jrkwon/mrider/docs/design/dbw.md

# MRider Drive-By-Wire (DBW) Design

This is the core drive-by-wire design document for MRider. It specifies how a stock kids' ride-on car (MITT) is converted into a computer-steerable, computer-throttled platform.

**Architecture note (2026-08-07).** This document formerly specified a Pixhawk 6C + PX4 + Arduino Nano topology inherited from `jrkwon/mrover`. That topology was superseded by **decision D3** in [adr-dbw-architecture-review.md §4.6](adr-dbw-architecture-review.md#46-decision-adopted-2026-08-07): a **single Teensy 4.1 running micro-ROS** replaces both the flight controller and the Nano. The reasoning, including what the Pixhawk path had going for it, is preserved in that review. What follows is the adopted specification.

MRider still reuses mrover at the layers where mrover is strong — the chassis conversion method, the connector-tap approach, the motor-driver power stage, and the entire autonomy stack above the vehicle interface. It departs at the controller.

Sibling documents: [architecture.md](architecture.md) (system block diagram, command/feedback flow), [vehicle.md](vehicle.md) (chassis selection), [safety.md](safety.md) (failsafe matrix, authority arbitration, FMEA), [sensors.md](sensors.md), [calibration.md](calibration.md) (zeroing, counts→degrees, ticks→distance), [software.md](software.md) (ROS 2 stack), [bom.md](bom.md).

Read for two audiences: exact numbers and file citations for researchers; short "why" explanations for students. Every design choice is recorded as an ADR with **Decision / Alternatives considered / Rationale / Consequences**.

---

## 1. Scope and reuse baseline

| Layer | mrover (baseline) | MRider | Status |
|---|---|---|---|
| Controller hardware | Pixhawk 6C (PX4) + Arduino Nano | **Teensy 4.1**, single MCU | **REPLACED** (D3) |
| Command transport | laptop → Micro-XRCE-DDS → PX4; MAVLink `MANUAL_CONTROL` emitted laptop-side (`mavlink_bridge.py:79-82`, `:105-126`) | laptop → **micro-ROS over USB serial** → Teensy | **REPLACED** (D3) |
| Steering channel | `MANUAL_CONTROL.roll` → PX4 servo out (`mavlink_bridge.py:123`) | `DbwCommand.steering_angle`, **radians**, read directly by the loop | **REPLACED** |
| Throttle channel | `MANUAL_CONTROL.throttle` (`mavlink_bridge.py:124`) | `DbwCommand.speed` | **REPLACED** |
| Motor driver | Sabertooth 2x32, S1←PX4 PWM pin2, S2←PX4 PWM pin7 (`vehicle_setup.md:54-55`) | **Cytron MDDS30**, **independent R/C**, both lines from the Teensy via the RC signal MUX on `RC1`/`RC2` | **ADAPTED** (§4, part changed in §4.1) |
| Steering angle sensing | incremental quadrature encoder (`code.ino:36-39`) + relative auto-ranging (`mavlink_bridge.py:243-252`) | **absolute sensor, load-side** + motor incremental encoder | **REPLACED** (ADR B) |
| Steering position loop | **none — open-loop effort, human closes the loop by eye** (verified: `joystick_control.py:70,75,100-109`; no PID in repo) | **Teensy-local closed loop ≥ 200 Hz** | **NEW** (ADR E) |
| Drive distance | encoder on drive shaft (`code.ino:27`), shaft-adapter method (`vehicle_setup.md:70-72`) | same method, wheel-diameter cal | **REUSED** (ADR C) |
| Feedback path | Nano → I²C `0x02` → PX4 module → `WHEEL_DISTANCE` → `Control.msg` | Teensy → **micro-ROS typed `DbwStatus`** | **REPLACED** |
| Chassis conversion, 3-tap harness | connector taps (`vehicle_setup.md:5-23`) | same | **REUSED** (§11) |
| Autonomy stack | `robot_localization`, slam_toolbox, Nav2, `data_collection`, `neural_net` | same | **REUSED** — sits above the vehicle interface, transport-agnostic |

The **NEW** row is the one genuinely new control problem. mrover has no steering position control of any kind; the human closes the loop by eye, which is adequate for teleoperation and inadequate for Nav2, which commands an *angle*.

---

## 2. Steering actuation design

### 2.1 Actuator

The stock steering column is mechanically linked to the front wheels but has **no servo** — it is turned by hand (or, on RC models, by a stock DC gearmotor driven by the parent remote). MRider drives the column with a **DC gearmotor**, coupled to the existing steering linkage, and driven by the **motor driver's channel 1 (M1 output)**.

> [!NOTE]
> **Resolved on the delivered vehicle, 2026-10-01: it is the second case — a stock gearmotor is fitted.**
>
> All three vehicles steer under the parent remote, so the column already carries a DC gearmotor
> driven by the factory ECU. [§11.5](#115-3-tap-connector-spec-minimally-invasive) adds a
> gearmotor only *"if the column had none"*, so the steering tap **reuses the stock motor**:
> NC → stock ECU, NO → driver M1. Nothing is added to the linkage, and no second actuator can
> fight the first.
>
> **The torque margin is already demonstrated and needs no measurement.** The vehicle is rated
> for a 25 kg occupant and steers with that load aboard; MRider adds ~6 kg, and adds it further
> forward only in part, so the demonstrated margin is several times the ≥ 2× gate. The
> [§2.2 procedure](#22-torque-measurement-procedure-before-sizing-the-gearmotor) is how you size
> a motor you are *buying*, and is retained for a chassis that arrives without one.
>
> **The residual risk is duty cycle, not torque.** A child steers in occasional slow sweeps; the
> position loop makes the small, continuous, high-frequency corrections
> [ADR B](#5-adr-b-steering-angle-encoding) describes, which the stock motor was never specified
> for. The failure mode is thermal and wear, so **the gate is a thermal test, and it cannot be run
> on a bench**: steering load here is mostly tyre scrub, which exists only with the wheels on the
> ground. **[Stage 5](safety.md#6-bring-up-protocol-staged-wheels-off-first) is the gate**, not
> Stage 1 — see [§2.2.1](#221-the-duty-cycle-test-this-is-what-actually-releases-bom-4) for the
> procedure and its pass criteria. BOM #4 stays funded until it passes.
>
> **A stock parent-remote gearmotor has no shaft encoder**, so reuse drops the incremental
> encoder [ADR B](#5-adr-b-steering-angle-encoding) specifies as auxiliary. That costs FMEA
> row 1's motor-encoder cross-check outright, and moves stall detection onto the absolute
> sensor — a trade [§2.4](#24-wiper-motor-fallback) already pre-registers for the wiper fallback.
> **ADR B and the FMEA are updated when V1 decides**, not now: buying #4 keeps them as written.

> [!NOTE]
> **M1/M2 assignment — intentional departure (resolves finding F6)**
>
> mrover assigns **M1 = throttle, M2 = steering** (`vehicle_setup.md:51-52`). MRider inverts this: **M1 = steering, M2 = throttle**, consistently across this document, [architecture.md](architecture.md), and §11.3. The swap is deliberate — steering is the channel with the tighter loop and it is kept on channel 1 throughout the documentation set for teachability — and it is recorded here so that anyone reusing an mrover harness or 3D-printed enclosure routing knows the wiring differs.

The gearmotor is sized from a measured column torque (§2.2) with a **≥2× margin**. If a suitable geared DC motor with the required torque and a shaft encoder cannot be sourced, the fallback is a **12 V automotive wiper motor** (high stall torque, built-in worm gearing that resists back-driving) with an external encoder or an absolute sensor on the column — see §2.4.

### 2.2 Torque-measurement procedure (before sizing the gearmotor)

Torque required to steer an unmodified column is unknown and vehicle-specific (tire scrub, caster, king-pin friction). Measure it, do not guess:

> [!NOTE]
> **Not required on the 2026 vehicle — it arrived with a stock steering gearmotor**
>
> This procedure sizes a gearmotor you are **buying**. The delivered chassis already steers under
> its parent remote at its rated 25 kg occupant load, against ~6 kg of added kit, so the ≥ 2×
> margin in step 5 is demonstrated rather than measured ([§2.1](#21-actuator), and the
> [Order Log](../order-log.md) V1 entry). The procedure stays here because the next cohort may
> receive a chassis with no steering motor at all.

1. Put the vehicle on the ground at full load (laptop + LiDAR + payload) so tire scrub torque is realistic. Repeat on the target operating surface (carpet/asphalt).
2. Attach a **spring scale** (fish/luggage scale, 0–20 kg) to the steering-wheel rim (or to the tie-rod arm if driving the linkage directly).
3. Pull tangentially and record the **peak force `F` (N)** needed to turn the wheels from center to full lock **while stationary** (worst case — moving eases it).
4. Compute stall torque at the column: `τ_column = F × r`, where `r` is the lever radius (wheel rim radius, or the effective linkage arm).
5. **Size the gearmotor for ≥ 2 × τ_column** at its rated (not stall) torque, referred through the chosen gear/coupling ratio. The 2× margin covers surface variation, aging friction, and dynamic loads.
6. Record `F`, `r`, `τ_column`, chosen motor, and gear ratio in [calibration.md](calibration.md) and the [bom.md](bom.md) line item.

#### 2.2.1 The duty-cycle test — this is what actually releases BOM #4

> [!IMPORTANT]
> **On the 2026 vehicle the torque question is closed and the duty question is not.** [#4](../order-log.md)
> stays funded against one risk only: the stock motor was specified for a child's occasional slow
> sweeps, not for the small, continuous, high-frequency corrections a position loop makes. **The
> failure mode is thermal and wear, so the test is a thermal one** — a spring scale cannot answer it.

**It cannot be run at bench Stage 1, and saying so is the point.** Steering torque on this class of
vehicle is dominated by **tyre scrub**, which exists only with the wheels loaded on the ground. A
motor spinning free on a bench, or a vehicle on stands, draws a fraction of the current and will
pass a thermal test it would fail in service. **The gate therefore sits at
[Stage 5](safety.md#6-bring-up-protocol-staged-wheels-off-first)**, on the ground, at full kit load,
on the target surface.

1. Vehicle **on the ground**, full load (laptop, LiDAR, mast, payload), on the surface it will be
   driven on. Note the **ambient temperature** — every limit below is a rise above it.
2. Tape a thermocouple to the motor can, or use an IR thermometer on the same marked spot each time.
   **The same spot**: a 10 mm move on a small motor is several degrees.
3. Run the **position loop**, not a step test. Command a realistic profile — slow sweeps with
   **±5–10° corrections at 1–2 Hz superimposed** — which is what a path follower actually emits. A
   step-and-hold understates the duty; continuous small reversals are the hot case.
4. Run **20 minutes continuous**, longer than any single lab exercise. Record case temperature and
   **M1 current** at `t = 0` and every 5 minutes.
5. **Pass criterion is equilibrium, not a number.** If the temperature **plateaus** — under about
   1 °C per 5 minutes by the end — the motor can run indefinitely at this duty. **If it is still
   climbing at 20 minutes it cannot**, however comfortable the absolute reading looks.
6. **Absolute ceiling: case ≤ 70 °C.** The limiting part is the **plastic gearbox, not the
   windings** — nylon and POM gears soften and wear long before magnet wire is in trouble, and this
   gearbox is the same family as the [drive gearbox](../order-log.md) the encoder clamps to.
7. **Then measure wear, which is the half everyone forgets.** Re-take lock-to-lock travel and the
   dead band immediately after the run and compare with the pre-run figures. **Growth in backlash is
   a fail even if the temperature was fine** — it is the same defect arriving slowly.
8. Record the steady-hold current against the driver's channel rating and against the
   [logic-rail brownout check](safety.md#5-power-rail-isolation-and-brownout-protection).

**Outcome.** Plateau below ceiling and no backlash growth → **nothing to do.** If it fails, work
**down** the ladder below, not out to a new motor.

#### 2.2.2 If the duty test fails — the ladder, cheapest first

> [!IMPORTANT]
> **Replacing the motor is the last rung, not the first — and on this chassis it is barely a rung
> at all.** The stock steering gearmotor drives a **sealed gearbox** of the same family the drive
> side refused an end-mounted magnet three times. Fitting a *different* motor means opening that
> gearbox and matching a pinion to a 2 mm shaft, which is not a sixteen-week-course operation. The
> [wiper fallback](#24-wiper-motor-fallback) avoids the gearbox but costs more than it buys — see
> its withdrawal note. **So the money was never buying a usable option. The mitigations that work
> are above it, and three of the four are free.**

| | Mitigation | Cost | Why it works |
|---|---|---|---|
| **R1** | **Reduce the duty, not the motor** — dead band, rate limit, hysteresis, lower gain | **₩0, firmware** | The heat comes from the command profile, and the profile is a **choice**. A ±0.5° dead band stops the loop chattering at the setpoint and still clears [ADR E](#3-adr-e-steering-control-loop-location-the-key-dbw-decision)'s ≤ 1° gate with room to spare |
| **R2** | **I²t limit in firmware** on M1 current, clamping command authority as the integral climbs | **₩0, firmware** | Makes the thermal limit explicit and observable instead of discovering it by smell. Also the honest way to publish a duty rating for the next cohort |
| **R3** | **A spare of the STOCK motor** | small | Drops in. No gearbox work, no linkage work, no loss of reversibility — the only replacement on this chassis that is actually a replacement |
| **R4** | A small fan on the motor can | trivial | Only if R1 and R2 land close to the ceiling rather than far from it |

**R1 and R2 are not consolation prizes.** Limiting actuator duty in software is what a production
drive-by-wire system does, and on a teaching vehicle it converts a hardware disappointment into the
control-design exercise the course wants anyway. **Measure the duty, then design to it.**

> Rule of thumb from the ride-on ecosystem: a two-seater on carpet typically needs on the order of a few N·m at the column; a wiper motor (often 10–30 N·m stall) is comfortably oversized, which is why it is the safe fallback.

### 2.3 Why the motor driver receives an effort command

The driver outputs a **bidirectional motor drive** (PWM-controlled H-bridge). The Teensy does not command "go to angle X" to it; it commands a **signed effort** that is the *output* of the Teensy's position loop. Angle regulation lives entirely in the Teensy (ADR E). This keeps the driver a dumb, fast power stage — exactly its role in mrover.

*This section is deliberately board-neutral: it was true of the Sabertooth 2x32 and is true of the Cytron MDDS30 that replaced it, because what it describes is the division of labour and not the part.*

### 2.4 Wiper-motor fallback

> [!CAUTION]
> **Withdrawn for the 2026 chassis — 2026-10-20. Retained only for a vehicle with no stock steering motor.**
>
> This fallback was written for a column that had to be motorised from scratch. The delivered
> vehicle already steers under its parent remote, and on *that* chassis the fallback costs more
> than it buys:
>
> - **It cannot go through the stock gearbox**, so it must drive the linkage — which means
>   **disconnecting the stock gearmotor first.** That breaks [§2.1](#21-actuator)'s rule that
>   *"nothing is added to the linkage and no second actuator can fight the first"*, and it breaks
>   [§2.8 reversibility](../build/02-mechanical.md#28-confirm-reversibility).
> - **The worm drive is non-back-drivable**, as consequence (a) below already says. On a vehicle
>   whose entire failsafe story is *"default = STOCK"*, an actuator that **locks the steering on
>   power loss** is not a fallback — it is a new failure mode. You could not even push the vehicle
>   off the road.
>
> **So it is not the answer to a failed duty test.** [§2.2.2](#222-if-the-duty-test-fails-the-ladder-cheapest-first)
> is. Leaving this section listed as a live option was the more dangerous state: a documented
> escape route that cannot be taken is worse than none, because it stops anyone looking for a real
> one.

If the encoder-gearmotor path is blocked at build time, substitute a wiper motor on driver M1. Consequences: (a) the wiper's internal worm gear is largely non-back-drivable, so on power loss the steering **holds** rather than freewheels — this changes the E-stop analysis and **must** be re-evaluated against [safety.md](safety.md); (b) wiper motors rarely have a usable shaft encoder, so the **absolute sensor becomes the sole angle source** and the motor-side incremental encoder (for stall/velocity) is lost — acceptable because ADR B already makes the absolute sensor authoritative.

---

## 3. ADR E — Steering control-loop location (the key DBW decision)

**Decision.** Close the steering **position loop on the Teensy 4.1**, locally, at **≥ 200 Hz**, against the absolute angle sensor. The setpoint arrives as a **typed ROS 2 message** (`DbwCommand.steering_angle`, radians) that the loop reads directly.

**Pinned datapath (exactly one, no alternates):**

```
laptop  /mitt/dbw/command  (DbwCommand, steering_angle in rad)
              │
              │  micro-ROS over USB serial  (micro_ros_agent on the laptop)
              ▼
      Teensy 4.1  ── reads setpoint from the subscription callback
              │  ── closes position loop ≥200 Hz vs. absolute angle sensor
              │  ── outputs signed effort
              ▼
      Motor driver     ── independent R/C (PWM) via the signal MUX, M1 → steering gearmotor
```

**What this deletes.** The previous design carried the setpoint through PX4 as a servo-PWM pulse that a second MCU had to capture and decode. That entire round trip — `roll` → servo PWM → PWM input capture → degrees — existed *only* because the setpoint had to cross from PX4 to another board. With one controller the setpoint is a message the loop reads. The PWM input-capture firmware block, the ASCII framing, and the I²C register map all disappear with it.

**Setpoint rate vs. loop rate.** Setpoint refresh (≥ 50 Hz from the laptop) and the control loop (≥ 200 Hz on the Teensy) are decoupled: each iteration uses the most recent setpoint and the current measured angle. A 600 MHz Cortex-M7 with an FPU makes the loop rate a non-constraint; 200 Hz is chosen for margin, not because it is hard.

**Alternatives considered.**

- **E2 — close the loop in the laptop `ros2_control` hardware interface.** The loop would cross USB each cycle, adding latency and jitter that scales with laptop load. Rejected. Note the reuse argument once made for E2 does not exist: mrover's `carlikebot_system.cpp` is the **unmodified upstream demo stub** — namespace `ros2_control_demo_example_11` (`:27`), `read()` echoes the command back as state (`:280`), `write()` only logs (`:304`), both bracketed by the upstream "do not copy to your production code" comment. There is no hardware I/O in it. **Fallback acceptance bound:** if E1 is ever abandoned at build time, E2 is acceptable **only if** measured setpoint→actuation latency is **≤ 30 ms at p95 over ≥ 60 s of logged operation**.
- **E3 — close the loop inside PX4** (custom PX4 module). Moot under D3; retained in the record as rejected — PX4 C++ module work, hardest to teach, couples the controller to PX4 release churn.
- **E4 — dedicated closed-loop motion-controller hardware** (Kangaroo x2 class). **Pre-registered fallback**, not primary: it adds a part and replaces the project's best teaching artifact with a self-tuning black box. See [adr §3.5](adr-dbw-architecture-review.md#35-new-option-e4-dedicated-closed-loop-motion-controller) for the full trade and the verification checklist.

> [!NOTE]
> **E4 trigger (pre-registered)**
>
> **If, at the end of [bring-up Stage 1](safety.md#6-bring-up-protocol-staged-wheels-off-first), the Teensy loop cannot hold ≤ 1° steady-state error with no sustained oscillation, adopt E4 rather than continuing to tune.** Firmware tuning is unbounded work; this bounds it.

**Rationale.** The one genuinely new control problem is placed in the layer that solves it best: a dedicated MCU with direct, deterministic access to the sensor and the motor driver. It also doubles as the honest core of the education tier ("here is a position controller you can read in 100 lines of C") — and since mrover has no position loop at all (finding F2), there is no prior implementation for students to read instead.

**Consequences.** All actuation and vehicle sensing now terminate on one MCU. That concentrates authority, which is the serious objection to D3 — answered in §11 by making the override a wiring property rather than firmware. Firmware scope is real (PID, limits, watchdog, RC decode, encoder read, micro-ROS) but smaller than it looks: the superseded design was already committed to most of it on a far less capable board.

---

## 4. ADR (motor-driver control mode) — independent R/C, Teensy as both masters

**Decision.** Configure the motor driver in **independent R/C mode**. The Teensy emits servo-style pulses on two lines; both pass through the [hardware RC signal MUX](#112-hardware-rc-signal-mux-the-d3-condition) before reaching the driver.

| Driver input | Normal source | Override source | Motor output | Function |
|---|---|---|---|---|
| `RC1` | Teensy servo pulse (via MUX) | RC receiver (via MUX) | Left | steering gearmotor |
| `RC2` | Teensy servo pulse (via MUX) | RC receiver (via MUX) | Right | drive motors (paralleled) |

*Terminal and output names are the **MDDS30's**. `S1`/`S2` and `M1`/`M2` are Sabertooth naming and the board fitted is not labelled that way — see [§4.1](#41-part-substitution-cytron-mdds30-replaces-the-sabertooth-2x32-2026-09-29). Which output is which matters: `SW3:SW4` can silently redefine both.*

> [!CAUTION]
> **This ADR was briefly decided the other way. The reversal is the instructive part.**
>
> D3 removes the two-master constraint that originally ruled out **packetized serial** (Nano owned steering, PX4 owned throttle, and two masters cannot share an addressed bus). With one controller that objection dissolves, so packetized serial was adopted — it gives exact, high-rate commands and closes the actuation-rate problem in §12.
>
> **It was reverted when the override hardware was specified.** Every available RC signal multiplexer — [Pololu 2806](https://www.pololu.com/product/2806), Acroname RxMux, ServoCity — multiplexes **servo pulses**. None can select between a *serial packet stream* and RC PWM, and the driver's input mode is fixed by DIP switches, so it is in one mode or the other.
>
> **Packetized serial and the hardware RC MUX are mutually exclusive.** The MUX is the condition on which D3 was adopted ([§11.2](#112-hardware-rc-signal-mux-the-d3-condition)); packetized serial is an optimisation. The safety layer wins.
>
> The general lesson: **a decision that is correct in isolation can be invalidated by a downstream part choice.** Specify the safety-critical hardware early enough that it can constrain the decisions above it.

**Alternatives considered.**

- **Packetized serial, single master.** Rejected — incompatible with the RC signal MUX, as above. Would be the right answer if override were achieved some other way.
- **Keep packetized serial, move override to the relay MUX** (a separate RC ESC path selected by the existing contactor). Rejected: adds a second power stage, and the override would then drive the motors through *different hardware* than normal operation — a larger behavioural difference than effort-vs-angle, and one that is harder to test.
- **Analog mode** (0–5 V). Rejected: coarser, noise-prone, no timeout behaviour.

**Consequences.**

- **The driver's R/C signal-loss timeout is available in this mode** — motors stop when pulses stop. This backs [failsafe matrix row 6](safety.md#2-failsafe-matrix) and is one of the layers independent of Teensy firmware. Under packetized serial it would have been a configured behaviour requiring verification. **In this mode it is a DIP switch, not a property of the mode**, and the caution that used to sit here — "some boards gate the stop behind a switch that can also disable it" — turned out to describe the board fitted: on the MDDS30 `SW6=0` stops the motor after **100 ms** of lost signal and **`SW6=1` disables the timeout entirely**, leaving the motor at its last commanded speed. Set it, confirm it board by board, and verify the behaviour at Stage 1. [§4.1](#41-part-substitution-cytron-mdds30-replaces-the-sabertooth-2x32-2026-09-29)
- Two Teensy PWM outputs are consumed instead of one serial port. The Teensy has 35 PWM-capable pins, so this is free.
- Signal grounds between Teensy, RC receiver, signal MUX, and the motor driver must be star-tied at the motor driver ([architecture.md](architecture.md) power tree).
- **The actuation frame-rate ceiling returns as an open question** — see §12 and the warning below. This is the real cost of the reversal, and it is *not* resolved by assertion.

> [!WARNING]
> **Open: pin the actuation frame rate at bring-up**
>
> A standard servo frame is ~20 ms (**~50 Hz**), and with the stock Arduino `Servo` library that is what the driver would receive — so *actuation bandwidth*, not loop rate, would set the closed-loop ceiling. **No maximum accepted R/C input rate is recorded for the MDDS30 in this repository**, and the manual read on 2026-11-05 ([order log #3](../order-log.md#L3)) did not come back with one. The question is unchanged by the part swap; only the datasheet to re-read is different.
>
> **Measure it at [Stage 1](safety.md#6-bring-up-protocol-staged-wheels-off-first)** and pin one of:
>
> 1. Emit pulses faster than 50 Hz and verify the driver tracks them — best outcome; record the highest rate that works.
> 2. Accept ~50 Hz actuation and **restate the ≥200 Hz figure in §12 as a sampling/estimation rate, not an actuation rate.** Honest, and probably adequate at ≤ walking speed against a ≤1° / 400 ms target.
>
> Do not leave it unstated — that omission is exactly what capped the superseded design's performance invisibly.

### 4.1 Part substitution — Cytron MDDS30 replaces the Sabertooth 2x32 (2026-09-29)

**Status:** Accepted. **The decision in §4 is unchanged** — independent R/C mode, Teensy as both masters, both lines through the signal MUX. Only the part changed. §4's reasoning is preserved intact because none of it turned on the brand.

**Context.** The Sabertooth 2x32 was specified from a listing, and the sourcing never closed: [`scripts/order_status.py`](https://github.com/jrkwon/mrider/blob/main/scripts/order_status.py) exists because that listing carried a **2x25 SKU on a 2x32 description**, so arrival could not be taken for acquisition. A **Cytron SmartDriveDuo-30 (MDDS30)** was ordered instead on **2026-09-29**, four units (three fitted, one spare), and confirmed genuine on receipt **2026-10-08** — [order log #3](../order-log.md#L3). Its manual (rev 1.11) was read in full on **2026-11-05**.

**What the swap is allowed to change, and what it is not.** The Sabertooth 2x32 was **never fitted to any vehicle**. So wherever a number in these documents came from its datasheet, it describes hardware that does not exist in this project, and the MDDS30's number replaces it rather than disagreeing with it.

| | Sabertooth 2x32 *(never fitted)* | **Cytron MDDS30** *(fitted)* |
|---|---|---|
| Per-channel rating | 32 A continuous | **30 A continuous, 80 A peak**, thermally derated: 80 A below 50 °C, 50 A to 70 °C, 40 A to 100 °C, **30 A above** |
| User-settable current limit | assumed, and the fuse table rested on it | **none.** The manual lists *"current limit protection"* as a feature **with no number** |
| R/C input terminals | `S1` / `S2` | **`RC1` / `RC2`** |
| Motor outputs | `M1` / `M2` | **Left / Right** — Left is the steering gearmotor, Right the traction pair |
| Signal-loss stop | believed inherent to R/C mode | **`SW6`**: `0` stops after 100 ms, `1` **disables it** |
| Max accepted R/C rate | not stated | not recorded here either — §4's open question stands |

**Consequences.**

| | Direction |
|---|---|
| **Every 32 A acceptance figure was for the wrong board, and permissive by 2 A.** The real continuous limit is lower. Gates and record sheets now read **30 A continuous / 80 A peak**. | ✗ a real tightening |
| **The no-fuse argument on the motor branches collapses.** [03-electrical §3.2](../build/03-electrical.md#32-per-rail-fuse-and-gauge-table) justified no fuse there on *"the driver's current limit, set to 20 A"* — a setting this board does not have, on branches that are AWG 14. **Open**, and tracked in that section. | ✗ unresolved safety item |
| **All-switches-off is not a safe default.** `SW3:SW4=00` is **MIXED**, which makes a throttle command drive the steering motor and a steering command drive the wheels. The boards ship with every switch off. | ✗ a new assembly hazard |
| **Power-on order now matters.** With `SW6=0` the centre point is calibrated at power-up and the manual requires the transmitter on first, so whatever pulse sits on `RC1`/`RC2` at power-up becomes "stop": receiver on, Teensy emitting 1.5 ms, MUX settled, **then** the driver. Power it first and neutral can come out as a creep. | ✗ a new procedure |
| The 100 ms timeout is now a **known number** backing failsafe row 6, instead of an inherited belief. | ✓ |
| `SW3:SW4=11` independent is the manual's own recommendation *"if controlled using Microcontroller"*, so the §4 decision is confirmed by the new part rather than merely compatible with it. | ✓ |
| The board is **cheaper and locally stocked** (₩143,440 incl. VAT, 디바이스마트), which is what let four be bought — three fitted, one spare, for thirteen students. | ✓ |

**Closed on 2026-11-09.** `SW7:SW8` is the battery monitor and `00` is LiPo, which nothing on this vehicle is. The traction pack is an **`Aroma 6-FM-4.5`, 12 V 4.5 Ah valve-regulated sealed lead-acid**, so **`10`** — full plate at [vehicle.md §3.1.1](vehicle.md#311-the-traction-pack-from-its-own-label).

*This section said the chemistry was recorded nowhere. It was wrong when written: [03-electrical §3.5](../build/03-electrical.md#35-signal-wiring)'s switch table had carried the label since 2026-11-05, and the sentence was copied out of a stale paragraph four rows below that table. A claim that something is unrecorded is still a claim, and this one was not checked against the thing it was about.*

**And setting it is not a protection.** The manual is explicit that on under-voltage the error LED blinks and *"the power to the motor will be maintained and will not be cut out."* The monitor **warns; it does not cut.** Nothing in the failsafe matrix may rest on it.

---

## 5. ADR B — Steering angle encoding

**Decision.** **Absolute angle sensor on the steering axis**, read by the Teensy, **plus** the steering motor's incremental encoder for velocity and stall detection. The absolute sensor is authoritative for angle; the incremental encoder is auxiliary.

**Mount it load-side.** Where the sensor mounts matters as much as which sensor it is. Mount it **downstream of the steering gearbox** — on the kingpin/road-wheel axis, or on the linkage — not on the motor shaft. Load-side mounting measures what the road wheels actually do, so **gearbox backlash and coupling slip appear as measured error rather than as invisible bias**. Motor-side mounting hides exactly the errors the sensor exists to catch.

Steering angle sensing: an AS5600 absolute magnetic encoder on the kingpin axis, reading a diametrically-magnetised magnet across a controlled air gap, with the motor-side incremental encoder demoted to velocity and stall duty

Panel 2 is the part that is easy to get wrong in the shop. The magnet is **bonded to the rotating kingpin**; the sensor IC is on a small PCB held by a bracket **fixed to the chassis**, facing the magnet across an air gap the datasheet constrains. Nothing touches — this is why there is no wiper to wear at the small, high-duty-cycle oscillations a steering loop makes. The mechanical precision that mounting demands is the *only* reason the potentiometer fallback is retained rather than deleted.

**Alternatives considered.**

- **B2 — incremental encoder on the steering motor only** (the mrover recipe). Rejected. It **requires homing on every boot** and loses its absolute reference on any linkage slip or power glitch. mrover's own implementation shows the failure mode concretely: `mavlink_bridge.py:47-50` initializes asymmetric defaults (`min_value=-600`, `max_value=180`), and `:243-250` **expands those bounds at runtime and rescales all past values** — so the reported "center" depends on the range observed so far, and boot centre is arbitrary. This is worse than drift: the mapping changes retroactively.

**Rationale.** Mapping and Nav2 need a repeatable, boot-stable angle. An absolute sensor gives angle-at-power-on with no homing dance and survives linkage slip. Keeping the motor incremental encoder as well costs nothing (the Teensy has four hardware quadrature decoders) and gives free stall/velocity signals.

**Consequences.** Two angle sensors on one axis; fusion is trivial (absolute = truth, incremental = rate). The absolute sensor's mounting and range must match the mechanical travel of the shaft it is on — its own ADR (§6). Calibration gains a "counts→degrees" step ([calibration.md](calibration.md)).

---

## 6. ADR (angle-sensor technology) — magnetic encoder vs. potentiometer

**Decision.** Use an **AS5600-class absolute magnetic rotary encoder** (I²C, 12-bit, contactless), mounted on a shaft whose **total travel stays within one turn** — which, given the load-side mounting of ADR B, is the road-wheel/kingpin axis at **±22.5°**. **Fall back to a single-turn conductive-plastic potentiometer** if no shaft with ≤ 340° of travel is mechanically accessible for a magnet mount.

> [!CAUTION]
> **Bench gate — measure before ordering**
>
> **Measure the actual lock-to-lock travel of every candidate mounting shaft on the delivered vehicle before committing.** The magnetic encoder is single-turn (0–360° absolute): if the shaft it is on rotates past one turn, it wraps and silently loses absolute meaning — the exact failure class ADR B exists to eliminate. Record the measured travel in [calibration.md](calibration.md). Budget for either part; they are within a few dollars of each other.

**Alternatives considered.**

- **Single-turn potentiometer coupled to the steering column.** This was the previous decision, and it remains the fallback. Its virtue is that it maps monotonically across whatever travel its shaft sees, within one mechanical turn, and it is trivially teachable (voltage ∝ angle). Its drawbacks are wiper wear, analog noise requiring median + low-pass filtering, and a ratiometric-reference dependency so supply drift cancels.
- **Multi-turn magnetic / hall-array absolute encoder.** Solves wrap outright but is markedly more expensive and less student-friendly. Reserved for a future chassis that gears the column past one turn.

**Rationale for flipping the default.** The previous ADR pinned the pot because it feared column wrap — a real hazard when the sensor sits on a geared-down *column*. ADR B moves the sensor **load-side**, where travel is ±22.5° and wrap cannot occur. Once the mounting point is settled, the wrap objection no longer applies and the magnetic encoder's advantages are uncontested: contactless (no wiper to wear at the small, high-duty-cycle oscillations a steering servo makes), digital (no ADC noise, no ratiometric reference, no analog filtering), and 12-bit — roughly 0.09° resolution over a full turn.

**Consequences.** One Teensy I²C bus is consumed. A diametrically-magnetized magnet must be mounted concentric to the sensed shaft, with the air gap held within the sensor's specified range — a mechanical precision requirement the pot does not impose, and the main reason the pot fallback is retained rather than deleted. Check for magnetic interference from the nearby steering motor during bench validation.

---

## 7. Throttle path

The stock vehicle has **two rear drive motors**, electrically **paralleled onto the motor driver's channel 2 (M2 output)**. Throttle command originates as `DbwCommand.speed` and is emitted by the Teensy as a servo pulse on `RC2`, through the same signal MUX as steering.

The Teensy applies **ramp limiting, a speed cap, and a direction interlock** (no reversal above a threshold speed) before commanding the driver. These were previously PX4's responsibility and are now explicit project firmware — see [safety.md](safety.md).

Paralleling is acceptable because the two motors are mechanically coupled through the ground and share a load; the consequence for **odometry** (only one shaft is instrumented) is handled in ADR C. Verify the **paralleled stall current against the driver's 30 A continuous rating** in [vehicle.md](vehicle.md). If the pair can exceed it stalled, the remedy is **not** a driver setting — the MDDS30 has no user-settable current limit ([§4.1](#41-part-substitution-cytron-mdds30-replaces-the-sabertooth-2x32-2026-09-29)) — so it is lower-draw motors, a fuse on the branch, or a firmware duty ceiling that the stock remote does not share.

---

## 8. ADR C — Drive distance encoding

**Decision.** A **quadrature/Hall incremental encoder on the drive-motor shaft** (the mrover **3.15 mm → 5 mm shaft-adapter** method, `vehicle_setup.md:70-72`), read by a Teensy **hardware quadrature decoder**, converted to distance with a wheel-diameter calibration ([calibration.md](calibration.md)). Odometry is **fused with the IMU in the EKF** to bound error.

Rear drive sensing: both rear motors paralleled onto one motor-driver channel with a single quadrature encoder on one motor shaft, and the chain of mechanical error sources that sit between that measurement and actual ground distance

Panel 1 is the asymmetry worth staring at: **one motor is instrumented and the other is not**, and because both are paralleled onto a single channel there is no differential and no independent control. Panel 3 is the honest consequence — the measurement is taken *upstream* of backlash, slip and the speed difference between inner and outer wheels in a turn. Each of those biases raw odometry, which is precisely why it is fused rather than trusted.

> [!NOTE]
> **PPR is unverified — resolves finding F7**
>
> mrover's firmware pins **52 PPR** (`code.ino:27`) while its own BOM lists a **16 PPR** encoder motor (`Note/overview.md` BOM row 2). The conflict is inside the source project, so the number cannot be inherited safely. **Verify PPR on the encoder actually fitted** and record it in [calibration.md](calibration.md). The [roll-out calibration](calibration.md#2-drive-distance-encoder-ticksmeters) is authoritative and bypasses PPR entirely, so the *result* is safe either way — but do not treat 52 as a fact.

**Alternatives considered.**

- **C2 — magnetic ring / hall array on the wheel hub** (true wheel odometry, immune to gearbox backlash and drivetrain slip). Rejected as the default: a **more invasive, per-vehicle mechanical mount** on the hub, against the "minimally invasive" principle. Kept as the upgrade path if odometry proves inadequate against the §12 acceptance bound.

**Rationale.** Instrumenting the motor shaft reuses mrover's proven encoder + adapter method and mounts inside the drivetrain rather than on the wheel. Minimally invasive and cheap.

> [!IMPORTANT]
> **Outcome, 2026-09-30 — C1 is infeasible on the delivered vehicle. C2 is adopted.**
>
> Teardown found a **`DING LI RS 390-12V RPM 18000`** driving a sealed gearbox. The RS-390 carries a
> ~2 mm shaft with a 12-tooth pinion pressed onto it, meshing straight into the gearbox: **no rear
> stub, and no bare output shaft.** That is the family's construction, not this vehicle's packaging
> — opening the gearbox would not produce one.
>
> So **the decision above cannot be executed.** The mrover shaft-adapter method it reuses has no
> shaft to adapt.
>
> **C2's rejection does not survive the loss of C1.** It was rejected for being *"a more invasive,
> per-vehicle mechanical mount"* — a comparison against clamping onto an exposed motor shaft. With
> that shaft gone, the real comparison is C2 against **splitting a gearbox on three vehicles that
> students will maintain for a semester**. C2 is plainly the less invasive of the two. The premise
> failed, not the reasoning.
>
> **And C2 was always the better measurement.** This ADR says so itself — *"true wheel odometry,
> immune to gearbox backlash and drivetrain slip."* C1 was preferred for convenience, never
> accuracy, and the convenience is what disappeared.
>
> **Mount: the gearbox output hub**, not the wheel rim. The gearbox drives a splined plastic hub
> that the wheel slides onto, with the rear axle passing through its bore, and there is clearance at
> the hub with the wheel fitted. That gives a target turning **1:1 with the wheel**, in plastic that
> accepts magnets, beside a fixed housing with screw bosses for the sensor bracket — and pulling a
> wheel does not disturb the sensor.
>
> The consequences below change accordingly: **(a) gearbox backlash no longer applies**, because the
> measurement is taken downstream of the gearbox. (b) wheel slip and (c) differential wheel speed in
> turns still do, because one wheel is still the only one observed. Odometry is still fused rather
> than trusted.
>
> Full purchasing specification and the decision tree this outcome came from:
> [§1.2.3](../build/01-bom-sourcing.md#6-drive-encoder-what-to-actually-buy).

**Consequences (stated explicitly).** The two rear motors are paralleled on one channel and **only one motor shaft is observed**. Motor-side measurement therefore inherits (a) **gearbox backlash** between encoder and wheel, (b) **wheel slip** and tire deformation, and (c) **differential wheel speed** in turns (only one side measured). These bias raw odometry; `robot_localization` fuses the encoder with the IMU (and GNSS when present) to bound drift. Documented so students understand *why* the odometry is fused rather than trusted raw.

---

## 9. Teensy 4.1 firmware platform and version pinning

- **Controller:** Teensy 4.1 (600 MHz Cortex-M7, FPU, 1024 K RAM). Peripheral budget against MRider's needs: **4 hardware quadrature decoders** (2 used: steering motor, drive shaft), **8 hardware serial ports** (used: RC serial in, debug), **35 PWM-capable pins** (2 used for the motor driver), **18 analog inputs** (pot fallback), I²C for the AS5600. Everything fits with spare capacity.
- **Toolchain:** PlatformIO with the Teensy platform. Firmware lives in `firmware/mitt_dbw/`.
- **ROS 2 transport:** `micro_ros_arduino`, USB serial, with `micro_ros_agent` on the laptop.

> [!WARNING]
> **Verify before firmware work**
>
> - [x] **Verified 2026-08-08.** `micro_ros_arduino` **v2.0.8-humble** (published 2025-09-30) is the current Humble release, and **Teensy 4.1 is listed as Supported** (min version v1.8.5) in the upstream support table. Pin this tag.
> - [x] **Verified 2026-08-08.** The upstream README states *"Only USB serial transports are provided"*, and Known Issues notes transports still need refactoring for pluggability. An Ethernet *example* sketch exists but is not an official transport. **USB serial is accepted.**
> - [ ] **This link now carries the steering setpoint**, which the superseded design's USB link did not. Re-analyse it against [failsafe matrix row 2](safety.md#2-failsafe-matrix), and measure session stability at Stage 0.
>
> **If no Humble release exists**, the fallback is a framed **binary** protocol with CRC and sequence numbers over the same USB serial link — never unframed ASCII. This keeps every architectural gain of D3 except typed-message convenience.

- **Version pinning:** pin the exact `micro_ros_arduino` release, PlatformIO platform version, and Teensyduino version in [software.md](software.md) so results reproduce. Do not float on `main`. This obligation is heavier than it was under PX4 — see the consequence recorded in [adr §4.6](adr-dbw-architecture-review.md#46-decision-adopted-2026-08-07): the platform's replication claim now rests on MRider's own measured bring-up numbers rather than on an upstream autopilot's provenance.

---

## 10. Teensy firmware interface

### 10.1 Primary transport — micro-ROS typed messages

Two topics form the entire vehicle interface. There is no ASCII protocol to parse and no I²C register map to decode; both existed in the superseded design only to move data into ROS 2 by hand.

**`/mitt/dbw/command` — `mitt_msgs/DbwCommand` (laptop → Teensy, ≥ 50 Hz):**

| Field | Type | Notes |
|---|---|---|
| `stamp` | `builtin_interfaces/Time` | command origin time |
| `steering_angle` | `float32` | **radians**, road-wheel angle, clamped to ±22.5° (±0.3927 rad) |
| `speed` | `float32` | m/s, signed |

**`/mitt/dbw/status` — `mitt_msgs/DbwStatus` (Teensy → laptop, ≥ 50 Hz):**

| Field | Type | Notes |
|---|---|---|
| `stamp` | `builtin_interfaces/Time` | measurement time |
| `steering_angle` | `float32` | radians, measured absolute, load-side |
| `steering_setpoint` | `float32` | radians, what the loop is currently tracking |
| `wheel_speed` | `float32` | m/s from the drive encoder |
| `drive_ticks` | `int32` | cumulative, for odometry |
| `mode` | `uint8` | `ESTOP` / `MANUAL_RC` / `AUTONOMOUS` |
| `faults` | `uint16` | bitfield: encoder fault, setpoint-stale, at-limit, stall, RC-loss, over-current |

Diagnostic/config traffic (PID gains, zeroing) uses ROS 2 **parameters and services**, not a side-channel.

### 10.2 Firmware blocks

1. **micro-ROS node**: publisher, subscriber, session time synchronisation. Session sync replaces the MAVLink `TIMESYNC` offset estimation the superseded design needed — see [calibration.md](calibration.md) §6.
2. **Absolute-sensor read**: AS5600 over I²C (or ADC + median/low-pass for the pot fallback), counts→radians per [calibration.md](calibration.md).
3. **Position PID** at ≥ 200 Hz: error = setpoint − measured, output = signed effort.
4. **Motor output**: servo-style PWM on two lines into the RC signal MUX, then to the driver RC1/RC2 inputs, at the §12 frame rate.
5. **Throttle shaping**: ramp limit, speed cap, direction interlock.
6. **RC decode**: i-BUS on a hardware serial port — mode switch and closed-loop manual override.
7. **Safety supervisor**: setpoint-staleness watchdog, mechanical-limit clamp (effort toward center only), stall detection, hardware watchdog timer resetting outputs to neutral.

### 10.3 Safety state machine

```
        ┌──────────┐  E-stop released + RC arm
        │  ESTOP   │◄──────────────────────────┐
        └────┬─────┘                           │
             │                          E-stop / RC kill /
             ▼                          setpoint stale / watchdog
        ┌──────────┐  RC mode switch          │
        │MANUAL_RC │◄────────────┐            │
        └────┬─────┘             │            │
             │ RC mode switch    │            │
             ▼                   │            │
        ┌──────────┐─────────────┘            │
        │AUTONOMOUS│───────────────────────────┘
        └──────────┘
```

Invariants:

- Any transition into `ESTOP` zeroes throttle and centers steering immediately.
- `AUTONOMOUS` requires a live `DbwCommand` stream; staleness > 500 ms drops to `ESTOP`.
- RC override is honored from any state within 200 ms.
- **These invariants are firmware, and firmware can hang.** They are the *inner* layer only; §11 provides the independent outer layers.

> [!IMPORTANT]
> **This state machine has always needed an E-stop input, and no wire was ever specified for it**
>
> Look at the arcs: **`E-stop` is a transition trigger into `ESTOP`**, and **`E-stop released + RC
> arm` is the only way out.** Both require the firmware to *know*. Nothing in the wiring ever told
> it — found 2026-10-27, while drawing the harness.
>
> **Without it, two arcs of a published state machine are unimplementable**, and the practical
> consequence is concrete rather than theoretical: the contactor coil and the relay MUX coils are
> both fed through the button's NC contacts, so **turning the button to reset re-energises both
> immediately.** The Teensy never noticed anything — it has been running its loop against a sensor
> that was not moving, **winding up its integrator** — so the vehicle **resumes under whatever
> command was last in flight.** `E-stop released + RC arm` exists precisely to stop that, and it
> cannot run.
>
> **The division of labour is the point. Hardware owns stopping; firmware owns not restarting by
> accident.** The sense input does not make the stop safer — the coils drop whatever the firmware
> thinks. It makes the **resume deliberate**.
>
> **How it is sensed — tap the coil supply, not the button.** A divider on the node the NC contacts
> feed, read as a plain digital input:
>
> | | sense reads |
> |---|---|
> | button released, coils live | **high** — authority chain energised |
> | button pressed | low |
> | **broken wire, pulled connector, blown coil fuse, dead logic pack** | **low** |
>
> **Every failure reads as "stopped", which is the conservative direction** — and it senses what
> actually matters, *whether the authority chain is energised*, rather than only whether a finger is
> on the button. A spare `NO` contact would have been simpler and is **worse**: an open circuit
> would read *"not pressed"*, so a broken sense wire would silently restore the instant-resume
> behaviour this input exists to prevent.
>
> **It still must never be a safety function.** The safety is the NC contacts and the coils, which
> work with the Teensy dead. *A sensed input that gets relied on is how a hardware interlock quietly
> becomes a software one.*

---

## 11. Authority arbitration — relay MUX and hardware RC signal MUX

### 11.1 Purpose

Two independent mechanisms, neither of which depends on Teensy firmware being alive.

The stock parent-remote receiver and the motor driver **cannot both drive the motors at once**. A **DPDT relay/contactor MUX** selects STOCK vs. DBW mode per motor circuit. **Default (de-energized) = STOCK**, so any power or logic failure reverts to the safe, factory-controlled vehicle.

### 11.2 Hardware RC signal MUX — the D3 condition

> [!CAUTION]
> **Not optional**
>
> D3's adoption is **conditional** on this. Under a single controller, one MCU otherwise holds the steering loop, the throttle output, RC override, and arming — a firmware hang loses all four at once. The layered override is what makes that objection answerable, and it must be built.

**Layer 1 (normal): RC serial into the Teensy.** RC override in `MANUAL_RC` mode commands an *angle*, with the position loop still closed behind it. This is the everyday manual mode and it is better than raw effort.

**Layer 2 (independent): a hardware RC signal MUX.** A dedicated RC channel drives a **signal multiplexer** that selects either Teensy PWM *or* direct RC PWM into the motor driver. This makes override a **wiring property, not a firmware property** — a stronger guarantee than the software override the superseded PX4 design relied on.

**Pinned part: [Pololu 4-Channel RC Servo Multiplexer #2806](https://www.pololu.com/product/2806)** (~$18). Selected 2026-08-08.

| Property | Value | Why it matters here |
|---|---|---|
| Channels | 4 (2 used: steering, throttle) | Spare capacity |
| Select | Measures pulse width on a `SEL` channel against a configurable threshold | A spare RC channel on the existing transmitter drives it — no extra link |
| Logic supply | 2.5–16 V from the master device | Sits on the isolated logic rail ([safety.md §5](safety.md#5-power-rail-isolation-and-brownout-protection)) |
| Signal type | **RC servo pulses only** | This is what forced §4 back to R/C PWM mode |
| `FAILMODE` jumper | Disconnected → master stays in control on `SEL` loss. Connected → outputs go low and stay low | Directly implements "choose the failsafe direction deliberately" |

> [!CAUTION]
> **FAILMODE — decide this deliberately, and record it**
>
> **Recommended: jumper disconnected (master retains control).** Rationale: losing the `SEL`
> signal means the RC link is gone, and the Teensy already has its own RC-loss failsafe —
> [row 3](safety.md#2-failsafe-matrix) drops it to `ESTOP`. Leaving the Teensy in control lets
> that defined behaviour run.
>
> The alternative (outputs low) also stops the vehicle, via the driver's signal-loss
> timeout, but it does so by removing *all* control rather than by executing a designed
> response — and it makes an RC dropout indistinguishable from a controller failure.
>
> **Verify both behaviours at Stage 2** before choosing, and write the chosen jumper state
> into the as-built record. A jumper is a one-bit safety decision that is invisible six months
> later.

**The trade, stated plainly.** Through Layer 2 the override commands raw **effort**, open-loop — not an angle. That is a behavioral change from Layer 1 and from the superseded design, and it must be re-analysed rather than assumed. It is nonetheless exactly what mrover does in normal operation (finding F2), and it is acceptable for an emergency mode.

### 11.3 Authority layers

| Layer | Authority | Independent of Teensy firmware? |
|---|---|---|
| Hardware E-stop → contactor | 1 (highest) | **Yes** — hardwired, cuts traction power |
| Relay MUX → STOCK | 2 | **Yes** — de-energize-to-safe |
| **Hardware RC signal MUX** | 3 | **Yes** — signal-path selection, no firmware |
| RC serial override into the Teensy | 4 | No — closed-loop, normal manual mode |
| Driver R/C signal-loss timeout | — | **Yes** — motors stop when the Teensy stops emitting pulses (§4, verify at bring-up) |
| Teensy hardware watchdog | — | **No** — a hardware timer, but firmware arms it. It is what converts a *hang* into a reset; without it the row above never fires on a hang ([safety.md §2](safety.md#2-failsafe-matrix), corrected 2026-11-10) |

A total Teensy failure still leaves: authority revertible (relay MUX), traction cuttable (E-stop), and steering under human control (RC MUX). **Motors stopped** belongs on that list only once pulses have actually stopped — after a reset or a power loss, not during a hang, when the pulse timer goes on emitting the last width.

### 11.4 MUX diagram

```mermaid
flowchart LR
    subgraph STOCK["STOCK path (default, relay de-energized)"]
      PR[Parent-remote receiver / stock ECU]
    end
    subgraph DBW["DBW path (relay energized)"]
      SB[Motor driver M1/M2]
    end
    TEENSY[Teensy 4.1] -->|servo PWM x2 - master| SMUX{{Hardware RC signal MUX}}
    RC[RC receiver] -->|RC serial - Layer A| TEENSY
    RC -->|servo PWM x2 - slave| SMUX
    RC -->|SEL channel| SMUX
    SMUX -->|selected pair| SB
    PR -->|NC contacts| RLY{{DPDT relay MUX}}
    SB -->|NO contacts| RLY
    EN[Mode-enable coil<br/>energize = DBW] -.drives.-> RLY
    RLY --> MOT[Drive + steering motors]
    ESTOP[E-stop / brownout / logic loss] -.de-energizes.-> EN
```

- **NC contacts** route the **stock** controller to the motors when the coil is de-energized.
- **NO contacts** route the **motor driver** to the motors when the coil is energized (DBW mode).
- Any event that drops the coil (E-stop, logic-rail brownout, deliberate mode switch) reverts to STOCK.

### 11.5 3-tap connector spec (minimally invasive)

Following mrover's connector-tap approach (`vehicle_setup.md:5-23`), three inline connectors let MRider intercept the stock harness reversibly:

| Tap | Intercepts | MUX side | Notes |
|---|---|---|---|
| **Throttle tap** | stock throttle motor leads | NC→stock ECU, NO→driver M2 | paralleled rear motors (§7) |
| **Steering tap** | stock steering motor leads | NC→stock ECU, NO→driver M1 | MRider adds the gearmotor if the column had none. **Note the M1/M2 inversion vs. mrover — §2.1.** |
| **Power tap** | main battery pack | feeds driver B+ and the isolated logic rail | fused; brownout isolation per [safety.md](safety.md) |

All three are keyed inline connectors so the stock wiring is restorable without cutting. Unplug the three taps and the vehicle is factory-stock.

---

## 12. Numeric interface contract

The pinned, testable contract for the DBW interface.

| Parameter | Value | Source / rationale |
|---|---|---|
| Steering angle range (road wheels) | **±22.5°** (±0.3927 rad) | inherited working range; verify against measured mechanical lock-to-lock |
| Steering command | `DbwCommand.steering_angle`, **radians**, clamped to range | §10.1 |
| Throttle command | `DbwCommand.speed`, **m/s**, signed | §10.1 |
| Steering position loop rate | **≥ 200 Hz** on the Teensy | ADR E |
| **Actuation frame rate (Teensy→driver)** | **measure at Stage 1**, then pin — see the §4 warning | The datasheet states no maximum R/C input rate. Unpinning this is what silently capped the superseded design |
| Command stream rate (laptop→Teensy) | **≥ 50 Hz** | §10.1 |
| Command-staleness failsafe | **> 500 ms** → `ESTOP`, throttle zeroed, steering centered | §10.3 |
| Feedback rate (Teensy→laptop) | **≥ 50 Hz** | odometry/telemetry needs |
| RC override response | **≤ 200 ms** from any state | §11 |
| E-stop traction cut | **≤ 200 ms**, works with laptop powered off | [safety.md](safety.md) |
| Absolute sensor resolution | **12-bit** over one turn (AS5600 class) | §6 |
| Drive encoder resolution | **verify on the encoder fitted** — do not inherit 52 | §8, finding F7 |
| Motor driver mode | **independent R/C (PWM)**; both lines Teensy → signal MUX → RC1/RC2 | §4 |
| Steering steady-state accuracy | **≤ 1.0°** error, RMS **≤ 1.5°** over ±20° sweep | acceptance gate; E4 trigger if unmet |
| Steering step response | 10° step to 90% in **≤ 400 ms**, overshoot **≤ 15%** | acceptance gate |
| Odometry drift | **≤ 2%** of distance over 20 m straight | acceptance gate |

---

## 13. Cross-checks and open follow-ups

- **Bench gate:** measured lock-to-lock travel of each candidate sensor shaft → confirms magnetic vs. pot (§6). **Before ordering.**
- Torque measurement on the actual chassis → gearmotor spec and wiper-motor fallback decision (§2.2).
- Paralleled drive-motor stall current vs. the driver's **30 A continuous** → [vehicle.md](vehicle.md), and the no-fuse argument that rests on a limit this board does not have ([§4.1](#41-part-substitution-cytron-mdds30-replaces-the-sabertooth-2x32-2026-09-29)).
- **Actuation frame rate** measured and pinned at Stage 1 → the §4 warning. The driver's R/C signal-loss timeout is inherent in this mode, but confirm it stops the motors ([failsafe row 6](safety.md#2-failsafe-matrix)).
- **FAILMODE jumper direction** on the RC signal MUX decided and recorded → §11.2.
- ~~`micro_ros_arduino` Humble availability and USB-serial transport acceptance~~ → **closed 2026-08-08**, see §9.
- ~~Hardware RC signal MUX part selection~~ → **closed 2026-08-08**: Pololu 4-Channel RC Servo Multiplexer #2806 ([bom.md](bom.md)). Wiring and FAILMODE jumper direction still to be set → §11.2.
- Drive encoder PPR on the part actually fitted → §8 (finding F7).
- Steering-motor power-rail assignment (freewheel vs. hold on E-stop) → [safety.md](safety.md).

**Citation verification.** Every mrover claim cited in this document was verified against the local checkout at `/mnt/data/projects/mrover` during the [architecture review](adr-dbw-architecture-review.md), which re-read the source directly rather than arguing from the design side. Two findings from that review corrected earlier drafts of this document: `carlikebot_system.cpp` is an unmodified demo stub (F3), and mrover has no steering position control at all (F2).
