jrkwon/mrider/docs/design/vehicle.md

# Vehicle (Chassis) Selection

> Part of the MRider design set. Siblings: [architecture.md](architecture.md) ·
> [dbw.md](dbw.md) · [safety.md](safety.md) · [sensors.md](sensors.md) ·
> [software.md](software.md) · [calibration.md](calibration.md) · [bom.md](bom.md) ·
> [overview.md](overview.md)
>
> Prices are **estimates as of July 2026** and vary by retailer, coupon, and stock.

This document selects the base ride-on vehicle ("MITT") that MRider converts to
drive-by-wire. It states the **selection criteria first**, then evaluates real,
currently-purchasable candidate models against them, lists the physical
verification that must be done on the unit actually purchased, and records the
chassis decision as [ADR D](#adr-d-24-v-two-seater-vs-12-v-single-seater).

The choice is driven by the project's decision drivers: payload
for an onboard laptop plus sensors, an accessible steering column for the
[DBW](dbw.md) angle actuator and absolute sensor, electrical headroom for the motor
driver, and reuse of the [mrover](https://github.com/jrkwon/mrover) chassis-conversion
recipe. **[ADR D-R](#adr-d-r-reversal-to-the-12-v-single-seater-2026-08-08) traded the
voltage headroom away** for cost and storage footprint.

---

## 1. Selection Criteria

These are ordered by how hard they are to fix after purchase. A vehicle that
fails a "must" criterion is rejected regardless of price.

| # | Criterion | Target | Why (which subsystem needs it) |
|---|---|---|---|
| C1 | **Payload margin** | ≥ ~6 kg usable deck load (laptop ~2 kg + LiDAR/camera/mast + Teensy/motor driver/relay MUX/RC signal MUX/logic battery + wiring ~3–4 kg), on top of the rated child weight the vehicle already carries | Onboard compute ([sensors.md](sensors.md)) and the DBW control box ride on the deck. A two-seater rated for ~60 kg of kids trivially carries the ~6 kg kit. |
| C2 | **Pack voltage** | ~~24 V battery pack~~ → **12 V**, dual drive motors | Originally 24 V, for voltage headroom on the motor driver's throttle channel, to match the mrover recipe, and for torque margin on grass/ramps. **[ADR D-R](#adr-d-r-reversal-to-the-12-v-single-seater-2026-08-08) reversed this on 2026-08-08**: the adopted chassis is 12 V, and the torque margin was knowingly given up. |
| C3 | **Dual rear drive motors** | 2 rear motors (4WD acceptable) | The two rear motors parallel onto one motor-driver channel ([ADR C](dbw.md), throttle path). Confirms a real H-bridge-drivable DC traction path, not a sealed ESC. |
| C4 | **Accessible steering column** | Exposed vertical steering shaft between wheel and linkage, with ~30–50 mm of clear shaft | The [steering angle gearmotor](dbw.md) couples to the column, and the **absolute angle sensor** ([ADR B, sensor-tech ADR](dbw.md)) mounts on the shaft. A sealed/rack-hidden column blocks both. |
| C5 | **Deck / cargo space** | Flat area ≥ ~30 × 30 cm, or a rear bed (UTV/truck style) | Mounting the control enclosure, mast base ([sensors.md](sensors.md)), and E-stop. UTV beds are ideal. |
| C6 | **Metal gearbox (preferred)** | Steel/metal reduction gears on drive motors | Plastic gearboxes strip under the extra mass + autonomous duty cycle. Not a hard reject, but a strong preference and a stated risk if unmet. |
| C7 | **Parent 2.4 GHz remote (present)** | OEM parent remote included | Confirms the OEM already has a remote-drive electrical path we can tap; its receiver becomes the de-energized STOCK side of the [relay MUX](safety.md). Note: the OEM remote is **not** the live DBW override — that is the [layered RC serial + hardware RC signal MUX](safety.md#12-live-override-inside-dbw-mode-two-layers) path. |
| C8 | **Stock geometry & serviceability** | Bolt-on seat/body panels, standard fasteners | Minimally-invasive, reversible modification (plan principle 2). |

Non-criteria (explicitly do not care): Bluetooth/MP3, LED lights, leather seats,
"spring suspension" marketing — these do not affect the conversion and are
ignored in scoring.

---

## 2. Candidate Models (July 2026)

> [!CAUTION]
> **Superseded — this section evaluates a vehicle class MRider no longer uses**
>
> All three candidates below are **24 V two-seaters**, which was the ADR D decision.
> **[ADR D-R reversed that on 2026-08-08](#adr-d-r-reversal-to-the-12-v-single-seater-2026-08-08)** and the adopted vehicle is a
> **12 V single-seat Land Rover Defender**. The evaluation is dated July 2026 and is kept
> unedited as the record of how the class was chosen — including its **Recommendation**, which
> is not current advice. **Do not buy from this section.** What to buy is in the
> [Order Log](../order-log.md) and [Build Guide §1.2.1](../build/01-bom-sourcing.md).

All three are 24 V two-seaters with parent remote and dual/quad motors, in the
$250–450 street-price band, and are the vehicle class the
[mrover build](https://github.com/jrkwon/mrover) already used (its BOM lists a
"POSTACK 24V 2-Seater" at ~$260 and an "ELEMARA 2-Seater" at ~$369). The point
of listing three is availability resilience (per the plan risk "vehicle model
availability varies"), not that these exact SKUs must be bought — **buy any unit
that passes Section 1 and Section 3.**

| | **Cand. 1 — 24V 2-Seat Jeep (Target/Amazon class)** | **Cand. 2 — GARVEE / Siavonce 24V 2-Seat UTV** | **Cand. 3 — POSTACK / ELEMARA 24V 2-Seat** |
|---|---|---|---|
| Body style | Jeep/SUV, 2 seats | **UTV / side-by-side (rear bed)** | Truck / tractor-style, 2 seats |
| Est. price (Jul 2026) | ~$280–320 | ~$350–450 | ~$260–370 |
| Voltage / motors | 24 V, "2×200 W" (4× on some 4WD) | 24 V, 4WD (4 motors) | 24 V, 2–4 motors |
| Remote | 2.4 GHz parent remote | 2.4 GHz parent remote | 2.4 GHz parent remote |
| Deck / bed (C5) | Flat seat backs; moderate | **Best — open cargo bed** | Good; flat rear |
| Steering column (C4) | Vertical shaft under dash — verify access | Vertical shaft — verify access | Vertical shaft — verify access |
| Metal gearbox (C6) | Model-dependent — **verify** | Model-dependent — **verify** | Model-dependent — **verify** |
| Sources | Target 1002549549; Amazon B0DNWRKKZY / B0DHVS12XF | garvee.com UTV listings; Home Depot XMJ-P184803 | mrover BOM (`Note/overview.md`); Amazon B0CJTWDC38 / B0DHCVHCJY |

**Recommendation:** prefer **Candidate 2 (24 V two-seat UTV with a rear bed)**
when available — the open bed (C5) makes the compute/control-box and mast
mounting the cleanest and most reversible, and 4WD UTVs in this class ship with
the sturdiest steel drivetrains. Candidate 3 is the proven fallback (mrover
heritage, lowest cost). Candidate 1 is the widest-available fallback. Final pick
is whichever in-stock unit passes Section 3 on the bench.

Links (representative, July 2026):
- Target 2-Seater 24 V Jeep, 2×200 W: <https://www.target.com/p/-/A-1002549549>
- GARVEE 24 V 2-Seater UTV: <https://www.garvee.com/>
- Siavonce 24 V 2-Seater UTV (Home Depot): <https://www.homedepot.com/p/333378612>
- Amazon 24 V 2-Seater (mrover-class): <https://www.amazon.com/dp/B0CJTWDC38>

---

## 3. Required Verification Checklist (on the purchased unit)

These measurements gate the [DBW](dbw.md) and [safety](safety.md) design. Do
them **before** cutting into wiring; several determine whether the stock motors
can be driven by the motor driver at all.

### 3.1 Drive-motor stall current vs the driver's rating (critical)

The two rear motors are wired **in parallel onto one driver channel**
([ADR C](dbw.md), throttle path). The driver fitted is a **Cytron MDDS30**, rated
**30 A continuous and 80 A peak per channel**, thermally derated — 80 A below 50 °C,
50 A to 70 °C, 40 A to 100 °C, and **30 A above 100 °C**. The paralleled pair must stay
within that.

*The figure in this section was **32 A continuous / ~64 A peak** until 2026-11-09, which is the
Sabertooth 2x32 — a board that was specified from a listing and **never fitted**. The continuous
limit is therefore 2 A lower than every gate assumed. See
[dbw.md §4.1](dbw.md#41-part-substitution-cytron-mdds30-replaces-the-sabertooth-2x32-2026-09-29).*

**Resolved on the delivered vehicle, 2026-09-30: `DING LI RS 390-12V RPM 18000`**, read off the
motor can during teardown.

This document had recorded the class as unknown since 2026-08-11, on the grounds that ride-on drive
motors in this size range run from RS-380/390 up to RS-550/775, that their stall currents differ by
close to an order of magnitude, and that **the range straddles the driver's ceiling**. That posture
was right, and it is now discharged by a label rather than by a lookup.

**The answer lands on the safe side.** RS-390 is the small end of that range, against the
MDDS30's **30 A continuous / 80 A peak** per channel. Four boards were received and confirmed
genuine on 2026-10-08 — [order log #3](../order-log.md#L3). A large-motor car was the case that
would have breached the ceiling, and this is not one.

> [!IMPORTANT]
> **This does not discharge the measurement. Take it anyway.**
>
> A class label is not a current. Winding variants inside a single RS-390 part number differ by
> several times, the vehicle is loaded differently from any datasheet's test rig, and the whole
> point of §3.1 is that catalogue figures are not evidence — see the warning below, which still
> stands unchanged.
>
> What the label changes is the **expected outcome**, not the obligation. Every gate below, in
> [safety.md FMEA row 7](safety.md#7-fmea-lightweight), and in
> [03-electrical](../build/03-electrical.md) remains in force.

- **Procedure:** with wheels off the ground, measure per-motor no-load current
  (clamp meter on one motor lead) at each OEM speed. Then measure locked-rotor
  (stall) current by briefly (<1 s) holding a wheel and reading peak, one motor
  at a time.
- **Sanity check before you trust the reading:** for a brushed DC motor,
  `I_stall ≈ V_supply / R_armature`. Measure `R_armature` across the motor
  terminals with the rotor locked, averaging over several rotor positions
  (brush position changes it). A 12 V motor measuring ~0.5 Ω implies roughly
  24 A stall; ~1.5 Ω implies roughly 8 A. If the clamp-meter peak and this
  estimate disagree by more than about 2×, distrust both and repeat — a
  clamp meter can easily miss a <1 s peak.
- **Acceptance:** paralleled continuous draw under load **≤ 30 A**; transient/stall
  of the pair should not sit above **80 A**, and the derating means 80 A is only
  available below 50 °C — a stalled pair heats the board, so treat the 30 A figure as
  the one that governs a repeated test.
- **If the pair can stall near or over that**, the mitigations are **not** what this
  document used to list. *"Per-motor current limit in the driver config"* was a
  Sabertooth assumption: **the MDDS30 has no user-settable current limit** — its manual
  lists *"current limit protection"* with no number ([dbw.md §4.1](dbw.md#41-part-substitution-cytron-mdds30-replaces-the-sabertooth-2x32-2026-09-29)). What is left is
  gentler accel/torque limits in firmware, a fuse on the branch, or driving **one** motor
  per channel and sacrificing the steering channel split. Choose **before** wiring — see
  [dbw.md](dbw.md) throttle path and [safety.md](safety.md) power budget.
- **Consequence if it fails:** paralleled stall above the driver's ceiling
  forces either weaker traction imposed in firmware or a **second motor driver** —
  the latter because the remaining hardware mitigation consumes the steering channel.
  *A spare MDDS30 was bought, so the second-driver route is stocked rather than hypothetical.*
  Flag to [bom.md](bom.md) and record in the [Order Log](../order-log.md).

> [!WARNING]
> **Do not take the motor-class figure from a vendor listing**
>
> Retail listings for RS-series ride-on motors routinely publish a "stall" or
> "max" current that is really the rated-load or peak-efficiency figure, off by
> several times. They are also frequently copy-pasted between unrelated
> windings. **The measurement above is the only authority in this project**, and
> its result belongs in the Order Log.

### 3.1.1 The traction pack, from its own label

Read off the pack on the delivered vehicle. **This is the authoritative record**; the places
that need it — the driver's battery-monitor switches, the rail record sheet, the enclosure
rules — cite this section rather than restating it.

![The traction pack's own label, photographed on the vehicle. It reads Aroma 6-FM-4.5 (12V4.5Ah/20Hr), Rechargeable Battery, NON-SPILLABLE, above a CHARGE CAUTION table at 25 degrees C giving Cycle use 14.4V to 15.0V at less than 1.1A and Standby use 13.6V to 13.8V; below that, warnings against shorting the terminals and against charging in a sealed container, a 55 degree temperature limit, the statement that the battery includes Pb 70 percent at most, a crossed-out wheelie bin with the Pb symbol, and the maker Zhejiang Pinghu Hualong Industrial](../images/photos/traction-pack-label.jpg)

*Vehicle #1 ([provenance](../images/photos/MANIFEST.md)). Every number in the table below is read
off this label; the table exists so that nobody has to squint at the photograph, not instead of it.*

| | |
|---|---|
| Type | **`Aroma 6-FM-4.5`** — `6` cells × 2 V = **12 V**, `FM` = valve-regulated sealed, `4.5` = Ah |
| Chemistry | **Sealed lead-acid (VRLA)**. Marked `NON-SPILLABLE` and `Pb`, "includes Pb 70% at most" |
| Capacity | **4.5 Ah at the 20-hour rate** — that is 225 mA for 20 h, *not* a figure that survives to high current |
| Charge, cycle | **14.4 – 15.0 V**, initial current **< 1.1 A** (0.24 C) |
| Charge, standby | **13.6 – 13.8 V** float |
| Temperature | **≤ 55 °C** |
| Maker | Zhejiang Pinghu Hualong Industrial |

**Three things follow, and none of them are about the label.**

- **The 20-hour rate is not the stall rate.** The driver is rated 30 A continuous, which on a
  4.5 Ah pack is **6.7 C**. A VRLA at that rate delivers a fraction of its rated capacity and
  sags hard, so the **pack's own internal resistance may be the real current limiter** — which
  is a measurement, not an assumption, and is the open question in
  [03-electrical §3.2](../build/03-electrical.md#32-per-rail-fuse-and-gauge-table).
- **The rail is not 12 V.** It reaches **15.0 V** on a cycle charge and a resting full pack sits
  near 12.8 V. *Nothing in the current design minds:* the only two things on the traction rail
  are the stock ECU — the vehicle's own, which normally sits across its own pack while it charges
  — and the driver's `B+`, and the **MDDS30 takes 7–35 V**. The relay MUX switches motor leads
  rather than either controller's supply, the E-stop contactor's coil runs off the **logic**
  battery, and the logic rail is its own pack and is never tapped from traction
  ([03-electrical §3.1](../build/03-electrical.md#31-the-two-rails)).
- **The risk is the other end of that range.** The driver's floor is **7 V**, and a 4.5 Ah VRLA
  asked for 30 A is being asked for 6.7 C. If the pack sags under 7 V with the pair stalled, the
  driver drops out mid-drive. That is what the *traction rail under stall* row of
  [03-electrical's rail sheet](../build/03-electrical.md#38-first-power-on-of-the-traction-rail)
  is for, and it is the measurement this label makes worth taking.
- **"Do not charge in a sealed container."** A VRLA vents under charge. The pack stays in the
  chassis's own bay, in air — do not relocate it into either printed box, and keep it liftable
  ([02-mechanical](../build/02-mechanical.md) row `D13`).

*The charge-voltage rows are the evidence for the chemistry, not just a specification. A
distinct **standby/float** voltage is a lead-acid signature: lithium chemistries are not float
charged, a 12 V LiFePO₄ ends at 14.6 V with no float stage, and a 3S LiPo tops out at 12.6 V.*

### 3.2 OEM motor voltage configuration (critical)

"24 V" ride-ons are built two ways, and it changes how the driver's B+ and
motor leads are tapped:

- **(a) Native 24 V motors** — each motor sees the full 24 V pack. The driver's
  motor outputs drive them directly at 24 V.
- **(b) 12 V motors in series/paired across a 24 V pack** — common on
  "2×12 V" builds. Here a single motor must **not** see 24 V.
- **Procedure:** read the motor can label (e.g., `RS-550 12V` vs `24V`); with a
  meter, measure the voltage across one motor's terminals at full throttle in
  OEM mode. **Acceptance:** confirm whether each drive motor terminal sees 12 V
  or 24 V, and wire the driver output to match (never apply 24 V across a
  12 V motor). This determines the [power budget](safety.md) rail assignment.

### 3.3 Steering column geometry

- **Procedure:** remove the dash/kick panel; confirm a **vertical steering shaft**
  is exposed between the wheel hub and the tie-rod/pitman linkage, with clear
  radial space for (a) a gear/pulley or direct coupler to the
  [steering gearmotor](dbw.md) and (b) a hollow-shaft or coupled **absolute
  angle sensor**. Measure shaft diameter, exposed length, and mechanical
  steering range (lock-to-lock) in degrees.
- **Acceptance:** ≥ ~30 mm clear shaft, measurable and repeatable mechanical
  stops, total column travel that a **single-turn** sensor can span (if it
  exceeds ~ one turn, that forces the pot-vs-magnetic
  [angle-sensor ADR in dbw.md](dbw.md) toward a multi-turn pot or a geared-down
  magnetic sensor). Record lock-to-lock for the
  [calibration](calibration.md) counts→degrees map.

### 3.4 Secondary checks

- Gearbox material (C6): open one drive gearbox — steel vs nylon gears.
- Pack: confirm the pack voltage matches the adopted class — **12 V nominal**
  ([ADR D-R](#adr-d-r-reversal-to-the-12-v-single-seater-2026-08-08)) — plus connector type and charger.
- Confirm the parent remote's receiver board is a **separable module** whose
  motor-drive lines can be routed through the [relay MUX](safety.md).
  **Answered 2026-10-01: `JR1630RX-12V`**, a combined 2.4 GHz receiver and motor controller on a
  connector harness — separable, and its motor outputs are what the three taps intercept. Rated
  **DC 12 V, 20 A max**, behind a **10 A** inline device in the battery `+` line. Both figures
  bound the stock system's current draw; neither is a stall measurement. See the
  [Order Log](../order-log.md) V1 entry.

---

## ADR D — 24 V two-seater vs 12 V single-seater

**Status:** ~~Accepted~~ — **REVERSED 2026-08-08. D2 (12 V single-seater) adopted.**
See [§ADR D-R](#adr-d-r-reversal-to-the-12-v-single-seater-2026-08-08) below. The original
reasoning is retained unedited, because it is still correct about what the reversal costs.

**Context.** MRider must carry an onboard laptop plus a camera, 2D LiDAR, mast,
Teensy, Sabertooth, and relay MUX, and drive that mass at walking speed
for a full data-collection/mapping session while the [DBW](dbw.md) closes a
steering position loop. The mrover/OSCAR lineage and prior Ridon work used this
same ride-on class.

**Decision.** Use a **24 V two-seater ride-on (UTV/Jeep/truck style) with dual
rear motors and a parent remote**, of the class mrover already validated. Select
the specific unit by the Section 1 criteria and Section 3 bench verification.

**Alternatives considered.**
- **D1 (chosen) — 24 V two-seater.** Payload headroom (C1), 24 V torque/voltage
  margin (C2), wide flat deck or UTV bed (C5), dual motors (C3). Cost ~$260–450.
- **D2 — 12 V single-seater.** Cheapest (~$150–250), matches the older Ridon
  precedent, smallest footprint. Rejected as the baseline: marginal payload once
  a laptop + sensors + control box are added, less torque margin on inclines/
  grass, and a tighter deck for mounting. Kept as a possible "lite tier" appendix
  only.
- **Off-class — mobility scooter / larger EV.** Rejected: heavier, faster than
  the ≤ walking-speed [safety](safety.md) envelope, and higher-stakes failure
  modes for an education platform.

**Rationale.** The 24 V two-seater is the smallest, cheapest platform that
comfortably meets payload and torque margin while preserving the exact
Sabertooth-2x32 electrical recipe MRider reuses. The extra ~$100–200
over a 12 V single-seater buys margin on every axis that is expensive to add
later (payload, torque, deck area) and costs nothing MRider needs.

---

## ADR D-R — Reversal to the 12 V single-seater (2026-08-08)

**Status:** Accepted. Supersedes the decision in ADR D above; that section's reasoning is
preserved because it correctly predicts what this costs.

**Context.** Two candidate vehicles were evaluated against the §1 criteria:

| | Benz NEW GTR AMG | Land Rover Defender |
|---|---|---|
| Price | ₩198,000 (~$145) | ₩229,000 (~$165) |
| Size (L×W×H) | 99 × 55 × 41 cm | 98 × 56 × 47 cm |
| Battery | **12 V** | same class |
| Vehicle weight | **10 kg** | — |
| Motors / remote | dual / 2.4 GHz | dual / yes |
| Seats | **1** | **1** |

Both fail ADR D outright: 12 V not 24 V, single-seat not two, and a wheelbase of roughly
63 cm against the ≥ 70 cm criterion. **The lab elected to adopt the class anyway**, trading
margin for cost and storage footprint.

**Decision.** Adopt a **12 V single-seat ride-on**, and of these two the **Land Rover
Defender** — boxy body, 47 cm roofline, and a flat-ish hood and roof to mount to. The GT-R's
sloping sports shell is actively hostile to a sensor mast, and the ₩31k difference is noise
against the build.

**Consequences — three of which are favourable, which is why this is defensible.**

| | Direction |
|---|---|
| **Sensor mast drops from 1.0–1.2 m to ~0.65 m.** A 1.2 m mast on a 47 cm tall, 56 cm wide chassis is a tip-over risk. [sensors.md §5](sensors.md#5-mounting-mast-concept) amended. Changes camera framing for phase-2 behavior cloning. | ✗ real cost |
| **No flat deck.** The seat is the only flat area; it is removed and replaced with an equipment plate. | ✗ real work |
| **Finding F1 is lost.** B-MROVER is validated on a 24 V two-seater, so that chassis-class validation no longer transfers. After [D3](adr-dbw-architecture-review.md#46-decision-adopted-2026-08-07) removed the autopilot-lineage claim, this was the *remaining* reuse argument. | ✗ significant |
| Steering torque **falls** — less tyre scrub on a lighter, narrower car. Gearmotor sizing gets easier, and the [§2.2 torque procedure](dbw.md#22-torque-measurement-procedure-before-sizing-the-gearmotor) should come in well under the 24 V case. | ✓ |
| Wheelbase ~63 cm gives **R_min ≈ 1.52 m** instead of ~1.7 m — a tighter turning circle, which is better in indoor corridors within the same ±22.5° limit. | ✓ |
| 12 V at ≤ walking speed is **inherently less dangerous** than 24 V for a student-operated platform. | ✓ |
| Driver headroom is **unknown until the drive motors are measured** ([§3.1](#31-drive-motor-stall-current-vs-the-drivers-rating-critical)) — a 12 V car is *likely* to draw less than the 24 V case, but "likely" is not a number and the plausible range straddles the ~~32 A/channel~~ **30 A/channel** limit *(the board named here was never fitted — [dbw.md §4.1](dbw.md#41-part-substitution-cytron-mdds30-replaces-the-sabertooth-2x32-2026-09-29))*. Retained regardless of how it lands: its current limiting and R/C signal-loss timeout are load-bearing in the [failsafe matrix](safety.md#2-failsafe-matrix). | – |

> [!NOTE]
> **Corrected 2026-08-11 — this document used to assert the motor class twice, differently**
>
> Recorded because the disagreement was invisible until someone tried to justify the
> Sabertooth line item, and because the resolution is a general rule for this project.
>
> §3.1 read *"Stall for RS-550-class 12 V motors is typically 30–60 A each"* — paralleled,
> 60–120 A, at or beyond the 2x32's ~64 A peak. The consequences row above read *"heavily
> oversized for RS-390-class motors"* — roughly a quarter of that. §3.1's figure was written
> for the 24 V two-seater and never re-scoped when ADR D was reversed; the RS-390 claim had
> no source at all.
>
> **Neither was asserted after that.** The motor class was recorded as unknown, the plausible range
> straddles the driver's limit, and §3.1 made the measurement the authority rather than any
> catalogue figure. That was the correct posture for a number that decides whether the most
> expensive board in the build is adequate.
>
> **Closed 2026-09-30 by teardown: it is an RS-390.** So the claim that was struck for having *no
> source at all* turns out to have been right.
>
> That does not make striking it wrong. It was unsourced when it was written, and an unsourced
> right answer is indistinguishable from an unsourced wrong one until someone checks — which is the
> entire reason §3.1 exists. The label is the source it never had. **The measurement is still
> required**; being on the safe side of a ceiling is not the same as knowing the distance to it.

**Payload is not the problem it first appears.** These cars are rated for a child (~25–30 kg);
~6 kg of kit is well inside that. The real risks are **centre of mass** and **mounting
surface**, not mass — which is why the fix is mast height, not a payload budget. The
[digital twin](software.md#8-semester-1-scope-and-software-acceptance-gates) models the
equipment plate as a real 6 kg link specifically so the tip-over margin is visible in
simulation rather than discovered on the floor.

**What must still be verified on the delivered vehicle** (§3 procedures apply unchanged):

- [ ] Confirm 12 V at the motor terminals, and whether the two drive motors are 12 V in
      parallel — §3.2's warning matters more here, not less.
- [ ] Paralleled stall current (§3.1). RS-390 confirmed 2026-09-30, so expected well inside the 30 A channel — **still measure it**.
- [ ] Steering column travel lock-to-lock — gates the
      [angle-sensor choice](dbw.md#6-adr-angle-sensor-technology-magnetic-encoder-vs-potentiometer).
- [ ] Whether the laptop still fits once the seat is removed, or whether an SBC is warranted.
      This one may reopen a stated requirement in [overview.md](overview.md).

**Consequences.**
- Paralleled dual-motor draw must be verified against the ~~32 A/channel Sabertooth~~
  **30 A/channel MDDS30** ceiling (§3.1) — the one place the bigger vehicle can bite back.
  *([dbw.md §4.1](dbw.md#41-part-substitution-cytron-mdds30-replaces-the-sabertooth-2x32-2026-09-29) — the Sabertooth was never fitted.)*
- Motor voltage configuration (§3.2) must be confirmed before wiring.
- Higher base cost flows into the [BOM](bom.md) (both tiers use this line item).
- The wide deck / UTV bed simplifies the [sensor mast](sensors.md) and control-box
  mounting versus a 12 V single-seater.
- Non-self-centering steering column (typical of this class) drives the
  [E-stop steering-on-power-loss semantics](safety.md).

**Follow-ups.** Purchase a unit passing §1; run §3 bench checks and feed results
into [dbw.md](dbw.md) (torque/stall sizing), [safety.md](safety.md) (power rails),
and [calibration.md](calibration.md) (lock-to-lock range).
