jrkwon/mrider/docs/course/weeks/w01.md

# Week 1 — Middleware and the ROS 2 Graph

**Monday, September 14, 2026 · 3 hours**

| | |
|---|---|
| **Lab** | [Lab 1 — Bring Up the Twin](../labs/lab1.md) |
| **Reading** | [M1 — Intro to MRider & ROS 2](../../learn/m1-ros2-intro.md) · *Zero to Robot* ch. 1 |
| **Design reference** | [architecture.md](../../design/architecture.md) |
| **Prerequisite** | [Environment Setup](../environment.md) complete before class · [Week 0](w00.md) covered the vocabulary |

---

## Learning objectives

By the end of this session you should be able to:

- Explain what a **robotics middleware** is and what problem it solves
- Describe MRider's command path from a human input to wheel motion, and the feedback path back
- Bring up a working ROS 2 system and inspect its computation graph with the `ros2` CLI
- Recognise a **silent failure** and name the class of cause to check first

---

## Session plan

| | |
|---|---|
| 0:00 – 0:15 | Course introduction, syllabus, how the semester is structured. **Collect GitHub profile URLs** — lab repositories are created from them |
| 0:15 – 0:50 | Lecture |
| 0:50 – 1:00 | Break |
| 1:00 – 2:30 | [Lab 1](../labs/lab1.md) |
| 2:30 – 3:00 | Wrap-up; how `setup_env.sh` isolates your machine; questions |

---

## Lecture

### 1. What a middleware is for

A robot is not one program. It is a camera driver, a LiDAR driver, a localiser, a planner, a
controller, and a safety monitor — written by different people, in different languages, running at
different rates, often on different machines.

Middleware is what lets those parts be written independently and still work together. ROS 2 gives
you:

- **Named, typed channels** (topics) instead of ad-hoc sockets
- **Discovery** — processes find each other without being told where anything is
- **Introspection** — you can list, inspect, record, and replay everything at runtime
- **Language independence** — Python and C++ nodes in one graph

The cost, which this course will make you feel repeatedly: the coupling that used to be a compile
error is now a **runtime** condition. Names, types, QoS, and domains must all agree, and when they
disagree, mostly nothing happens and nothing complains.

### 2. Drive-by-wire

MRider is a 12 V ride-on car whose mechanical steering and throttle are being replaced by
**electrically commanded** equivalents. Steering becomes a gearmotor plus an absolute angle sensor
closing a position loop; the throttle becomes a motor driver taking a signed command.

Three properties follow, and they shape everything:

1. **Actuation is a physical process with limits.** ±22.5° of steering. A rate limit. A stall
   current. Software cannot wish these away.
2. **Feedback is measured, not known.** Every number the autonomy sees came from a sensor with noise,
   latency, and blind spots.
3. **A human must always be able to take it back.** Not as a feature — as an architectural
   requirement that outranks everything else.

### 3. Command and feedback paths

```
joystick ──▶ /cmd_vel_joy ──┐
                            ├──▶ twist_mux ──▶ ackermann_steering_controller ──▶ wheels
navigation ──▶ /cmd_vel ────┘      (arbitrates)         (kinematics)

wheels ──▶ encoders ──▶ odometry ──┐
                                   ├──▶ EKF ──▶ /odom → base_link ──▶ SLAM ──▶ map
IMU ───────────────────────────────┘
```

`twist_mux` gives the joystick priority 100 and navigation priority 10. A human at the sticks wins.

> [!CAUTION]
> **But `twist_mux` is not the safety system**
>
> Read the comment at the top of `mitt_control/config/twist_mux.yaml`. It says so explicitly, and
> the honesty is the point.
>
> Real authority on this vehicle is **electrical and layered**: a hardware E-stop, a relay MUX that
> reverts to stock mechanical steering, a hardware RC signal MUX, and RC serial override. **Three of
> those four work with the software completely dead.** A software mux cannot do that job, and
> presenting it as though it could would be worse than having nothing — because people would trust
> it.
>
> This distinction — between what a component *does* and what it must never be *relied on* for —
> is one of the things this course is really about.

### 4. Rates are contracts, not preferences

Numbers you will meet today and keep meeting:

| | |
|---|---|
| `update_rate: 100` | Controller manager, so it is never the bottleneck |
| `reference_timeout: 0.5` | A command older than half a second is not a command |
| ≥ 50 Hz | Required rate for DBW status from the vehicle |
| ≤ 100 ms p95 | Joystick-to-wheel latency budget |

A system that meets its functional spec and misses its timing spec is broken. On a vehicle, it is
dangerous.

### 5. The shape of ROS 2 failure

Today's lab ends by breaking the system on purpose, and it will not be the last time. The pattern is
worth naming in week one:

> When something is **invisible rather than broken**, suspect the environment before you suspect your
> code.

Mismatched `ROS_DOMAIN_ID`, mismatched QoS, mismatched middleware — all produce silence, exit code 0,
and empty logs. Weeks 3 and 4 add two more members to this family.

---

## Lab

[Lab 1 — Bring Up the Twin](../labs/lab1.md). Verify your environment, launch the simulator, map its
computation graph, drive it, then reproduce a silent discovery failure.

**Due before Week 2 (9/21).**

---

## Slide outline

1. Title — 자율주행미들웨어응용, Fall 2026
2. Who I am; what this course is; why we build rather than exercise
3. The semester in one slide: 4 individual labs → 4 teams → merge ladder → demo
4. What exists today, and what does not (`firmware/`, `mitt_hardware`, measured geometry, real tests)
5. What a middleware is for — the six-programs problem
6. What ROS 2 gives you; what it costs you (compile-time coupling becomes runtime coupling)
7. Drive-by-wire: the three consequences
8. The command path — joystick, mux, controller, wheels
9. The feedback path — encoder, odometry, EKF, SLAM
10. `twist_mux` is not a safety system, and why saying so matters
11. Rates as contracts: 100 Hz, 0.5 s, 50 Hz, 100 ms
12. The shape of ROS 2 failure: silence, exit 0, empty logs
13. Lab 1 — and why isolating your machine takes two variables, not one

---

## See also

- [Week 2 — Nodes, Topics, Packages](w02.md)
- [architecture.md](../../design/architecture.md) — the full component inventory
- [safety.md §1](../../design/safety.md) — the authority ladder in detail
