jrkwon/mrider/docs/course/weeks/w07.md

# Week 7 — Embedded ROS 2

**Monday, October 26, 2026 · 3 hours**

| | |
|---|---|
| **Reading** | [M2 — Drive-by-Wire & Smart-Servo](../../learn/m2-dbw-steering.md) · *Zero to Robot* ch. 16, 18 |
| **Design reference** | [dbw.md §10–12](../../design/dbw.md) |
| **Due today** | **Team charters** |
| **Next week** | Mid-semester presentation |

The Electrical track needs this content immediately, so it comes early. Everyone gets it, because
the boundary it describes is where every other track's work eventually lands.

---

## Learning objectives

By the end of this session you should be able to:

- Explain what micro-ROS is and where the boundary between microcontroller and host sits
- Read `DbwCommand` / `DbwStatus` and say what each field is for
- Describe a `hardware_interface` plugin's `read()`/`write()` cycle
- Explain why a status message echoes back the setpoint it was given
- Say what a fault bitfield buys over a boolean

---

## Session plan

| | |
|---|---|
| 0:00 – 0:50 | Lecture |
| 0:50 – 1:00 | Break |
| 1:00 – 2:30 | Track work. Electrical starts on the bench kits |
| 2:30 – 3:00 | Standup. **Mid-presentation format briefing** |

---

## Lecture

### 1. Why a microcontroller at all

The laptop runs Linux, which is not a real-time operating system. It cannot promise to close a
position loop at 200 Hz — it can usually do it, which is worse than a clear no, because the failures
are rare and load-dependent.

So the split is by **timing guarantee**:

| | Runs where |
|---|---|
| Steering position loop, safety state machine, PWM generation | **Teensy 4.1** — deterministic |
| SLAM, planning, perception, logging | **Laptop** — best effort |

[ADR D3](../../design/adr-dbw-architecture-review.md) adopted a **single** Teensy 4.1, replacing a
Pixhawk 6C + Arduino Nano topology.

> [!CAUTION]
> **A single controller is a single point of failure — and the ADR says so**
>
> D3 was adopted **conditional** on a layered override that does not depend on it:
>
> > RC serial into the Teensy for normal closed-loop override, *plus* a hardware RC signal MUX on the
> > E-stop chain as the independent deeper fallback. **The condition is not optional; it is what
> > makes the single-point-of-failure objection answerable.**
>
> Note what the record does *not* do: it does not claim the objection was wrong. It names the
> objection, and buys it off with a mechanism. That is what an honest decision record looks like.

There is also a **pre-registered fallback**, E4: if the Teensy loop cannot hold ≤ 1° steady-state
with no sustained oscillation at bring-up Stage 1, adopt a motion-controller daughterboard **rather
than tuning without bound.** The trigger was written before the attempt.

### 2. micro-ROS

micro-ROS puts a genuine ROS 2 node on the microcontroller. The Teensy publishes and subscribes real
typed topics; an **agent** process on the laptop bridges them onto the DDS network.

```
Teensy 4.1                          Laptop
┌──────────────────┐                ┌────────────────────────────┐
│ micro-ROS node   │  USB serial    │ micro_ros_agent            │
│  sub DbwCommand  │◀──────────────▶│   ▲                        │
│  pub DbwStatus   │                │   ▼                        │
│  200 Hz loop     │                │ /mitt/dbw/{command,status} │
│  safety FSM      │                │   ▲                        │
└──────────────────┘                │   ▼  mitt_hardware plugin  │
                                    │    controller_manager       │
                                    └────────────────────────────┘
```

**ADR-SW1 — one transport, one clock, typed messages.** Both directions on the same link, stamped on
the same clock. As `DbwStatus.msg` puts it: *a single `ros2 topic echo` therefore shows both sides of
the control loop.*

That is not a convenience. Debugging a control loop whose command and feedback arrive over different
transports on different clocks is a category of pain this design simply refuses to enter.

> [!NOTE]
> **`micro_ros_agent` is not in the Humble apt repositories**
>
> Build it from source **now**, during track work — not in Week 13 when it blocks the vehicle.
> [Build guide §5.4](../../build/05-software.md) has the procedure. Record the commit you built.

### 3. The interface contract

Read both files in `mitt_msgs/msg/`. They are short and every line is deliberate.

**`DbwCommand`** — laptop → Teensy, ≥ 50 Hz:

- `steering_angle` — **radians**, clamped by firmware to ±0.3927 (±22.5°)
- `speed` — signed m/s, positive forward

**`DbwStatus`** — Teensy → laptop, ≥ 50 Hz:

- `steering_angle` — **measured**, from the load-side sensor. *"Authoritative — never derived from
  the motor encoder, which sits upstream of the gearbox backlash."*
- `steering_setpoint` — the setpoint currently being tracked, **echoed back**
- `wheel_speed`, `drive_ticks` — *"PPR is a MEASURED constant… do NOT assume 52"*
- `mode` — ESTOP / MANUAL_RC / AUTONOMOUS
- `faults` — a bitfield

> [!TIP]
> **Three design choices in there worth stealing**
>
> **Echoing the setpoint back.** The firmware already knows it — but now commanded and measured
> sit on **one time axis in one bag**, and "did it not follow, or did it not receive?" becomes a
> question you can answer from a single recording rather than by correlating two logs.
>
> **Radians in the message, degrees never.** One unit crosses the boundary. Unit confusion at an
> interface is a classic and expensive bug.
>
> **A fault bitfield, not a boolean.** Six named causes — `ENCODER`, `SETPOINT_STALE`, `AT_LIMIT`,
> `STALL`, `RC_LOSS`, `OVER_CURRENT` — and several can be set at once. `is_faulted: true` tells you
> to stop. This tells you *why*, which is what you need at 2 a.m. with the vehicle on blocks.

### 4. The timing contract

| | |
|---|---|
| `DbwCommand` publish rate | ≥ 50 Hz |
| `DbwStatus` publish rate | ≥ 50 Hz |
| Steering position loop | ≥ 200 Hz on the Teensy |
| Command staleness → ESTOP | > 500 ms |
| Joystick → wheel latency | ≤ 100 ms at p95 |
| USB dropouts | **zero** over ≥ 30 minutes |

These are **acceptance gates**, not aspirations. The Electrical track is graded against them, and
`FAULT_SETPOINT_STALE` exists to make the 500 ms rule observable rather than merely intended.

### 5. `hardware_interface` — the other side

`ros2_control` talks to hardware through a plugin implementing a fixed cycle:

```cpp
return_type read(const rclcpp::Time&, const rclcpp::Duration&) override;
// hardware state -> state_interfaces
return_type write(const rclcpp::Time&, const rclcpp::Duration&) override;
// command_interfaces -> hardware
```

For MRider, `read()` takes the latest `DbwStatus` and fills the joint state interfaces; `write()`
takes the controller's commands and publishes a `DbwCommand`.

> [!CAUTION]
> **There was never working code here to reuse**
>
> B-MROVER's `carlikebot_system.cpp` is an **unmodified upstream demo stub** — `read()` echoes the
> command back as state, `write()` only logs ([finding F3](../../design/software.md)).
>
> A stub that echoes commands back as state is the worst possible thing to inherit: in simulation
> and in any test that does not touch hardware, it looks like it works perfectly.
>
> `mitt_hardware` is **new work**, and it is the Software track's keystone. Merge 3 in Week 13
> exists to prove ADR-SW4 with it: the identical teleop launch running in sim and on hardware,
> differing only in this plugin.

---

## Track work

| Track | This week |
|---|---|
| **Electrical** | Bench kit up; blink, then read the angle sensor open-loop. `safety.md` Stage 0 |
| **Chassis** | Teardown; re-measure M1/M2/M3 independently; start the mounting design |
| **Simulation** | First functional test — make `colcon test` assert something that is not a linter |
| **Software** | `mitt_hardware` skeleton: load the plugin, activate it, publish nothing yet |

**Charters were due today.** If yours has an undated dependency in it, fix that before you write any
more code.

---

## Slide outline

1. Title — Week 7: Embedded ROS 2
2. Why a microcontroller: Linux "usually" is worse than a clear no
3. The split by timing guarantee
4. ADR D3: one Teensy — and the objection it had to answer
5. The condition is not optional. Plus E4, the pre-registered fallback
6. micro-ROS: a real ROS 2 node on the MCU, and the agent
7. ADR-SW1: one transport, one clock — both sides in one `topic echo`
8. Build `micro_ros_agent` now, not in Week 13
9. `DbwCommand`: radians, clamped in firmware
10. `DbwStatus`: measured angle is authoritative, never derived
11. Why echo the setpoint back
12. Why a fault bitfield beats a boolean
13. The timing contract — these are gates
14. `hardware_interface`: read() / write()
15. The inherited stub echoes commands back as state — and looks perfect
16. `mitt_hardware` is new work, and Merge 3 exists to prove it
17. Track work; mid-presentation format

---

## See also

- [Week 8 — Safety, and the Mid-Semester Presentation](w08.md)
- [dbw.md §10–12](../../design/dbw.md) — the firmware interface and numeric contract
- [M2 — Drive-by-Wire & Smart-Servo](../../learn/m2-dbw-steering.md)
- [Build guide §4](../../build/04-firmware.md) — firmware bring-up stages
