jrkwon/mrider/docs/course/weeks/w02.md

# Week 2 — Nodes, Topics, and Packages

**Monday, September 21, 2026 · 3 hours**

| | |
|---|---|
| **Lab** | [Lab 2 — Drive a Square](../labs/lab2.md) |
| **Reading** | *Zero to Robot* ch. 2–3 · [M1](../../learn/m1-ros2-intro.md) |
| **Design reference** | [software.md §3](../../design/software.md) |
| **Due today** | [Lab 1](../labs/lab1.md) |

---

## Learning objectives

By the end of this session you should be able to:

- Create a ROS 2 package and build it with `colcon`
- Write a node that publishes and subscribes, in Python
- Choose an appropriate publishing rate, and justify it against a system's timing contract
- Explain why an Ackermann vehicle cannot turn while stationary
- Describe where MRider's odometry number physically comes from, and what it cannot observe

---

## Session plan

| | |
|---|---|
| 0:00 – 0:50 | Lecture |
| 0:50 – 1:00 | Break |
| 1:00 – 2:30 | [Lab 2](../labs/lab2.md) |
| 2:30 – 3:00 | Debugging clinic — bring what broke in Lab 1 |

---

## Lecture

### 1. Workspaces, packages, `colcon`

```
ros2_ws/
├── src/            your packages, and cloned upstream sources
├── build/          intermediate build artifacts
├── install/        what you actually source
└── log/            build and test logs
```

`colcon build` walks `src/`, resolves the dependency order from each `package.xml`, and installs into
`install/`. Sourcing `install/setup.bash` puts those packages on your path.

**Two build types matter here.** `ament_cmake` for C++ and for packages that mainly install files;
`ament_python` for pure-Python nodes.

> [!NOTE]
> **Every MITT package today is `ament_cmake` and contains zero nodes**
>
> Look at `ros2_ws/src/`. Seven packages: launch files, YAML, URDF, message definitions, a world.
> **Not one C++ or Python node in the entire workspace.**
>
> That is not an oversight — it is where the project currently is. The nodes that should exist
> (`mitt_hardware`, the odometry node, `mitt_bench`, perception) are exactly what the four tracks
> build from Week 6. You are about to write the first node in this repository.

`--symlink-install` links rather than copies, so editing a Python file takes effect without
rebuilding. Use it; it will save you hours.

### 2. Publishers, subscribers, and the timer

The rhythm of almost every ROS 2 node:

```python
class Thing(Node):
    def __init__(self):
        super().__init__('thing')
        self.pub = self.create_publisher(Msg, '/out', 10)
        self.create_subscription(Msg, '/in', self.on_in, 10)
        self.create_timer(0.1, self.tick)     # 10 Hz
```

The `10` is the **queue depth**: how many messages to buffer if the other side is slow. It is part of
the QoS profile, which Week 3 opens up properly.

**Callbacks must not block.** A callback that sleeps, or does heavy computation, stalls every other
callback in that executor. Symptoms look like a performance problem, not a structural one.

### 3. Choosing a rate

Not a matter of taste. It is bounded from below by the consumer's timeout and from above by what the
producer and network can sustain.

For MRider's command stream:

| | |
|---|---|
| `reference_timeout: 0.5 s` | The controller zeroes after this. So **> 2 Hz**, absolute floor |
| Controller runs at 100 Hz | Publishing faster than this buys nothing |
| ≤ 100 ms p95 latency budget | Argues for ≥ 20 Hz so a dropped message does not blow the budget |

10–20 Hz is the sensible band. Lab 2 has you publish at 10 Hz, then at 1 Hz to watch the floor
enforce itself.

### 4. Ackermann kinematics, informally

The formal treatment is [Week 4](w04.md). What you need today:

$$ \omega = \frac{v \tan\delta}{L} $$

Yaw rate is **proportional to forward speed**. At `v = 0`, ω is zero regardless of steering angle. A
car cannot pirouette.

This is why your square driver keeps `linear.x` non-zero through its turns, and it is why the
navigation stack later needs a planner that can plan *reversing manoeuvres* — because for this
vehicle, "turn around" is not a primitive.
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
