jrkwon/mrider/docs/course/weeks/w04.md

# Week 4 — Self-Study Packet

**Monday, October 5, 2026 · no meeting**

> [!NOTE]
> **개천절 대체공휴일**
>
> October 3 falls on a Saturday, so the National Foundation Day holiday moves to **Monday
> October 5**. There is no class and no make-up session.
>
> This is not a week off. It is a **two-week working window** — handed out on 9/28, with the lab
> due when we next meet.
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
