jrkwon/mrider/docs/images/mitt.png

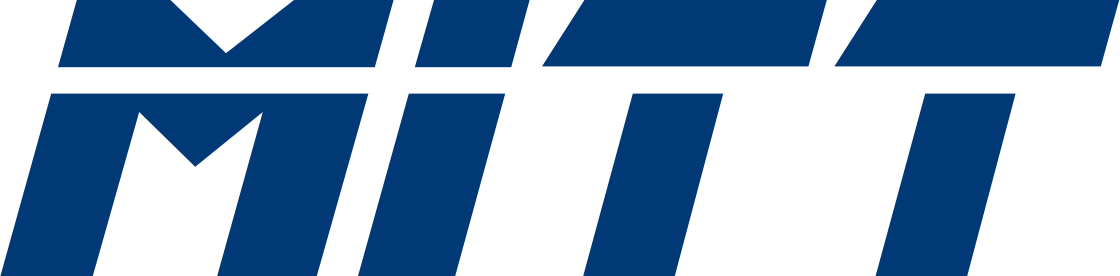
docs/images/mitt.png
