jrkwon/mrider/docs/images/mrider.png

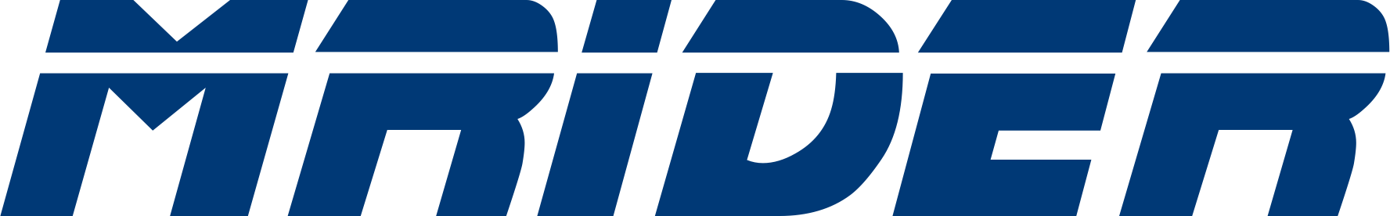
docs/images/mrider.png
