jrkwon/mrider/docs/images/photos/traction-pack-label.jpg

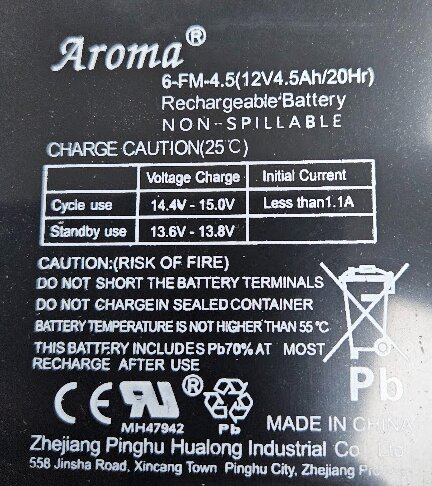
docs/images/photos/traction-pack-label.jpg
