jrkwon/mrider/ros2_ws/src/mitt_description/meshes/mitt_body_texture.png

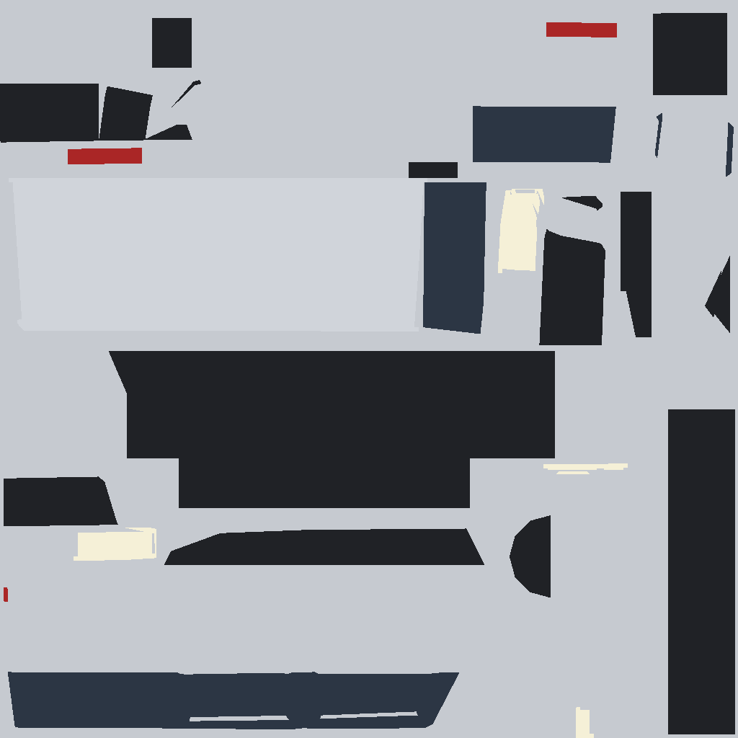
ros2_ws/src/mitt_description/meshes/mitt_body_texture.png
