jrkwon/mrider/docs/order-log.md

# Order Log

**A working record, meant to be edited.** Fill it in as you place orders and as parts arrive.
Unlike the [BOM](design/bom.md), which is a *specification*, this page is the *history* of
what was actually bought, from whom, for how much, and what was substituted.

Keep it honest even when it is unflattering — a substitution that seemed harmless and later
caused a rebuild is exactly the entry the next person needs.

- **What to buy and why:** [design/bom.md](design/bom.md) — the specification
- **Where to buy it, and what to verify:** [build/01 §1.2.1](build/01-bom-sourcing.md#121-sourcing-in-korea-verified-2026-09-15) — vendors, prices, the date each was read
- **What was approved:** [Purchase Request](purchase-request-2026-fall.md) — **frozen** at 2026-09-28; divergences are in its [Amendments](purchase-request-2026-fall.md#amendments-since-approval) section
- **This page:** what was **actually ordered, paid and received.** The live record — edit it freely

> [!IMPORTANT]
> **Which document changes, and which does not**
>
> The purchase request is evidence of what the university agreed to fund. Editing its tables as
> procurement proceeds would destroy the only record of that, so it is **frozen** and every
> divergence is listed in its Amendments section instead.
>
> **This page is the opposite** — it is meant to be edited, every day if need be, and it is the
> authority for what was actually bought. When the two disagree, this page is what happened and the
> request is what was promised. The gap between them is the reconciliation, and it is the useful
> part.
>
> **Vendor links live here**, not in the request. Several have been corrected since approval — one
> pointed at a receiver rather than a transmitter-and-receiver set — and a frozen document cannot
> carry corrections.

> [!NOTE]
> **Currency**
>
> BOM estimates are **USD, August 2026**. Record the **amount you actually paid in the
> currency you paid it in**, and put the USD equivalent in brackets so the totals still
> reconcile — e.g. `₩229,000 ($165)`.

---

## How to use this log

Each line item moves through three states. **Edit the tables below as it happens** — the columns are
the record, and a script reads them.

```bash
python3 scripts/order_status.py
```

Either edit the tables directly, or let the script do it — it writes the same cells and cannot
shift a column:

```bash
# ordered 3 vehicles, charged ₩687,000        (--date defaults to today)
python3 scripts/order_status.py --order 1 --paid 687000

# the boxes arrived
python3 scripts/order_status.py --arrive 1 --date 2026-10-05

# opened them, ran the Verify check, all three are good
python3 scripts/order_status.py --secure 1 --count 3
```

| When | Do this |
|---|---|
| You place an order | `--order <#> --paid <KRW>` |
| The box arrives | `--arrive <#>` |
| You have opened it and **run the check in the Verify column** | `--secure <#> --count <n>` |

It refuses to secure more units than were ordered, rejects a date that is not `YYYY-MM-DD`, and
errors on a line item that does not exist. Partial deliveries are expected — `--secure 1 --count 2`
today and `--count 3` next week is the normal path.

`order_status.py` totals what has been paid, projects the rest, compares both against the approved
request, and lists two things you cannot see by eye: what was **ordered and has not arrived**, and
what **arrived but is not yet secured**. Record each unit individually where it matters — three
vehicles arriving on three different days is the normal case, not an exception.

---

## Status at a glance

**Approved 2026-09-28** — see [Purchase Request](purchase-request-2026-fall.md). **3 sets.**
Run `python3 scripts/order_status.py` for the live totals and what is outstanding.

| Batch | Card | What | Per set | × 3 sets |
|---|---|---|---:|---:|
| **1** | **A** | Tier 1, orderable now — 12 items | 973,930 | **2,921,790** |
| **1G** | **A** | Tier 1, gated on vehicle measurements — #4, #5, #13 | 95,000 | **285,000** |
| **2** | **B** | Tier 2 perception — #17, #18 | 82,800 | **248,400** |
| — | — | #16 2D LiDAR — **already in hand, not purchased** | 0 | **0** |
| | | **Total to pay** | **1,151,730** | **₩3,455,190** |

> [!TIP]
> **The LiDAR already being in hand fixes the headroom problem**
>
> The approved request assumed #16 would be bought: 3 × ₩155,430 = **₩466,290**. It is already
> held, so that money is never spent.
>
> Headroom against the ₩4,000,000 ceiling therefore goes from **₩78,520 (2.0%)** to
> **₩544,810 (13.6%)**. The warning attached to the approval — that a 10% overrun on the
> estimated items would breach the ceiling — no longer applies. There is now room for the
> estimated items to land high, for shipping and duties, and for a stripped gear.
>
> **This does not authorise spending it.** It is contingency, and the approved figure is still
> ₩3,921,480.

### The three states, and why "arrived" is not enough

> [!NOTE]
> **A fourth marker: `—` in the Secured column means *not an acquisition***
>
> Two rows are not things anyone receives in a box. The [Shipping row](#L900) is a running cost, and
> [#4](#L4) is a **contingency** — funded so the option exists, bought only if a named gate fails.
> Left as `0/3`, both read as three unverified units sitting on a shelf, which is wrong in both
> directions: nothing is on order and nothing is expected to be. **`—` says the three states do
> not apply to this row**, and the tooling skips it rather than nagging about it.
> **A contingency still carries its price estimate** — counting it as zero would understate the
> projection, which is the one failure `order_status.py` exists to prevent.

| State | Means | Recorded as |
|---|---|---|
| **Ordered** (주문) | Paid for, vendor has the order | date in `Ordered` |
| **Arrived** (도착) | The box is physically here | date in `Arrived` |
| **Secured** (확보) | Opened, **checked against the Verify column**, and it is the right part in the right quantity | `n/3` |

Arrival is not acquisition. The listing this project's sourcing started from carries a
**2x25 SKU on a 2x32 description** — if the wrong board ships, the box still arrives on time. The
`Secured` count is what separates "a package came" from "I have three working parts", and it is a
**count**, not a tick, because a partial delivery is the normal case.

### The `Row` column is not an issue number, and not a part number either

> [!WARNING]
> **`#122` is not GitHub issue 122.** This repository has two issues, both closed since
> 2026-08-08. Until 2026-11-05 the first column of these tables was headed `#`, so a reference to
> row 122 was naturally written `#122` — which is GitHub's syntax for an issue, and in the commit
> view GitHub renders it as one. **It pointed at nothing, and it still will in commits already
> pushed.**
>
> **`Row` is a sort key.** It groups a BOM item with its sub-letters so the table stays in order:
>
> | Row | Part |
> |---:|---|
> | 80 · 81 | `#8a` · `#8b` |
> | 110 · 111 · 112 | `#11a` · `#11b` · `#11c` |
> | **113** | **`#11b` again** — the spares re-order, a second row for the same part |
> | 121 · 122 | `#12 top-up` · `#12b` |
>
> So row `122` is the key for part `#12b`, and **searching the repository for "122" finds the part
> nowhere.** Row `113` is worse: it is a *different row* for the *same part* as `111`.
>
> **The rules, now that the links are real:**
>
> - **Prose and link text name the PART** — `#12b`, `#11b spares` — never the row key.
> - **Links carry the row** — `[#12b](#L122)`, resolving to an `<a id="L122">` in the Item cell.
>   Every row has one; `check_anchors.py` fails the build if a target goes missing.
> - **Commit messages write `item 12b`, not `#12b`.** A bare `#` plus digits is an issue
>   reference in a commit, so `#12b` offers GitHub `#12` and `#7`, `#14`, `#15` are offered whole.
> - **The row key never leaves this file.** It is an index into a table, not a name for anything.

---

## Batch 1 — Tier 1, card A, order now

Nothing here waits on a measurement. **Order the vehicle first regardless** — Batch 1G cannot be
specified until it arrives, so it is the long pole.

Prices are the verified figures from
[§1.2.1](build/01-bom-sourcing.md#121-sourcing-in-korea-verified-2026-09-15). Record what you
*actually* paid in `Paid ₩` — that is the column the reconciliation uses.

| Row | Item | Qty | Vendor | Unit ₩ | Ordered | Arrived | Secured | Paid ₩ | Verify on arrival |
|---|---|----:|---|---:|:---:|:---:|:---:|---:|---|
| 1 | Vehicle — 12 V single-seat ride-on | 3 | 쿠팡 | 229,000 | 2026-09-29 | 2026-09-30 | 3/3 | 687,000 | Record model + serial per unit. **Stock steering gearmotor present** — see V1 **Maker's spec sheet, recorded 2026-10-13:** 12 V **dual** motor · traction pack **12 V 4.5 Ah** with a 12 V charger · kerb weight **11 kg**, max load **25 kg** · runtime **1–2 h** · 3-step speed · 과전류 방지장치 (the stock 10 A fuse) · 98 × 56 × 47 cm. **The 4.5 Ah and the 1–2 h together put the toy's average draw at 2–4 A**, which is what the stock 10 A fuse is sized for and leaves the motor driver's 32 A/channel generous. It says nothing about **stall**, which is still unmeasured.|
| 2 | Teensy 4.1 **[이더넷] DEV-16771** | 3 | 디바이스마트 | 74,250 | 2026-09-29 | 2026-10-08 | 3/3 | 222,750 | ₩67,500 ex-VAT → **₩74,250 incl**. **4.1, not 4.0** — count the pins **Secured 2026-10-08:** confirmed **4.1**, not 4.0. **The `VUSB`–`VIN` pads are still joined from the factory on all three** — cut them before Stage 0, or an externally powered board back-feeds the laptop's USB port. That is a build step, not a receiving one. |
| 3 | **Cytron SmartDriveDuo-30 (MDDS30)** — M1 steering, M2 drive *(replaces Sabertooth 2x32)* | **4** | [디바이스마트 13186549](https://www.devicemart.co.kr/goods/view?no=13186549) 해외구매 | 143,440 | 2026-09-29 | 2026-10-08 | 4/4 | 573,760 | ₩130,400 ex-VAT → **₩143,440 incl**. **4 units — 3 + 1 spare.** **`SW1:SW2=00` RC · `SW3:SW4=11` independent · `SW6=0` timeout ON** — verify SW6 on every board; `SW6=1` disables the stop **Secured 2026-10-08:** genuinely `MDDS30`, not a relabelled 2x25/2x32, and **every switch OFF as shipped** — so `SW1:SW2=00` and `SW6=0` are already right. **`SW3` and `SW4` must be turned ON** before use; that is a build step, not a receiving one. Re-confirm `SW6` board-by-board as each is fitted. |
| 7 | Relay MUX — 4× SPDT **70 A** + `IRLZ44N` + passives | 3 | [디바이스마트 14822426](https://www.devicemart.co.kr/goods/view?no=14822426) · 쿠팡 | 57,300 | 2026-10-01 | 2026-10-02 | 3/3 | 171,900 | **12× 5핀 SPDT 80 A @₩12,100** (socket incl.) = 145,200. Bulk, shared across all three: [`IRLZ44N` ×5](https://www.coupang.com/vp/products/9570142606?vendorItemId=95507737241) ₩9,100 · [resistor kit 30 values ×600](https://www.coupang.com/vp/products/9515705626?vendorItemId=95313302183) ₩9,900 · [`1N4007` ×200](https://www.coupang.com/vp/products/8583456225?vendorItemId=91607125807) ₩7,700 = 26,700. **10 kΩ gate pulldown + 100 Ω series** come out of the kit. **Arrived 2026-10-02: the three Coupang bulk items only** — `IRLZ44N`, resistor kit, `1N4007`. The **12 relays + sockets from 디바이스마트 are still outstanding**, which is why this is not secured. *(A 2026-10-08 edit briefly recorded this parcel as lost and the row as nothing-in-hand. It was not lost; the entry was reverted the same day. Nothing was re-ordered and no money moved.)* On arrival check the relay **blade width** against the socket, and that the coil is **12 V, 80 Ω** **2026-10-20: the missing 디바이스마트 half is dispatched, and it is sharing a parcel with [#8a](#L80).** 롯데택배 `317139414550` carries **12/12 of the 80 A 5-pin** for this row and **3/3 of the 40 A 4-pin** for #8a. **This row and #8a therefore arrive together and should be checked together.** **2026-10-20 — the Coupang half checks out: the resistor kit does contain 10 kΩ and 100 Ω.** That was the real risk in this row, because the design pulls the **gate pulldown (10 k)** and the **series resistor (100 Ω)** straight out of a *"30 values"* assortment that had no obligation to carry either. It does, so nothing has to be ordered before the relays land. **Still 0/3: the twelve relays are in transit on `317139414550` with [#8a](#L80), and this row secures when that parcel is checked.** **ARRIVED 2026-10-20 — the shared waybill landed and it closes both halves.** `317139414550` carried [#7](#L7)'s twelve 80 A 5-pin and [#8a](#L80)'s three 40 A 4-pin together, as the dispatch detail said it would. **Freight ₩3,200, 착불 — and paid personally, not on the project card.** *Recorded in the [Shipping row](#L900) as incurred but excluded from the paid total, so both figures stay true: the total is what the card paid, and the note is what the parcel actually cost.* **Not secured. Three checks, and the third is the one nobody has named.** **(1) Read the ratings off the RELAY BODY, not the listing.** Contact rating and **coil voltage (must be 12 V)**. This project has been bitten by a listing title twice — a 2x25 SKU on a 2x32 page, and an M3 × 8 that said nothing about its point. **(2) Confirm the pin numbers are moulded on**: `30 · 87 · 85 · 86` on the 4-pin, plus `87a` on the 5-pin. [§3.4](build/03-electrical.md) wires by those numbers. **(3) GAUGE THE PIGTAILS.** These are 방수 relays supplied with wired sockets, and **a socket's wire is often far thinner than its contacts are rated for.** The traction path is **AWG 14 behind a 25 A fuse**; if the pigtail is 16 or 18 AWG then **the bottleneck is the wire, not the 80 A contact**, and the fuse that protects the branch no longer protects the weakest part of it. Measure or read the insulation print, and if it is thin, **cut the pigtail short and splice to AWG 14 at the first joint.** **SECURED 2026-10-26 — and the body settles a question three listings could not.** Marked **`KKA B8 · COIL:12VDC · 70A/14VDC · 40A/28VDC · 0121Z23`**, with `30 · 87 · 87a · 85 · 86` moulded on. **So it is 70 A, not the 80 A in the title and not the 40 A in the shared boilerplate** — *neither number on the page was right, and it halves at 28 V, which is why a single figure was never going to settle it.* **[§1.2.4](build/01-bom-sourcing.md#7-8-11-12-14-what-to-actually-buy) parked this as unanswerable from any listing; one photograph of the moulding answered it. Read the part, not the page.** **The design is unaffected:** 70 A inductive-derated is **35–42 A against the 20 A drive-channel limit, 1.75–2.1×**. The row title and the derate table are corrected to 70 A. **Pigtails are `RV-90` with the contact wires (blue / red / yellow) visibly heavier than the coil pair** — the right arrangement, and the opposite of [#8a](#L80). | **12× 5핀 SPDT 80 A @₩12,100** (socket incl.) = 145,200. Bulk, shared across all three: [`IRLZ44N` ×5](https://www.coupang.com/vp/products/9570142606?vendorItemId=95507737241) ₩9,100 · [resistor kit 30 values ×600](https://www.coupang.com/vp/products/9515705626?vendorItemId=95313302183) ₩9,900 · [`1N4007` ×200](https://www.coupang.com/vp/products/8583456225?vendorItemId=91607125807) ₩7,700 = 26,700. **10 kΩ gate pulldown + 100 Ω series** come out of the kit. **NOTHING FROM #7 IS IN HAND.** *Corrected 2026-10-08.* This row recorded an arrival on 2026-10-02 that did not happen: the Coupang parcel — `IRLZ44N`, resistor kit, `1N4007` — was **marked delivered and never received**, ₩26,700 of it, and is being **re-ordered**. The **12 relays + sockets from 디바이스마트 are still outstanding** on their own account. **The ₩26,700 is still carried as paid once**; if the lost parcel is refunded this stays right, and if it is not, the re-order adds ₩26,700 to the projected total against ₩398,424 of headroom. Record which when it settles. On relay arrival check the **blade width** against the socket, and that the coil is **12 V, 80 Ω** **2026-10-28 — the claim this row makes about §3.4 was not true until today.** Two arrival checks were justified by *"[§3.4](build/03-electrical.md) wires by those numbers"* — and **§3.4 contained none of `30 · 87 · 87a · 85 · 86`.** *The check was real and the page it pointed at could not consume the result.* [§3.4](build/03-electrical.md#34-wire-the-e-stop-and-mux-first) now carries a per-relay contact table keyed to the moulded numbers, so the twelve relays have an **assignment** rather than a count: **`K1`/`K2` = steering tap leads A/B, `K3`/`K4` = throttle tap leads A/B**, coil convention **`86` = feed, `85` = drain** held across all twelve so no `1N4007` ends up reversed. **One check lands here from writing that table: ring out which pigtail colour reaches which contact.** The `RV-90` socket puts the heavy wire on the contacts — correct — but the colour-to-pin mapping is the socket maker's choice, and this row recorded the gauge without recording the mapping.|
| 80 | **#8a** E-stop contactor — 4핀 SPST-NO 40 A | 3 | [디바이스마트 14822420](https://www.devicemart.co.kr/goods/view?no=14822420) | 11,000 | 2026-10-01 | 2026-10-20 | 3/3 | 33,000 | Bracket + socket incl. Wired `30→87`, `87a` n/a. **Spec:** [§1.2.4](build/01-bom-sourcing.md#7-8-11-12-14-what-to-actually-buy) **IDENTIFIED 2026-10-20 — and it is NOT a separate late shipment.** The 디바이스마트 발송내역 shows **`KKA-B4 방수 릴레이 12V 40A 4핀 [TYE-RL076]`, 3 of 3 dispatched** — that is this row — on the **same 롯데택배 waybill `317139414550`** as **`…80A 5핀 [TYE-RL082]`, 12 of 12**, which is [#7](#L7)'s relays. **One parcel carries both lines.** So the previous entry calling #8a *"the oldest outstanding line"* was reading two rows where there is one shipment: #7's 디바이스마트 half has been missing for exactly as long, for exactly the same reason, and **both arrive the moment that waybill lands.** *The log's per-line structure hid that, which is worth noting — a line item is not a parcel, and chasing #8a alone would have been chasing half a box.* **Quantities are right on both: 발송 = 주문.** The part is a 4-pin automotive relay — pins `30 · 87 · 85 · 86`, SPST-NO — which is the specified form; #7's 5-pin carries the extra `87a`. **The waybill is 선/착불, so there may be freight due on arrival** — check it and add it to the [Shipping row](#L900) rather than letting it vanish into a courier receipt. **ARRIVED 2026-10-20 — the shared waybill landed and it closes both halves.** `317139414550` carried [#7](#L7)'s twelve 80 A 5-pin and [#8a](#L80)'s three 40 A 4-pin together, as the dispatch detail said it would. **Freight ₩3,200, 착불 — and paid personally, not on the project card.** *Recorded in the [Shipping row](#L900) as incurred but excluded from the paid total, so both figures stay true: the total is what the card paid, and the note is what the parcel actually cost.* **Not secured. Three checks, and the third is the one nobody has named.** **(1) Read the ratings off the RELAY BODY, not the listing.** Contact rating and **coil voltage (must be 12 V)**. This project has been bitten by a listing title twice — a 2x25 SKU on a 2x32 page, and an M3 × 8 that said nothing about its point. **(2) Confirm the pin numbers are moulded on**: `30 · 87 · 85 · 86` on the 4-pin, plus `87a` on the 5-pin. [§3.4](build/03-electrical.md) wires by those numbers. **(3) GAUGE THE PIGTAILS.** These are 방수 relays supplied with wired sockets, and **a socket's wire is often far thinner than its contacts are rated for.** The traction path is **AWG 14 behind a 25 A fuse**; if the pigtail is 16 or 18 AWG then **the bottleneck is the wire, not the 80 A contact**, and the fuse that protects the branch no longer protects the weakest part of it. Measure or read the insulation print, and if it is thin, **cut the pigtail short and splice to AWG 14 at the first joint.** **SECURED 2026-10-26 — the delivered part is exactly what was ordered.** Marked **`KKA V4 · 012-1H-12 · NO 40A 14VDC`** with `30 · 87` and the coil across `85 · 86` moulded on; `012` is the 12 V coil and `1H` is form A, SPST-NO. The listing's description was right about this one. **The resistive-break argument in [§1.2.4](build/01-bom-sourcing.md#7-8-11-12-14-what-to-actually-buy) stands**: this contact sits in **B+ upstream of the H-bridge**, so the motor's stored energy is on the far side of the bridge and the break is essentially resistive — 40 A against a 20 A limit is a straight 2×. **BUT ITS PIGTAIL IS NOT, AND THAT IS NOW THE LIMIT ON THIS ROW.** The 4-pin harness is **0.75 mm², which is about AWG 18** — good for perhaps 5–10 A in a chassis loom. **It is sitting in a branch fused at 25 A behind AWG 14.** The relay is rated 40 A and its own wire is not rated for a quarter of that; *the weakest part of the branch would be a wire the fuse was never sized to protect.* **Fix before fitting: re-terminate `30` and `87` in AWG 14** — a 6.3 mm blade crimp takes 2.5 mm² — **or, if the terminals will not accept it, cut the 0.75 mm² back to the shortest stub that can be crimped and splice there.** *Note the contrast with [#7](#L7), whose `RV-90` harness puts heavy wire on the contacts and thin wire on the coil. Same seller, same family, opposite decision — which is why the check is per-part and not per-vendor.* |
| 81 | **#8b** E-stop button — 한국미스미 `MRE-RR2R` | 3 | [한국미스미 MRE-RR2R](https://kr.misumi-ec.com/vona2/detail/222005924703/?ProductCode=MRE-RR2R) | 11,924 | 2026-10-01 | 2026-10-20 | 3/3 | 35,772 | Ø22, **푸시 록 턴 리셋**, **2a2b**, 적색, IP65, snap-action. The third code character must be **`2`** — `1` is 1a1b and carries only one NC. **Verify on arrival: the two b접점 sit on *different* stacked blocks**, one each **ARRIVED 2026-10-20 — three units, nineteen days.** Body marking reads **`MRE-RR2R`**, which is the part ordered: **the `2` is the whole point** — `MRE-RR1R` is 1a1b and carries only one NC. **Not yet secured, and this is the highest-consequence check in the build.** The contact blocks arrived as **loose stacked units rather than pre-assembled**, which turns the verification into an **assembly decision**: *you choose which contact sits on which block.* **Put the two NC (b접점) on DIFFERENT blocks, one each — never both on the same one.** The E-stop's two NC contacts are what break the two motor conductors ([safety.md §2](design/safety.md#2-failsafe-matrix)); with both on one block, a single loose terminal screw or one cracked block takes out **both** breaks at once — a common-cause failure in the one device whose entire job is to not have one. Split across blocks, a block failure still leaves one conductor broken. **Then ring out every contact with a meter before fitting**, pressed and released, and confirm the NC pair opens on press. *Marking says 2a2b; a meter says 2a2b.* **#8a, the contactor, is now the oldest outstanding line** — ordered the same day and still not here. **SECURED 2026-10-20 — continuity and latching both confirmed.** 2a2b present, contacts transition cleanly pressed and released, and the push-lock / turn-reset latch holds. **The block-split rule moved to where it will actually be read:** the blocks arrive loose, so *which NC sits on which block* is decided at **wiring** time, weeks after this check — it is now a warning in [§3.4](build/03-electrical.md#34-wire-the-e-stop-and-mux-first) rather than buried in an arrival note nobody opens twice. *An arrival check cannot verify an assembly that has not happened yet; recording it as though it could would have been the quiet kind of wrong.* **OPEN QUESTION RAISED 2026-10-27 while drawing the E-stop wiring: the two NO contacts have no job, and because of that the firmware is blind to the E-stop.** This button is **2a2b** and the design uses only the **2b** — one NC to the contactor coil, one to the relay MUX coils. *Nothing tells the Teensy the button has been pressed.* It sees its outputs stop having any effect and **cannot say why**, so neither can the laptop, the log, or a student. **Proposal: `NO ①` → a Teensy input**, 3.3 V through the contact and pulled down at the pin; pressed reads high. One wire, one GPIO, and the firmware can **latch into `ESTOP` deliberately and publish it** instead of fighting a loop it cannot win. **It is a diagnostic and must never become a safety function** — the safety is the NC contacts and the coils, which work with the Teensy dead; *a sensed input that gets relied on is how a hardware interlock quietly becomes a software one.* **Decide before [§3.4](build/03-electrical.md#34-wire-the-e-stop-and-mux-first) is built**, because it is a wire that has to be in the loom from the start. `NO ②` stays spare. **RESOLVED 2026-10-28 — adopted, but NOT the way this row proposed yesterday.** Checking why the firmware should care turned up that **[dbw.md §10.3](design/dbw.md#103-safety-state-machine) has required it since the state machine was written**: `E-stop` is a transition *into* `ESTOP` and `E-stop released + RC arm` is the only way *out*. **Two arcs of a published state machine were unimplementable and nobody noticed.** *So this was never a nice-to-have diagnostic — it was a missing wire.* **And the NO-contact scheme is withdrawn as the worse of the two.** With a NO contact an **open circuit reads "not pressed"**, so a broken sense wire would silently restore the instant-resume behaviour the input exists to prevent. **Taken instead: a divider tapped off the COIL SUPPLY** — 10 k / 2.7 k into a digital input, high while the chain is energised. **Pressed, broken wire, pulled connector, blown coil fuse and a dead logic pack all read low**, which is the conservative direction, and it senses *whether authority is energised* rather than whether a finger is on the button. **Costs two resistors and no contact, so BOTH NO contacts stay spare.** *The concrete failure it prevents: both coils run through the NC contacts, so turning the button to reset re-energises both at once — while the Teensy, which never noticed, is still commanding and has been winding up its integrator against a wheel that could not move.* |
| 9 | Pololu #2806 RC servo MUX | 3 | 디바이스마트 | 31,680 | 2026-09-29 | 2026-10-08 | 3/3 | 95,040 | ₩28,800 ex-VAT → **₩31,680 incl**. `FAILMODE` jumper present **Secured 2026-10-08:** `FAILMODE` jumper present. |
| 10 | RC TX/RX — FS-i6 transmitter + **FS-iA6B** receiver | 3 | [팰콘샵 100004832](https://www.falconshop.co.kr/shop/goods/goods_view.php?goodsno=100004832) KC인증 | 139,160 | 2026-09-29 | 2026-10-01 | 3/3 | 417,480 | ₩142,000 list, **₩417,480 paid for 3** (≈2% off). **Receiver confirmed iA6B on 2026-10-01** — i-BUS port present on the board, all 3 sets. **Mode 2** — see the note below |
| 110 | **#11a** Logic battery + charger | 3 | [디바이스마트 16071444](https://www.devicemart.co.kr/goods/view?no=16071444) · [16071454](https://www.devicemart.co.kr/goods/view?no=16071454) | 66,000 | 2026-10-02 | 2026-10-07 | 3/3 | 198,000 | SantaLi `SLB1206` 12.8 V 6 Ah LiFePO₄ **₩50,160** + `SLC 1202` 14.6 V 2 A **₩15,840**, both **VAT added — the listing quoted ₩45,600 / ₩14,400 ex-VAT**. 740 g; BMS integral (OCP 60 A, UVD 9.2 V). **Firmware UV threshold 11.5 V.** The maker pairs `1202` with 6–12 Ah, `1204` with 12–18 Ah **Secured 2026-10-08:** pack reads LiFePO₄ **12.8 V 6 Ah**, matching `SLB1206`. Check the charger label reads `SLC 1202` 14.6 V 2 A and say so if it does not — the 4 A `SLC 1204` was deliberately not chosen. |
| 111 | **#11b** UBEC 5 V 3 A ×2/set | 3 | [디바이스마트 1078321](https://www.devicemart.co.kr/goods/view?no=1078321) | 23,518 | 2026-10-02 | 2026-10-08 | 3/3 | 70,554 | **6 units @ ₩10,690 ex-VAT = ₩64,140 → ₩70,554 incl.** Input **7–40 V**, chosen over `ada-1385` (6–16 V), which sits at 91 % of rating while the pack charges at 14.6 V. **Confirm the 5 V output is fixed** — some UBECs carry a 5 V / 6 V jumper **The specified UBEC is what arrived** (7–40 V in, 5 V 3 A continuous, 18 g). **Its PCB is silkscreened `LM2596 DC-DC  HW-411`, and that is the regulator CHIP, not a different module** — this UBEC is built around an LM2596, as most 7–40 V ones are. *A 2026-10-08 entry read that marking as a substitution by a generic LM2596 board and recorded one; it was withdrawn the same day. Nothing was substituted and nothing else is in stock.* **Inventory: 6 UBECs**, 2 per vehicle across three and **zero spares** — the only Batch 1 line carrying none, and the one component a student sets by hand before anything downstream of it survives. Buy two spares. **Not secured until the output is measured:** the board carries a small trimmer, so confirm **5 V** on the pack alone before any Teensy is connected, re-check at 14.6 V with the charger on, lock the trimmer, and record the measured volts per unit here. Wiring: input is **bare red/black leads** needing termination at the pack; output is a **servo plug** — one goes straight into the RC receiver, the other gets adapted to the Teensy's `VIN`/`GND`. The board marks `IN+`, `OUT+`, `OUT-` and an arrow for flow direction. **SECURED 2026-10-20 — 5.11 V out from the 12 V LiFePO₄ pack.** Inside the 5.0 ± 0.15 V band, and comfortably inside every load on the rail: the **Teensy 4.1 VIN takes 3.6–5.5 V**, the Pololu MUX and the receiver both more. **No unit was found set to 6 V**, which was the destructive case this check existed for. *A buck converter sits slightly high unloaded and settles under load, so 5.11 no-load is the expected shape rather than a drift.* **The log carries one figure for six units** — if a second board ever reads differently, this is the line that did not record the spread. **Still buy two spares:** six fitted across three vehicles with none in reserve, on the one component a student sets by hand before anything downstream survives. |
| 112 | **#11c** Hold-up + fuse — **closed, absorbed into #12** | 3 | 쿠팡 | 0 | 2026-10-02 | 2026-10-03 | 3/3 | 0 | **₩0 by construction, not by cancellation.** The 1000 µF 25 V capacitors and the 5 A fuses were bought on the #12 Coupang order and are counted there. Splitting the receipt to populate this row would make the log disagree with the invoice. Divider resistors come from the #7 kit **Secured 2026-10-08:** capacitors read **1000 µF 25 V**, which is the part the corrected spec asks for — a 16 V part sits at 91 % while the pack charges at 14.6 V. | **Capacitors arrived 2026-10-03** on the #12 shipment, as designed.|
| 900 | **Shipping** — running total, not per set | 1 | — | 45,700 | 2026-10-02 | . | — | 45,700 | Battery ₩3,500 · charger ₩3,500 · UBEC ₩4,400 *(flat, any quantity)*. **+₩2,700 on 2026-11-07** — the #12c/#12d 디바이스마트 order. **+₩3,000 on 2026-11-07** — the #12 top-up 쿠팡 fuse order; [#12e](#L125) shipped free and adds nothing. **#12's ₩3,000 was refunded with a cancelled line**, so that order carries none. Kept off the part rows so `paid = unit × qty` stays a meaningful check — folding carriage in would make it misfire on every shipped row and train the reader to ignore the one thing that has caught two VAT errors. **Closed 2026-10-02: the earlier 디바이스마트 orders show ₩0 carriage**, so nothing is missing from before. UBEC carriage to be re-confirmed from the final charge **+₩2,700 on 2026-10-12** — the #6a Hall-latch order. **+₩6,000 on 2026-10-13** — the #14/#6d 쿠팡 order. **+₩3,000 on 2026-10-19** — the #5 AS5600 쿠팡 order. **+₩6,000 on 2026-10-20** — the #14b mast order (₩3,000 to the profile seller, ₩3,000 to the bracket seller; the T-nut set was 판매자로켓 무료배송). **The plywood is 착불 and is NOT in this figure yet** — add it when the parcel lands. **2026-10-20: ₩3,200 착불 on the #7/#8a parcel — PAID PERSONALLY, not on the project card, so it is NOT in the figure above.** Recorded here anyway: the total has to stay what the card paid, but **the next cohort budgeting carriage needs the real number**, and a cost that was absorbed quietly is a cost that gets under-budgeted next time. **True carriage to date is ₩32,300.** The plywood's 착불 is still outstanding. **+₩3,000 on 2026-10-26** — the 사각너트 order; the M5 × 20 bolts shipped free. **The plywood's 착불 is still the one carriage figure missing from this row.** **+₩4,400 on 2026-10-27** — the #12b 디바이스마트 order. **+₩3,500 on 2026-10-26 — the penny-washer order `2103864346113`** (goods ₩3,600, carriage ₩3,500: *the delivery cost almost as much as the washers, which is the per-order carriage tax this project pays for buying fasteners one line at a time*). **₩36,500 → ₩40,000.** **AND THE PLYWOOD 착불 IS CLOSED, 2026-11-04: it was never 착불.** 쿠팡 receipt `2103729946920` shows **배송비 합계 ₩0** on the ₩23,060 자작나무합판. This row has carried *“the plywood's 착불 is still the one carriage figure missing”* for two weeks against an order that had no freight on it. *The honest limit of that proof: 착불 is collected at the door and never reaches a 쿠팡 receipt, so this shows the ORDER was free-shipped, not that nobody paid a courier. Nothing is outstanding on paper; if cash changed hands at the door it is still unrecorded and belongs here.* **The ₩32,300 “true carriage to date” above is stale** — it was written when the card figure was ₩29,100. **True carriage is now ₩43,200: ₩40,000 on the card plus the ₩3,200 착불 on the #7/#8a parcel that was paid personally.** |
| 12 | Wiring / connectors / fuses | 3 | 쿠팡 | 63,180 | 2026-10-02 | 2026-10-07 | 3/3 | 189,540 | **AWG 14 silicone red+black 10 m each** · AWG 20 UL1007 ×2 (32 m, 4-colour) · AWG 22 UL1015 ×3 · **ATO 대형 10종 50개** · **12 AWG holder ×8 + 12 fuses** · **18 AWG holder ×3** · **1000 µF 25 V ×10** · **XT60 ×10 pairs**. ₩205,820 less a ₩15,800 discount, **less ₩480 for 12× MINI 5 A fuses cancelled 2026-10-02** — ordered in error, they are MINI size and these holders are standard. **The ₩3,000 carriage was refunded with them**, so this order carries none. **Confirm the 10종 set includes 5 A** — with the MINI pack gone there is no fallback **Secured 2026-10-08:** wire lengths and colours all sufficient, and the **ATO 10종 set contains 5 × 5 A** — which closes the open question, because the MINI pack was cancelled and there was no other way to fuse the logic rail. **Three are fitted, so two spares across three vehicles for a whole semester.** Fuses are consumables and a blown one with no replacement stops a lab: top up the 5 A separately. | **Arrived in two parts:** fuse holders, AWG 14, AWG 22, XT60 pairs and the capacitors on **2026-10-03**; AWG 20 and the ATO fuse set on **2026-10-07**. Counts match the order on both.|
| 122 | **#12b** Electronics assembly consumables — perfboard, terminals, headers | 3 | [디바이스마트](https://www.devicemart.co.kr/) | 44,300 | 2026-10-27 | 2026-11-04 | 0/3 | 132,899 | **Opened 2026-10-26, and the gap is a process one rather than an oversight.** [§1.2.4](build/01-bom-sourcing.md#7-8-11-12-14-what-to-actually-buy) has specified **perfboard (만능기판), 5 mm screw terminal blocks and a printed enclosure** for the relay-driver board since it was written. **[#7](#L7) bought relays, MOSFETs, resistors and diodes and stopped there.** *The parts were specified in one document and procured in neither, which is exactly the seam the "every part is bought" claim fell through two entries ago.* **What this line buys:** **만능기판 ×6+** (two boards per vehicle — signal in the logic box, relay driver in the power box) · **screw terminal blocks, 5 mm, 2- and 3-way, ~8 per vehicle** · **female headers 2.54 mm, two 24-way rows per Teensy** — *the Teensy must be socketed, not soldered: thirteen students, one bricked bootloader, ₩74,250 a board* · **a solderless breadboard and jumper set** for the bench, which no document had ever asked for because [§1.2.4](build/01-bom-sourcing.md#7-8-11-12-14-what-to-actually-buy) only ever warned against breadboard **on the vehicle** · **heatshrink**, which the [#8a](#L80) pigtail splice needs and nothing bought · **1 nF ceramics** and **4.7 kΩ** if the 30-value kit turns out not to carry them. **Nothing here is expensive and all of it stops work on the day it is missed.** Sourcing still to do. **SOURCED 2026-10-26 — one 디바이스마트 order, and that is the recommendation as much as any SKU is.** *Six Coupang sellers would mean six carriages on ₩50,000 of goods; 디바이스마트 carries every line here, and [#6a](#L60) already proved the route — ₩2,700 domestic carriage, no fees.* **Confirmed on their shelf:** **만능기판 — 거상인 `[GA2] 80 × 80 양면` ₩4,300** for the signal board *(a Teensy 4.1 is 61 mm long, so 50 × 80 is tight once terminals are on)* and **`[GA6] 50 × 80 양면` ₩3,500** for the relay driver, which carries one MOSFET, two resistors and four diodes. **Four of each** — three fitted, one spare, because a perfboard is the part a student ruins. **Terminal blocks — EM Tech `2EDGK+2EDGRC-5.08`, 2-pin ₩600 and 3-pin ₩900, sold in tens.** *These are PLUGGABLE (plug + header), not plain screw blocks, which is strictly better here: the whole harness unplugs, so a sensor or a box comes out without a screwdriver inside the bay.* **Confirm whether the price is per piece or per ten before ordering.** **Search terms for the rest, all on the same site:** `핀소켓` or `암핀헤더` 2.54 mm *(two 24-way rows per Teensy — socketed, never soldered)* · `브레드보드` + `점퍼케이블 세트` *(bench only)* · `열수축튜브 세트` · `세라믹 콘덴서 1nF` · `저항 4.7k`, the last two **only if the 30-value kit turns out not to carry them — check first.** **QUOTE REVIEWED 2026-10-27 (₩111,080 incl VAT, carriage ₩4,400).** Boards, terminals and breadboards all correct. **Three lines are missing and all three were the open questions.** **(1) Teensy sockets — take `핀헤더소켓 Single 1x40 Straight (2.54mm)`, CONNFLY, ₩530.** A Teensy 4.1 has **24 pins per side**, so one 1×40 strip cuts to one row with 16 spare; **two strips per Teensy, eight for the fleet.** *Not the `적층형` at ₩1,000 — its 9.1 mm legs are for stacking shields, and the extra height only raises the board in the box.* **(2) Heatshrink — the sizing question is right and it decides the SKU.** The [#8a](#L80) splice joins **0.75 mm² (OD ~2.5 mm) to AWG 14 silicone (OD ~4 mm)**, so the tube must shrink from **≥ 6 mm down to under 2.5 mm** — a 2:1 at Ø6 just covers it and a 3:1 is comfortable. **`NT-DIY 열수축튜브 328세트` ₩3,900 — 8 sizes, which brackets that range.** *Its pieces are pre-cut to 40 mm, which is fine for a butt splice and no use as a long sleeve; nothing on this build needs a long sleeve.* **(3) 1 nF — the chip parts in the search results are SMD and unusable on perfboard.** Take through-hole: **`DONGIL HV(E) Ceramic 1000pF` ₩40 per 10** (1000 pF *is* 1 nF). *Its AC250V rating and ±20/−55 % Y5U tolerance are both irrelevant here — this is a noise filter, and anything from 0.5 to 1.5 nF does the same job.* **4.7 kΩ confirmed present in the 30-value kit, so nothing to buy.** **One quantity to check: terminal blocks.** The quote reads 수량 10 × 단가 600, but the listing says *10개 단위 판매* — **if that 10 is ten pieces rather than ten packs, 20 blocks is short of the ~24 the fleet needs** (two sensor runs and a power feed per signal board; gate, 12 V, GND and four coil pairs per relay board). **TERMINAL COUNT REDONE 2026-10-27 — my "~8 per vehicle" was a guess and it was low, and the MIX was wrong too.** Counting **ways** rather than blocks: signal board **5 × 2-pin** (two 4-wire sensor cables at two blocks each, plus 5 V in), relay board **6 × 2-pin** (gate, 12 V, and a pair to each of four coils) = **11 × 2-pin per vehicle, 33 for the fleet.** **And the 3-pin turns out to be the less useful of the two.** *Both sensor cables carry FOUR conductors and four does not fit a 3-way, so they take two 2-pins each. The runs that genuinely carry three wires — PWM out and i-BUS — are servo connectors and belong on pin headers, which is what the receiver and the Pololu MUX already expect.* **Change the 2-pin from 10 to 30; leave the 3-pin at 10.** +₩12,000. **Buy past the count rather than to it, and the reason is specific: this is the LAST order on the build.** Being four blocks short in week six is ₩3,000 of parts, ₩3,000 of carriage and a week of thirteen students waiting. **Breadboards: 6 is right, and 9 is better — but none of them is per-vehicle.** *They never go on a vehicle; the count is per BENCH STATION.* **Two per station: one at the Teensy end** (board, pull-ups, caps) **and one at the sensor end**, so magnets can be waved past the Hall latches and rotated in front of the AS5600 **away from the Teensy**. *One board is enough at the Teensy end — a half-size is 30 columns and a Teensy 4.1 takes 24, but every pin column still has four free holes. An earlier note said to clip two together; that was over-cautious.* **A third per station lets drive and steering be benched in parallel instead of in series**, which is what actually happens with thirteen students on three stations — **+3 boards, ₩2,550.** **QUOTE v2 CHECKED 2026-10-27 — ₩147,919 incl VAT, and the arithmetic reconciles exactly** (goods ₩130,471 + carriage ₩4,000 ex-VAT = ₩134,471, VAT ₩13,447; 1원 of rounding on the UBEC line and the total). Every requested change is in: 2-pin 10 → 30, breadboards 6 → 9, plus sockets, heatshrink and the 1000 pF. **핀헤더소켓 ×18 is more than twice the eight the Teensys need — left alone, and the surplus has a real use: socket the AS5600 breakouts and the Pololu MUX too, so a dead module swaps without an iron.** **ONE POSSIBLE GAP — male pin headers (`핀헤더 Single 1x40 Straight 2.54mm`, ₩200).** The quote has **female sockets only.** *A Teensy 4.1 normally ships with its pins NOT soldered, and without male pins it cannot go into a breadboard OR into the perfboard sockets this order is buying — the sockets would have nothing to receive.* **Checkable in five seconds on the boards already in hand: are the pins soldered on?** If not, **two strips per Teensy (6) plus one or two for the servo-style runs = 10 strips, ₩2,000.** *The servo connections need male pins regardless, because the receiver and the MUX both terminate in female sockets.* *Figures here are the QUOTE, not an order — nothing is placed yet, so Ordered and Paid stay blank. Split so the UBECs are not counted twice: goods ₩130,471 ex-VAT less the ₩21,381 UBEC line = **₩109,090 ex-VAT, ₩119,999 incl**, which is this row; the UBECs sit on [#11b spares](#L113) and the ₩4,400 carriage on the [Shipping row](#L900).* **ORDERED 2026-10-27, 주문번호 `2026102717063418412`, ₩152,319 on the card.** The gap was real: **the Teensys came with their pins NOT soldered**, so line 11 — `핀헤더 Single 1x40Pin Straight(2.54mm)` **×20, ₩4,000** — was added. *Without it the ₩9,540 of female sockets in the same order would have had nothing to receive, and neither the breadboard nor the perfboard could have taken a Teensy.* **Twenty strips against the ten estimated** — six for the Teensys, the rest for servo-style headers and spares. **Split, VAT-inclusive, so nothing is double-counted:** this row **₩124,399**, UBECs **₩23,519** on [#11b spares](#L113), carriage **₩4,400** on the [Shipping row](#L900). Goods ₩134,471 ex-VAT, 공급가액 ₩138,472, VAT ₩13,847. **TWO FINDINGS 2026-10-27 from working out the perfboard transfer** ([§3.5.4](build/03-electrical.md#354-transferring-to-perfboard-three-boards-become-one)). **(1) Terminal count, recounted properly: 12 × 2-way per vehicle, 36 for the fleet** — signal board 6 (power in, two per sensor cable, gate out) and relay board 6 (12 V in, gate in, a pair to each of four coils). *My earlier figure of 11 missed the gate line as its own terminal.* **30 two-pin were bought, so the 10 three-pin make up the difference with one way spare on each: 40 against 36.** It covers, but it is not generous, and that is worth knowing before week six rather than during it. **(2) A supply bypass cap at each Hall latch was never bought by any line.** TI's `DRV5013` datasheet asks for one close to the device, and **a sensor on the end of a metre of cable beside a PWM'd motor is exactly the case it exists for.** **100 nF is the standard value; the 1 nF on this order is better than nothing but is not it** — 1 nF is a signal filter, not a supply reservoir, and they do different jobs. *Six needed, soldered at the bracket across the latch's own `VCC` and `GND` — not at the board end, where it does nothing for the sensor.* **Check the lab drawer before ordering: every lab has 100 nF ceramics**, and this is a ₩1,000 item that should not become a ₩4,000 delivery. **100 nF SOURCED 2026-10-27 — but check the lab drawer first; this is a ₩1,000 part and the cheapest version of this errand is not buying it at all.** *디바이스마트's search stopped returning results for this session, so these are 쿠팡.* **Pick: [모아프라자 세라믹콘덴서 0.1 µF 50 V, 쿠팡 304864537](https://www.coupang.com/vp/products/304864537) — 20개 ₩1,000 + ₩3,500 carriage, or the listing's own 100개 tier at ₩8,500 delivered.** Seller 97 % / 410. **Six are fitted (one per Hall latch, two per vehicle); take 20 and the rest become lab stock, because 100 nF is the single most-used value in any build.** **Alternative if nothing else is being ordered: [아즈토 10개 ₩6,700, 무료배송](https://www.coupang.com/vp/products/9627859480), next-day.** *Six times the unit price, but it ships free — and against a ₩3,500 carriage that is the cheaper basket when it is the only line. Which of the two wins is decided by whether anything else is in the cart, not by the per-piece price.* **Specify `0.1 µF / 50 V / 104` and nothing further.** *Tolerance, dielectric and brand are all irrelevant for a supply bypass; the one thing that matters is that it is a **ceramic** and through-hole. A 마일러 (polyester film) part appears in the same search results at a similar price and is the wrong family for this job.* **100 nF ORDERED 2026-10-27 — 100 pcs, ₩8,500 all in** (쿠팡 304864537, the 100-piece tier; ₩5,000 of goods and ₩3,500 carriage, VAT included). *The 100 tier rather than the 20: at ₩85 a piece against ₩225, the carriage is what the order is really paying for, so the extra 80 cost ₩4,000 and the carriage was already spent.* **Six are fitted — one at each Hall latch bracket, two per vehicle — and the remaining 94 are lab stock**, which is not waste: 100 nF is the single most-used value in any build, and the next cohort will reach for it. **Fit at the bracket, across the latch's own `VCC` and `GND`** ([§3.5.4](build/03-electrical.md#354-transferring-to-perfboard-three-boards-become-one)) — at the board end it does nothing, because the metre of cable is the problem it exists to get around. **Carriage recorded in this row rather than the [Shipping row](#L900)**, because ₩3,500 of the ₩8,500 *is* this line's cost and splitting it would hide that the delivery outweighed the goods. *With this, the parts gap found by working out the perfboard transfer is closed, and nothing on the build is outstanding.* | **ARRIVED — confirmed 2026-11-04 against 거래명세서 `2026102717063418412`, and the invoice reconciles to the won.** 공급가액 ₩138,472 + VAT ₩13,847 = ₩152,319, which splits **#12b ₩124,399 · [#11b spares](#L113) ₩23,519 · carriage ₩4,400** exactly as this row projected. *(The ₩132,899 in the Paid column is ₩124,399 + the ₩8,500 쿠팡 100 nF order `2103886417959`, whose ₩3,500 carriage stays in this row rather than the [Shipping row](#L900) because the delivery outweighed the goods and splitting it would hide that.)* **TWO QUANTITIES DIFFER FROM WHAT THIS ROW WROTE DOWN, both upward, neither a problem.** **(1) 만능기판 is SIX of each, not four** — `[GA6] 50×80` ×6 @₩3,450 and `[GA2] 80×80` ×6 @₩4,300, so **twelve boards for six fitted positions**, not eight. *The spare count is now 1 per board per vehicle instead of 1 per board for the fleet, which is the right side to be wrong on for a part a student ruins.* The GA6 unit is ₩3,450, not the ₩3,500 quoted here. **(2) 열수축튜브 ×2 sets**, not one. **AND THE ONE CHECK THAT IS STILL OPEN IS THE ONE THIS ROW HAS BEEN ASKING SINCE THE QUOTE: count the terminal blocks.** The invoice reads **2-pin 수량 30 @₩600** and **3-pin 수량 10 @₩900** — the same ambiguity, unresolved, because the listing sells 10개 단위. *If 30 means thirty PIECES the fleet has 40 ways against the 36 it needs and the margin is four. If it means thirty PACKS it has 300.* **Open the bag and count; this is the only line here that can still be short.** **Also count `HV(E) Ceramic 1000pF`: 수량 40 @₩40.** The sourcing note read that price as *₩40 per ten*, which would make this 400 pieces rather than 40. Six are needed; either way it covers, but the log should say which. *Not secured until both counts are done.* **TERMINAL COUNT CLOSED 2026-11-05 — thirty PIECES and ten PIECES.** So the 40-against-36 reading is the right one, the fleet is not short, and a question this row had carried since the quote is answered by opening a bag. **But the margin has a shape the fleet number hides: all four spares are 3-pin.** The 36 ways take all 30 of the 2-pin and then six 3-pin with one way unused each, which leaves **four 3-pin and zero 2-pin in the drawer.** *Replacing a cracked 2-pin with a 3-pin costs 5.08 mm of extra board width in a footprint drawn for a 2-pin, and the relay board is a 50 × 80 carrying six of them — so this is a LAYOUT fact, not a reorder. A 2-pin is ₩600 and will never justify a carriage of its own.* **AND CLOSING IT FOUND A CONTRADICTION ON THE PAGE A BUILDER READS.** [§3.5.4](build/03-electrical.md#354-transferring-to-perfboard-three-boards-become-one) still printed the **old count, 11 per vehicle and 33 for the fleet**, while `perfboard-transfer.svg` **140 lines below it on the same page** printed 12 and 36. *The recount went into this row and into the figure and never reached the table between them.* **The missing way is the GATE LEAVING THE SIGNAL BOARD** — the line crosses from the logic box to the power box and needs a terminal at each end; the table had it arriving at the relay board and never departing. Table corrected, and the omission named in place so the next reader sees why 11 was wrong rather than just that it changed. **STILL NOT SECURED — the 1000 pF count is the one left.** **TERMINAL MIX CORRECTED 2026-11-05 while drawing the relay board's placement** ([§3.5.4](build/03-electrical.md#where-it-all-sits-on-the-board)). The count stays **12 × 2-way per vehicle, 36 for the fleet** — but **two of the twelve were the wrong two wires.** The table had `Gate + GND` on the block between the signal board and the relay board. **No GND belongs there:** the relay board's ground already returns to the star on its 12 V terminal carrying the whole 600 mA, so a second ground conductor to the Teensy is a parallel path — a loop. *The offset you take instead is the IR drop in that one wire: 600 mA × ~0.011 Ω ≈ **7 mV** against a worst-case `Vgs(th)` of 1.0 V.* **And the way it occupied was needed by the E-stop sense divider**, which sits on the relay board and whose output reached no terminal in the count. *Same omission as the gate-out way found the day before, one board over — a signal crossing between the two boxes, counted at one end or neither.* `GND` → `SENSE` closes both without moving the count, **so the 30 + 10 blocks in the bag still cover it.** **PERFBOARD GRID COUNTED 2026-11-05 — 29 × 18, and divide-by-pitch was over on BOTH sides.** [§3.5.4](build/03-electrical.md#where-it-all-sits-on-the-board) had derived the relay board’s grid as 80 / 2.54 = 31.5 and 50 / 2.54 = 19.7, so 31 × 19. **Counted end to end, edge holes included: 29 × 18** — over by two on the long side and by one on the short. *Dividing by the pitch assumes the pads run to the board edge, and they do not: the array sits inside a blank margin the arithmetic had no way to know — **4.4 mm** across the width (80 − 28 × 2.54, halved) against **3.4 mm** across the height (50 − 17 × 2.54, halved). Two different margins, neither derivable from the other.* **The same margins are why the four plated corner mounting holes fit where they do** — a 3.2 mm hole needs about that much blank FR-4, and a board whose pads really did reach to within 1.9 mm of the edge could not carry one. *A photograph of the boards in hand and the hole count agree, which is the check every derived version of this number failed.* **So the mount needs no decision and no drill**, and an earlier version of this row saying a corner M3 was out is superseded. **Keeping a one-hole margin all round, the working area is 27 × 16 and the layout now spends it exactly** — rows 2–17 and columns 2–28, with the GND bus on the last row and all three buses ending on the last column. *Nothing more fits without taking space back from what is there.* **The signal board is the same long side, so the `[GA2] 80 × 80` is 29 × 29** — counted, and it will matter when that board is laid out. *A Teensy 4.1 takes 24 columns of the 27 that remain inside the same one-hole margin.* **AND A SECOND READING OF THE TWO FIGURES FOUND THE PULLDOWN ON THE WRONG SIDE OF THE 100 Ω.** `relay-driver-board.svg` tapped it on the **Teensy side**; [§3.5.4](build/03-electrical.md#where-it-all-sits-on-the-board)’s placement figure has always had it on the **MOSFET side.** *The schematic was the wrong one, and it contradicted its own build order — step 1 reads “pulldown, **gate** to GND, first, alone” and step 2 meters gate-to-GND before the 100 Ω is fitted at all.* **On the Teensy side the resistor stops holding the gate the moment anything between it and the gate opens — a cracked 100 Ω joint, a lifted pad — and it does so silently, still fitted and still metering 10 kΩ.** Schematic moved, and the generator now asserts the **node** instead of the neighbourhood: the old check only asked whether the pulldown sat *near* the gate, and the wrong version passed it. **SIGNAL BOARD PLACEMENT DRAWN 2026-11-05, and it needs the GA2’s 29 × 29 to work.** [§3.5.4](build/03-electrical.md#where-it-all-sits-on-the-signal-board). *The Teensy 4.1 takes **24 of the 27 usable columns**, which is why this line bought the square `[GA2] 80 × 80` for the signal board and the `[GA6] 50 × 80` only for the relay driver — a GA6 would be 24 of 27 one way and 24 of 16 the other, which does not fit at all.* **Three columns spare is the whole margin**, so the terminals go on the top and bottom edges rather than beside the board. **AND DRAWING IT A SECOND TIME FOUND THE BENCH FIGURE MIRRORED.** `breadboard-layout.svg` had the Teensy’s `GND · 0 · 1` edge on the **upper** row and `VIN · GND · 3V3 · 20 · 19 · 18` on the lower, with the USB end at the left — **a combination that cannot happen.** With USB to the left the pinout rotates counter-clockwise and the `Vin` edge comes out on top. *Anyone wiring board A from it would have put every component on the wrong side of the Teensy, and the first symptom would have been two dead quadrature channels — which reads exactly like a dead sensor, the failure that section warns about twice.* **The figure was internally consistent, which is why it survived: every component agreed with every other, and all of them agreed with a mirror.** It took holding a Teensy next to a second, independently drawn figure to see it — which is the argument for drawing the same thing twice: not redundancy, a second chance to disagree. Rows swapped and every attached component moved across the channel. **AND THE i-BUS LINE HAD NOWHERE TO PUT THE ANSWER TO A CHECK THIS BUILD ALREADY REQUIRES.** [§3.4](build/03-electrical.md#34-wire-the-e-stop-and-mux-first) has always said to **meter the i-BUS idle level before it touches a serial pin** — the receiver runs on 5 V and the Teensy 4.1 is not 5 V tolerant — but **no figure had a place for a divider**, so every drawing ran the wire straight onto the pin. *A required measurement with no place to record its consequence is a measurement that gets skipped.* **Two holes reserved as R5/R6:** a **wire link** if it idles at 3.3 V, **a divider** if it idles at 5 V. Resistors are already in the 30-value kit, so this buys nothing — it just stops the answer having nowhere to go. **STEERING HUB RE-MEASURED 2026-11-05 — 62.2, and it moved `HUB_TOL`.** *The steering and drive gearboxes are the same assembly with the same six-lobe output, which is why this is one part number’s spread rather than two parts.* The file already carried 62.23 for the steering hub, so **62.2 repeats it to 0.03** — and that retires the worry that the caliper was the problem: the earlier 0.12 between two reads of the same DRIVE hub was access, not the instrument. **What it does move is the tolerance.** `HUB_TOL` 0.6 against `HUB_D` 62.82 covers down to **62.22**, and **62.2 is 0.02 below it** — the tolerance was short by the width of the reading that found it. **0.6 → 0.7**, covering 62.12. *Nothing reprints, and that is not luck: `BORE_D = HUB_D + BORE_CLEAR`, so the bore does not depend on `HUB_TOL` at all.* What it costs is screw margin — `SPAN_MAX` 7.90 → **7.95 against an M3 × 8**, which the grub-screw assert still passes by 0.05 mm. **The ceiling is 0.8 (a smallest hub of 62.02), so 0.08 mm of band is left and TWO UNMEASURED DRIVE HUBS are what would spend it.** **MDDS30 MANUAL READ PROPERLY 2026-11-05, and it settled a question and overturned a safety claim.** *The question: the vendor’s Arduino tutorial shows extra direction GPIOs, so does the Teensy need them?* **No — that tutorial is PWM mode.** `SW1:SW2=10` PWM takes **two pins per channel**, `AN1`/`AN2` for magnitude and `IN1`/`IN2` for a digital direction. `SW1:SW2=00` **R/C mode takes ONE servo pulse per channel on `RC1`/`RC2`, with direction and magnitude both in the pulse width** — which is the mode this build uses, and the only one a servo-pulse MUX can sit in front of. *PWM mode would cost the hardware override path, which is what D3 was adopted on.* **And the manual confirms the switch choices already recorded here:** `SW3:SW4=11` independent both is its own stated recommendation *“if controlled using Microcontroller”*. **The overturned claim:** [§3.4](build/03-electrical.md#34-wire-the-e-stop-and-mux-first) said the R/C signal-loss timeout was *“inherent — nothing to configure”*. **It is configurable and `SW6` turns it OFF**, exactly as the quote review flagged: `SW6=0` stops the motor after **100 ms** of lost signal, `SW6=1` disables the timeout and **the motor keeps its last speed.** *A page that tells a builder a failsafe is automatic is worse than one that says nothing.* **A SECOND HAZARD CAME OUT OF THE SAME PARAGRAPH:** with `SW6=0` the **centre point is calibrated at power-up**, and the manual separately requires the transmitter to be ON first. **So whatever pulse sits on `RC1`/`RC2` at power-up becomes “stop”** — receiver on, Teensy already emitting 1.5 ms, MUX settled, **then** the driver. Power it first and neutral can come out as a creep. *Terminal names corrected across the build and design pages while here: `S1`/`S2` is Sabertooth naming and the board is labelled `RC1`/`RC2`.* **FULL DIP MAP WRITTEN DOWN 2026-11-05 — it is NOT "all eight off".** *The row had `SW1:SW2=00` · `SW3:SW4=11` · `SW6=0` and nothing about the other four, which reads as "the rest do not matter."* **Two of them matter.** **`SW3:SW4` must be ON/ON.** `00` is **MIXED** — the manual: *“the motor speed is controlled by channel `RC1` and direction is controlled by channel `RC2`”*, which is tank mixing for a transmitter’s two sticks. **On this vehicle motor Left is the STEERING gearmotor and motor Right is the traction pair**, so mixed would make a throttle command drive the steering motor and a steering command drive the wheels. *It is the one setting that silently redefines what both outputs mean, and all-off selects it.* **`SW7:SW8` is the battery monitor and `00` is LiPo** — which nothing here is: the logic pack is LiFePO₄ and the traction pack is the chassis’s own. **No document in this repo records the traction pack’s chemistry**, so that is a label to read before the switches are set: `10` SLA if it is the usual sealed lead-acid, `11` to turn the monitor off. **`SW5=0`** keeps the response linear. *Four off, two on, two to decide.* **AND THE “INHERENT TIMEOUT” CLAIM HAD A SECOND COPY**, in [§4](build/04-firmware.md) — fixed with the first. **AND A QUESTION ABOUT WHERE TO CUT THE PACK LEADS FOUND TWO TABLES CONTRADICTING THE SAFETY PATH.** [§3.2](build/03-electrical.md#32-power-distribution)’s fuse table read *“traction pack → E-stop contactor → driver B+”* and [§3.3](build/03-electrical.md)’s tap table read *“feeds the motor driver’s B+ **only**”* — both of which put the **#8a** contactor in the DBW branch alone. **That leaves the stock ECU live after an E-stop**, and the same button drops the relay MUX to `87a`, which connects the motors to that live ECU: *press the E-stop, press the pedal, and the vehicle drives.* **The contactor belongs in the trunk — the pack’s `+` lead, upstream of the fork — so one press removes power from the stock ECU and the driver together.** *Three things already said so and only the tables did not: `power-wiring.svg` tees AFTER the contactor, §3.4 says the E-stop “cuts traction power” rather than cuts the driver, and the figure’s reversibility line — “returning it to stock means unbolting the contactor” — only makes sense if the contactor is in the stock path.* **Only the `+` is ever interrupted; the `−` runs unswitched to the star.** And if the pack’s `+` ends in a connector, the fuse and contactor go in on an **adapter lead with nothing cut**, which meets §2.8 reversibility by construction. *Also glossed on the figure and in §3.4: `30 · 87 · 85 · 86` are DIN relay terminals, `87` is the **normally-open** contact, and `#8a`/`#8b` are this repo’s part codes rather than anything marked on the part — a reader had to ask.* **TRACTION PACK IDENTIFIED 2026-11-05 FROM ITS LABEL — `Aroma 6-FM-4.5`, 12 V 4.5 Ah sealed lead-acid** (`NON-SPILLABLE`, `Pb`, Zhejiang Pinghu Hualong; cycle charge 14.4–15.0 V, standby 13.6–13.8 V). *No document in this repo had recorded the chemistry or the capacity.* **That closes `SW7:SW8` at `10` (SLA)** — so the DIP map is now **five off, three on**, with nothing left to decide. **But the monitor only WARNS.** The manual: on under-voltage the error LED blinks three times and *“the power to the motor will be maintained and will not be cut out”*. **Nothing on this vehicle protects the traction pack from being flattened**, and deep discharge is what kills a lead-acid pack — a person’s job, now written down. **AND THE SAME READING FOUND A CLAIM THE CHOSEN BOARD CANNOT SUPPORT.** [§3.2](build/03-electrical.md#32-power-distribution) justifies **no fuse on the motor branches** on *“the driver’s current limit, set to 20 A”* — **a Sabertooth setting.** The `MDDS30` manual documents **no user-settable limit**: it lists “current limit protection” with no number and gives **30 A continuous, 80 A peak per channel**, thermally derated (80 A below 50 °C → 30 A above 100 °C). *The branches are AWG 14, which is not a 30 A conductor in a loom.* **OPEN:** find the limit if the board has one, and **measure `I1` drive-motor stall current** — at 20 A a 4.5 Ah SLA is a 4.4 C discharge, so the pack’s own internal resistance may be the real limiter, which is a measurement rather than an assumption. **AND A CORRECTION TO YESTERDAY’S POWER-UP CAUTION:** the manual’s first safety feature is that *“the input data must be ‘stop’”* at power-up, **error LED 2 blinks** otherwise — so **no signal at power-up means the driver will not run**, while a steady but WRONG pulse is the one that gets adopted as the centre by `SW6=0` and offsets every later command. Two different failures, both now named. **“E-STOP CONTACTOR” WAS ONE NAME FOR TWO PARTS, AND §3.4 HAD MERGED THEM.** Asked which part the phrase meant, the answer is **[#8a](#L80) `KKA-B4` 40 A 4핀 relay** — but [§3.4](build/03-electrical.md#34-wire-the-e-stop-and-mux-first) opened with *“a latching mushroom-head contactor, hardwired in the traction power path”*, **which puts the BUTTON where the relay goes.** *The button is [#8b](#L81), 한국미스미 `MRE-RR2R`, and it carries coil current only.* **This row already knew:** the sourcing note warns that *“a signal-rated mushroom will weld shut”* if asked to switch traction — so the page and the log disagreed about the one thing that makes the E-stop work. Split into a two-row table naming both parts and what each carries. *And `2a2b` is now explained where it matters: two independent NC contacts is exactly why one button can break the contactor coil and the MUX coils on different contact blocks.* **AND THE POWER FIGURE DRAWS [#8a](#L80) TWICE WITHOUT SAYING SO.** Its **contact** (`30→87`) is in the traction row and its **coil** (`85·86`) is in the logic section — *one relay, two halves, two sections, because its contact lives on one rail and its coil on the other, which is the entire point of the design.* **Both boxes now say which half they are**, and [§3.4](build/03-electrical.md#34-wire-the-e-stop-and-mux-first) carries the six connections explicitly, since “where do the wires actually go” was the question. *Also: the `25 A` and `5 A` boxes said “AT the pack”, which reads as “use the fuse the vehicle already has” — both now say **NEW — fit it AT the pack**, and the 5 A box says **blade fuse**, which it never did. The vehicle’s own 10 A auto-resetting breaker is a different device in the stock ECU line, and §3.3 already says to tap upstream of it.* **AND NOTHING IN THIS LOG BUYS THE JOINT THAT CARRIES THE WHOLE 25 A.** Asked how the tee after [#8a](#L80)’s `87` is actually made, the answer needed a part that no line procures: **a small brass bus bar or power distribution block** — one stud in, two studs out. *Same shape as the terminal blocks and the Hall bypass caps before it: a part specified by the wiring and procured by nothing.* **A three-wire butt crimp works and can never be inspected again**, which is the wrong trade for the one joint every amp passes through; piggyback spades on the socket are worse. **Check the lab drawer first** — this is a few thousand won and the cheapest version of the errand is not ordering it. *Method written into [§3.4](build/03-electrical.md#34-wire-the-e-stop-and-mux-first), including that the tee goes at the PACK end inside the adapter lead so fuse, contactor and tee come out as one removable assembly, and that it must sit downstream of BOTH the fuse and the contact.* **TEE PART SOURCED 2026-11-05 — nothing ordered.** *The car-audio “power distribution block” that dominates every search is the wrong class entirely: 0-gauge input, 60–150 A, and forcing AWG 14 into it makes a worse joint than the one it replaces.* **The right class is a fixed barrier terminal block, 30 A, M4** — it takes an AWG 14 ring terminal and clears the 25 A fuse by 20 %. **Pick: [전오전기 고정식 단자대 `JOTB 30-4P`, 디바이스마트 12504697](https://www.devicemart.co.kr/goods/view?no=12504697) — 600 V / 30 A / M4 / pitch 12.8 mm / 4핀, ₩2,200.** *Four poles gives the tee plus spares.* **Alternative on the same shelf: [터미널블록 30A 3P, 12501177](https://www.devicemart.co.kr/goods/view?no=12501177) — 600 V / 30 A / M4 / `AWG 10~18`**, which is the gauge range that matters here. *Explicitly NOT a 접지 부스바: that tidies earth wires and is not a 1-in-2-out power joint.* **The cheapest version of this errand is still the lab drawer** — at ₩2,200 against a ₩2,700–4,400 carriage, the delivery costs more than the part, so it only makes sense bundled with something else. *And it is a PANEL part on a vehicle: lock the screws and strain-relieve the cable, which this build already requires of every terminal.* **AND THAT IS THE SHAPE OF THE ALL-3-PIN SPARE MARGIN.** A 3-pin at 5.08 mm spans four holes where a 2-pin spans two, so **a coil block at row 4 would reach row 8 — the DRAIN bus — into the very hole that coil’s own `85` jumper already takes.** *The earlier note put the cost of that substitution at 5.08 mm of board width; on this board it is not width at all, it is a collision.*|
| 113 | **#11b spares** — UBEC 5 V 3 A ×2 | 1 | 디바이스마트 1078321 | 23,519 | 2026-10-27 | 2026-11-04 | — | 23,519 | **This was written into [#11b](#L111) when it was secured and then nobody acted on it, which is the failure this log exists to prevent.** Six UBECs across three vehicles and **zero spares** — the only Batch 1 line carrying none, on **the one component a student sets by hand before anything downstream of it survives**. A 6 V jumper found late, or one dead regulator, stops a vehicle for a week. **Buy two.** **DECLINED 2026-10-26 by the owner. Not forgotten — refused, and the risk is accepted knowingly.** *The row stays at ₩0 rather than being deleted, because a line that vanishes is a line nobody can learn from.* **What is being accepted: six UBECs, zero spares, on the one component a student sets by hand.** If one is found jumpered to 6 V, or one dies, that vehicle waits for a delivery. **If it happens, this row is the place to say so** — and the next cohort reads the outcome, not the intention. **REVERSED 2026-10-27 — the owner put two UBECs back on the 디바이스마트 order, ₩21,381 ex-VAT.** *Recording the reversal rather than quietly editing the decline away: the row now shows a risk identified, accepted, and then closed, which is the sequence worth reading.* **The fleet goes from zero spares to two on the one component a student sets by hand.** *Quoted ₩10,690 ex-VAT each = **₩23,519 incl** for the pair, on the #12b order. Recorded VAT-inclusive like every other row, which is the convention that caught the VAT trap twice.* | **ARRIVED — confirmed 2026-11-04 on the shared 디바이스마트 invoice `2026102717063418412`.** Line 1, `interboard-UBEC` ×2 @₩10,690 ex-VAT = ₩21,381 → **₩23,519 incl**, which is this row's figure to the won. *It shares a parcel with [#12b](#L122), so the two arrive and are checked together.* **Verify before fitting: these are the SPARES, and the point of the row is that they are the same part as [#11b](#L111).** Read the output voltage off all five remaining UBECs with a meter — [#11b](#L111) has one unit reading **5.11 V** and the rest were never checked (V4 **X2**). A spare that is not the same voltage as the one it replaces is not a spare.|
| 121 | **#12 top-up** — 5 A ATO fuses | 1 | [쿠팡 6968156204](https://www.coupang.com/vp/products/6968156204) | 100 | 2026-11-07 | . | — | 1,000 | **Also written into [#12](#L12) at securing and also not acted on.** The 10종 set contains **five** 5 A fuses, three of which are fitted — **two spares across three vehicles for a whole semester.** *Fuses are consumables and a blown one with no replacement stops a lab*, which is a cheap way to lose an afternoon. Buy twenty. **DECLINED 2026-10-26 by the owner. Risk accepted.** **Two spare 5 A fuses for three vehicles and thirteen students across a semester.** A blown fuse with no replacement stops that day's lab. *Kept at ₩0 for the same reason as [#11b spares](#L113): the decision is more useful on the record than off it.*  **ORDERED 2026-11-07 — ten × 5 A at ₩100.** 진주바다 대형ATO, arriving 11/10; carriage ₩3,000 on [#900](#L900). **The size was the whole risk, and it was checked three ways**: the listing names 대형ATO, the 5 A variant was clicked rather than left on its default, and the product photo is a blade fuse — *the same seller also lists 유리관*. [#12](#L12) cancelled twelve MINI 5 A in October for exactly this reason: these holders are standard size. **Quantity was chosen against carriage, not against need** — ₩3,000 of shipping dominates a ₩100 part, so ten rather than the three that close the gap.|
| 123 | **#12c** Authority-tap connectors — steering Micro-Fit 3.0 ×3 vehicles | 1 | [디바이스마트](https://www.devicemart.co.kr/goods/catalog?code=0009000200010039) | 14,575 | 2026-11-07 | . | — | 14,575 | **ORDERED 2026-11-07.** ₩13,250 ex-VAT, ₩14,575 with VAT, on one 디바이스마트 order with [#12d](#L124); carriage ₩2,700 is on [#900](#L900). [`43645-0200`](https://www.devicemart.co.kr/goods/view?no=1271915) housing, module side (`87a`) · ₩460 · **×5 bought** · [`43640-0200`](https://www.devicemart.co.kr/goods/view?no=1271917) housing, vehicle side (`30`) · ₩490 · **×5 bought** · [`43030-0001`](https://www.devicemart.co.kr/goods/view?no=1271920) female crimp, AWG 20–24 · ₩50 · need 6, **MOQ 50 bought** · [`43031-0001`](https://www.devicemart.co.kr/goods/view?no=1271922) male crimp, AWG 20–24 · ₩60 · need 6, **MOQ 100 bought** — **₩11,350 the lot.** **Both housings are crimp, wire-to-wire — no PCB header, nothing mounted on [#12b](#L122) perfboard.** Which is which comes from the listings' own cross-references, which also re-confirm the identification: `43645` mates with `43640`, **`43650`** and `200875`, and `43650` is the PCB-header family — so `43645` is the half that goes onto a board header, which is what the vehicle's own plug does. **Bundle with [#12d](#L124)** — ₩2,200 of terminal block is not worth its own carriage, and neither is ₩11,350. | **Nothing needs measuring before this order.** Both crimps are **AWG 20–24**, and an earlier note here said to check the steering conductor against that — wrong premise: **both bought halves are crimped onto MRider's own wire**, one running to `87a` and one from `30`. Nothing stock is cut, so no stock conductor enters a bought barrel. It fixes **MRider's tap wire at 20–24 AWG**, which with the tap's ≈5 A is the acceptance criterion for steering stall current. Rationale, and the argument that **one fit test settles both halves**, in [§1.2.4 #12](build/01-bom-sourcing.md#7-8-11-12-14-what-to-actually-buy).|
| 125 | **#12e** Authority-tap terminals — `.250` flat blade, drive **and** power taps | 1 | [쿠팡 9729831238](https://www.coupang.com/vp/products/9729831238) | 14,990 | 2026-11-07 | . | — | 14,990 | **ORDERED 2026-11-07.** Dorhea 360-piece spade set — `2.8 / 4.8 / 6.3 mm`, **male and female**, tin-plated copper, loose PVC sleeves, crimp pliers included. Free carriage, arriving 11/08. **One kit covers two taps**, because the drive tap and the power tap are both `.250` — established 2026-11-07, [§2.2](build/02-mechanical.md#22-teardown). **It could not ride on the [#12c](#L123) order**: 디바이스마트 does not stock uninsulated `.250` at all and 엘레파츠 sells it only by the reel, M.O.Q. 6,000–10,000. **The spec that filtered the market was GAUGE, not size** — every listing states 6.3 and almost none states AWG, while the drive tap runs 1.5 mm² and the power tap AWG 14. This kit states **22–14 AWG (0.5–2.5 mm²)**, which covers both; the common 22–16 kit does not. | **Try one receptacle on vehicle #1's module before crimping twenty-four.** The module's tabs sit in a moulded shroud, which is why §1.5 requires uninsulated — the sleeves here are loose in the box, so the shrouded end goes in bare. **The included pliers are not a ratchet**: bench-practise with them, and crimp the twenty-four that go on a vehicle with the ratcheting tool §1.5 asks for.|
| 124 | **#12d** Authority-tap tee — fixed barrier terminal block, 30 A, M4 | 5 | [디바이스마트 12504697](https://www.devicemart.co.kr/goods/view?no=12504697) | 2,420 | 2026-11-07 | . | — | 12,100 | **ORDERED 2026-11-07 — five, not three.** ₩2,200 each ex-VAT, ₩2,420 with, ₩12,100 the lot. *Three fitted and two spare: the cart already held five, and five was kept because a barrier block with a stripped M4 is scrap and carriage costs more than the part.* The drawer was never checked. The drive tap's two nets each carry two stock conductors, so the relay's `30` has to reach both: that junction is a **fixed barrier block**, not a piggyback spade and **not a 통탈피 T-tap** — [§3.4](build/03-electrical.md#34-wire-the-e-stop-and-mux-first) records both wrong classes beside the right answer. **Delivery costs more than the part**, so this line exists to be bundled with [#12c](#L123). | 30 A and M4 stated on the part. Four poles: two nets × in/out.|
| 14 | Mounts / 3D-print material | 3 | 쿠팡 | 11,867 | 2026-10-13 | 2026-10-23 | 0/3 | 35,600 | **Spec:** [§1.2.4](build/01-bom-sourcing.md#7-8-11-12-14-what-to-actually-buy) — **PETG, not PLA** — PLA softens at ~60 °C and mast rigidity is a calibration requirement **Sourced 2026-10-13** ([§1.2.1](build/01-bom-sourcing.md#14-and-6d-verified-2026-10-13)): **PETG 1 kg ×2** [올리민 ₩11,900](https://www.coupang.com/vp/products/9533639155) — any colour — · **PETG 1 kg YELLOW** [Lay1 ₩13,900](https://www.coupang.com/vp/products/9577432592), **required by ISO 13850** for the E-stop backing plate, not a preference · **M3 heat-set inserts ×100** [Lay1 ₩9,800](https://www.coupang.com/vp/products/9470532681) or the [M2–M6 220-piece assortment ₩11,900](https://www.coupang.com/vp/products/9510071311). ≈ **₩47,500** of a ₩123,000 line, plus M3/M4 bolts, nylon standoffs and cable ties from a local shop. **The 2020 extrusion is deliberately left out** — the mast is not designed, so its length is a guess. **Caliper the inserts on arrival**: the model's `INSERT_D` 4.6 and `INSERT_L` 5.0 have to match what turns up, and listings write those two numbers in either order. **Ordered 2026-10-13** (쿠팡 `2103582332487`): PETG 1 kg **옐로우** ₩13,900 · PETG 1 kg **딥블루** ₩11,900 · 황동 인서트**`M3x4x5`** 100개 ₩9,800 = **₩35,600** against a ₩123,000 estimate. One shared purchase, so the unit price here is the total over three and lands ₩1 off by rounding. **One roll of non-yellow may or may not be enough, and nobody can say yet.** Three carriers are about 60 g; the brackets, mounts and enclosures for three vehicles are the unknown, and those parts are not designed. **Do not pre-buy. The trigger is: print one vehicle's full set, weigh what is left on the spool, multiply by three.** Filament is next-day and the colour need not match, so a second roll is a five-minute decision once there is a number behind it rather than a guess. **The inserts are `M3x4x5` and the model wants `INSERT_D` 4.6 / `INSERT_L` 5.0 — caliper them before printing a carrier**, because the listing's two numbers could be either order and the same seller also sells `M3x5x4.2`. **2026-10-19 — this row is the FILAMENT half only.** The mast tube and the equipment plate are neither printed nor funded here; they moved to [#14b](#L141) when the materials were decided. **ARRIVED — all of it, confirmed by the owner 2026-10-23.** *The delivery date was not recorded, so the cell carries the date of this entry rather than the date the parcel landed. Flagged because [#6d](#L63) deliberately does the opposite — **do not read this one as a lead time.*** **Not secured. Two checks.** **(1) Three rolls — two any-colour PETG and ONE YELLOW** — the yellow is **[ISO 13850](design/safety.md) for the E-stop backing plate, not a preference**, and it is the item most likely to have been silently substituted. **(2) Caliper the M3 heat-set inserts against `M3x4x5`.** They are **not** for the carrier — a Ø4.5 hole across its 6 mm width would split it, which is why its threads are tapped — **they are for the enclosures**, which is what this line always said. Confirm the count is 100. **2026-10-26 — filament confirmed: two blue, one YELLOW.** The yellow is the one that mattered ([ISO 13850](design/safety.md), E-stop backing plate), and it was the item most likely to have been quietly substituted. **The insert / T-nut check is NOT yet resolved — see the reply thread; a 9.5 mm part would not enter the profile slot, and which part was tried decides whether this is a #14 problem or a [#14b](#L141) one.** **2026-10-26: filament confirmed by the owner — two blue, one yellow, as bought.** **Only the insert check is left to secure this row: caliper them against `M3x4x5` (L 4.0, OD 5.0) and confirm the count is 100.** *Worth doing rather than assuming, because an earlier report of "삽입너트 9.5 mm" turned out to be the T-nut, not these — so the inserts have not actually been looked at yet.* |
| 141 | **#14b** Mast + equipment plate — 2020 extrusion, plywood, T-slot hardware | 3 | 쿠팡 | 30,090 | 2026-10-20 | 2026-10-23 | 0/3 | 90,270 | **Decided 2026-10-19:** 2020 aluminium extrusion for the mast, **12 mm birch plywood** for the plate that replaces the seat, printed PETG for the mounts and the two enclosures ([§1.2.4](build/01-bom-sourcing.md#14-mounts-and-print-material-38000), [§2.7](build/02-mechanical.md#27-mount-the-sensor-mast-and-compute)). **The plate had never appeared in any budget line** although [vehicle.md §3](design/vehicle.md) requires it — this row is where it now lives. **Sourced 2026-10-19, all domestic, all next-day:** 2020 profile **cut to 700 mm** [쿠팡 8531595597](https://www.coupang.com/vp/products/8531595597) ₩4,800 each — three is ₩14,400, and 700 mm is deliberate: [sensors.md §5](design/sensors.md#5-mounting-mast-concept) fixes the mast at ~0.65 m, so a cut length of 700 leaves trim and **you can only ever cut shorter** *(₩6,900 buys 900 mm if more margin is wanted)* · corner brackets [쿠팡 7260659679](https://www.coupang.com/vp/products/7260659679) ₩400 each, twelve is ₩4,800 · **T-nut + bolt + washer set, 200 pc** [쿠팡 9560823334](https://www.coupang.com/vp/products/9560823334) ₩13,850 무료배송 — taken over the ₩5,350 nuts-only set because the M5 bolts are not otherwise in the build and a T-nut without its bolt is not a fastener. **Goods ₩33,050, carriage ₩6,000** to the [Shipping row](#L900). **Plywood is NOT yet sourced and must not be** — its size is the seat footprint, which is [V4 **D3**](#v4-deck-and-payload-geometry-unblocks-14) and unmeasured; the ₩16,000 unit here carries roughly ₩15,000 of plywood as an estimate. **Buy the three metal lines now, the plate after V4.** The extrusion is safe to buy ahead of the measurement because its length is set by the mast height, which [sensors.md §5](design/sensors.md#5-mounting-mast-concept) already fixed on a tip-over argument, not by the deck. **REVISED 2026-10-19 — 900 mm, not 700, now that the seat bolts are known to be in plastic.** [쿠팡 8529591491](https://www.coupang.com/vp/products/8529591491) **₩6,900** each, three is ₩20,700, same seller and same next-day delivery. **One length per vehicle, cut into three with a hacksaw: post 500 + base rail 250 + camera boom 150 = 900, no offcut.** 700 mm leaves only an 80 mm base rail once the post and the boom are taken out, and the base rail is the part that answers the plastic anchoring — it resolves the mast moment into a push-pull couple over 250 mm instead of a point load on four bosses. **₩2,100 per vehicle buys that.** Revised goods total **₩39,350** (profile 20,700 + brackets 4,800 + T-nut set 13,850), carriage ₩6,000. **The four corner brackets per vehicle now have assigned jobs:** two at the post foot front and rear — the braking and kerb direction — and two at the boom joint above and below, which is what stops the camera drooping. The rail bolts **down through the plywood into T-nuts** in its upward slot, so it needs no bracket, and the LiDAR needs none either: a printed cap slides onto the post's top end. **Layout and cut plan: [figure](images/sensor-mast-layout.svg)**, specified in [§2.7.3](build/02-mechanical.md#272-the-layout-and-the-cut-plan). **REVISED AGAIN 2026-10-19 — the base is a cross, and the 900 mm buy does not cover it.** A single fore-aft rail ties the post to the lid 250 mm apart front-to-back and **to nothing sideways**: laterally the post is held only by the **~20 mm arms of its corner brackets**, which against a 500 mm post is a **25 : 1 lever**. Caught in review before anything was ordered. **Fix: two 115 mm lateral stubs butted to the rail's sides at mid-length, all three coplanar at 20 mm**, giving a **250 × 250 base** and **four** corner brackets at the foot instead of two ([figure](images/mast-base-cross.svg)). *Symmetry is the point: this mast exists to hold the camera↔LiDAR geometry still, vibration is omnidirectional, and a base stiff in one plane and soft in the other does not halve the problem — it hides it as a lens or calibration fault.* **Revised cut list: one 1000 mm + one 200 mm per vehicle** — post 500 + rail 250 + stubs 2 × 115 out of the long piece (20 mm spare), boom 150 out of the short one. **Buy at those lengths rather than one long bar, because the price ladder is not linear**: [1000 mm ₩6,460](https://www.coupang.com/vp/products/4310024995) is *cheaper* than 900 mm at ₩6,900, while 100 mm costs ₩3,200 against ₩2,880 for 400 mm — so the short stubs come out of the long bar, never off the shelf. [200 mm ₩1,690](https://www.coupang.com/vp/products/8528380693). **Brackets go 4 → 8 per vehicle, 24 total, ₩9,600.** Revised goods **₩47,900** (extrusion 24,450 + brackets 9,600 + T-nut set 13,850). **The whole correction costs ₩8,550 across the fleet.** **And land the fore-aft rail over one of the bay's two fore-aft supports** ([figure](images/battery-bay-layout.svg)) — free, and it puts the mast's load into chassis structure rather than mid-span plywood. **D11 added:** do those supports reach the rim plane, or stop below it? **TWO CORRECTIONS 2026-10-19, both caught by the owner before anything was ordered.** **(1) The cheap lengths quoted above are the WRONG PRODUCT.** The same 쿠팡 seller runs two listings that both carry `DF2020-xxxmm` part numbers and both surface in the same search: **`DF2020 … 프로파일`, which is the T-slot extrusion, and `앵글 DAB 2020`, which is an L-ANGLE.** The angle has **no T-slot**, so no T-nuts, no sliding brackets and no way to clamp the boom — **unusable here.** [1000 mm ₩6,460](https://www.coupang.com/vp/products/4310024995) and [200 mm ₩1,690](https://www.coupang.com/vp/products/8528380693) are both angle, and so are 400 and 500 mm. *The "non-linear price ladder" argument built on those numbers was an artefact of reading two products as one; the ladder was not irregular, the catalogue was.* **The profile lengths that actually exist: 50 · 80 · 100 · 300 · 600 · 700 · 900 mm.** **Revised buy: [700 mm ₩4,800](https://www.coupang.com/vp/products/8531595597) + [600 mm ₩4,300](https://www.coupang.com/vp/products/8530510579) = ₩9,100 per vehicle, ₩27,300 for three.** The 700 gives post 500 + boom 150; the 600 gives rail 250 + stubs 2 × 115. **170 mm spare per vehicle is deliberate** — see correction (2). **(2) There are NO fore-aft supports in the bay** — misread from a photograph. **What is there is better: three screw holes are moulded into each side of the battery recess and the retaining strap uses only one per side, leaving FOUR SPARE** that straddle the battery in a rectangle. Those are the only points inside the bay **engineered to hold something against vehicle motion**, and they sit where the mast stands. **Printed PETG pillars rise from them to the lid's underside and the base cross is through-bolted**, so the load path is **bolt → pillar → boss → chassis** with the plywood only in the sandwich — and **the seat bolts drop back to just holding a lid down** ([figure](images/battery-bay-layout.svg)). **D11 now sizes the base cross**, which is why 250 × 250 is provisional and why the offcuts are kept. Revised goods **₩50,750** (27,300 + brackets 9,600 + T-nut set 13,850). **Clarified 2026-10-19 after a second review question: the cut list reads `250 · 115 · 115`, and that is correct rather than one rail short.** Two continuous 20 × 20 bars **cannot occupy the same 20 mm layer where they cross** — stacking them lifts the post 20 mm and strands the lower pair of brackets below its foot — so **exactly one direction must be split**. The fore-aft rail stays continuous with the post standing on it; the lateral direction is two stubs butted to its sides. **115 = (250 − 20) ÷ 2**, the span less the rail's own width, halved. **Which means the base is symmetric in SPAN but not in CONSTRUCTION** — both directions reach their tie-downs 125 mm from the post axis, but fore-aft the post stands on unbroken metal while sideways the load crosses two bracket joints. **That asymmetry is chosen, not inherited:** braking and kerb strikes act front-to-back, and the camera boom overhangs forward so its mass is a *standing* fore-aft moment, while cornering is the only lateral case and this vehicle corners at walking pace. *Four 115 mm arms would be perfectly symmetric and strictly worse — all four joints would then be brackets, where this makes two of them continuous metal at the same part count and price.* **FIT CHECK 2026-10-20 — the bay is 370 × 210 × 130 deep, and the 250 mm rail does not fit it.** Twenty millimetres would hang off each fore-aft edge and the end bolts would land on nothing. **Caught by the owner on the measurements, before any cut.** **Corrected: rail 210 fore-aft, stubs 140 lateral — a 210 × 300 base.** The rotation pays twice: the **lateral span goes UP from 250 to 300**, and at 140 the stubs put their tie-down bolts **exactly on the existing seat screws**, which are 300 apart — **no new holes in that direction.** The rail's own ends then land on the bay rim, where the lid is supported anyway. **The purchase does not change** — the 700 gives post 500 + boom 150, the 600 gives 210 + 140 + 140 with 110 spare; ₩9,100 per vehicle as before. Only the cuts move. **And one claim from the previous entry is withdrawn: the battery-hole pillars are NOT the mast's load path.** At **100 mm apart** they are far too close to be a couple — 54 N·m across 0.1 m is **540 N a side**, which would strip a moulded boss. They are **local support**: they stop the lid dishing under the post and give it a hard footing. **The couple is the rim in compression plus the perimeter bolts in lift**, which is what the lid-on-a-rim argument said in the first place. **The lid itself was never oversized** — it is the size of the opening it covers. ([fit check](images/bay-fit-check.svg)) **LID DESIGNED 2026-10-20, and the last two numbers closed it.** Seat screws are **300 × 190**, four plastic screws at the corners; the rim is **10–20 mm and CURVED, not a rectangle.** **So the lid outline is TRACED, not dimensioned** — tape two A4s into an A3, press the rim edge to crease it, trim until it drops on with ~2 mm clearance, and **mark the four screw holes with a bradawl while the template is still in place**, never by measuring. A plywood rectangle cut to 390 × 230 would bear unevenly on a curved rim and **rock, which is the defect this whole design keeps chasing.** *Make one template, then check it on all three vehicles — the drive hub differed by 0.47 mm between two cars on the same chassis.* **The A4 the owner laid on the opening is the useful calibration:** A4 landscape is 297 × 210 against an opening of 370 × 210, so it is **right fore-aft and 37 mm narrow each side**, which is exactly what the photograph shows. **Base re-fitted to the screw rectangle: rail 190 fore-aft, stubs 140 lateral** — that puts all four arm ends on the seat-screw lines rather than at arbitrary positions. **Mast centred both ways**, and the three reasons agree rather than compete: laterally centred keeps the LiDAR on the vehicle centreline (an off-centre sensor is a lateral offset in every transform forever), fore-aft centred sits over the battery and the spare fixing holes so the pillars have something to stand on, and it is clear of the controller at the right rear where the vent must go. **And the mast base needs no new holes in the chassis at all** — it bolts to the lid, the lid bolts to the four seat screws and bears on the rim. **Plywood: blank 400 × 240 per vehicle; three come off one 450 × 750 board of 12 mm birch, a standard 쿠팡 목재재단 line at about ₩15,000.** **One measurement still blocks the vent cut: the controller cover's footprint and position relative to a lid corner.** ([lid design](images/lid-design.svg)) **CART CHECKED 2026-10-20 — all four lines correct, and they are the PROFILE listing, not the angle.** `DF2020-600mm × 3` ₩12,900 · `DF2020-700mm × 3` ₩14,400 · 200 pc T-nut/bolt/washer set × 1 ₩13,850 · `AL 브라켓 20용` × 24 ₩9,600. **Goods ₩50,750, carriage ₩6,000** (₩3,000 to the profile seller, ₩3,000 to the bracket seller; the T-nut set is 판매자로켓 무료배송) — **₩56,750 at the till**, exactly the figure this row carries. Both profile lines read *DF2020(20x20) … 프로파일 브라켓/ 알미늄/ 대영*, **not** 앵글 DAB, so the 2026-10-19 trap was avoided. 24 brackets is 8 per vehicle as specified. Profile and brackets arrive 10/22, the T-nut set 10/21. **Plywood sourced 2026-10-20 — buy a board and cut it, not a cut-to-size quote.** **[자작나무합판 무절 600 × 1200 × 12 mm, 쿠팡 8148623270, ₩23,060](https://www.coupang.com/vp/products/8148623270)** (착불배송, so budget ~₩6,000 freight on a bulky board). Three lid blanks at 400 × 240 use 400 × 720 of it, and **the remainder is not waste on a sixteen-week course with thirteen students** — it is test cuts, enclosure backing and the lid someone ruins. **Birch, not plain 합판, and the reason is edge distance:** the lid's hold-down screws sit about **10 mm from its edge**, and **무절 birch has no voids** where a plain veneer sheet might put one right under a bolt. [베니어 일반합판 11.5 mm, 1200 × 600, ₩14,000](https://www.coupang.com/vp/products/7910005788) saves ₩9,000 and has far more reviews — **take it only if the hold-down gets a steel strip or large penny washers to spread the bearing.** *A cut-to-size service was considered and dropped: the outline is traced from a template, so a factory rectangle buys nothing.* **LID FINALISED 2026-10-20 — and it is simpler than the template method, but it has a hold-down problem the template method would have hidden.** The 370 × 210 included the body's **curved raised ends**; excluding those, **a plain 320 × 215 rectangle drops in and covers the opening**. So the traced-template instruction is withdrawn — this is a rectangle and a saw cut. **CUT ORDER: 320 × 215 mm, 12 mm, FOUR pieces** (four not three — thirteen students, and one lid will be ruined). Four stack in a 320 × 860 column of the 600 × 1200 board, leaving 280 × 1200 of offcut. *If a cut comes out a millimetre proud, sand it; a millimetre undersize is harmless because the rim is 10–20 mm wide. Oversize is the only error that stops it dropping in.* **THE REAL FINDING: the vehicle gives only TWO fixings, both on one edge** — (10, 25) and (310, 25). A lid bearing on a rim needs **compression on one side and tension on the other**; the rim supplies compression everywhere, but **tension needs a fastener, and there are only two, both at one end.** Lean the mast away from them and the screws hold; lean it toward them and **the far edge hinges up with nothing there.** **Fix, and it costs nothing: the two spare battery bosses become the second anchor pair.** The rail takes **four bolts** — its **ends** into the lid 165 apart, which is the couple that resists the mast, and its **middle pair** through the lid into printed pillars on the battery bosses, which is what stops the hinge. *That finally gives those bosses a job their 100 mm spacing can actually do — holding a lid down, not resisting a moment.* **ORIENTATION IS LOAD-BEARING: fit the lid with the two screws at the REAR.** The camera boom overhangs forward, so there is a **permanent forward-tipping moment**; forward lean presses the front edge onto the rim and lifts the rear, which is exactly where the screws are. Fitted the other way round, that standing load rides on the pillars all day. **Base re-fitted to the 320 × 215 lid: rail 165, stubs 125 — a 165 × 270 base**, keeping 25 mm of edge distance for every bolt in 12 mm plywood. **The extrusion order is unaffected:** 700 → post 500 + boom 150 (50 spare); 600 → 165 + 125 + 125 (185 spare). **Nothing in the cart needs changing.** ([lid design](images/lid-design.svg)) **ORDERED 2026-10-20, two orders, ₩73,810 of goods.** *Profile* `DF2020-700mm` ×3 ₩14,400 + `DF2020-600mm` ×3 ₩12,900 · *brackets* `AL 브라켓 20용` ×24 ₩9,600 · *fasteners* 200 pc T-nut/bolt/washer set ×1 ₩13,850 — **₩50,750**, carriage ₩6,000 to the [Shipping row](#L900). *Plywood* [자작나무합판 무절 600 × 1200 × 12](https://www.coupang.com/vp/products/8148623270) ×1 **₩23,060**, **착불배송 — the freight is unknown until the parcel lands** and is the only figure still open on this row. **Arrivals: T-nut set 10/21; profile, brackets and plywood 10/22.** **ACTION BEFORE THE BOARD IS CUT — the cut list has to reach the seller.** The order shows 결제완료 with no cut specified, and the free cutting is arranged through 판매자 문의. **Send: `320 × 215 mm, 4 pieces`.** If it ships uncut that is not a failure — the offcut plan survives either way and a jigsaw does the job — but **it has to be decided rather than discovered.** **On arrival:** confirm the board is genuinely 12 mm and 무절 *(the whole reason birch was chosen is that a void under a hold-down screw 10 mm from the edge is a screw that pulls through)*, and check the 착불 charge against this row before it disappears into a courier receipt. **ARRIVED — complete 2026-10-23.** Profile (both lengths), brackets and the T-nut set landed **2026-10-21**, a day early; the plywood **2026-10-23**, a day late, and it is the one that closes the row. **Four checks, and the second is the one that could stop the build.** **(1) The profile is T-SLOT, not angle** — hold a piece up and look down the end. This is the 2026-10-19 trap and it is worth thirty seconds. Count 3 × 700 and 3 × 600. **(2) TRY A T-NUT IN THE SLOT BEFORE CUTTING ANYTHING.** The T-nut set and the profile came from **different sellers**, and "2020" fixes the outside but **not the slot width** — a nut that does not drop in makes every bolt in the mast design homeless. *Nothing downstream is recoverable once the 600 is cut into three.* **(3) Plywood: confirm 12 mm and 무절**, and record whether it came cut to **320 × 215 × 4** or as the full 600 × 1200 board. **(4) The plywood was 착불 — get the freight figure and put it in the [Shipping row](#L900)** before it disappears into a courier receipt. It is one of the two numbers still open on this build. **2026-10-26 — THE T-NUTS DO NOT FIT THE PROFILE, and the pre-cut check is what caught it.** The 200-piece set was bought from one seller and the `DF2020` from another, and *"2020" fixes the outside, not the slot* — which is why this row carried **"try a T-nut in the slot before cutting anything"** as check (2). **Nothing has been cut, so nothing is lost but the ₩13,850.** *This is the third time on this build that a fastener was bought without confirming it against the part it mates with — the angle-versus-profile listing, the flat grub screws, and now these. The difference is that this one was caught by a check written in advance instead of by a photograph afterwards.* **Measured slot figure: 7.5 mm, and it does not resolve the question on its own** — a 7.5 mm **opening** would admit a standard 5.8 mm-wide M5 T-nut easily, while a 7.5 mm **internal cavity** would stop a 9.5 mm nut from rotating into place, and those point at opposite fixes. **An end-on photograph of the extrusion settles it in one look**, which is what is needed next. **The fallback that works on any slot geometry: drill the rail through both walls and bolt straight through with a plain nut.** It gives up the T-slot's sliding adjustment and wants a drill press for a square hole, but it depends on nothing about the profile — worth holding in reserve rather than ordering a second set of nuts on another guess. **End-on photograph received 2026-10-26, and it does not settle it — said plainly because guessing from a photograph has already cost this build once.** *The "two fore-aft supports" that turned out not to exist came from reading a photograph confidently; the price of repeating that here is a second wrong box of nuts.* **The decisive test needs no measurement at all: SLIDE a T-nut into the slot from the CUT END of a piece.** A nut that will not *rotate* in may still *slide* in and be captured by the lips — and **this mast never needs a drop-in nut.** It is a fixed assembly, not an adjustable rig, so **every nut can be loaded from an end before its piece is bolted up.** If it slides, the problem dissolves and the only cost is a **build-order rule**: **load every nut a piece will ever need before bolting it in place**, because adding one later means taking the joint apart. **Count them first, too** — roughly **26 nuts per vehicle** across rail, stubs, post and boom, which is ~78 for the fleet against a 200-piece set that is nuts *plus* bolts *plus* washers. **If it will not even slide**, the nut is the wrong series and what is then needed is the **slot opening** and the **internal cavity width**, measured — or the through-bolt fallback, which assumes nothing about either. **2026-10-26: 7.5 mm is the OPENING, and that points at the NUT rather than the profile.** A 7.5 mm opening is *wider* than the 6 mm EU 20-series standard, so a proper M5 20-series nut (~6 × 10) would drop straight through it with room to spare. **The likeliest reading is that 7.5 was taken across the chamfer at the outer face** — a 6 mm slot with 0.75 mm lip chamfers measures 7.5 at the surface and 6.0 just inside. *Confirm by measuring at the NARROWEST point, a millimetre below the face, before any nut is ordered.* **Root cause: the set bought has no series on it at all.** *"200PCS 알루미늄 프로파일 조립용 T너트"* names no profile family, and Korean sellers label these **`20용` / `30용` / `40용`** precisely because the families are not interchangeable. **A generic set is a set for somebody else's profile.** Same shape of error as the 앵글-for-프로파일 listing and the flat grub screws: *the mating dimension was never stated and was never asked for.* **Replacement, and it splits by job rather than by price.** **Structural joints — rail, stubs, post foot, boom — take plain [사각너트 20용 M5, 쿠팡 7230559180](https://www.coupang.com/vp/products/7230559180) at ₩40 each**, loaded from the cut end during assembly; about **20 per vehicle**. **Sensor mounts take [스프링너트 20용 M5, 쿠팡 8645086531](https://www.coupang.com/vp/products/8645086531) at ₩200 each**, about **6 per vehicle** — a spring nut **clips in anywhere along the slot and holds itself**, so a nut can be added without dismantling the joint. **That is not a luxury: it is the reason this build chose extrusion.** [§2.7.2](build/02-mechanical.md) justifies the T-slot on *"sensor height becomes adjustable without reprinting a bracket"*, and **adjusting a height means adding or moving a nut on an assembled mast** — which a slide-in nut cannot do. *Roughly ₩2,400 + ₩3,600 of nuts plus carriage, against ₩13,850 already spent on nuts for somebody else's profile.* **Settled 2026-10-26: the 7.5 was the outer channel between the corner bosses, not the lips. The lip-to-lip gap is ~6 mm — a standard EU 20-series slot.** *(Owner's reading, holding the part. Taken over mine: I had already said I could not read this section reliably from a photograph, and saying it and then overriding it would be worse than not saying it.)* **So the profile is ordinary and the nuts are simply the wrong family — stop measuring and buy the right ones.** A generic set can carry an M5 nut that is a **30- or 40-series** M5: same thread, bigger body, and any of **width, length or THICKNESS** can be the one that blocks it. Chasing which costs more than the parts do — **₩40 a nut, ₩200 for a spring nut.** **Acceptance on arrival, before anything is cut: drop one nut in, turn it, tug it. Ten seconds.** **And a bonus this section turns out to offer: the four CORNER BORES.** They take an end-fastener straight into the extrusion's end face, which needs **no T-nut at all** — worth remembering as the escape route if any joint turns out to be awkward, and it costs nothing to know now. **Correction 2026-10-26: "buy the nuts" was too narrow — but the ₩13,850 is NOT all wasted.** **An M5 bolt is an M5 bolt in any profile series**, so **the bolts and washers in that set are still good**; only the nuts are the wrong family. **Check what LENGTHS the set actually carries**, because this mast needs three and a generic set usually stops short of the long one: **M5 × 10** for the bracket legs (~20 per vehicle), **M5 × 20** for the lid tie-downs at the rail and stub ends — **12 mm of plywood plus a penny washer plus nut engagement is already ~18 mm**, so a ×10 or ×16 will not reach — and **M5 × 40-ish** for the lid-to-pillar bolts, whose length cannot be fixed until **D12** gives the pillar heights. **Pillars also need an M5 nut captive in the top of each print**, which is how the long run is avoided: *bolt down from above into the pillar's own nut, and fix the pillar to the battery boss separately from underneath — otherwise that fastener is a 100 mm bolt through rail, lid, pillar and into a moulded boss.* **Assembly order follows from it: pillars in first, then the lid, then bolt down.** **SIMPLIFIED 2026-10-26 — drop the spring nuts; buy square nuts and load them generously.** *Checking the carriage exposed that my own recommendation was over-built.* The two listings are **different sellers** (동원테크 / 동원종합상사, different couriers), so splitting the order would cost **₩6,000 of carriage on ₩8,000 of goods**. That prompted the right question, which was not *"can the carriage be merged"* but **"is the spring nut needed at all?"** **It is not. A slide-in nut, once in the slot, slides freely along it.** The adjustability this build bought extrusion for — moving the camera or the LiDAR up and down — is *loosen, slide the bracket and its already-captive nuts, re-tighten.* **No new nut is introduced.** A spring nut is only needed to add a bracket somewhere no nut was pre-loaded, and the fix for that is **load spares at assembly**: ten extra per vehicle costs **₩1,200 for the fleet**. **Order: [사각너트 20용 M5, 쿠팡 7230559180](https://www.coupang.com/vp/products/7230559180) × 100 = ₩4,000 + ₩3,000 carriage** (동원테크, 94 % / 290, 모레 도착). ~30 per vehicle against ~20 needed, the balance pre-positioned as spares. **One seller, one carriage, one part number.** **Build note that follows: a loose nut in a VERTICAL slot falls out of the bottom.** Load the post's nuts and immediately snug the lowest bracket to trap them — same family of rule as *load every nut before bolting the piece up.* **BOLTS 2026-10-26 — the set tops out at 12 mm, and working out why led to a simpler answer: EVERYTHING IS M5 × 20. There is no ×40.** `M5 × 20` is measured **under the head**, which the owner confirmed, and 12 mm will not even cross the lid. **Required length, counted rather than guessed:** penny washer ~1.5 + plywood 12 + the profile's slot lip ~2 + nut engagement ~2 = **17.5 mm**, so ×20 with 2.5 mm into the slot cavity, which is ~10 mm deep and cannot bottom. **The ×40 disappeared when the pillar geometry was actually worked through.** The battery's spare holes are **three per SIDE**, so the pillars stand **beside the rail, not under it** — which means the pillar bolt drops **from above, through the lid, into a nut captive in the pillar's printed top**: 12 + 4 = 16 mm. *The 100 mm run I was worried about only existed because I had the pillars under the rail, where no bolt could have reached them from either direction. **The geometry was wrong, not the fastener.*** **Record the pillars' x offset with D11** — it is what makes this true. **Count: 4 lid tie-downs (rail and stub ends, from below) + 2 pillar bolts (from above) = 6 per vehicle, 18 for the fleet; buy 24.** **Take [올커버 M5 × 20, 쿠팡 9358209465](https://www.coupang.com/vp/products/9358209465), 30 pcs ₩8,860, SUS304, 무료배송, next-day.** *Its title says "육각 렌치 볼트" in search and "육각 볼트" on the page — the same inconsistency that has bitten this build twice. Taken anyway, and the reason is proportionality: **a hex head instead of a socket head still works under a washer.** Spend the extra on explicitness where being wrong is expensive — a grub-screw point decides whether the ring holds, an angle-versus-profile is unusable — and not where the worst case is reaching for a different spanner.* **Confirm `20mm` is selectable under `M5` before paying;** the option row read 6·8·10·12·14·25·30·40·50 with the size set to M3. **Fastener schedule written out 2026-10-26, because the question kept coming back in pieces.** **The AL brackets never touch the plywood** — they join **profile to profile**, and the profile bolts to the lid **directly** through a T-nut in its own bottom slot. Two different joints, two different bolts. **Per vehicle: 16 × M5 × 10** (eight brackets, two bolts each) **and 6 × M5 × 20** (four lid tie-downs from below, two pillar bolts from above), against **20 T-nuts** in slots. **The ×10s come out of the set already bought** — its M5 bolts were never the problem, only its nuts — **so the only bolt that had to be ordered is the ×20**, which is exactly where that set stops short. Full table at [§2.7.2](build/02-mechanical.md#272-the-layout-and-the-cut-plan). **STILL TO BUY on this row, 2026-10-26: M5 PENNY WASHERS.** The design calls for them in five places — *"penny washer under every amber bolt"*, *"large backing washers under the plastic"* — **and nothing has ever bought any.** [#12](#L12) carries wire, fuses, XT60 and capacitors but no washers, and the failed T-nut set's washers are ordinary M5, ~Ø10. **Ø10 is not a backing washer.** They are spreading bolt load into **12 mm plywood** and into **moulded body plastic**, which is the entire reason the lid bears on a rim rather than on four bosses — *a design that spreads load and then concentrates it under a Ø10 washer has given the argument away at the last step.* **Buy M5 penny washers, Ø15–20, about 40 per vehicle.** **NUTS AND BOLTS ORDERED 2026-10-26** — 사각너트 20용 M5 and M5 × 20. *The charge is not yet in this row's Paid figure; add it from the receipt rather than from what was quoted, which is how the VAT trap was caught twice.* **AND A CORRECTION TO MY OWN FIGURE: the penny washers are ~6 per vehicle, not 40.** *I counted "one under every bolt" without checking which bolts need one.* **The 16 bracket bolts do not** — a corner bracket IS the bearing surface, spreading its own load into the slot. **Only the 6 that pass through plywood do**: four lid tie-downs and two pillar bolts. So **~20 for the fleet, buy 40.** *Had the first number gone out, it would have bought five times what is needed — the sort of error that is invisible because nothing fails, it just sits in a drawer.* **Source: [굿나잇몰 스텐 와셔 M5 × 18 × 1T, 쿠팡 9099303748](https://www.coupang.com/vp/products/9099303748), 10개 ₩900 — four packs ₩3,600 + ₩3,500 carriage.** Ø18 against a standard M5 washer's Ø10, and **stainless**, which matters because some of these sit on an outdoor vehicle. *A 1000-piece bag at ₩7,290 exists ([쿠팡 9669507964](https://www.coupang.com/vp/products/9669507964), Ø16) and is cheaper per piece, but it is bare steel — fine under the lid, rust on the mast.* **Still unsized: the backing washers under the SEAT screws.** Those are the vehicle's own plastic screws and nobody has recorded their thread, so they cannot be bought yet. **PAID, from the receipt 2026-10-26: ₩15,860 at the till.** Bolts **₩8,860** (무료배송) + square nuts **₩4,000** + carriage **₩3,000** — goods **₩12,860** into this row, carriage to the [Shipping row](#L900). Row total **₩86,670**, and `paid = unit × qty` lands exactly. **Worth saying out loud: the #14 line is now spent.** ₩35,600 on [#14](#L14) plus ₩86,670 here is **₩122,270 against the ₩123,000 approved — ₩730 left.** The penny washers at ~₩7,100 take it **₩6,370 over**, which needs no approval because only the total binds, but it does mean **this line stops absorbing surprises.** Anything further on mounts comes out of the headroom, visibly, rather than out of a line that looked like it still had room. *(Ordered date stays **2026-10-20**, the first order. Setting it to the 26th made the row read "arrived 10-23, ordered 10-26" — arrived before it was ordered. The nuts and bolts are a follow-on inside the same line, not a new one, and **the row cannot be secured until they land** because the T-nut fit is one of its checks.)* **PENNY WASHERS ORDERED 2026-10-26 — M5 × 18 × 1T stainless, four packs of ten, ₩3,600.** Forty against the ~20 the fleet needs. *The carriage is not in this row yet: that listing shows ₩3,500 as 조건부 무료배송 and ₩3,600 of goods probably does not clear the threshold — **confirm the till figure** rather than assume either way.* **And this is the purchase that tips the #14 line over, exactly as predicted one entry ago.** ₩35,600 + ₩90,270 = **₩125,870 against ₩123,000 approved — ₩2,870 over before carriage.** *Recorded plainly because the useful thing is not that it went over — only the total binds — but that it went over **where and when the previous entry said it would.** A line that is called spent and then quietly absorbs one more thing is how a budget stops meaning anything.* **With this, every part on this build is bought.** | **ALL FOUR RECEIPTS RECONCILED 2026-11-04, and the row was already right to the won.** Goods net of carriage and the 쿠팡 discount: mast order `2103729802003` ₩52,290 − ₩1,540 할인 = **₩50,750** (DF2020-700 ×3 ₩14,400 · DF2020-600 ×3 ₩12,900 · AL 브라켓 ×24 ₩9,600 · 200 pc T-nut/bolt/washer set ₩15,390) · plywood `2103729946920` **₩23,060** · penny washers `2103864346113` **₩3,600** · M5×20 bolts + 사각너트 `2103862609371` **₩12,860**. **Total ₩90,270 — exactly the Paid figure.** *Four orders, two sellers, three weeks apart, and nothing drifted; that is what the goods-only convention on these rows buys.* **AND IT CLOSES THE LAST OPEN CARRIAGE QUESTION: the plywood receipt shows 배송비 ₩0.** The [Shipping row](#L900) has carried *“the plywood is 착불 and is NOT in this figure yet”* since 2026-10-20. **It was not 착불 — the ₩23,060 is delivered.** *One caveat kept rather than buried: 착불 is paid at the door and would never appear on a 쿠팡 receipt, so this proves the ORDER carried no freight, not that no cash changed hands. If anything was handed over on delivery it is still unrecorded.* **Carriage for this row totals ₩12,500** — mast ₩6,000 · plywood ₩0 · penny washers ₩3,500 · bolts ₩3,000 — all on the [Shipping row](#L900).|
| 15 | USB gamepad — Logitech F710 class | 3 | [옥션](https://itempage3.auction.co.kr/DetailView.aspx?ItemNo=E428299758) | 66,680 | 2026-09-29 | 2026-10-20 | 3/3 | 200,040 | ₩64,000 est → **₩66,680 actual**. Xbox layout; record the map if not **ARRIVED 2026-10-20 — twenty-one days after order, the longest-outstanding line on the build.** Not yet secured; the check is in two parts and the second one is the one that bites. **(1) Count three, and confirm each powers up and pairs** — an F710-class pad is **wireless on a 2.4 GHz dongle**, so each unit has a dongle that must stay with it. *Bag and label them as pairs now*: three loose dongles and three loose pads on a bench in week three is an afternoon lost. **(2) Record the actual button and axis map per unit** with `ros2 topic echo /joy`, because that is what the teleop node is written against, **and check the X/D switch position** — the F710 class has a hardware slider that changes the mapping wholesale between XInput and DirectInput. **A pad flipped to the wrong mode presents a different axis order and reads as a broken teleop node**, which is an expensive thing for a student to debug. Fix the switch to **X** on all three, then record the map. **SECURED 2026-10-20 — three pads, three dongles, batteries included.** The `/joy` map check is **deferred rather than skipped**: the owner has used F710s before and knows the layout, so it is not an acceptance risk. But **the map still has to be written down for thirteen students**, and that belongs in the teleop lab where they will read it, not in a procurement row. **Set the X/D slider to `X` on all three before they go in the box** — it changes the axis order wholesale, and a pad in the wrong mode reads as a broken teleop node. |
| | **Batch 1** | | | **973,930** | | | | | **× 3 = 2,921,790** |

> [!CAUTION]
> **Do not let #9 slip to a later order**
>
> The Pololu RC signal MUX is **₩31,680 and it is the condition the single-Teensy architecture was
> adopted under** ([safety.md §1.2](design/safety.md#12-live-override-inside-dbw-mode-two-layers)).
> Pololu list it as **"Rationed"** at source, so the domestic listing is the whole supply as far as
> this build is concerned. A cheap part on allocation is exactly the one that arrives last.

### Sourcing reference

Verified vendors, prices, links and the date each was read live in
**[Build Guide §1.2.1](build/01-bom-sourcing.md#121-sourcing-in-korea-verified-2026-09-15)**. It is
not repeated here — a second copy of a price table is a second copy to keep current.

### Why some of these parts are not interchangeable

Three notes worth re-reading at the moment of ordering, when a cheaper option is in front of you.

> [!CAUTION]
> **#10 — read the 구성품 table, not the product title**
>
> The transmitter is not the risk; the receiver is, and the difference is one letter.
>
> | | Outputs | Usable here? |
> |---|---|---|
> | **FS-iA6** | PWM only | **No.** No serial stream, so [Layer A](design/safety.md#12-live-override-inside-dbw-mode-two-layers) cannot be built on it |
> | **FS-iA6B** | PWM + PPM + **i-BUS** (+ s.bus per the vendor spec) | Yes |
>
> **팰콘샵 `100004832` is titled "… + iA6 6채널 수신기 포함" and ships the iA6B.** Its own
> specification table reads `Product Model: FS-iA6B`, `Data port: PWM / PPM / i.bus / s.bus`. The
> title is stale; the contents are correct — the same failure as the
> [Sabertooth listing](build/01-bom-sourcing.md#121-sourcing-in-korea-verified-2026-09-15), where a legacy SKU string sat
> above an accurate description.
>
> Two related listings that are *not* the set, and are easy to grab by mistake:
>
> - 팰콘샵 **`100004833`** — the **iA6B receiver alone**, ₩31,000, no transmitter
> - 알씨뱅크 `93882`, FirstBot — genuinely bundle the plain **iA6**
>
> **Verify on arrival regardless of what any listing said.** The iA6B has a physically separate
> **i-BUS port** beside the servo channels; the iA6 does not. Look at the board, not the box.
>
> If a wrong-receiver bundle does arrive it is recoverable — ₩31,000 for a separate iA6B, and the
> iA6 becomes a spare PWM receiver. Money, not a redesign.
>
> **Closed 2026-10-01: all three receivers are iA6B, i-BUS port present on the board.** The
> component table was right and the listing title was wrong, which is why the check was written
> against the board rather than against any listing. [Layer A](design/safety.md#12-live-override-inside-dbw-mode-two-layers)
> is buildable as designed; no contingency spend.

> [!IMPORTANT]
> **#10 — buy **Mode 2**, and drive from the right stick**
>
> Mode 1 and Mode 2 are an *aircraft* convention for which stick holds throttle. This is a car, so
> the question is really: **which stick self-centres?**
>
> | | Left stick | Right stick |
> |---|---|---|
> | **Mode 2** | throttle (V, **ratcheted**) + rudder (H) | elevator (V) + aileron (H) — **both spring-centred** |
> | Mode 1 | elevator (V) + rudder (H) | **throttle (V, ratcheted)** + aileron (H) |
>
> On the FS-i6 the throttle gimbal is **physically ratcheted** — it stays where you leave it, which
> is correct for an aircraft and wrong for this vehicle. Mode 2 puts that ratchet on the **left**
> stick, leaving the entire right stick self-centring.
>
> **So: Mode 2, and map the vehicle to the right stick.**
>
> | Function | Channel | Stick |
> |---|---|---|
> | Steering | CH1 (aileron) | right stick, horizontal |
> | Throttle | **CH2 (elevator)** — *not* CH3 | right stick, vertical |
> | MUX `SEL` | CH5 or CH6 | a two-position switch (SwA–SwD) |
>
> Using CH2 rather than the nominal throttle channel is the whole point: **release the stick and the
> vehicle stops and straightens**, which is what
> [failsafe rows 1–3](design/safety.md#2-failsafe-matrix) already specify. It also makes the right
> stick behave exactly like the gamepad's (#15), so an operator switching between them does not
> have to re-learn anything.
>
> This matters most in **Layer B**, where the MUX routes the receiver *straight to the motor driver*
> with the Teensy out of the loop entirely. There, stick position **is** motor command — nothing is
> going to zero it for you. A ratcheted throttle in that path means letting go leaves the vehicle
> driving.
>
> **Buy Mode 2 units; do not buy Mode 1 and switch it in the menu.** The menu remaps the channels
> but cannot move the ratchet, which leaves a transmitter whose labels and springs disagree. Order
> all three the same.

> [!CAUTION]
> **#6 was one line hiding four parts, and one of them was never funded**
>
> Split into **6a–6d** above and moved to Batch 1G, because three of the four cannot be specified
> until the vehicle is on the bench.
>
> - **6a encoder** — could in principle be bought now, but **quadrature A/B and 3.3 V logic** are
>   hard requirements that the old line never stated. The Teensy 4.1 is **not 5 V tolerant**
> - **6b adapter** — the BOM's `3.15 mm` is *B-MROVER's* motor shaft. [ADR D-R](design/vehicle.md)
>   then changed the vehicle class entirely, so that number has no remaining basis here
> - **6c bracket** — **never in the BOM at all.** [02-mechanical §2.6](build/02-mechanical.md)
>   requires the encoder body bracketed to the motor mount; #13 is the steering coupler and #14 is
>   the sensor mast. Without it the body turns with the shaft and reads zero
> - **6d** — fasteners and cable tie-downs
>
> Full specification, including the decision tree for what the teardown finds:
> **[§1.2.3](build/01-bom-sourcing.md#6-drive-encoder-what-to-actually-buy)**.

> [!WARNING]
> **#15 and #10 are not the same thing, and you need both**
>
> The **gamepad (#15)** is a software input: `joy_node` reads it and its Twist goes through
> `twist_mux`, so a firmware or laptop hang takes it down too.
>
> The **RC transmitter (#10)** is the hardware override, switching servo pulses through the MUX with
> no software in the path at all.
>
> Buying only one leaves either no convenient teleop, or no firmware-independent override.

> [!CAUTION]
> **#3 Sabertooth 2x32 — unavailable as of 2026-09-30. Candidate replacement below**
>
> The order placed 2026-09-29 was cancelled by the vendor: **no stock, no ETA.** The row above is
> cleared; nothing is committed.
>
> **What a replacement must do**, from the design rather than from preference:
>
> | | Requirement | Why it is not negotiable |
> |---|---|---|
> | 1 | **Accepts R/C servo pulses** | The [Pololu #2806 MUX](design/dbw.md#112-hardware-rc-signal-mux-the-d3-condition) multiplexes *servo pulses only*. [ADR §4](design/dbw.md#4-adr-motor-driver-control-mode-independent-rc-teensy-as-both-masters) was **reverted** from packetized serial for exactly this reason |
> | 2 | **Stops the motors when the pulses stop** | [Failsafe rows 6 and 8](design/safety.md#2-failsafe-matrix), [FMEA row 9](design/safety.md#7-fmea-lightweight) — severity 5. Traction must die with **no software involved** |
> | 3 | **Two independently controlled channels** | M1 steering, M2 paralleled drive |
> | 4 | 12 V, adequate current, limiting + thermal | The paralleled stall current is still unmeasured |
>
> **Requirement 2 is the one that eliminates most of the market.** Plenty of dual drivers take RC
> pulses; far fewer stop when the pulses stop, and a driver that holds its last command when its
> controller dies is the *stale-setpoint-with-live-actuator* state the design calls more dangerous
> than a stop.
>
> **Leading candidate: Cytron SmartDriveDuo-30 (MDDS30).** Verified against its
> [user manual](https://makermotor.com/content/cytron/pn00218-cyt14/MDDS30_User_Manual.pdf) rev 1.11,
> not from a product blurb:
>
> | | Sabertooth 2x32 | Cytron MDDS30 |
> |---|---|---|
> | Continuous / peak per channel | 32 A / 64 A | **30 A / 80 A** |
> | Voltage | 6–30 V | **7–35 V** |
> | R/C pulse input | yes | **yes** — `SW1:SW2 = 00` |
> | Independent dual control | yes | **yes** — `SW3:SW4 = 11`, "INDEPENDENT BOTH" |
> | **Signal-loss stop** | yes | **yes — 100 ms**, `SW6 = 0` |
> | Current limit + thermal | yes | yes |
> | Price | ₩250,000 | **$76–87** (≈₩104,000–119,000) |
>
> Slightly less continuous current, more peak, wider voltage, and roughly **half the price** — on a
> driver the BOM already calls oversized for this drivetrain.
>
> > [!WARNING]
> > **`SW6 = 1` disables the timeout, and the manual says so plainly**
> >
> > *"The centre point is fixed at 1.5 ms and the timeout feature is disabled. Motor will continue
> > to run…"*
> >
> > That single DIP switch is the difference between satisfying failsafe row 6 and silently
> > violating it. **`SW6` must be OFF**, and it must be *verified on the bench*, not assumed from
> > the factory default. Add it to the Stage 1 checklist.
> >
> > Also operational: *"The RC transmitter must be ON before power up."* That changes the bring-up
> > order and needs re-checking against [safety.md §6](design/safety.md#6-bring-up-protocol-staged-wheels-off-first).
>
> **Still to settle before ordering** — none of these are blockers, all are unverified:
>
> - **Korean stock.** Seeed is out of stock; Makermotor (US) lists it. No Korean distributor found.
>   Lead time is the reason the Sabertooth order was placed domestically in the first place.
> - **NTREX `NT-M-DCDM2430`** — dual 30 A, 7–36 V, RC and joystick input, sold through
>   **디바이스마트**, i.e. domestic and fast. Korean-made. **Its signal-loss behaviour is
>   undocumented in anything found so far** — get the manual and check requirement 2 before
>   considering it, because that is the requirement it is most likely to fail.
> - **Sabertooth 2x25 V2** — same family, same manual, same DIP layout, same $124.99. The
>   lowest-risk swap if it is in stock anywhere, since nothing else in the design changes.

> [!NOTE]
> **One driver actuates the whole vehicle — there is no second motor driver in this BOM**
>
> The Sabertooth is **dual channel**, and both channels are used
> ([dbw.md §11.3](design/dbw.md#112-hardware-rc-signal-mux-the-d3-condition)):
>
> | Input | Output | Drives |
> |---|---|---|
> | S1 | **M1** | steering gearmotor (#4) |
> | S2 | **M2** | the two rear traction motors, **paralleled** |
>
> So #4 needs no driver of its own. Note this project **inverts mrover's assignment** — mrover uses
> M1 = throttle, M2 = steering. If you reuse an mrover harness or printed enclosure, the wiring
> differs; [dbw.md §2.1](design/dbw.md#2-steering-actuation-design) records why.
>
> The rear pair sharing one channel is also why there is no differential and why only one shaft is
> instrumented — see [ADR C](design/dbw.md#8-adr-c-drive-distance-encoding) for what that costs
> odometry.

> [!NOTE]
> **Why the Sabertooth costs what it costs**
>
> The price does not buy amps, it buys three properties, in descending order of how binding they
> are:
>
> 1. **It accepts R/C servo pulses.** The [Pololu #2806 MUX](design/dbw.md#112-hardware-rc-signal-mux-the-d3-condition)
>    multiplexes *servo pulses only*, so any driver downstream of it must take pulses directly.
>    Architecture, not budget.
> 2. **It stops the motors when the pulses stop.** [Failsafe rows 6 and 8](design/safety.md#2-failsafe-matrix)
>    and [FMEA row 9](design/safety.md#7-fmea-lightweight) — D3's principal risk, severity 5 — all
>    lean on this. When the Teensy hangs, traction must die with **no software involved**.
> 3. **It survives and limits stall current**, with thermal protection.
>
> Property 3 is the one still unsettled: the paralleled drive-motor stall current has never been
> measured. Record it in [§Measurements](#measurements-to-record-on-arrival) when you can. If it
> comes in low, that is evidence for the *next* build, not a reason to re-buy this one.
>
> **Do not substitute a bare H-bridge.** It fails on property 1 before current even matters.

---
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
