jrkwon/mrider/docs/purchase-request-2026-fall.md

# Purchase Request — MRider Platform, Fall 2026

**Requested by:** Jaerock Kwon, BIMI Lab · **Course:** 자율주행미들웨어응용 (Autonomous Driving
Middleware Applications) · **Prepared:** 2026-09-21 · **Budget ceiling:** ₩4,000,000

> 한국어본: [구매 요청서 (Korean)](purchase-request-2026-fall-ko.md)

---

## Summary

| | |
|---|---|
| **Requested** | **3 complete vehicle sets** |
| **Total** | **₩3,921,480** |
| **Against ceiling** | 98.0% — **₩78,520 remaining** |
| **4 sets** | **₩5,228,640 — exceeds the ceiling by ₩1,228,640. Not requested.** |

Each set is one drive-by-wire research vehicle: a 12 V ride-on chassis converted to computer
control, with the sensing needed for autonomous navigation. Students work in four subsystem teams
and merge onto the vehicles late in the semester.

> [!IMPORTANT]
> **Why three and not four**
>
> Four sets do not fit, and not narrowly. Even **stripped of every perception component** — no
> LiDAR, no camera, no IMU — four sets come to **₩4,275,720**, still ₩275,720 over the ceiling.
>
> A fourth set cannot be reached by reducing scope; it needs roughly ₩1.3 M more. Three complete
> sets fit with ₩78,520 in hand.

---

## Per-set bill of materials

Prices are **KRW, VAT included**, as listed by the vendor on **2026-09-21**. The **Basis** column
states how each price is known.

| | |
|---|---|
| **V** | Verified — read from the vendor's own product page |
| **L** | Lead — vendor identified, price from an aggregator, not yet confirmed |
| **E** | Estimated — converted from the design BOM at 1 USD = 1,362 KRW |

### Tier 1 — vehicle and drive-by-wire core

| # | Item | Purpose | Vendor / URL | Unit (₩) | Basis |
|---|---|---|---|---:|:-----:|
| 1 | Vehicle, 12 V single-seat ride-on | The platform itself, converted from a remote-control toy into a computer-controlled research vehicle | 쿠팡<br>`https://www.coupang.com/vp/products/9597329401` | 229,000 | V |
| 2 | Teensy 4.1 microcontroller | Real-time controller: closes the steering position loop at ≥200 Hz, shapes throttle, reads encoders, runs the safety supervisor | 디바이스마트<br>`https://www.devicemart.co.kr/goods/view?no=14276922` | 74,250 | V |
| 3 | Sabertooth 2x32 motor driver | **Dual channel: M1 drives the steering gearmotor, M2 the two paralleled rear traction motors.** One board actuates the whole vehicle. Chosen for its signal-loss timeout and current limiting, which are required safety behaviours | 원스톱<br>`https://one-stop.co.kr/goods/view?no=11156` | 250,000 | V |
| 4 | Steering gearmotor + encoder | Actuates the steering column, driven by the Sabertooth's **M1** channel. Sized from a torque measurement taken on the delivered vehicle — second batch | 디바이스마트 (2차 발주)<br>`https://www.devicemart.co.kr` | 48,000 | E |
| 5 | Absolute steering angle sensor | Measures true road-wheel angle, so gearbox backlash appears as measured error rather than hidden bias | 디바이스마트 (2차 발주)<br>`https://www.devicemart.co.kr` | 27,000 | E |
| 6 | Drive encoder + shaft adapter | Measures distance travelled at the rear axle; the input to odometry | 디바이스마트<br>`https://www.devicemart.co.kr` | 25,000 | E |
| 7 | Relay MUX hardware (2× DPDT + sockets, diodes, transistors) | Hardware selection between factory remote control and computer control. Defaults to factory control when unpowered | 디바이스마트<br>`https://www.devicemart.co.kr` | 34,000 | E |
| 8 | E-stop switch + DC contactor | Emergency traction cut-off. The contactor carries motor current; the mushroom button only switches its coil | 한국미스미<br>`https://kr.misumi-ec.com` | 35,000 | E |
| 9 | Pololu 4-channel RC servo multiplexer #2806 | Hardware override that works with the controller software completely dead. Required by the architecture review | 디바이스마트<br>`https://www.devicemart.co.kr/goods/view?no=1179242` | 31,680 | V |
| 10 | RC transmitter + receiver (FlySky FS-i6 + FS-iA6B) | Live manual override for the safety operator during all testing | 팰콘샵<br>`https://www.falconshop.co.kr/shop/goods/goods_view.php?goodsno=100004832` | 75,000 | E |
| 11 | Isolated logic rail (12 V 7 Ah battery + charger + 2× DC-DC) | Separates controller power from motor power, so motor current surges cannot reset the safety controller | 11번가 / 디바이스마트<br>`https://www.11st.co.kr/products/1334182072` | 60,000 | E |
| 12 | Wiring, connectors, fuses | Silicone wire, XT60/spade terminals, inline fuses, heatshrink | 디바이스마트<br>`https://www.devicemart.co.kr` | 55,000 | E |
| 13 | Steering shaft coupler / adapter | Couples gearmotor and angle sensor to the column. Depends on the measured column diameter — second batch | 로컬 가공 (2차 발주) | 20,000 | E |
| 14 | Mounts / 3D-print material | Sensor mast, LiDAR and camera mounts, controller enclosures | 로컬 | 41,000 | E |
| 15 | USB gamepad (Logitech F710 class) | Student teleoperation from the laptop — distinct from item 10, which is the safety override | 다나와 / 컴퓨존<br>`https://prod.danawa.com/info/?pcode=1880276` | 64,000 | L |
| | | | **Tier 1 subtotal** | **1,068,930** | |

### Tier 2 — perception

| # | Item | Purpose | Vendor / URL | Unit (₩) | Basis |
|---|---|---|---|---:|:-----:|
| 16 | 2D LiDAR, RPLIDAR A1M8-R6 | 360° range sensing for mapping and obstacle avoidance. The primary navigation sensor | 아이씨뱅큐<br>`https://www.icbanq.com/P013130745` | 155,430 | V |
| 17 | USB camera, 1080p wide-FOV | Forward vision for teleoperation and, later, learning-based control | 디바이스마트<br>`https://www.devicemart.co.kr` | 41,000 | E |
| 18 | IMU, BNO085 9-DoF | Orientation sensing, fused with wheel odometry to correct drift | 아이씨뱅큐<br>`https://www.icbanq.com/P013465652` | 41,800 | L |
| | | | **Tier 2 subtotal** | **238,230** | |

### Totals

| | Per set | × 3 sets |
|---|---:|---:|
| Tier 1 — vehicle and drive-by-wire | 1,068,930 | 3,206,790 |
| Tier 2 — perception | 238,230 | 714,690 |
| **Total** | **1,307,160** | **₩3,921,480** |
| | | *remaining: ₩78,520* |

---

## Notes for the approving office

### Two purchases, not one

Three items — **#4 steering gearmotor, #5 angle sensor, #13 shaft coupler** — **cannot be specified
until the vehicle is in hand.** The gearmotor is sized against steering torque measured on the
delivered chassis; the sensor and coupler depend on measured shaft travel and column diameter.

They are budgeted here at **₩95,000 per set (₩285,000 total)** so the approved amount covers them,
but they will be ordered in a **second batch** about two weeks after the vehicles arrive. Ordering
them now is the most common way to waste money on this build.

### Price confidence

| Basis | Share of each set |
|---|---:|
| **V** — verified on the vendor page | ₩740,360 (57%) |
| **L** + **E** — lead or estimated | ₩566,800 (43%) |

> [!WARNING]
> **The headroom is thin — please review this with the approval**
>
> ₩78,520 is **2.0%** of the request, while **43% of the cost is still estimated**. If
> the estimated items land 10% above expectation, the total reaches **₩4,091,520** and exceeds the
> ceiling.
>
> One response is already decided: **defer Tier 2 on a single set — ₩238,230.** Perception is not
> needed until week 10, and the course is deliberately structured so that perception spend follows
> the drive-by-wire milestones. The adjustment therefore costs no schedule.

### Sabertooth motor driver — selected on lead time, not price

Item #3 is available from Coupang at ₩215,300, but with an **estimated arrival of 8 October** —
about three weeks. This request uses **one-stop at ₩250,000, which ships immediately**. That is
₩104,100 more across three sets, in exchange for holding the bench-test schedule.

### Items not in this request

**Tools and consumables** are shared across all sets and are not per-set costs: ratcheting crimper,
multimeter with a 20 A range, **bench power supply with adjustable current limit**, digital angle
gauge, spring scale (0–20 kg). If the lab does not already hold these they should be requested
separately. The bench supply in particular is a safety item — it is what turns a runaway steering
loop into a harmless buzz at first power-on.

**Laptops** are not included; students use their own.

---

## Amendments since approval

**This request is a record of what was approved on 2026-09-28. Its line-item tables are not edited
as procurement proceeds** — that would destroy the only evidence of what the university actually
agreed to. Divergences are listed here instead, and the live state of every item is in the
[Order Log](order-log.md).

| # | Approved | Actual | Δ × 3 | Why |
|---|---|---|---:|---|
| 3 | Sabertooth 2x32 · ₩250,000 | **Cytron SmartDriveDuo-30** · ₩143,440 | −319,680 | Sabertooth unavailable; vendor cancelled with no ETA. Meets every requirement and costs less |
| 6 | Encoder + adapter, ₩25,000 | Same ₩25,000, split into **6a** encoder · **6b** adapter · **6c** bracket · **6d** fasteners | 0 | The line hid four parts and never funded the **mounting bracket**, which [02-mechanical §2.6](build/02-mechanical.md) requires. Moved to the measurement-gated batch: the shaft diameter and the motor's mounting face are both unknown until teardown |
| 10 | ₩75,000 | ₩139,160 | +192,480 | The estimate was low. The bundle carrying the **correct receiver** costs more than the category average |
| 15 | ₩64,000 | ₩66,680 | +8,040 | Actual charge |
| 16 | ₩155,430 | **₩0** | −466,290 | Already held before approval; never purchased |
| 18 | ₩41,800 | ₩45,980 | +12,540 | The approved figure was **ex-VAT**; every other line was VAT-inclusive |
| 3 | *(same line, 4th unit)* | **4 units ordered, 3 + 1 spare** | **+143,440** | The Δ column is ×3 by construction and cannot express a spare. Recorded here so this request and the [Order Log](order-log.md) reconcile |
| 7 | Relay MUX, ₩34,000 | **₩57,300** — 4× **70 A** SPDT @₩12,100 plus shared passives | **+69,900** | The estimate assumed generic 40 A relays. Both motor conductors must break, and the throttle poles carry an inductive load that derates a 40 A contact to 20–24 A — under the branch. 80 A is the smallest part that clears it |
| 17 | Camera, ₩41,000 | **₩24,800** | **−48,600** | ₩35,800 list less an ₩11,000 discount |
| 11c | *(part of the ₩60,000 above)* | **₩0** — capacitors and fuses bought on the #12 order | **−15,000** | Counted where the receipt puts them. Splitting an invoice to populate a row makes the log disagree with the invoice |
| 12 | Wiring, connectors, fuses, ₩55,000 | **₩63,180** | **+24,540** | Wire and connectors came in above the estimate, which priced neither the AWG 22 multi-colour reels nor ten XT60 pairs |
| 11 | Isolated logic rail, ₩60,000 | Split into **11a** battery + charger ₩66,000 · **11b** UBEC ×2 ₩23,518 · **11c** passives ₩5,000 est. = **₩94,518** | **+103,554** | The SLA was replaced by a 740 g LiFePO₄ pack, which costs more and weighs a fifth as much — see [§1.2.4](build/01-bom-sourcing.md#7-8-11-12-14-what-to-actually-buy). Listing prices were **ex-VAT**; the figures here include it |
| — | **Carriage** — not in this request at all | **₩45,700 so far**, and rising | **+45,700** | The request priced goods only. Battery ₩3,500 · charger ₩3,500 · UBEC ₩4,400 · Hall latches ₩2,700 · #14/#6d ₩6,000 · AS5600 ₩3,000 · #14b mast ₩6,000 · 사각너트 ₩3,000 · penny washers ₩3,500 · #12b 디바이스마트 ₩4,400. **The plywood was never 착불** — its receipt shows ₩0 carriage, confirmed 2026-11-04, which closes the one figure this row had been waiting on. #12's carriage was refunded with a cancelled line. **True carriage is ₩43,200**: the ₩40,000 above plus ₩3,200 착불 on the #7/#8a parcel that was paid personally and is deliberately excluded, so this total stays what the card paid. Tracked as its own row in the [Order Log](order-log.md) so it cannot distort any item's unit price |
| 4 | Steering gearmotor + encoder, ₩48,000 | **Expected ₩0** — the delivered vehicle has a **stock steering gearmotor** | **−114,000** | Confirmed 2026-10-01: all three steer under the parent remote, and the vehicle's rated **25 kg** occupant load against ~6 kg of added kit demonstrates the ≥ 2× torque margin without measurement. The design reuses the motor rather than adding one. **Re-scoped 2026-10-20 from ₩144,000 to ₩30,000**: buying a *different* gearmotor was never executable — the stock gearbox is sealed and the wiper fallback is withdrawn — so the line becomes **one spare of the stock part**, and the duty risk is answered in firmware first ([dbw.md §2.2.2](design/dbw.md#222-if-the-duty-test-fails-the-ladder-cheapest-first)) |
| 13 | Steering coupler + magnet mount, ₩20,000 | **Partly unneeded** — no motor coupler required | 0 *(pending)* | The stock motor is already coupled to the linkage. The angle-sensor magnet mount is still required |
| 8 | E-stop + contactor, ₩35,000 | Split into **8a** contactor ₩11,000 · **8b** button ₩11,924 = **₩22,924** | **−36,228** | The line hid two parts from two vendors on different dates. Both now ordered; the button came in well under the estimate |
| 6d | *(part of the ₩6,000 #6 line)* | **₩15,000** — fasteners **plus adhesive and IPA** | **+12,000** | The assembly procedure requires **thin cyanoacrylate** to lock the magnets into their pockets and **isopropyl alcohol** to degrease them first, and the line funded neither. Both are shared across the three vehicles. Same class of omission as **#6c**, caught before it reached a build rather than after |
| 6b | Magnet, ₩4,000 × 3 = ₩12,000 | **₩19,890** — one shared 200-piece pack | **+7,890** | Priced per vehicle; bought once. 54 discs are needed and 200 cost ₩19,890, so the spares are free in every sense that matters — neodymium chips, and a magnet fitted backwards is a destructive removal |
| 6a | Sensor, ₩14,000 × 3 = ₩42,000 | **₩17,160** — twenty `DRV5013BCELPEM` at the 10–25 tier | **−24,840** | Priced per vehicle; bought once, and bought deep. Six are fitted and fourteen are spare because the part is 반품 불가 and reversed `VCC`/`GND` destroys it. **No 해외구매 수수료 on this route** — Element14's ₩20,000 handling is specific to Element14 |
| 14 | Mounts and print material, ₩41,000 × 3 = ₩123,000 | **₩35,600** — two 1 kg PETG rolls and 100 M3 heat-set inserts | **−87,400** | Bought once rather than per vehicle. One roll is yellow, which **ISO 13850 requires** for the E-stop backing plate. The 2020 extrusion is deliberately not bought: it is for the mast, and the mast is not designed |
| 6d | Fasteners etc., ₩5,000 × 3 = ₩15,000 | **₩31,840** — grub screws, cyanoacrylate, IPA, threadlocker | **+16,840** | The estimate was written when this line was fasteners only. Adhesive and IPA were added on 2026-10-12 — the assembly procedure required them and nothing funded them — and priced at a guess |
| 5 | Angle sensor, ₩27,000 × 3 = ₩81,000 | **₩12,500** — five AS5600 breakouts at ₩2,500 | **−68,500** | The estimate funded a sensor **and a separate diametric magnet**; every AS5600 breakout ships with one, because the module cannot work without it. So the line was paying twice for one part. Five rather than three: one is benched before any vehicle is built, leaving three fitted and one spare |
| 14b | *(part of the ₩123,000 #14 line)* | **₩90,270** — 2020 extrusion mast, 12 mm plywood equipment plate, T-slot hardware | **+90,270** | The #14 line funded filament and never funded the **mast tube** or the **equipment plate that replaces the seat** — a part [vehicle.md §3](design/vehicle.md) requires and no line had ever carried. A printed 0.65 m mast delaminates under bending and that flex lands in the camera↔LiDAR extrinsics. **₩2,870 over the original #14 line**, before carriage — the penny washers tipped it, where and when the Order Log said they would. Only the total binds, and the live headroom against it is the figure stated below this table — restating it here is how it goes stale |
| 11b, 12 | *(spares were never budgeted)* | **₩23,519** — two UBEC spares, on the #12b order | **+23,519** | Both spares were declined on 2026-10-26 and the **UBEC half was reversed on 10-27**, which is the sequence worth reading rather than a tidy single decision. The fuse top-up **was ordered on 2026-11-07**, reversing this: two spare 5 A for a semester was an accepted risk only while it carried its own ₩3,000 carriage |
| 12b | *(assembly consumables were never budgeted)* | **₩132,899** — perfboard, screw terminals, headers, bench breadboard, heatshrink | **+132,899** | §1.2.4 has always specified perfboard and terminals for the relay-driver board; #7 bought relays and components and stopped there. Specified in one document and procured in neither. Also funds a **socketed** Teensy, which is a 74,250 board in front of thirteen students |
| 12c, 12d, 12e, 12 top-up | *(the taps' own connectors were never budgeted)* | **₩42,665** — steering Micro-Fit 3.0 ₩14,575 · drive-tap tee ×5 ₩12,100 · `.250` kit covering drive **and** power ₩14,990 · 5 A fuse top-up ₩1,000 | **+42,665** | **The three taps were always specified as *mating halves of connectors the vehicle already has*, and no line ever funded the halves.** [#12](order-log.md#L12) bought wire, fuse holders and XT60; the tap connectors could not be bought before they were identified, and identification only finished on **2026-11-06/07** — steering is a 3.0 mm pin family, drive and power are both `.250` blade. Bought as two orders because no one vendor carries both: 디바이스마트 does not stock uninsulated `.250` and 엘레파츠 sells it only by the reel. **The fuse top-up reverses the accepted risk recorded in the 11b/12 row** — ₩100 a fuse against ₩3,000 of carriage made "declined" the more expensive answer once a parcel was going out anyway |
| | | **Net** | **−257,761** | |

**Projected total ₩3,667,219 against ₩3,921,480 approved** — the same figure `order_status.py` computes from the Order Log's actual rows.

> [!IMPORTANT]
> **What was actually approved: a ceiling of ₩4,000,000, not this line-item schedule**
>
> The university approved a **total**. Individual items may move in price, be substituted, split,
> or dropped **without further approval**. Only the total binds, and the live figure against it is
> **₩3,618,854 projected, ₩381,146 of headroom**.
>
> So the amendments above are **not an approval trail** — nothing in them needed permission. They
> exist for the reason this document already states: *"the estimates above will not match, and the
> next cohort needs the real numbers."* A divergence is recorded because it is **information**, not
> because it required consent.

> [!NOTE]
> **Which document to trust for what**
>
> | | Authority for |
> |---|---|
> | **This request** | What was **approved**, and the amount approved. Frozen |
> | **[Order Log](order-log.md)** | What was **actually bought** — vendor, price paid, state, dates. Live |
> | **[Build Guide §1.2.1](build/01-bom-sourcing.md#121-sourcing-in-korea-verified-2026-09-15)** | **Where to buy** and what to verify, with the date each price was read |
>
> Vendor links appear here only as they stood at approval. **Use the Order Log's links to buy from**
> — several have since been corrected, and one of them pointed at a receiver rather than a set.

---

## Sources

Vendor links, the date each price was read, and the exchange rate used are recorded in
[Build Guide §1.2.1 — Sourcing in Korea](build/01-bom-sourcing.md#121-sourcing-in-korea-verified-2026-09-15).
Design justification for every line item is in [bom.md](design/bom.md), which links each part to the
document that requires it.

Actual prices paid go in the [Order Log](order-log.md) as parts arrive — the estimates above will
not match, and the next cohort needs the real numbers.
