jrkwon/mrider/docs/build/01-bom-sourcing.md

# 1. BOM & Sourcing

**Goal:** acquire every part before touching the vehicle, at a known cost.

Order the components for Tier 1 and confirm long-lead items (vehicle, LiDAR, gearmotor) are
in hand. Cross-check quantities and connectors against the bill of materials.

- **Prerequisites:** budget decided; Tier 1 vs. Tier 2 timing understood.
- **Specification:** [design/bom.md](../design/bom.md)
- **Expected outcome:** all line items received; totals reconciled against the BOM.

> [!WARNING]
> **Draft — not yet validated on hardware**
>
> This checklist is derived from [bom.md](../design/bom.md). No MRider build has been
> sourced yet, so vendor availability, current prices, and connector compatibility are
> **unconfirmed**. Prices in the BOM are estimates as of July 2026 and vary by retailer,
> coupon, and stock — verify at purchase.

---

## 1.1 Two purchase tiers, bought at different times

The BOM is split so the **perception spend follows the DBW gates**. If the steering loop fails
its accuracy gate at [bring-up Stage 1](../design/safety.md#6-bring-up-protocol-staged-wheels-off-first),
you have not yet bought Tier 2.

| Tier | What it covers | When to order | Line items | With ~10% contingency |
| --- | --- | --- | ---: | ---: |
| **Tier 1** | Vehicle + DBW core + gamepad | Week 1 | $678 | ~$745 |
| **Tier 2** | LiDAR, camera, IMU | By week 10 | $168 | ~$185 |
| **Both** | | | **$846** | **~$930** |

This is down from ~$1,570 in the previous revision. The Tier 1 figure was also **corrected on 2026-08-10** — it had been published as $773 while its line items summed to $638, the vehicle price drop never having been re-added. See
[bom.md § Change record](../design/bom.md#change-record-why-the-total-fell-from-1570-to-1035)
for where the money went and what was deferred rather than deleted.

> [!TIP]
> **Already have an mrover rig?**
>
> Reusable: a **dual-channel R/C motor driver** (an mrover rig has a Sabertooth 2x32, which
> also accepts servo pulses), drive encoder + shaft adapter, 3D-printed enclosures (though
> the controller cases need rework), and the laptop — roughly **−$153**.
>
> *MRider itself bought three **Cytron MDDS30** boards on 2026-09-29, so this lever is spent
> here — it is kept for anyone replicating the build. [dbw.md §4.1](../design/dbw.md#41-part-substitution-cytron-mdds30-replaces-the-sabertooth-2x32-2026-09-29)*
>
> **Not reusable:** the Pixhawk 6C, PM02, Arduino Nano, and USB-TTL adapter. MRider's
> controller is a single Teensy 4.1
> ([D3](../design/adr-dbw-architecture-review.md#46-decision-adopted-2026-08-07)). Those
> parts remain useful for other projects; this is a deliberate architectural departure, not
> a write-off.
>
> With a used vehicle, a lab-reused driver and encoder, and printed mounts, the realistic
> floor is **~$600 all-in**.

## 1.2 Order long-lead items first

Order in this sequence. The first group gates everything else; the last group can be bought
at the hardware store the week you need it. **Vendors and prices are in
[§1.2.1](#121-sourcing-in-korea-verified-2026-09-15)**, not here — one place, so they cannot drift.

=== "Week 0 — order immediately"

| Item | BOM # | Why it gates the build |
|---|---|---|
| Vehicle (12 V single-seat ride-on) | 1 | Nothing can be measured until it arrives; seasonal stock |
| Teensy 4.1 | 2 | Needed from step 4; cheap enough to buy a spare |
| RC transmitter + receiver (i-BUS) | 10 | Needed for step 4 override verification |
| Hardware RC signal MUX | 9 | Safety-critical and easy to forget — see the warning below |

=== "Week 1 — after the vehicle arrives"

| Item | BOM # | Why it waits |
|---|---|---|
| Steering gearmotor + encoder | 4 | **Sized from a measurement you cannot take yet** — see §1.3 |
| Absolute steering angle sensor | 5 | Technology depends on measured shaft travel (§1.3) |
| Steering shaft coupler / adapter | 13 | Depends on the actual column diameter |

=== "Anytime (Tier 1)"

| Item | BOM # |
|---|---|
| Motor driver (**Cytron MDDS30**) | 3 |
| Drive encoder + 3.15→5 mm shaft adapter | 6 |
| Relay MUX hardware (2× DPDT + sockets + flyback diodes + drive transistors) | 7 |
| E-stop switch (latching mushroom, traction-rated) | 8 |
| Isolated logic rail (12 V SLA + charger + 2× DC-DC) | 11 |
| Wiring / connectors / fuses | 12 |
| Mounts / 3D prints | 14 |
| USB gamepad (Xbox-layout, teleop) | 15 |

=== "By week 10 (Tier 2)"

| Item | BOM # |
|---|---|
| 2D LiDAR (RPLIDAR A1M8) | 16 |
| Front camera (USB 1080p) | 17 |
| IMU (BNO085 class) | 18 |

> [!CAUTION]
> **The hardware RC signal MUX is not optional**
>
> Item #9 is the **condition on which the single-Teensy architecture was adopted**
> ([safety.md §1.2](../design/safety.md#12-live-override-inside-dbw-mode-two-layers)). With
> one MCU holding the steering loop, throttle, override, and arming, a firmware hang loses
> all four — unless override is a *wiring* property. Order it with the RC set, not later.
> It is $18 and it is the difference between a defensible safety story and a fragile one.

## 1.2.1 Sourcing in Korea — verified 2026-09-15

Prices below were read off the vendor page on **2026-09-15** at **1 USD = 1,362 KRW**. Anything
marked *unverified* came from a search result, not from the vendor's own page — treat it as a lead,
not a quote.

| # | Item | Where | Price | Status |
|---|---|---|---:|---|
| 1 | Vehicle | [Coupang](https://www.coupang.com/vp/products/9597329401?itemId=28670205397&vendorItemId=95592760206) | ₩229,000 | recorded earlier |
| 3 | ~~**Sabertooth 2x32**~~ | [Coupang](https://www.coupang.com/vp/products/8926855294?itemId=26092961552&vendorItemId=93333777957) | ~~**₩215,300**~~ | **CANCELLED.** A **Cytron MDDS30** was bought instead on 2026-09-29 at ₩143,440 — [order log #3](../order-log.md#L3), [dbw.md §4.1](../design/dbw.md#41-part-substitution-cytron-mdds30-replaces-the-sabertooth-2x32-2026-09-29) |
| 3 | ↳ alternative | [one-stop.co.kr](https://one-stop.co.kr/goods/view?no=11156) | ₩250,000 VAT incl. | verified — ships soon |
| 3 | ↳ alternative | [Dimension Engineering](https://www.dimensionengineering.com/products/sabertooth2x32) | $124.99 ≈ ₩185,000 landed | verified — ~2 weeks, USPS |
| 9 | Pololu RC servo MUX #2806 | [DeviceMart 1179242](https://www.devicemart.co.kr/goods/view?no=1179242) | **₩31,680** VAT incl. | verified — ships ~1 week |
| 2 | Teensy 4.1 | [DeviceMart 14276922](https://www.devicemart.co.kr/goods/view?no=14276922) | **₩74,250** VAT incl. | verified |
| 16 | RPLIDAR A1M8-R6 (DFR0315) | [ICBanQ](https://www.icbanq.com/P013130745) | ₩141,300 + VAT = **₩155,430** | verified, ships ≤1 week |
| 10 | FlySky FS-i6 + FS-iA6B | [팰콘샵 100004832](https://www.falconshop.co.kr/shop/goods/goods_view.php?goodsno=100004832) | ₩139,160 VAT incl. | **verified in hand 2026-10-01** — iA6B with i-BUS port, ×3. Read the receiver warning below before buying elsewhere: the title said iA6 |

**Everything in Tier 1 that was thought to need importing is available domestically.** The
motor driver is on Coupang and at one-stop; the Pololu MUX is at DeviceMart. The "no Korean source"
reading in the first pass of this section was wrong, and came from searching badly — DeviceMart and
Eleparts render prices in JavaScript and return nothing to an automated search, which is a limit of
the search, not a fact about the market.

> [!NOTE]
> **Two prices came in well over the BOM estimate**
>
> | | BOM est. | actual | over by |
> |---|---:|---:|---:|
> | Teensy 4.1 | $32 ≈ ₩43,600 | ₩74,250 | **+70%** |
> | Pololu MUX #2806 | $18 ≈ ₩24,500 | ₩31,680 | +29% |
>
> Both are the domestic premium on a US part, and both are worth paying here: the Pololu is
> [listed "Rationed"](https://www.pololu.com/product/2806) at source, and it is the part
> [§1.2](#12-order-long-lead-items-first) says not to be waiting on. Together they add about
> ₩38,000 to Tier 1 — record the actuals in the [Order Log](../order-log.md) rather than the
> estimates.

### #14 and #6d — verified 2026-10-13

Read off the vendor pages on **2026-10-13**. Both lines are 쿠팡, so they go in **one basket and one
carriage**. Listings rot — the `DRV5013BCQLPGQ1` page that showed 995 in stock was 판매중지 — so
treat these as *this week's* answer and re-check before paying.

| # | Item | Where | Price | Note |
|---|---|---|---:|---|
| **14** | PETG 1 kg × 2 | [올리민 PETG 1.75 mm 1KG](https://www.coupang.com/vp/products/9533639155) | ₩11,900 ea | 무료배송, 62 reviews. **Any colour** — the only colour the project mandates is the yellow below |
| 14 | *(cheap black)* | [3D고속출력 PETG 1 kg 블랙](https://www.coupang.com/vp/products/9692144600) | ₩10,760 | 무료배송, only 4 reviews |
| 14 | *(safe black)* | [CaiLab PETG 1.75 mm 1 kg](https://www.coupang.com/vp/products/9320420246) | ₩15,700 | 201 reviews |
| **14** | **PETG 1 kg, YELLOW** | [Lay1 PETG 1.75 mm 1kg 옐로우](https://www.coupang.com/vp/products/9577432592) | ₩13,900 | **Required, not a preference** — ISO 13850 puts the red actuator on a yellow background, and [§#8](#7-8-11-12-14-what-to-actually-buy) prints that plate rather than buying it. 올리민's yellow is ₩11,900 but 품절임박 |
| **14** | M3 heat-set inserts | [Lay1 황동 인서트 100개](https://www.coupang.com/vp/products/9470532681) | ₩9,800 | Options `M3x5x4.2` / `M3x4x5`. 품절임박 |
| 14 | *(assorted alt)* | [황동 인서트 너트 M2~M6 220PCS](https://www.coupang.com/vp/products/9510071311) | ₩11,900 | 무료배송. Covers the enclosures too |
| **6d** | **M3 × 8** grub screw ×100 | [국산 스텐 무두렌치볼트](https://www.coupang.com/vp/products/9695006462) — pick the **8 mm** length | ₩6,000 | Cup point. Nine are fitted. **Not 10 mm**: it must cross wall + gap, 7.35–7.85 mm, and anything longer stands proud of the sensing surface |
| 6d | *(free shipping alt)* | [올커버 304 스텐 150개](https://www.coupang.com/vp/products/9672141776) | ₩5,400 | 무료배송, **단 1개 남음** |
| **6d** | Thin CA, 20 g × 2 | [엑시아 031GC 20g 2개](https://www.coupang.com/vp/products/9080803470) | ₩4,560 | 무료배송. **`031` is the low-viscosity one; `231C` is not.** No gel |
| **6d** | IPA 99.9 %, 1 L | [고순도 이소프로필알콜 1L](https://www.coupang.com/vp/products/9757544198) | ₩7,500 | 무료배송 |
| 6d | *(cheaper alt)* | [땜쟁이 IPA 1L PCB세척제](https://www.coupang.com/vp/products/6059354871) | ₩5,390 | + ₩3,000 carriage |
| **6d** | Threadlocker, blue | [록타이트 243 5 g 중강도](https://www.coupang.com/vp/products/8194549583) | ₩4,000 | **243 blue, removable. Not 271 red** — red means the grub screws never come out again |

**About ₩47,500 for #14 and ₩22,100 for #6d**, against ₩123,000 and ₩15,000 of budget. Still to add
from a local shop: **M3/M4 bolts, nylon standoffs, cable ties**.

> [!IMPORTANT]
> **Measure the inserts when they arrive, before printing a carrier**
>
> The model carries `INSERT_D = 4.6` (outside Ø) and `INSERT_L = 5.0` (length), and insert listings
> write their dimensions in whatever order they please — `M3x5x4.2` and `M3x4x5` are the same
> seller's two options. **Caliper the OD and the length and set the two parameters to match.** The
> carrier has not been printed in final form yet, so this costs nothing now and a reprint later.

> [!NOTE]
> **The 2020 extrusion is deliberately not in this order**
>
> The mast is what it is for, and the mast is not designed — so its length is unknown. Buying it now
> means guessing a length and cutting twice. It is a NOTE in §1.2.4 rather than a line item for the
> same reason.

### Leads still to confirm

Everything here came from a search result rather than the vendor's own page — DeviceMart and
Eleparts render prices in JavaScript, so they cannot be read automatically. **Confirm before
ordering.**

| # | Item | Lead | Indicative | BOM est. |
|---|---|---|---:|---:|
| 10 | FlySky FS-i6 + **FS-iA6B** | 알씨뱅크, 팰콘샵, 다나와 | — | $55 ≈ ₩74,900 |
| 15 | Logitech F710 gamepad | 다나와, 컴퓨존, 11번가 | ₩58,000–69,900 | $40 ≈ ₩54,500 |
| 18 | BNO085 (Adafruit breakout) | ICBanQ · [DeviceMart 12507416](https://www.devicemart.co.kr/goods/view?no=12507416) · VCTec | ~₩41,800 | $28 ≈ ₩38,100 |
| 11 | ~~12 V 7 Ah SLA (로케트 ES7-12)~~ → **2–3 Ah, 9.5–14 V, LiFePO₄ preferred** | 11번가, 쿠팡, 알리 | — | **Re-specified 2026-10-01** — the 7 Ah SLA is 3× oversized and 2.5 kg. See §1.2.4 |
| 11 | **Charger matched to the pack chemistry** | same vendors as the pack | — | Buy it *with* the pack, not separately — a mismatched charger is a fire |
| 11 | **DC-DC buck 12→5 V, ≥ 2 A, ×2** | DeviceMart 전원/파워 → DC-DC 컨버터 | — | Non-isolated is fine (§1.2.4). One for Teensy + sensors, one for RC + signal MUX |
| 11 | Electrolytic 1000 µF 16 V ×2, divider resistors, 5 A blade fuse + holder | DeviceMart, 엘레파츠 | — | Hold-up and the undervoltage monitor — passive parts, no module needed |
| 8 | 22 mm mushroom E-stop | 한국미스미, 레고전자부품, 다아라몰 (IDEC) | — | $15 — **but read the warning** |

> [!IMPORTANT]
> **Buy the FS-iA6B, not the FS-iA6**
>
> Korean RC shops list the FS-i6 bundled with either. The plain **FS-iA6 is PWM only** — no serial
> stream, so [Layer A](../design/safety.md#12-live-override-inside-dbw-mode-two-layers) cannot be
> built on it. Only the **FS-iA6B** carries the i-BUS port. One letter, and it is the difference
> between having a closed-loop override and not.

> [!CAUTION]
> **A 22 mm mushroom button will not switch this traction circuit — and its rating will not say so**
>
> [§1.4](#14-substitution-notes) already requires the E-stop to be traction-rated. What the Korean
> listings make easy to miss is that their ratings are **AC** ratings: a switch sold as "10 A 250 V"
> may be rated for a small fraction of that at **12 V DC**, because DC has no zero crossing to
> extinguish the arc. Drive stall current here is
> [unmeasured](../design/vehicle.md#31-drive-motor-stall-current-vs-the-drivers-rating-critical) and
> both rear motors share one channel.
>
> Use the pattern the BOM already permits: the **mushroom button switches a contactor coil**, and a
> **DC-rated contactor** (12 V coil, **50–60 A continuous**, sold as a battery isolator)
> carries the traction current. **DC-rated is the part that matters, not the amp figure** — an
> AC-rated switch breaking DC can weld its contacts closed, and that failure is silent until the
> moment you press the button.
>
> *Sized down from "100 A+" on 2026-10-01.* The stock ECU is rated 20 A and the motor driver
> limits at 30 A, so 50–60 A is already ~2× margin. Over-sizing cascades: a bigger contactor draws
> more coil current, and coil current is what sets the button's rating (below). The button then only ever sees coil current, which is what a 22 mm
> switch is actually good for.
>
> Do not buy the button until the contactor is chosen — its coil current sets the button's rating.

### Still unsourced

No usable Korean lead found yet for: **#6** drive encoder + 3.15→5 mm shaft adapter, **#7** relay
MUX hardware (2× DPDT + sockets + flyback diodes + drive transistors), **#12** wiring / connectors /
fuses, **#14** 3D-print filament and hardware, **#17** USB 1080p camera.

Most are commodity and will come from DeviceMart, Eleparts or Coupang; they are listed here so the
gap is visible rather than assumed closed. **#4, #5 and #13 are deliberately absent** — they are the
[measure-first parts](#13-two-parts-you-must-not-order-blind).

<!-- historical: the Sabertooth sourcing pass of 2026-09-15. The board was CANCELLED
     on 2026-09-29 and a Cytron MDDS30 bought instead - see dbw.md 4.1. These blocks
     are kept because the reasoning is the reusable part: a listing title is not an
     order, and the duty-threshold and lead-time arithmetic apply to whatever is
     imported next. -->
> [!NOTE]
> **The one-stop.co.kr listing: the title is stale, the product is a 2x32**
>
> [one-stop.co.kr #11156](https://one-stop.co.kr/goods/view?no=11156) is titled **"DRI0004
> Sabertooth Dual 25A"**, which reads like a mislabelled 2x25. It is not. The page body is
> unambiguous:
>
> - every datasheet link points at **`Sabertooth2x32.pdf`**, `Sabertooth2x32.doc`, and
>   `Sabertooth2x32QuickStart.pdf` on dimensionengineering.com
> - it states **6–30 V nominal, 33.6 V absolute max** — the 2x32's range. The 2x25 is 6–24 V
>   nominal, 30 V max
> - it states **32 A continuous / 64 A peak**, and names the **v1.1** revision
>
> `DRI0004` is DFRobot's legacy SKU string for this line, and DFRobot themselves have not kept it
> straight: their own wiki page for DRI0004 is titled *Sabertooth Dual 32A* while its specification
> table says 25 A / 6–24 V. The Korean reseller inherited the title and replaced the body.
>
> **The only residual risk is procurement, not specification.** If the vendor picks stock by SKU
> rather than by the page you read, a 2x25 could arrive. One email before paying settles it — ask
> them to confirm 32 A/64 A and the 6–30 V range on the unit they will actually ship.

<!-- /historical -->

<!-- historical: the Sabertooth sourcing pass of 2026-09-15. The board was CANCELLED
     on 2026-09-29 and a Cytron MDDS30 bought instead - see dbw.md 4.1. These blocks
     are kept because the reasoning is the reusable part: a listing title is not an
     order, and the duty-threshold and lead-time arithmetic apply to whatever is
     imported next. -->
> [!TIP]
> **Domestic at ₩250,000 versus importing at ~₩185,000 — both are defensible**
>
> Dimension Engineering list the 2x32 at **$124.99** and ship worldwide at a flat rate ("our
> shipping prices are the same whether you live in the USA or overseas"), by USPS air mail, ~10
> business days.
>
> That routing matters for tax. Korea's **$200** de-minimis under KORUS applies only to **courier**
> shipments (DHL/FedEx/UPS); goods arriving by **international post** fall under the **$150**
> threshold. At $124.99 the Sabertooth is below either, so it should clear free of duty and VAT —
> but the margin is thin enough that adding a second item to the same order could push the parcel
> over and tax the whole thing, not just the excess.
>
> | | landed | arrives | if it fails |
> |---|---|---|---|
> | **Coupang** | **₩215,300** | est. **10/8** | domestic |
> | one-stop.co.kr | ₩250,000 | ships soon | domestic A/S |
> | Dimension Engineering | ~$135 ≈ ₩185,000 | ~2 weeks | return shipping to the USA |
>
> The spread is about **₩65,000** end to end, which is small against what it buys: a local return
> path on the most expensive board in the build.
>
> **Time is the real variable, not price.** Coupang's estimated 10/8 is roughly three weeks out —
> slower than importing — so if the bench schedule needs the Sabertooth before then, one-stop
> shipping now is worth its ₩35,000 premium over Coupang. Check the Coupang listing's seller and
> dispatch estimate before committing; a long estimate there usually means it ships from overseas
> anyway, in which case the domestic advantage is only the return path.

<!-- /historical -->

> [!WARNING]
> **Order the Pololu MUX first, not last**
>
> Pololu lists #2806 as **"Rationed"**. It is $17.95, it ships from the US, and
> [§1.2](#12-order-long-lead-items-first) makes it the condition the single-Teensy architecture was
> adopted under. A cheap part on allocation is exactly the one that arrives last. Order it in the
> same batch as the RC set.

### #6 drive encoder — what to actually buy

`드라이브 엔코더 + 샤프트 어댑터` names **four** parts, funds three of them, and omits the electrical
limits that decide which encoder is even safe to connect. This section is the buyable version.

**Quantity: one per vehicle — three in total, not six.** Only one motor of the paralleled rear pair
is instrumented ([ADR C](../design/dbw.md#8-adr-c-drive-distance-encoding)). That is deliberate, and
the reason it is stated here is so nobody "corrects" it to two per vehicle.

#### The four parts

| | Part | Gated on a measurement? |
|---|---|---|
| **6a** | Quadrature encoder | No — specify now |
| **6b** | Shaft adapter / coupling | **Yes** — the shaft diameter is unknown |
| **6c** | **Encoder mounting bracket** | **Yes** — depends on the motor's mounting face |
| **6d** | Fasteners, threadlock, cable tie-downs | No |

**6c has never been in the BOM.** [02-mechanical.md §2.6](02-mechanical.md) requires *"the encoder
body bracketed to the motor mount"*, and #13 is the steering coupler while #14 is the sensor mast.
Nothing funded the part that holds the encoder still. **Without it the body simply rotates with the
shaft and reads zero** — a failure that looks like a dead sensor.

#### Hard electrical requirements

> [!CAUTION]
> **3.3 V logic. The Teensy 4.1 is not 5 V tolerant.**
>
> Its GPIO is 3.3 V, and a 5 V push-pull encoder output **will damage the pin it is wired to**. This
> limit appears nowhere else in the design record, which is why it is stated here as a hard filter.
>
> Most hobby encoder modules are sold as "3.3 V–5 V" and are fine. If a part outputs 5 V only, it
> needs a level shifter — budget one, and record the substitution.

**Quadrature A/B is required. A single-channel speed sensor is not sufficient**, and this is the
easiest mistake to make because those sensors are cheaper and far more common. A single channel
gives pulse *rate* with no direction, so it cannot distinguish forward from reverse.

That matters concretely here:

- Nav2 plans with **Reeds-Shepp** paths and `allow_reversing: true` — this vehicle reverses as a
  matter of course, not as an exception
- The vehicle can roll backwards on a slope, or be pushed, with no command to infer sign from

Inferring direction from the *commanded* throttle instead would be wrong in exactly the cases where
odometry matters most. `03-electrical.md` wires this to a **Teensy hardware quadrature decoder**, so
A/B is what the design already assumes.

| Requirement | Value |
|---|---|
| Output | **Quadrature A/B**, two channels. Index/Z not needed |
| Logic level | **3.3 V** (or 3.3–5 V compatible) |
| Supply | From the logic rail — state the voltage at purchase |
| Output type | Open-collector or push-pull, **stated**. Open-collector needs pull-ups |
| Resolution | **Any** — see below |

#### PPR is deliberately unconstrained

The [roll-out calibration](../design/calibration.md#2-drive-distance-encoder-ticksmeters) derives
`meters_per_tick` from a measured distance and bypasses PPR entirely, so the *result* is correct
whatever the part turns out to be. **Do not pay for resolution.** Do not inherit a number either —
see finding **F7**.

The geometry sets a floor rather than a target. The wheel is 0.09 m radius — **0.566 m per
revolution** — and turns about **2.5 rev/s** at walking pace.

**As built** (magnets on the gearbox output hub, 1:1 with the wheel, quadrature decode):

| Magnet pairs | Counts / wheel rev | Distance per count | Counts over a 20 m run |
|---:|---:|---:|---:|
| 8 | 32 | 17.7 mm | 1,132 |
| 12 | 48 | 11.8 mm | 1,698 |
| 16 | 64 | 8.8 mm | 2,264 |

Even the coarsest of these clears the **≤ 2 % drift over 20 m** gate
([dbw.md §12](../design/dbw.md#8-adr-c-drive-distance-encoding)) with enormous margin — a ±1 count
error on the 8-magnet ring is **0.09 %**. Resolution is not the binding constraint; it never was.
Pick the count that fits the hub comfortably rather than the highest that fits at all, because even
magnet spacing matters more than magnet count.

> [!NOTE]
> **The motor-shaft figures this table used to carry were wrong twice over**
>
> It compared against *"motor shaft, behind ~20:1 gearing"*. The delivered motor is an **RS-390 at
> 18000 RPM**, which against ~149 wheel RPM at walking pace implies roughly **120:1** — six times
> the assumed ratio, so the quoted resolution was off by that factor.
>
> It is moot regardless: there is no accessible motor shaft on this vehicle, so that row describes
> a mount that cannot be built. Kept only as the reason the comparison is no longer made.

#### Which one to buy depends on what the vehicle turns out to be

Three ways to instrument the drive, keyed on what the teardown finds: a rear shaft stub, an accessible output shaft, or neither

**Measure first** — the fields are in [V3](../order-log.md#v3-shaft-diameter-sizes-13).

> [!IMPORTANT]
> **Resolved for the 2026 vehicle: Branch C, mounted at the gearbox output hub.**
>
> Teardown found a **`DING LI RS 390-12V RPM 18000`** with a ~2 mm shaft carrying a 12-tooth pinion
> straight into a sealed gearbox — **no rear stub, no bare output shaft**, which is how the family
> is built rather than how this one is packaged. Branches A and B are both unavailable.
>
> The gearbox drives a **splined plastic hub** that the wheel slides onto, with clearance at the hub
> once the wheel is fitted. That is the mount: magnets on the hub, sensor bracketed to the gearbox
> housing. See [ADR C's recorded outcome](../design/dbw.md#8-adr-c-drive-distance-encoding) for why
> this is better than the original plan rather than a compromise.
>
> The `3.15 mm` the BOM inherited from B-MROVER is now doubly dead: it was orphaned when
> [ADR D-R](../design/vehicle.md) changed the vehicle class, and an earlier revision of this section
> guessed it was *"probably 3.175 mm, the RS-550 family standard"* — **the wrong family**, and moot
> now that no shaft is involved at all.
>
> **Branches A and B stay documented below.** The next cohort may receive a different chassis, and
> a tree whose branches have been pruned to the one that happened is no longer a tree.

| | What the teardown finds | What to buy |
|---|---|---|
| **A** | A **rear shaft stub** on the motor | Magnetic ring + dual-Hall board clamped to the stub, or a bore-matched incremental encoder. Bracket to the motor's rear face |
| **B** | No rear stub, but the **output shaft is reachable** before the gearbox | Ring magnet on the output shaft + Hall board on a bracket. Same electrical spec, different mount |
| **C** | Neither is accessible | **Wheel or axle side.** This is **[ADR C2](../design/dbw.md#8-adr-c-drive-distance-encoding)**, already recorded as the pre-registered upgrade path — taking it is a documented choice, not an improvisation |

> [!TIP]
> **The magnetic ring + Hall board serves all three branches**
>
> It needs no shaft *end* — only a cylindrical surface to grip and somewhere to bolt the sensor. That
> makes it the one part worth buying before the teardown decides anything, and it is why the tree
> does not fork into three incompatible shopping lists.
>
> Search **디바이스마트 → 센서 → 마그네틱/홀/리드/엔코더**

#### Branch C in detail — and the one measurement that picks the form

Nothing in **#6a–d is ordered yet**, so the form is still open. Take **one look** before buying:

> **Is the rear axle end reachable on the rotation centreline — outboard of the wheel, or through
> the hub bore — with somewhere to fix a magnet concentric to it?**

That single answer picks between two builds that differ enormously in how much has to go right.

Where the sensor mounts: a multipole ring on the rotating hub sensed radially from a bracket on the fixed gearbox housing, against an AS5600 which needs a free rotating shaft end this vehicle does not have

**The rule both halves of that picture rest on:** the magnet goes on what turns, the sensor on what
does not. A rotating **hub** offers a cylindrical **surface** — sense it radially from beside it. An
AS5600 needs a shaft **end**, with clear space in front that nothing rotates through.

##### Why magnetic sensing, and not optical or a bought encoder

This was never chosen on preference. It is what is left once the geometry closes the other doors,
and it is worth writing down because the BOM line still says *"드라이브 엔코더 + 샤프트 어댑터"* and
someone will try to buy one.

**A bought incremental encoder needs a shaft to couple to.** That is branches A and B, and this
vehicle has neither: the motor end is a 2 mm shaft carrying a pinion into a sealed gearbox, and the
axle ends at the outer face of the wheel. **An AS5600 needs a shaft end** with clear space in front
of it — the same door, withdrawn above. What is actually available is a rotating **surface**, and
the question becomes which sensing technology reads a surface.

**Optical reads a surface, and loses on where this one lives.**

| | |
|---|---|
| Where it sits | Inside the wheel arch, 8 mm from a tyre, under a vehicle students drive on a floor |
| What kills it | Dust, water, tyre rubber, gearbox grease — **contamination sits directly in the signal path**, and a disc that is merely dirty reads as a dirty signal rather than as a fault |
| Slot type | Needs a disc through a fork. A fork straddling Ø81 inside a 6 mm slot is not a part anyone is going to print |
| Reflective type | Needs a printed or stuck black/white pattern to survive the same environment at 1–2 mm |
| What is actually sold | **Single channel** — see the warning at the end of this section. No direction |

**Magnetic reads the same surface and does not care about any of that.** The field crosses a
non-magnetic air gap, so dust, water, grease and a printed carrier are all simply transparent to it.
Nothing touches, nothing wears, and a contaminated sensor reads exactly like a clean one. The
rotating part becomes a printed ring with pressed magnets — no optics, no disc flatness, no
alignment to a beam.

It also fits what is already decided: **two latches give quadrature** with their spacing fixed by
printing both into one bracket, and an **open-drain output pulled up to 3.3 V** is safe on a Teensy
that is not 5 V tolerant, whatever the sensor's own supply is.

**What it costs** is the one thing optical would not have: discrete magnets can be fitted the wrong
way round. That is handled below rather than wished away.

##### The sensor must be a LATCH. This is a hard filter, not a preference

> [!CAUTION]
> **A Hall *switch* cannot do this job, and the parts shops stock are switches.**
>
> **A latch's edges are set by geometry. A switch's edges are set by amplitude.**
>
> A **bipolar latch** toggles on north and toggles back on south. Each edge is caused by the field
> **reversing sign**, and the sign reverses at the physical boundary between two magnets — a fixed
> place on the ring. Move the sensor nearer or further and the field gets stronger or weaker, but it
> still changes sign in the same place. **The edge does not move.**
>
> A **unipolar switch** operates above `B_OP` and releases below `B_RP`, both of which are field
> *magnitudes*. Where those thresholds are crossed depends on how strong the field is, which depends
> on the air gap and the temperature. So every edge walks as the gap varies — around one revolution
> if the carrier runs out, and from vehicle to vehicle. **An omnipolar switch has the same problem**:
> it turns on for either pole and releases in between, and the release is still a threshold crossing.
>
> Two consequences, and the second is worse than the first:
>
> 1. **Counting jitter.** Edges that move with gap are ticks that move with gap.
> 2. **Direction errors.** Direction is read from the *phase* between A and B. If both channels' edges
>    walk independently with their own local gaps, the phase walks too — and it does so worst near
>    the transitions, which is exactly where a direction decision is made. This vehicle reverses
>    under Nav2 as a matter of course.
>
> There is also a mode where a switch simply stops working: if the gap grows enough that the field
> between magnets never falls below `B_RP`, it never releases and the channel goes quiet.

**The parts that will be offered to you, and which of them are wrong**

| Part | What it actually is | Usable? |
|---|---|---|
| **A3144 / OH3144 / AH3144** | Unipolar **switch**. The default hit for "홀센서" in Korea | **No** |
| **US5881** | Unipolar **switch** — and it is stocked domestically | **No.** One digit from US1881 |
| **49E / SS49E** | **Linear** analogue output, not digital at all | **No** |
| "Omnipolar" / 옴니폴라 | Switch on either pole, release in between | **No** |
| **US1881** | Bipolar **latch**, TO-92, 3.5–24 V, open-collector | Yes |
| **DRV5013**`xx`**LPGM** | Bipolar **latch**, TO-92, 2.5–38 V, open-drain | **Yes — buy this** |

> [!IMPORTANT]
> **Buy DRV5013 in the TO-92 (`LPG`) package**
>
> TI's `DRV5013` is a chopper-stabilised digital bipolar latch. It beats the US1881 on the two
> things that matter here:
>
> - **2.5 V minimum supply**, so it runs **directly from the 3.3 V logic rail** — the US1881 needs
>   3.5 V and therefore a 5 V feed plus a pull-up to 3.3 V. Fewer rails crossing the one sensor
>   cable that has to run past a PWM'd motor.
> - **`B_OP ±10 %` over the full temperature range.** The whole argument for a latch is that edges
>   do not move; a part that also holds its thresholds over temperature is the same argument carried
>   through.
>
> Open-drain, 30 mA sink, so it still wants a pull-up — **to 3.3 V**, which is what keeps the Teensy
> safe regardless of supply.
>
> **Sensitivity variant: take `BC` (±12 mT) or `AG` (±6 mT), not the sensitive ones.** A Ø5 × 2 mm
> neodymium disc puts roughly **75–240 mT** on axis across a 1–3 mm gap, so even the *least*
> sensitive option has 6× margin at the far end. Spending that margin on sensitivity buys nothing
> and costs noise immunity next to a PWM'd motor. `FA/FD` (±1.3 mT) and `AD/ND` (±2.7 mT) are for
> weak fields; this is not one.
>
![Mounting the two Hall latches: the TO-92 package with its three leads named and the flat face identified as the sensing face; both sensors printed into one bracket at 6.80 mm centres with their flat faces toward the magnets and the same way round; a radial section showing the sensor standing 1 to 3 mm off the magnet track with nothing touching; and the wiring — supply and ground shared, two open-drain outputs each pulled up to 3.3 V, four conductors to the Teensy](../images/hall-sensor-mounting.svg)

**Yes, wires solder to the three legs**, and two of the three are shared between the pair, so the
cable carries **four conductors: 3.3 V, GND, OUT A, OUT B.** The outputs are open-drain and each
wants a **10 kΩ pull-up to 3.3 V**. Nothing on this cable goes above the Teensy's limit, because the
`DRV5013` runs from 2.5 V and takes the 3.3 V rail directly.

> **Availability — no international order is needed.** *Checked 2026-10-12.* 디바이스마트's own shelf
> carries neither `DRV5013` nor `US1881`, but its **realtime DigiKey/Mouser search does**, which is
> the same 해외구매 route [#3](#12-order-long-lead-items-first) already used for the Cytron. Listed
> that day, `LPG` being the TO-92 package:
>
> **Buy `DRV5013BCELPEM`** — 디바이스마트 [13173732](https://www.devicemart.co.kr/goods/view?no=13173732),
> *Digital Switch Latch Open Drain Hall Effect TO-92-3*, DigiKey `296-DRV5013BCELPEMCT-ND`. **`BC` is
> the ±12 mT variant** this section argues for and **`E` is the −40…150 °C temperature grade**.
>
> | | |
> |---|---|
> | Price | **₩930 each, ₩780 at 10–25** — **twenty is ₩17,160 incl. VAT** against a ₩42,000 line |
> | Stock / lead | 375, DigiKey **4–5 days** |
> | Terms | **반품 불가.** Buy **twenty**: six fitted, fourteen spare. The extra ten cost ₩7,800 and the part is soldered by thirteen students onto a package where reversed `VCC`/`GND` destroys it — spares turn a wiring mistake into a lost part rather than a lost week |
>
> **In hand 2026-10-17 — twenty pieces, five days door to door, ₩19,860 all in.** The route is
> proven: a 디바이스마트 catalogue item sourced on the DigiKey channel cost **ex-VAT × 1.1 plus
> ordinary domestic carriage and nothing else** — no 해외구매 수수료. That now holds for every
> overseas line on this build, not just this one. **Keep the parts in their labelled bag:** TI
> marks a TO-92 body with an abbreviated code rather than the full part number, so loose parts
> are unidentifiable and `BC` (±12 mT) and `AG` (±6 mT) look identical.
>
> **No domestic latch exists, so some overseas route is unavoidable.** *Checked 2026-10-12:*
> 디바이스마트's 마그네틱스위치 category with **품절 and 해외구매 both excluded**, searched for `latch`,
> returns **0 results**. Plenty of A3144-class *switches* are stocked here; latches are not.
>
> **Two traps found the hard way.** The obvious catalogue page for this part —
> [13173897](https://www.devicemart.co.kr/goods/view?no=13173897), `DRV5013BCQLPGQ1` — shows 995 in
> stock and four tiers of bulk pricing and is **판매중지**; the buy button is dead and nothing above
> it says so. And the Element14 row in the realtime search looks cheapest at ₩970, but **Element14
> carries a ₩20,000 handling charge**, which turns ten pieces into ₩29,700 and reverses the whole
> comparison.
>
> **Answered at the till, 2026-10-12: there is no 해외구매 수수료 on this route.** Twenty came to
> **₩17,160 incl. VAT plus ₩2,700 of ordinary carriage — ₩19,860**, against Element14's ₩29,700 for
> ten. A 디바이스마트 catalogue item sourced through DigiKey costs **ex-VAT × 1.1 and domestic postage,
> nothing else**, and that is worth carrying forward: **Element14's ₩20,000 is specific to Element14**,
> not a property of buying from abroad, and the next overseas line should not be priced as if it were.
>
> **The route deliberately not taken:** `US1881` from AliExpress, about ₩3,000 for ten with no fee —
> a tenth of the price. It costs **2–4 weeks**, it needs a 5 V feed rather than the 3.3 V rail, and
> Hall sensors are a category where relabelled parts are common, so a "latch" that turns out to be a
> switch would be found only by testing. Against ₩378,534 of headroom, ₩20,000-odd buys three weeks
> of schedule and a part whose provenance is not in question.
>
> **Do not order the `DBZ` parts** that come up alongside: those are SOT-23, and TO-92 is the whole
> point. **US1881 (TO-92, marked `U18` / `OH188`)** stays the fallback if lead time bites, at the
> cost of the 5 V feed.

##### C-abs — AS5600 on the axle centreline *(withdrawn — see the figure)*

> [!CAUTION]
> **Proposed 2026-10-02 and withdrawn the same day. Recorded rather than deleted.**
>
> Asked where the sensor would actually bolt, the answer turned out not to exist. The motor side is
> a 2 mm shaft carrying a pinion into a sealed gearbox — **the reason branches A and B failed**. The
> wheel side ends at the **outer face of the wheel**, where a bracket must arch around the outside
> of a turning wheel: long, flexible, and the most exposed part of the vehicle to kerbs.
>
> The attraction was real — one magnet and one chip instead of a ring, two sensors, a phase offset
> and an alternating-polarity assembly, reusing the part #5 already brings. It fails on geometry,
> not on merit, and on **the same geometry that already closed two branches**. That is why it is
> left here: an idea that looks good and has already been ruled out is one someone will have again.

| | |
|---|---|
| Parts | **AS5600 breakout** + **diametrically-magnetised magnet**, typically Ø6 × 2.5 mm |
| Mount | Magnet bonded to the axle end, **concentric within ~0.25 mm**. Sensor on a bracket, 0.5–3 mm air gap, die centred on the magnet |
| Output | **12-bit absolute within a turn** — 0.088°, far finer than any magnet ring |
| Direction | **Inherent.** Angle rises or falls; there is nothing to phase |

**Why this is the better build when it is available:** one magnet and one chip replace a ring, two
sensors, a phase offset, an alternating-polarity assembly and two cables. And **the project already
uses the AS5600 for [#5](#7-8-11-12-14-what-to-actually-buy)** — one part, one driver, one set of
failure modes for students to learn, not two.

**Two things it costs:**

- **The I²C address is fixed at `0x36`**, so it cannot share a bus with #5's AS5600. The Teensy 4.1
  has **three** I²C peripherals — put steering on `Wire` and drive on `Wire1`. Not a problem, but it
  must be designed in rather than discovered.
- **Revolutions are accumulated in firmware**, where Branch C-inc counts in hardware. The margin is
  large — a wheel at walking pace turns ~2.5 rev/s, so at the pinned ≥200 Hz the angle moves ~4.5°
  per sample against the 180° that would be ambiguous — and a firmware stall long enough to lose a
  wrap trips the staleness watchdog into `ESTOP` anyway.

##### C-inc — multipole ring + two Hall latches *(if the axle end is not reachable)*

This is the plan already in the BOM, made specific. Three choices decide whether it is reliable:

**The hub measures 63.0 mm across opposite lobe crests (2026-10-08), and that settles the build.**

![Hub and bore defined: left, the six-lobe rotating boss on the vehicle, whose Ø62.82 is measured across two opposite lobe crests and is not the smaller root diameter; middle, the printed carrier, whose Ø63.9 bore faces the hub while its Ø77.9 outside diameter is the magnet track; bottom, the two assembled with the deliberate 0.60 mm per-side clearance drawn magnified, and the three mistakes already made — taking the fixed grey collar for the hub, taking root Ø for crest Ø, and wrapping with something whose own thickness was never subtracted](../images/hub-and-bore.svg)

**Two diameters near 63 mm, and they are not the same thing.** The **hub** is on the vehicle, it
rotates, and you *measure* it — across two opposite lobe crests, which works because six is an even
count. The **bore** is the hole in the printed carrier, and you *print* it. The carrier also has an
**outside** diameter, Ø78.02, which is the magnet track and faces the sensor; the bore faces the hub.
**bore − hub = 1.2 mm, 0.60 mm a side, deliberately.**

End view and axial section of the carrier: a one-piece printed ring slides onto the six-lobe hub and presents a plain cylinder carrying eighteen alternating magnets, held by three recessed grub screws, with two Hall sensors outside it half a pitch apart

> [!IMPORTANT]
> **Magnet spec, fixed independently of everything still open**
>
> **18 × Ø5 × 2 mm, axially magnetised, neodymium N35 or better, NiCuNi.** 54 for three vehicles.
>
> It is worth saying why this could be ordered while the mount was still unsettled. **The count
> survives any carrier diameter** — at Ø70 the pitch is still 12.2 mm against the 7 mm the magnets
> need, and 18 divides by 2, 3, 6 and 9, so "half a pitch from its neighbours" holds for any
> plausible screw count. **The size survives any air gap** the mount could plausibly force: a Ø5 × 2
> N35 disc puts 232 mT on axis at 1 mm and still **28 mT at 5 mm**, against a ±12 mT threshold.
>
> | air gap | 1 mm | 2 | 3 | 4 | **5 mm** |
> |---|---:|---:|---:|---:|---:|
> | field | 232 | 131 | 74 | 44 | **28 mT** |
> | × threshold | 19 | 11 | 6.2 | 3.7 | **2.3** |
>
> The one case that would break it is a carrier forced **narrower than 6 mm**, which a Ø5 magnet
> cannot sit in. Against a ₩12,000 line and ₩398,424 of headroom, that risk is cheaper to carry
> than the lead time.
>
> **AXIAL magnetisation is the specification that matters.** The flat faces must be the poles, so
> that a disc lying in a radial pocket throws its field outward at the sensor. A **diametrically**
> magnetised disc of the same dimensions is useless here and is sold alongside it. `D5x2T` discs are
> axial by default, but confirm it on the listing.
>
> **Buy well over 54.** Neodymium is brittle and these snap together hard enough to chip; a magnet
> fitted backwards is a destructive removal, not a re-do; and the first one goes into a scrap pocket
> as a fit test. Three rings of eighteen, assembled by thirteen students, and the course runs again.

| | |
|---|---:|
| Hub, lobe crest Ø | **62.82 mm** *(caliper, 2026-11-04, gearbox out of the vehicle — the cleanest access yet. [Photographed](../images/photos/drive-hub-caliper.jpg) as it was read. 62.7 on 2026-10-15 and 62.23 on the steering gearbox; **the model takes the largest, because the bore has to clear it**)* |
| Printed ring bore — **clearance, not a fit** | **Ø64.02 mm** |
| Printed ring, 7 mm wall | **OD 78.02 mm** |
| Magnet track circumference | **245.1 mm** |

| magnets | pole pitch | **quadrature offset** | counts/rev | mm/count |
|---:|---:|---:|---:|---:|
| 12 | 20.47 mm | 10.24 mm | 24 | 23.7 |
| **18** | **13.60 mm** | **6.80 mm** | **36** | **15.8** |
| 24 | 10.24 mm | 5.12 mm | 48 | 11.9 |

**Take 18.** A 13.60 mm pitch prints and populates easily, the 6.80 mm sensor offset is buildable
with surface-mount parts, and 15.8 mm/count clears the **≤ 2 % over 20 m** gate by more than an
order of magnitude — resolution was never the constraint here.

**Sixteen is not on that list, and the reason is the screws.** The three grub screws that hold the
ring have to sit **exactly half a pitch** from their neighbouring magnets, which means the magnet
count must divide by the screw count. 16 ÷ 3 does not, 18 ÷ 3 does. The file `assert`s it.

**Three things decide whether this is reliable rather than merely specified:**

**1 — A multipole ring was the plan and does not survive the diameter.** A single ring magnetised
with alternating poles would remove spacing, polarity and placement at once, which is why it was
specified. At a **64 mm bore** those are industrial parts, not commodity ones. So: **discrete
magnets in a printed carrier**, which is where this started, with the polarity risk handled below
rather than designed away.

**2 — Hall *latch* (bipolar), not a Hall *switch*.** A latch toggles on north and back on south, so
alternating poles give a clean ~50 % square wave **whose edges do not move with the air gap**. A
unipolar switch's release threshold drifts with gap and temperature, turning a mechanical tolerance
into a counting error.

**3 — The offset is `(n + ½)` pole pitches, not `(n + ¼)`.** *Corrected 2026-10-04 — this page had
it wrong.* One **electrical cycle** spans **two** magnets, so a 90° electrical offset is **half a
pole pitch**: 6.80 mm at 18 magnets. Building to a quarter pitch would put the sensors 45° apart
electrically — still two signals, but not quadrature, and the direction sense would be wrong near
the transitions. **Print both sensors into one bracket** so the spacing is fixed by construction.

> [!IMPORTANT]
> **Print the carrier as ONE piece, and do not make the bore a fit**
>
> **3D printing is the right process here**, and not as a compromise: the carrier **transmits no
> torque**, it only has to ride along, so there is no strength case for machining it. Three
> identical copies from one file is what printing is for, and [#14](#7-8-11-12-14-what-to-actually-buy)
> already brings the PETG. **Keep PETG, not PLA** — this sits beside a gearbox and a motor, and PLA
> is soft by 60 °C.
>
> **One piece, because the sensor rides 1–3 mm off the outer surface.** Every feature on this part
> is therefore a *recess*. A split ring has to put its fastener somewhere, and on a wall this thin
> there is nowhere both reachable by a hex key and inside the sensing cylinder. The revision that
> tried it stood its clamp ears **9 mm proud**, sweeping Ø91 against a sensor face at Ø78 — it would
> have taken the sensor and its bracket off on the first turn of the wheel. **The wheel comes off**,
> so the ring can simply be slid on.
>
> **And the 1 mm floor on that gap is not a round number — it is the grub screws.** A screw seated
> on a crest stands **0.05–0.75 mm proud of Ø78.02**
> ([§above](#7-8-11-12-14-what-to-actually-buy)), so **0.75 mm is the tallest thing the sensor can
> meet.** A 1 mm gap clears the worst case by **0.25 mm**; anything under 0.75 mm and the sensor is
> inside the swept cylinder of its own fastener — the same geometry as the 9 mm clamp ears above,
> two orders of magnitude smaller and just as terminal.
>
> *Both figures come from
> [`scripts/carrier_params.py`](https://github.com/jrkwon/mrider/blob/main/scripts/carrier_params.py),
> and [check 15](https://github.com/jrkwon/mrider/blob/main/scripts/check_carrier_numbers.py)
> fails if either drifts — so the floor moves if the screw length or the hub tolerance ever does.*
>
> **The bore carries no load.** The hub measures **62.82 mm** and FDM holds a Ø64 bore to perhaps
> ±0.3 mm; a press fit needs both numbers to ±0.1, which is two significant figures out of reach —
> and there are three hubs, not one. So the bore is deliberately **clear** of the hub, and three
> recessed M3 grub screws take up whatever slack exists. **They seat on the lobe CRESTS**, which
> is the seat the M3 × 8 length was derived for — see the crest rule below. *An earlier revision
> of this paragraph said the points settle into the gaps between the lobes. They cannot be asked
> to: a valley sits deeper by the lobe depth, which is still unmeasured (V4 **H1**).*
>
> | | |
> |---|---|
> | Model the spline form | Needs tooth count, form and undercut, printed to a tolerance FDM does not hold. Buys nothing — nothing is transmitted through those teeth |
> | Undersized bore, pressed on | Needs ±0.1 mm on two numbers that are ±0.3 and ±0.5 |
> | **Clear bore + 3 grub screws** | **Needs one diameter, loosely.** One print fits all three vehicles, and a hub 0.5 mm off nominal only changes how far the screws go in |
>
> **Three screws, not four.** Three points determine a circle — a four-point grip over-constrains
> it, and tightened unevenly pushes the ring off centre. Run them down **in rotation**, a turn each,
> so the ring centres itself. Blue threadlocker.
>
> **Do not drill the hub.** The thought comes up because a grub screw looks like it wants a dimple
> to sit in, and on a metal shaft it often would. Three reasons not to here:
>
> - **The hub is the plastic part that carries the full drive torque to the wheel.** A hole in it is
>   a stress raiser in the one component whose failure stops the vehicle driving.
> - **It is irreversible, and this project requires the vehicle not to be.**
>   [02-mechanical §2.8](02-mechanical.md) asks the builder to be able to *describe, out loud, how to
>   return this vehicle to factory condition.* Nine drilled holes across three vehicles is the answer
>   being "I cannot."
> - **Nothing needs the grip.** The load is the carrier's own centrifugal force, **0.3 gf**. A
>   cup-point screw tightened onto plastic forms its own seat in a few turns and that is already
>   orders of magnitude more than is being asked.
>
> **A lobe gap resists rotation but not sliding** — it is an axial groove, so the screw can travel
> along it. Axial position is held by friction and by having pushed the ring against the housing
> face, which is enough against vibration alone. **If a carrier ever does creep, the answer is a
> drop of adhesive, not a hole.**
>
> **Rotate the ring one lobe before tightening.** Six lobes sit 60° apart and the three screws 120°,
> which is exactly **two lobe pitches** — so all three screws are always in the *same* place on the
> lobe pattern. Turn the ring until they drop into the **gaps** and you get a positive form lock on
> all three at once; land them on the crests and all you have is friction. This is luck turned into
> a procedure, and it only works because 6 divides 360/3.
>
> Nothing here needs a hard grip anyway — the carrier transmits no torque.
>
> **It is not captured axially, though, and this page used to say it was.** The 2026-10-08 side view
> shows the lobed boss standing about **10 mm clear of the housing**, with a 6 mm ring going onto
> it. There is no slot holding the ring in place; the screws hold it, and **its axial position is a
> choice made at assembly**. Push it up against the housing end face, and do that on every vehicle —
> otherwise the sensor bracket has three different reaches to cover.
>
> **The model is in the repository**: [`cad/drive_encoder_carrier.scad`](https://github.com/jrkwon/mrider/blob/main/cad/drive_encoder_carrier.scad).
> Parametric OpenSCAD — `HUB_D` at the top is the one measured number, everything else derives from
> it, and **nine `assert`s** catch the ways the parameters can be made impossible: carrier wider
> than the axial gap, magnet wider than the carrier, pocket deeper than the wall, magnets too close,
> a magnet count that does not divide by the screw count, a screw hole that would run into its
> neighbouring magnets, no pilot left between insert and bore, a grub screw too short to cross the
> worst-case slack, and the ring-plus-sensor radial clearance once it is measured.
> Build with `openscad -o carrier.stl cad/drive_encoder_carrier.scad` — the default `PART = "ring"`
> is **the file you slice**. `PART = "gauge"` is the bore check below.
>
> **Print it flat, ring axis vertical**, and that is structural rather than convenient. The only
> load the part sees is the three screws pushing inward, which is **hoop tension**; printed flat
> that tension lies *inside* the layer planes. Lay it with the **index groove facing up** — a
> 0.8 mm recess in the top surface prints clean, on the bed it would bridge over nothing.
>
> At `HUB_D = 62.82` it derives bore Ø64.02, outside **Ø78.02**, track 245.1 mm, pitch 13.62 mm,
> sensor offset 6.81 mm, 36 counts/rev → **15.8 mm/count**. *Build to the **round figures — pitch
> 13.60, offset 6.80**. The 2026-11-04 hub reading moved them by 0.02 and 0.01 mm, which is an order
> of magnitude under what a 0.2 mm layer or a hand-placed TO-92 can hold; carrying the extra digit
> into a drawing would be false precision, and the figures deliberately keep 6.80.* Fasteners, per vehicle:
> **3 × M3 × 8 grub screw. The screws seat on lobe CRESTS, and that decides both the length and the point form.**
>
> Four grub-screw point types in profile — flat, cup, cone and dog — and a section through the carrier wall and the six-lobe hub showing a flat face making a line contact on a crest, a cup rim straddling the ridge, and a cone perched on the apex where it wants to slide off
>
> **The point is what does the holding**, and what it should be depends entirely on **what it lands
> on**. Here that is a **convex lobe crest**, not a flat or a valley. **Flat** makes a line contact
> running axially — adequate. **Cup** straddles the ridge on its rim — better. **Cone** touches the
> apex at a single point and wants to slide off it — **worse here, despite being the stronger choice
> on a flat seat.** **Dog** needs a matching hole and is wrong anywhere on this part.
>
> [!IMPORTANT]
> **Crests, not valleys — and that is what sets the length**
>
> `HUB_D = 62.82` is measured **across opposite lobe crests**, so **every span figure derived from it
> is a distance to a crest.** `SPAN_MAX = 7.95 mm` is the wall plus the largest radial gap **at a
> crest**. A valley sits deeper by the lobe depth, **which nobody has measured**, so an M3 × 8
> cannot be assumed to reach one and must not be asked to.
>
> **Assembly rule: tighten on a crest.** Seated there, the screw stands **0.05–0.75 mm proud of the
> OD**. If one winds in past that without going tight, it is heading **down a flank or into a
> valley** — back it out, rotate the ring, try again.
>
> **And the margin is 0.05 mm, not a comfortable one.** An `M3 × 8` reaches
> `SET_SCREW_L − WALL = `**`1.00 mm`** past the bore and has to close up to
> `(BORE_CLEAR + HUB_TOL) / 2 = `**`0.95 mm`** of it — **1.05×, not the “five times” an earlier
> revision of this page and two of its figures claimed.** That `5×` was arithmetic from the
> **`M3 × 10` that [#6d](../order-log.md) rejected** for standing 1.9–2.7 mm proud of the sensing
> surface: `10 − 7 = 3`. *Corrected 2026-11-07, when the figures were moved onto
> [`scripts/carrier_params.py`](https://github.com/jrkwon/mrider/blob/main/scripts/carrier_params.py)
> and three of them disagreed with the model.*
>
> **The flank is the case that bites.** A screw part-way down one **does** clamp, but at a smaller
> radius — and because six lobes at 60° against three screws at 120° is exactly two lobe pitches,
> **all three share the phase and push the ring off centre together.** An eccentric ring is a
> varying air gap, which is how a Hall latch starts dropping out over part of a revolution.
>
> **Point form, with the seat understood: `DIN 913` flat is acceptable.** On a **convex** crest a
> flat face makes a **line contact running axially**; a **cone (`DIN 914`) would make a single point
> on the apex and want to slide off it.** `DIN 916` cup is better still, because its rim straddles
> the ridge — but it is an **upgrade, not a prerequisite**.
>
> *This page said "cup or cone, never flat" for ten days, and escalated the sourcing twice on the
> strength of it, without checking the claim against the length calculation already in the file.
> The seat decides the point form; the point form does not decide itself.*

> [!TIP]
> **Draw a witness mark across the ring-to-hub joint**
>
> The worry a better screw was meant to address was never grip for its own sake — it was that a
> **slipped ring produces silently wrong odometry.** A paint-pen line across the joint makes any
> slip visible at a glance, whatever is fitted. **Detection beats a stronger grip**, because it also
> catches the failures the grip was never the cause of.

> [!WARNING]
> **Do not put threadlocker in these threads**
>
> [#6d](../order-log.md) buys 록타이트 243, and it was specified when the carrier's threads were
> **metal heat-set inserts**. They are now **tapped straight into PETG**. Anaerobic threadlocker is
> not intended for plastic threads — its cure relies on metal on the mating flanks, and some
> plastics stress-crack in contact with it. **On this joint the locking comes from the point form
> and the PETG's own thread friction, not from 243.**
>
> The 243 is not wasted: the mast's M5 bolts run into **steel T-nuts**, which is the joint it was
> always right for.
>
> **Rendered and checked 2026-10-06.** CGAL reports `Simple: yes`, `Volumes: 2` — one connected
> solid — and the **maximum swept radius measured off the STL is 38.950 mm, exactly `OD/2`**. That
> is the check that matters on this part: nothing stands proud of the surface the sensor faces.
>
> **It is the check that was missing.** Two faults got through without it. The clamp ears above were
> one. The other was quieter: the index mark was a Ø2 through-hole centred at `OD/2 - 1.0` with a
> radius of `1.0`, which put it exactly **tangent** to the outer surface — zero wall at the tangent
> point, a feather edge pointed straight at the sensor. It is now a groove in one *face*, ending
> 1 mm short of the magnet pocket floor, so it cannot reach the track by construction.

> [!IMPORTANT]
> **Print the fit mule before the carrier**
>
> `PART = "gauge"` is the carrier's **real bore, real outside diameter and real width** with none
> of the features — about 12 g. Print it at `GAUGE_DELTA = 0`; go to **+0.4** if it will not go on,
> **−0.4** if it sits visibly off centre.
>
> **It is supposed to rattle.** The screws remove the rattle, not the bore. If even +0.4 will not go
> on, `HUB_D` is wrong — re-measure before committing 20 g of carrier. Add the winning delta to
> `BORE_CLEAR` and print.
>
> **Then refit the wheel and turn it one full revolution.** Nothing may touch. That single turn is
> the acceptance test for the radial clearance *and* the axial gap, and it is worth more than
> either measurement: finding the smallest obstruction radius inside a 6 mm slot behind a fitted
> wheel is awkward and easy to get wrong, and turning the wheel is neither. It is also the last
> moment at which discovering the carrier does not fit costs 12 g instead of eighteen glued
> magnets.
>
> **Measure the hub ACROSS TWO OPPOSITE LOBE CRESTS.** Six lobes is an even count, so opposite
> crests face each other and a caliper — or even a tape — reads the crest circle directly. Three
> positions round the hub, all three vehicles, enter the **largest**.
>
> **Do not wrap, and this is not a style note.** A wire round the crests read **205 mm**, and two
> corrections were argued over that number before anybody measured across it. Both were wrong:
>
> | | |
> |---|---|
> | `205/π = 65.25` | Ignores that **the wire has thickness**. Its centreline stands half a wire-diameter off the surface, so what you measure is `π(D + d_wire)`, not `πD`. A 2 mm wire gives **65.25 − 2.0 = 63.25** against the **63.0** later measured across. That is the whole discrepancy |
> | a polygon "chord" correction, +0.75 | Argued on top of it, pushing the figure to 66.0 — **in the wrong direction**, and for a crest form this hub does not have |
>
> **Net: `HUB_D` was carried 2.3 mm too large, the bore came out 4 mm oversize, and a 20 g ring was
> printed that could not be clamped** — the grub screws reach **1.00 mm** past the bore and the gap was
> 2 mm per side, so it was marginal rather than impossible, but it was not the part. The fit mule
> exists to cost 12 g instead of 20 at exactly this moment.
>
> *A clearance bore does not save you from a wrong input, which is why `BORE_CLEAR` must stay larger
> than `HUB_TOL` and the model now `assert`s it. **If a wrap is ever the only option, subtract the
> wire or strip thickness.***
>
> **Settled with a caliper, 2026-10-15: 62.7 mm**, three positions, no spread worth recording.
> *Superseded 2026-11-04 by **62.82**, taken with the gearbox out of the vehicle. **Confirmed to be
> the SAME drive hub re-measured**, not a third part — so the 0.12 mm is the instrument and the
> operator, and the 0.47 mm drive-vs-steering gap is still the only part-to-part evidence there is.
> The model takes the largest reading either way. **Both remaining drive hubs are still unmeasured.**
> [Three readings, two parts: 62.23 · 62.7 · 62.82.](../order-log.md)*
> That ends four indirect attempts, and the pattern in them is the lesson:
>
> | | reads | why it was off |
> |---|---:|---|
> | wire wrap, 205 mm | 65.25 | the wire's own 2 mm thickness, never subtracted |
> | + a polygon "chord" correction | 66.00 | applied in the wrong direction, for a crest form this hub does not have |
> | tape across opposite crests | 63.00 | right method, coarse instrument |
> | thin paper wrap, 195 mm | 62.00 | chorded the six gaps and read low |
> | **caliper across opposite crests** | **62.70** | |
>
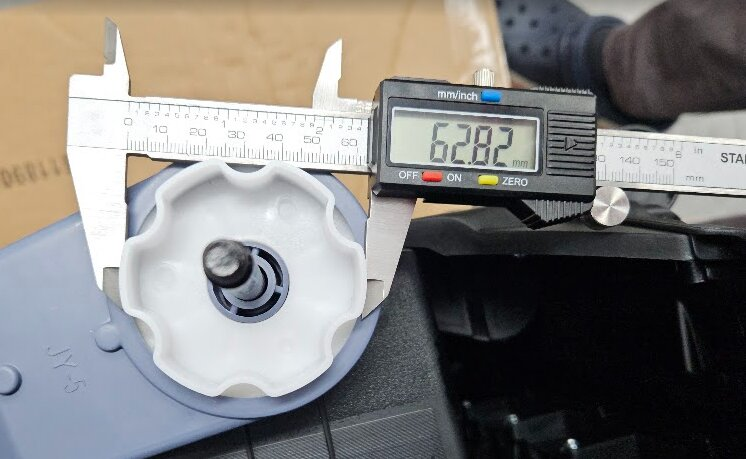
[picture p10: docs/images/photos/drive-hub-caliper.jpg]
The direct measurement being taken: a digital caliper spans the white six-lobe hub across two opposite lobe crests and reads 62.82 mm, with the gearbox out of the vehicle and resting on a bench
> 
>
> *Vehicle #1, 2026-11-04 ([provenance](../images/photos/MANIFEST.md)). **The jaws are on two
> opposite crests, which is the whole method** — a reading taken anywhere else is one of the five
> above. Your hub is one of three and may differ; the row above is the reference, not your answer.*
>
> **Every indirect method missed, and the direct one was available from the first day.** Six lobes
> is an even count, so opposite crests face each other — that was true before any of this. It took
> a ring printed 4 mm oversize to go and measure across.
>
> `HUB_TOL` is now **0.2**, carrying the instrument and the vehicle-to-vehicle spread and nothing
> else. It is no longer a shrug: the grub-screw length assert depends on it, and at 0.2 the worst-
> case screw stand-off is **0.5 mm**.

> [!IMPORTANT]
> **A reversed magnet cannot be prevented. Make it visible instead.**
>
> With discrete magnets back in the design, a student can fit one the wrong way round, and a
> cylindrical magnet gives no clue which way it is in. One reversed magnet is a **permanent**
> odometry error that roll-out calibration will partly absorb — and therefore hide.
>
> **Check the finished track directly first** — magnetic viewing film, or a spare magnet walked
> round the ring, feeling the attract/repel alternate. Either shows a reversed disc **immediately**,
> before anything is powered or fitted.
>
> **Then the electrical check, which costs a minute.** Before the carrier goes on the vehicle: power
> the sensors, **turn the ring slowly by hand**, and watch one channel. A correct ring gives an even
> train of pulses. A reversed magnet shows as **one long gap and one short pulse**, at the same place
> every revolution — and that is all it tells you, that one exists. **Count from the index groove**
> to find which.
>
> **Do this on all three carriers and record it.** It is the acceptance test for #6c.

> [!IMPORTANT]
> **Bonding the magnets — the bond carries almost nothing, so pick for durability and cleanliness**
>
> Work out the load before choosing an adhesive. A Ø5 × 2 disc weighs **0.3 g**, and at a walking
> pace the wheel turns about 2.6 rev/s, so the centrifugal force at R 39.5 mm is **0.003 N — a
> third of a gramme-force**. Nothing structural is being asked of this joint. What the adhesive
> actually has to do is stop a magnet **creeping out of a plastic pocket over a semester** and keep
> moisture off the nickel. The press fit does the holding; the adhesive locks and seals it.
>
> **Method: press fit, then wick thin cyanoacrylate at the rim.**
>
> 1. **Degrease the magnets and the pockets with IPA.** Magnets ship with an oil film, and this is
>    the single most common reason a magnet bond fails. Nothing else on this list matters as much.
> 2. **Mark one face of every magnet.** Pull them off the shipped stack one at a time and put a
>    marker dot on the face that was pointing the same way each time. You never need to know which
>    pole it is — only that all the dots match. Then fit **dot-out, dot-in, dot-out…**, starting
>    dot-out at the index groove. Polarity becomes a thing you can *see* instead of a thing you have
>    to test.
> 3. **Press each magnet fully home, flush with the track.** Check the first pocket on a scrap or on
>    one position before committing to eighteen.
> 4. **One small drop of thin, low-viscosity CA at the rim.** Capillary action takes it into what is
>    left of the clearance. Thick gel CA will not wick and will sit proud.
> 5. **Wipe the excess immediately, before it cures.** A cured bead standing proud of the track is
>    precisely the fault this entire part is shaped to avoid, and the sensor passes 1–3 mm away.
> 6. **No accelerator.** Sprayed into the joint it makes the bond foamy and brittle and leaves
>    residue standing proud — see the previous point.
> 7. **Let it cure fully before the hand-turn check**, and keep CA out of the bore and off the
>    grub-screw inserts.
>
> **Why not epoxy,** which bonds nickel and PETG better and resists heat and moisture better: it
> needs a **clearance** for its glue line, and an interference fit scrapes it off on the way in.
> Switching to a clearance pocket means the magnets are loose until cured, and the pockets are
> horizontal when the carrier lies flat, so they would have to be filled one at a time with the ring
> rotated pocket-up — eighteen times, inside a five-minute pot life. For a joint carrying 0.3 gf
> that is a poor trade. **If a carrier ever comes back with magnets loose, this is the first thing
> to change** — clearance pocket, epoxy, ring stood on edge.
>
> **An earlier revision of this page said the magnets fight you during assembly, and that an
> alternating pattern pushes each one toward the orientation that is wrong. It is the opposite.**
> *Corrected 2026-10-08.* Side-by-side dipoles prefer to sit **antiparallel**, and alternating
> radial poles on a ring is exactly that arrangement — it is the low-energy state, which is why a
> magnetised ring adopts it on its own. Summing the neighbour field at one magnet's seat over the
> whole ring gives **+2.57 mT pointing outward**, aligned with that magnet's own moment. **A
> correctly fitted magnet is held correct by its neighbours.**
>
> Two things follow, and both make assembly easier rather than harder:
>
> - **Nothing has to be clamped while adhesive cures.** The restoring torque is about
>   **0.09 mN·m** — roughly 4 gf at the rim of the disc. The earlier instruction to glue and cure
>   each magnet before fitting the next was answering a problem that does not exist.
> - **A reversed magnet still will not right itself.** It is in the *unstable* state and is being
>   pushed to flip, but 4 gf does not move a disc out of an interference pocket. The acceptance
>   check above is still the thing that catches it.
>
> **The real hazard is in the air, not in the pocket.** A loose magnet brought near the ring snaps
> onto the nearest fitted one face-to-face, which is the strongest attraction available, and
> neodymium chips when it does that. Keep the box away from the work.

**Also pin:** 3.3 V supply, or an open-drain part with a 3.3 V pull-up — [the Teensy is not 5 V
tolerant](#7-8-11-12-14-what-to-actually-buy) — and feed A/B to **two of the Teensy's four hardware
quadrature decoder channels**, which counts in hardware regardless of what firmware is doing.

##### The bracket — clamp the gearbox housing nose, do not hunt for screw bosses

**#6c was blocked on a measurement it does not need.** The open item was *"screw bosses available on
the housing — count and thread"*, and the plan was to bolt a bracket to whatever turned up. The
teardown photographs show something better: **the gearbox housing's output end is a cylinder
concentric with the axle.** Clamp that instead.

![What to measure for the bracket: an axial section showing the fixed gearbox housing ending in a fixed cylindrical nose around the rotating lobed hub, with the carrier and magnets in the gap outboard of it and the bracket clamped round the nose; the two dimensions marked are the nose diameter and its usable length. An end view names the same circles and gives a one-finger test for telling the rotating hub from the fixed nose](../images/drive-encoder-bracket-mount.svg)

**"Nose" means the fixed collar the hub comes out of** — the ring of housing that surrounds the
lobed boss, concentric with the axle, which does **not** turn when the wheel does. It is not the
oval gearbox body and it is not the lobed hub itself. **The one-finger test settles it:** rest a
finger on it and turn the wheel. What turns is the hub and takes the carrier; what stays still is
the nose and takes the bracket.

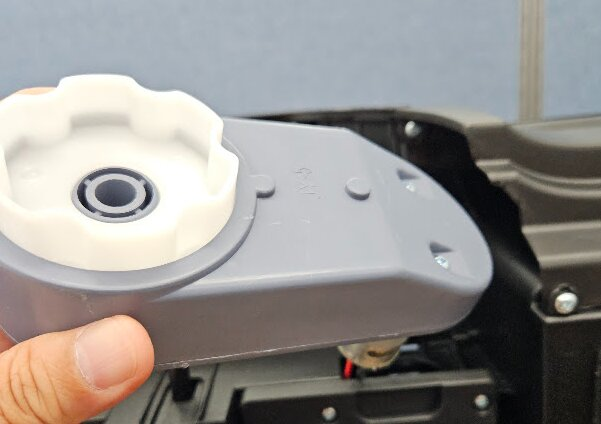
[picture p11: docs/images/photos/drive-gearbox-hub-and-nose.jpg]
The drive gearbox off the vehicle, held in one hand. The white six-lobe hub stands proud at the output end with the axle bore at its centre; the grey housing it emerges from finishes in a short collar concentric with that hub, and that collar is the nose. The oval gearbox body behind it is not the 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


*Vehicle #1, 2026-11-04 ([provenance](../images/photos/MANIFEST.md)). **This settles which ring
is which, and nothing else.** The nose diameter is still unmeasured, and reading one off this
photograph is precisely the mistake named at the end of this section.*

| | Bolt to screw bosses | **Clamp the housing nose** |
|---|---|---|
| What must be measured | Boss count, thread, positions, and whether any of them face the right way | **One diameter and one length** |
| Air gap | Set by how well the builder aligned the bracket | **Set by the print** — the clamp is concentric with the axle, so the gap is a dimension, not an assembly skill |
| If the bosses are wrong | Start again | Does not arise |
| Three vehicles | Three alignments | One part, three times |

It is the carrier's own trick used twice, and the second time is easier, because **the bracket does
not rotate**. The rule that forced the carrier to be one piece — nothing may stand proud of the
sensing cylinder — does not apply to a part that never sweeps anything. **A two-piece bolted clamp
with ears is fine here**, and the ears are the obvious place to put the slot that sets the gap.

**Design it with the gap adjustable.** Slot the sensor pad radially so it can be slid and locked.
The latch makes the *timing* gap-independent, but the sensor still has to be close enough to see the
field and far enough not to be struck, and the first vehicle is where that gets learned.

**Both sensors in one printed part.** The two sit on a chord while the magnets ride an arc, so the
gap differs between A and B by the sagitta: `c²/8R = 6.80² / (8 × 38.95) = `**`0.148 mm`**. A flat
two-up pad is therefore correct, not an approximation.

![What the nose diameter decides: a radial budget from the axle marking the hub at R 31.41, the carrier bore at 32.01, the magnet track at 39.01, the sensor face at up to 42.01 and the sensor back at 46.01, with the two disagreeing nose readings shaded across it — Ø72–75 falls inside the magnet track and Ø85–90 falls outside it; then both cases drawn to scale as end views, showing the bracket arm reaching outward in one and inward in the other; and the axial question, where the bare nose length decides whether a clamp fits at all](../images/nose-diameter-decides.svg)

**The two readings are not 15 mm apart, they are on opposite sides of the carrier.** The magnet
track is **Ø78.02**, so **Ø72–75 puts the nose *inside* it** — the bracket clamps low and the arm
reaches **outward** — while **Ø85–90 puts it *outside*** and the arm reaches **inward**.
**Both are buildable, no average of the two is, and the clamp band is itself a circle at this
diameter.** That is why this is one number and not a tolerance.

**And it is not a blank parameter in an existing file.** `cad/` holds the carrier and the magnet
cap; **there is no bracket model, and nothing in `cad/` contains a nose dimension.** The carrier
could be modelled because the hub was measured first — and even then it cost four wasted prints,
because the first hub figure came off a wire wrap and was 2.3 mm high. **A nose diameter read off a
photograph is the same mistake with the same cost.**

**What to measure now:**

| | |
|---|---|
| **① Nose diameter** | *The fixed collar's outside Ø — a wire round it, as before. This is what the clamp closes on. **Two photographs disagree**: end-on reads ~Ø85–90, the side view ~Ø72–75. Close-up perspective inflates the first. Measure it.* |
| **② Usable nose length** | *How much of that collar is **bare cylinder**: from where it leaves the gearbox body to where it ends. A clamp needs roughly 6–10 mm of it, and nothing — a rib, a step, a cable, the chassis — may be sitting on it.* |

**Both are taken with the wheel off**, which is also when the bracket gets fitted. The only thing
the wheel decides is whether the finished bracket fouls it, and the fit mule already answers that
for the carrier.

**Fallbacks, recorded so nobody re-derives them:** replace the housing's own assembly screws with
longer ones and hang the bracket off those; or bolt to the black chassis pocket the gearbox sits in.
Both work and **neither is concentric with the axle**, so both turn the air gap back into an
alignment job. Take the nose clamp if the nose exists.

##### Measurements this needs

Both forms need the hub measured; C-inc needs it to size the ring and the pitch table above.

| | |
|---|---|
| **Axial clearance, gearbox rotating part → wheel** | **≥ 8 mm** — *measured on the delivered vehicle and **this is what decided Branch C**. It was not written down at the time; recorded 2026-10-03.* |
| **Smallest obstruction radius in that 8 mm slice** | **≥ 46.01 mm needed** — ring (39.01) + air gap (3) + sensor (4). *Open, but **do not measure it** — print the fit mule, refit the wheel and turn it. `RADIAL_ROOM` stays negative in the model until something settles it, and says so on every build.* |
| Hub lobe-crest Ø, across opposite crests | **63.0 mm** *(2026-10-08, three positions).* **Three methods now disagree by about a millimetre:** wire wrap less its thickness **63.25**, tape across crests **63.00**, thin paper wrap less its thickness **61.97** (2026-10-12). The wraps err both ways — thickness pushes them high, chording across the six gaps pushes them low, and 35–40° gaps would account for the whole spread. **The across-crests figure has no chord term and is kept.** It does not reach the part: see below. |
| Hub form | **Six broad lobes, narrow gaps** *(2026-10-06 photographs — not a fine spline, which is why no chord correction applies)* |
| **Does the lobed boss stand clear of the housing end?** | **Yes — about 10 mm of it** *(2026-10-08 side view). This was the risk that could have killed Branch C: an end-on photograph made the hub look recessed inside the housing collar, and a Ø81 ring cannot reach a hub sunk inside a ~Ø72 bore. It is not sunk. The 6 mm ring goes on with room to spare — and therefore does not locate itself, so see the assembly note.* |
| **Gearbox housing nose — diameter and reachable length** | *(Open. **This is what the sensor bracket needs** — it replaces the screw-boss question, which the nose clamp makes unnecessary)* |

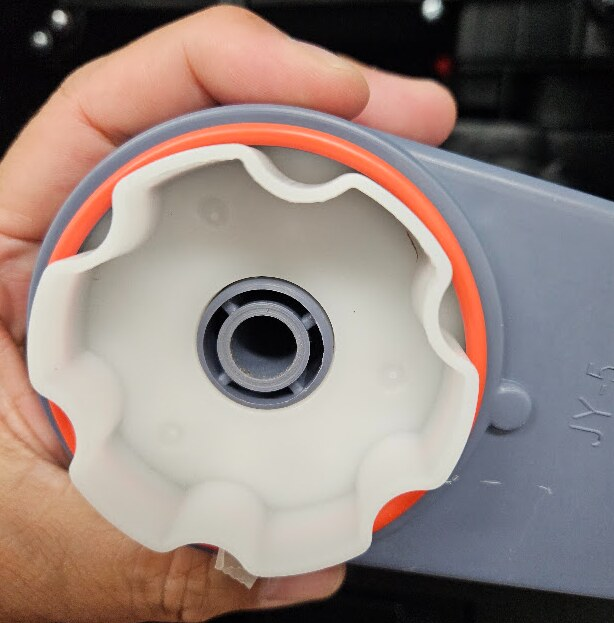
[picture p12: docs/images/photos/drive-hub-lobes-end-on.jpg]
The drive gearbox held in the hand with its output end towards the camera. The white hub stands proud of the grey housing as six broad lobes separated by six narrow gaps, a bearing and an open bore at its centre; a red wire lies in the gaps where it was wrapped to measure the circumference


*Six lobes, six gaps — 2026-10-06, the photographs the form row cites. **This settles the form
and nothing else.** The red wire is the circumference measurement the reading history below then
threw out, and the bore is empty because the gearbox is off the vehicle.*

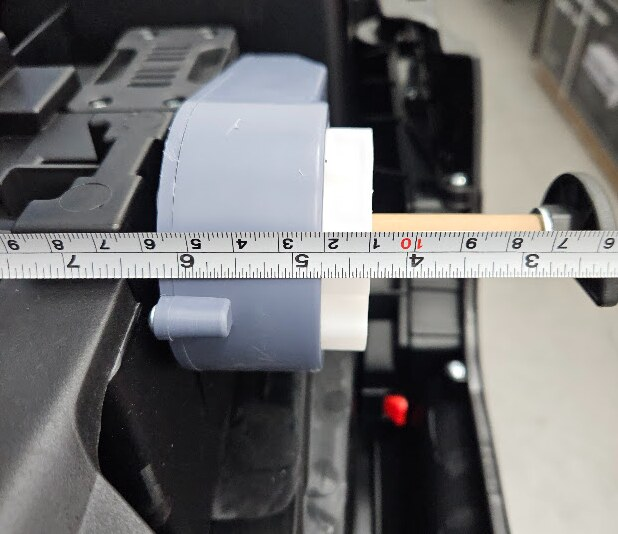
[picture p13: docs/images/photos/drive-gearbox-nose-side-view.jpg]
The same gearbox from the side, lying in the chassis with a tape measure along it. The white hub leaves the end of the grey housing as a separate step standing clear of it, between the housing and the wheel face


*The 2026-10-08 side view that answered the row above it: the lobed boss **stands clear**, it is
not sunk inside the housing bore. **Not evidence for the 10 mm** — that is a tape read against a
curved grey step, and the fit mule is what confirms it.*

> [!IMPORTANT]
> **8 mm is an AXIAL budget, and it is more comfortable than it first looked**
>
> *Corrected 2026-10-04.* An earlier revision treated the 8 mm as a stack of bracket arm **plus**
> sensor and concluded a TO-92 pair leaves ~1 mm. That assumed the sensors sit **beside** the
> magnets axially. They do not — they sit **outside** them radially, and the two sensors are spaced
> **along the circumference**, 6.80 mm apart.
>
> So the 8 mm has to contain the **magnet track's width** (4–6 mm) and the sensor's **axial**
> extent, side by side radially rather than stacked. Both package types fit.
>
> **So take TO-92, and that reverses what this page used to say.** Surface mount was preferred only
> while the axial budget looked tight; the budget was never tight, and the preference had no other
> leg to stand on. Two TO-92 bodies (4 × 3 × 1.5 mm) at 6.80 mm centres leave **2.80 mm of air**
> between them, which is comfortable.
>
> **What TO-92 buys is the whole of the difference.** SOT-23 means a PCB: a layout, a fab order, a
> lead time, and reflow or fine-pitch soldering by students. TO-92 means **two pockets printed into
> the bracket and six wires**. The spacing is fixed by the print either way — that was never the
> PCB's job — and a course with thirteen students and three vehicles should not have a PCB fab on
> its critical path for a part with two components on it.
>
> A multipole ring is 3–6 mm wide axially and sits *on* the hub, so it spends no part of this
> budget.

> [!NOTE]
> **The hub is splined, and a ring magnet's bore is not**
>
> "Hub outside diameter" means the **rotating output of the gearbox that drives the wheel** — the
> part [photographed at teardown](../images/photos/drive-hub-lobes-end-on.jpg) as a splined
> plastic boss with a bore through its centre, which the axle runs through once the gearbox
> is back in the vehicle. *(That photograph shows the bore **empty**; until 2026-11-09 this
> sentence said “with the axle through its bore”, which is not what it shows.)*
>
> A multipole ring has a **plain round bore**, so it cannot grip splines. Two cases:
>
> - **A plain cylindrical section exists somewhere on the hub** → the ring sits there directly, and
>   #6c is only the sensor bracket.
> - **The whole exposed surface is splined** → #6c also prints the **carrier**, which is what the
>   2026-10-03 teardown found and what the model above builds.
>
> **The carrier's bore is plain, not splined.** It does not drive off the tooth flanks — it is a
> clear bore pulled onto the crests by three grub screws. The carrier was dropped when loose magnets
> were replaced by a ring, and came back for an entirely different reason: not to space magnets, but
> to give them something round to sit on.
>
> Either way, the diameter to measure is **the surface the magnets will actually sit on**, which is
> the carrier's outside diameter in the second case.

> ([category 000400040012](https://www.devicemart.co.kr/goods/catalog?code=000400040012)) and filter
> on the electrical requirements above.

> [!WARNING]
> **The cheap optical sensors are single-channel — check before buying**
>
> **HC-020K** (~₩8,800) and the LM393 slot-type speed modules are the obvious hits when searching for
> a motor encoder, and they are **one channel**. They measure speed, not direction.
>
> They are usable only in pairs, mounted with a quarter-slot offset to synthesise A/B — which is
> fiddly to align and easy to get wrong. If the budget allows, a purpose-built quadrature part is
> the better buy at this scale. ₩25,000 per vehicle covers it.

---

### #17 USB camera — what "1080p wide-FOV" actually has to mean

The BOM line said *"USB 1080p wide-FOV"*, which is not a specification — it is the marketing copy on
every camera in the category. What semester 1 actually needs:

| Requirement | Why it matters |
|---|---|
| **UVC class, no driver** | It must enumerate as `/dev/video*` and work with `v4l2_camera` or `usb_cam`. A camera needing a vendor SDK or a Windows-only driver is a dead end on Ubuntu 22.04 — [sensors.md](../design/sensors.md) makes plain UVC a requirement, not a preference |
| **MJPEG at the resolution you will use** | **The trap in this category.** USB 2.0 cannot carry 1080p raw at 30 fps. Many cameras advertise "1080p 30fps" and deliver it *only* in MJPEG; in raw YUYV the same camera drops to **5 fps**. A student sees 5 fps and concludes ROS is broken |
| **≥ 30 fps at 1280×720** | Teleop needs frame *rate*, not pixels. 720p30 is better to drive from than 1080p5, and this vehicle is driven at walking pace by someone watching the feed |
| **Focus that can be locked** | Autofocus hunts continuously on a moving vehicle and every hunt is a blurred frame. Fixed focus avoids this by construction; an autofocus camera is fine **if** it exposes the UVC focus control, because then you turn AF off once and forget it. If it does not, you cannot |
| **70–120° horizontal FOV** | Wide enough for situational awareness. Past ~120° the fisheye distortion is severe enough to complicate calibration for no teleop benefit |
| USB 2.0 | Sufficient at 720p30 MJPEG. USB 3.0 buys nothing here |

**Resolution is the least important item on this list.** 1080p is already more than teleop needs; the
things that decide whether the camera is usable are the format and the frame rate.

> [!TIP]
> **The acceptance test is two commands, and it settles every question above**
>
> ```bash
> sudo apt install v4l-utils
> v4l2-ctl --list-devices
> v4l2-ctl -d /dev/video0 --list-formats-ext
> ```
>
> The second prints **every format, resolution and frame rate the camera actually supports** — not
> what the box claims. Look for a line like `MJPG … 1280x720 … 30.000 fps`. If 30 fps appears only
> under `MJPG` and not `YUYV`, that is normal and fine; it just means the ROS node must request
> MJPEG.
>
> **If the camera is autofocus**, add a third command — this is what decides whether AF is a
> non-issue or a permanent defect:
>
> ```bash
> v4l2-ctl -d /dev/video0 --list-ctrls | grep -i focus
> ```
>
> You want to see `focus_automatic_continuous` (or `focus_auto` on older kernels). If it is there,
> AF is fully solved:
>
> ```bash
> v4l2-ctl -d /dev/video0 -c focus_automatic_continuous=0
> v4l2-ctl -d /dev/video0 -c focus_absolute=<value>      # tune once, outdoors, at driving distance
> ```
>
> **An empty result has two readings, and they are opposites.** Either the camera has no focus
> mechanism at all — fixed focus, nothing to control, which is the *good* outcome — or it has
> autofocus the driver does not expose, which cannot be fixed in software.
>
> Distinguish them from the rest of the same output, not by guessing:
>
> ```
> white_balance_temperature ... flags=inactive
> exposure_time_absolute    ... flags=inactive
> ```
>
> **If controls appear marked `inactive`, the driver is listing hardware that exists but is
> currently overridden by an auto mode.** A driver that surfaces inactive controls is not hiding
> anything — so the absence of *any* focus entry means there is no focus unit to expose. That is a
> fixed-focus camera.
>
> Confirm optically, because it takes ten seconds: point the camera at detailed text at **20 cm**,
> then at something **2–3 m** away, and watch the stream. A fixed-focus lens simply goes soft up
> close and stays that way. An autofocus lens visibly hunts — the image pulses out of focus and
> back — within a second or two of the scene changing.

> [!WARNING]
> **What autofocus actually breaks — it is narrower than "blurry pictures", and worse**
>
> The damage is not blur. It is that **autofocus changes the focal length**, and
> [calibration.md §3](../design/calibration.md#3-camera-intrinsics) produces a `camera_matrix`
> (`fx`, `fy`, `cx`, `cy`) that is only valid for **one fixed focus position**. A camera that
> refocuses has different intrinsics from moment to moment, so the stored
> `config/calibration/camera_front.yaml` is describing a lens the camera no longer has.
>
> [§4](../design/calibration.md#4-extrinsics-camera-lidar-base_link) then chains through those intrinsics —
> it verifies that a LiDAR return projects onto the correct camera pixel — so it inherits the error.
>
> | Use | Affected by uncontrollable AF? |
> |---|---|
> | **Navigation, SLAM, obstacle avoidance** | **No.** The camera is not in that pipeline at all — it is LiDAR ([software.md](../design/software.md)) |
> | Teleoperation | No. Occasional hunting is a nuisance, nothing more |
> | CNN object recognition | Largely no. Networks tolerate moderate blur; hunting is intermittent |
> | **Camera intrinsics (§3)** | **Yes — this is the one that breaks** |
> | **Camera↔LiDAR extrinsics (§4)** | **Yes**, because it is computed through §3 |
> | Projecting detections into 3D, camera/LiDAR fusion | **Yes**, same reason |
>
> These land in **weeks 12–14**, during merge. So an AF camera whose focus cannot be locked is
> usable for two thirds of the semester and then fails exactly when the tracks integrate.
>
> **Not a reason to avoid autofocus cameras** — nearly all UVC webcams expose the control, and one
> command settles it. It is a reason to run that command **on arrival in week 10**, not in week 12.
>
> **Outcome for the 2026 cohort's camera:** fixed focus, confirmed 2026-09-30. `--list-ctrls`
> exposes no focus unit at all while listing other controls as `inactive`, so nothing is being
> hidden. The intrinsics are stable and §3/§4 are unaffected — this risk did not materialise.
>
> Run all of this on **one unit before buying three**. It is also the natural `Secured` check for
> this row.

> [!CAUTION]
> **The camera meeting the spec is not enough — the ROS driver has to ask for MJPEG**
>
> Validated on the 2026 test unit, which is exactly the shape the warning above predicts:
>
> | | 1920×1080 | 1280×720 | 640×480 |
> |---|---|---|---|
> | **MJPG** | 30 fps | **30 fps** | 30 fps |
> | **YUYV** | **5 fps** | **10 fps** | 30 fps |
>
> Now the part that bites. In Humble:
>
> | Driver | MJPEG? | Default `pixel_format` |
> |---|---|---|
> | **`v4l2_camera`** | **No** — YUYV / UYVY / GREY only | **`YUYV`** |
> | **`usb_cam`** | **Yes** — `mjpeg2rgb`, `raw_mjpeg` | — |
>
> So `ros2 run v4l2_camera v4l2_camera_node` at its defaults asks this camera for **YUYV at 10 fps**
> on 720p. Nothing errors. The image is live, correct, and a third the rate it should be.
>
> **Use `usb_cam` with `pixel_format: mjpeg2rgb`.** [sensors.md](../design/sensors.md) names
> "`usb_cam`/`v4l2_camera`" as if interchangeable; for a camera whose 30 fps lives only in MJPEG,
> they are not.
>
> The diagnostic signature is worth knowing, because it looks like a hardware problem: **640×480
> runs at 30 fps while 720p runs at 10.** That is not a slow camera or a slow laptop — it is YUYV
> hitting the USB 2.0 bandwidth ceiling, and the ceiling moves with resolution.

> [!NOTE]
> **Phase 2 will need a different camera, and that is already decided**
>
> Behaviour cloning needs a **global shutter** — rolling shutter smears during turns and corrupts
> the steering labels. [sensors.md](../design/sensors.md) pre-registers an **Arducam AR0234** class
> part (~$160–180) for that phase.
>
> So do not over-buy now. Semester 1 delivers teleop and LiDAR SLAM, neither of which cares about
> rolling-shutter skew. A cheap compliant camera is the correct choice, and the money is better
> kept for the global-shutter part later.

---

### #7, #8, #11, #12, #14 — what to actually buy

The five remaining Batch 1 items, specified to the level a vendor can fill. Sized against the
vehicle actually delivered: **stock ECU rated 20 A, a 10 A device in its supply, motor driver
limiting at 30 A.** Prices are rough Korean street estimates (**basis E**) — the budget is
₩225,000/set against these five, and the list below comes to roughly ₩200,000.

#### #7 — Relay MUX (~₩34,000)

Switches both motor circuits between the stock ECU and the motor driver. **De-energized = STOCK**
([safety.md §1](../design/safety.md#1-authority-arbitration-who-is-allowed-to-drive-the-motors)).

**Both conductors of each motor circuit must break.** Switching only the positive side leaves the
stock ECU's output tied to the driver's output through the motor winding. That is four poles:
two for throttle, two for steering.

| Qty | Part | Note |
|---:|---|---|
| 4 | **Automotive power relay, SPDT (1C), 12 V coil, 80 A, 5-pin** + matching socket | **One part for all four poles.** Sold as relay-plus-socket sets, often waterproof |

The design says "2× DPDT". **Use 4× SPDT instead** — a 30 A DPDT is hard to source in Korea, while
automotive SPDT relays with sockets are commodity parts. Four poles either way, and each is
separately replaceable.

> [!TIP]
> **Use the same 80 A relay for all four poles — and for the [#8](#7-8-11-12-14-what-to-actually-buy) E-stop as well**
>
> An earlier revision split this: 80 A for the throttle poles, 40 A for the steering poles, and a
> separate SPST-NO part for the E-stop. **Three part numbers, three sockets, three spares.**
>
> The steering poles only need a few amps, so 80 A there is over-specified — but a 5-pin SPDT
> wired `30→87` behaves exactly as SPST-NO, so **one part covers all five positions in the
> build**: four MUX poles plus the E-stop contactor. One socket type, one spare, one bracket
> footprint, one thing for a student to identify. In a three-vehicle build that is worth more than
> the few thousand won saved by under-specifying two of the poles.
>
> Leave `87a` unconnected on the E-stop relay.

> [!WARNING]
> **Relay current ratings are for RESISTIVE loads. Motors are inductive.**
>
> Datasheets in this class state e.g. *"Rated Load (Resistive Load): 13.5 VDC 80 A."* A DC motor
> is inductive and sustains the arc on break, so the usable figure is roughly **50–60 % of the
> resistive rating**:
>
> | Relay | resistive | usable, inductive | vs the 30 A drive branch |
> |---|---:|---:|---|
> | 40 A | 40 A | **20–24 A** | **insufficient** |
> | ~~80 A~~ **70 A — as marked on the body, 2026-10-26** | 70 A | **35–42 A** | 1.2–1.4× — adequate |
>
> This matters because the MUX does **not** only switch a parked vehicle. A brownout or an E-stop
> drops the coils **while the motors are running**, so these contacts break motor current under
> load by design ([failsafe rows 4 and 5](../design/safety.md#2-failsafe-matrix)).
>
> *Corrected 2026-10-01: this table previously specified 40 A for all four poles.*
| 1 | **`IRLZ44NPBF`** (Infineon, TO-220AB) — logic-level N-MOSFET | **Verified 2026-10-01.** Vgs(th) 1.0–2.0 V, Vds 55 V, Id 47 A. Four coils ≈ 600 mA total, so it dissipates under 0.1 W and needs no heatsink. **The TO-220 tab is the DRAIN** — do not bolt it to a grounded plate without an insulator. Buy spares; they cost little and are static-sensitive |
| 1 | 10 kΩ resistor, ¼ W — **gate to GND** | The pulldown |
| 1 | 100 Ω resistor, ¼ W — **Teensy pin to gate, in series** | Limits the current into the gate capacitance on each switching edge, protecting the Teensy pin |
| 4 | **1N4007** flyback diode, one across each coil | **Required even on coils that already carry a parallel resistor** — see below |
| 1 | **Perfboard (만능기판), soldered** | **Not a solderless breadboard** — see the warning below |
| — | **Hookup wire, 22–24 AWG**, two or three colours | Board-level wiring. The 1.5 mm² silicone of [#12](#7-8-11-12-14-what-to-actually-buy) is power cable and will not route on a board |
| 2–3 | **Screw terminal block, 2–3 way, 5 mm pitch** | Where the off-board wires land: Teensy gate line, 12 V, GND, four coil pairs. Lets a harness be unplugged without desoldering, and takes wire movement off the solder joints |
| 1 | Small enclosure | Can be printed off [#14](#7-8-11-12-14-what-to-actually-buy) |

> [!WARNING]
> **Build this on soldered perfboard. A solderless breadboard is not a prototyping shortcut here — it is a failure mode.**
>
> Breadboard contacts are spring clips. **This board goes on a vehicle that vibrates**, and the
> circuit it carries is part of the authority chain:
>
> - **The 10 kΩ pulldown is what makes de-energize-to-safe work.** An intermittent contact on that
>   leg leaves the MOSFET gate floating, and a floating gate can partially enhance — relays
>   chattering between STOCK and DBW while the vehicle is moving.
> - **600 mA through breadboard rails** is at the limit of what those clips are good for, and their
>   contact resistance is both high and unpredictable.
>
> **There is no breadboard stage for this board — not even
> [Stage 0](../design/safety.md#6-bring-up-protocol-staged-wheels-off-first).**
>
> *Corrected 2026-11-05. This paragraph used to say a breadboard was "genuinely useful at Stage 0,
> on the bench, to prove the driver switches from a 3.3 V pin **before anything is soldered**" —
> which puts the pulldown in a spring clip, contradicts the two bullets directly above it, and
> contradicts [§3.5.3](03-electrical.md#353-build-the-circuit-twice-and-not-for-the-reason-it-sounds-like)'s
> "**never carry, even on the bench**". Two pages disagreed about the one component the failsafe
> analysis rests on.*
>
> **The test it was reaching for is real — it just happens on the finished perfboard.** It is
> **step 4** of the build order in the [board figure](../images/relay-driver-board.svg): terminals
> on, coils last, then **drive the gate from a bench 3.3 V and listen for four clicks** before
> anything is bolted into the car. Same proof — the driver switches from a 3.3 V pin — with the
> pulldown **soldered** rather than clipped. *Deleting the breadboard step costs nothing but the
> spring clips.*
>
> **The breadboards this build buys are for the SIGNAL side**
> ([§3.5.3](03-electrical.md#353-build-the-circuit-twice-and-not-for-the-reason-it-sounds-like)):
> pull-ups, the quadrature count, the AS5600's AGC, and trying pin assignments while they are
> still free to move.

**Feed the coils from the logic rail**, so a logic brownout drops them to STOCK (failsafe row 4).
The **10 kΩ pulldown is safety-critical**: it holds the gate low — relays de-energized, STOCK —
whenever the Teensy is unpowered, in reset, or has not yet configured the pin as an output. A
floating gate can partially enhance.

> [!IMPORTANT]
> **Why a floating gate enhances at all — it is a capacitor, not a resistive input**
>
> The `IRLZ44N`'s input capacitance is around **1.8 nF**, and its `Vgs(th)` is **1.0–2.0 V**. So
> the charge needed to reach the bottom of that threshold band is
>
>     Q = C × V = 1.8 nF × 1 V ≈ 1.8 nC
>
> **Under two nanocoulombs.** With the pulldown in place that charge has somewhere to go. With the
> leg open it has nowhere — the gate holds what it has and keeps collecting more by capacitive
> coupling from the 12 V coil bus running a few millimetres away.
>
> **And partial enhancement is worse than fully on.** Fully on is DBW, which is at least a
> *defined* state. Partial puts the coils near their drop-out voltage, so the contacts chatter
> between `87a` and `87` — and [§3.4](03-electrical.md#34-wire-the-e-stop-and-mux-first) puts
> those contacts **in the motor leads**. Chatter is therefore motor current being made and broken
> repeatedly, under load, alternating between the stock ECU's output stage and the driver's, with
> whichever one is idle back-feeding through its own body diodes.
>
> **It also fails only when it matters.** A spring clip makes contact perfectly on a desk; it opens
> when the vehicle vibrates. Every bench check, every continuity check and every standstill mode
> switch passes. *That is the same signature as the crossed-pair fault in
> [§3.4](03-electrical.md#34-wire-the-e-stop-and-mux-first) — a fault whose every detection
> opportunity happens at a standstill.*
>
> **This is also why the pulldown is soldered first, before the MOSFET** (build order, step 1).
> Two reasons beyond the obvious: there is then **no window** in which a fitted MOSFET has a
> floating gate, and the gate has a 10 kΩ bleed to ground while the **static-sensitive** `IRLZ44N`
> is being handled and soldered.
>
> **Step 2 then meters 10 kΩ gate-to-GND, and that reading is not about the resistor.** *A meter
> can tell you a loose 10 kΩ is 10 kΩ before it ever goes in; what it cannot check until the
> resistor is soldered is **the two joints and the two holes** — a cold joint, a 1 kΩ misread off
> a thirty-value kit, a ground lead one pad short of the bus.* **Fitting nothing else first is
> what makes the number diagnostic:** 10 kΩ can then only mean the right part in the right two
> holes with both ends wetted, and anything else has exactly one suspect.
>
> *Corrected 2026-11-05: an earlier wording said the MOSFET would "confuse the reading". It would
> not — `Ciss` 1.8 nF against 10 kΩ settles in **18 µs**, far inside a meter's gate time. What a
> fitted MOSFET actually costs you is **attribution**: a low reading could then be the resistor or
> an ESD-punched gate, and you would have to take one off to find out.*

> [!WARNING]
> **`IRF520` is not `IRL520`, and the Teensy drives at 3.3 V**
>
> The common Arduino "MOSFET module" is built around an **`IRF520`**, whose Vgs(th) is **2.0–4.0 V**
> and whose on-resistance is specified at **Vgs = 10 V**. At 3.3 V a high-threshold sample may not
> turn on **at all**, and a low-threshold one sits in the linear region making heat instead of
> switching.
>
> The logic-level part is **`IRL520`** — one letter — or **`IRLZ44N`**, Vgs(th) 1.0–2.0 V. A
> pre-built module is fine *provided* it states **logic-level** or **3.3 V compatible**; most do
> not, because they were designed for 5 V Arduinos where an IRF part is merely marginal rather
> than dead.

> [!WARNING]
> **A parallel resistor across the coil is not a flyback diode. Fit the 1N4007 anyway.**
>
> Relays in this family ship with a **680 Ω resistor** across the coil, and it is tempting to read
> that as the clamp already being there. It is not. When the MOSFET turns off, the coil's 150 mA
> has to keep flowing, and the resistor is the only path:
>
> | clamp | voltage the MOSFET sees |
> |---|---:|
> | 680 Ω resistor alone | **0.150 A × 680 Ω = 102 V** |
> | 1N4007 flyback | 12 + 0.7 ≈ **12.7 V** |
>
> A logic-level MOSFET in this class is rated **55 V** drain-source. 102 V is **nearly twice
> that.** The resistor damps ringing; it does not clamp. **One ₩100 diode per coil.**
>
> *(If a variant ships with a built-in **diode** rather than a resistor, then the clamp is real —
> but coil polarity on 85/86 becomes mandatory, and reversing it shorts the drive.)*

> [!CAUTION]
> **A 40 A socket may not fit an 80 A relay**
>
> Relays at 80 A commonly use **wider power blades** on 30/87 — 9.5 mm against the standard
> 6.3 mm — because 80 A through a quarter-inch blade is a lot. The coil terminals stay 6.3 mm, so
> a 40 A pigtail socket will take the coil pins and **not** the power pins.
>
> **Buy the socket that matches each relay**, not one socket type for all four poles. Check the
> blade width on the 80 A part before ordering its socket.

#### #8 — E-stop + contactor (~₩40,000)

| Qty | Part | Note |
|---:|---|---|
| 1 | **22 mm latching mushroom with 2a2b contacts** — 한국미스미 **`MRE-RR2R`** | **Verified 2026-10-01.** Decodes as `R` protruding Ø22 / `R` push-lock turn-reset / **`2` = 2a2b** / `R` red. The two **b접점 (NC)** are the ones that matter; the two a접점 go unused. Snap-action, IP65, screw terminals.

> `2a2b` arrives as **two stacked `1a1b` blocks**, not one block with four contacts — so the two NC you need sit on **different blocks**, one each. Identify them by the terminal marking before wiring; taking both circuits off one block gets you one NC and one NO, and the NO half of the E-stop would then do nothing until pressed and nothing at all if its wiring failed. |
| 1 | **The same 80 A SPDT relay as [#7](#7-8-11-12-14-what-to-actually-buy)**, wired `30→87`, `87a` unused | A dedicated SPST-NO part (e.g. Foocle `FLS820-012-1A`) also works, but standardising on one relay across the build is worth more than the saving |
| 1 | **1N4007 across the contactor coil** | Arc suppression, so the E-stop contact is not eroded by breaking an inductive DC load. It delays drop-out by tens of ms, which is centimetres at walking pace |

> [!IMPORTANT]
> **Three things decide this part, and the amp figure is the least of them**
>
> **1 — "연속정격 / continuous duty", not "단속정격 / intermittent".** A starter solenoid looks
> identical, costs half, and is rated for *seconds* of conduction. MRider energizes this coil for
> the whole session. An intermittent part will cook. This single keyword matters more than the
> current rating.
>
> **2 — DC-rated.** An AC-rated switch breaking DC can weld its contacts closed, and the failure
> is **silent until the button is pressed.** Continuous-duty automotive solenoids are inherently
> DC parts, which is why this class is the right one.
>
> **3 — coil current, because it cascades.** Reference parts (White-Rodgers, Trombetta class) draw
> **~500 mA** at 12 V. That is the figure the E-stop's NC block has to break — **check the block's
> DC rating, not its AC rating**, which is the same trap one level down.
>
> **A power relay beats the solenoid class here, on the one spec that cascades.** `FLS820-012-1A`
> (80 A, 12 V) has an **80 Ω coil → 150 mA at 1.8 W**, against roughly **500 mA** for a
> continuous-duty solenoid of the same contact rating. That is the figure the E-stop's NC block
> has to break and the figure the logic battery carries, so a third of it is a real win. Release
> time **≤ 5 ms**, and **AgSnO₂In** contacts, which is the material used precisely because it
> resists DC arc welding.
>
> **1.8 W is also what settles the duty question.** Starter solenoids are intermittent-rated
> because their pull-in coils dissipate tens of watts. A 1.8 W coil can hold indefinitely, which
> is what MRider asks of it.
>
> **Check three things on any listing in this class:**
>
> - **That the coil is 12 V.** This family ships 12 V and 24 V in the same shell, and the Korean
>   titles carry the voltage — `KKA-B4 릴레이 **24V** 40A 4핀`. The 24 V coil is **320 Ω with a
>   16 V pick-up**, so on this vehicle's rail it simply will not pull in. The 12 V coil is 80 Ω,
>   pick-up ≤ 8 V.
> - **That you are ordering the 12 V / 80 A variant.** These listings routinely carry several in
>   one title — *"24V 100A 12V … SPDT 80A"* — and the title is not the order. This project has
>   already been bitten twice by trusting a listing title over its specification table: the
>   Sabertooth 2x25/2x32 SKU and the FS-iA6/iA6B bundle. **Read the option you select, not the
>   headline.** *The Sabertooth was cancelled over exactly that ambiguity and a Cytron MDDS30
>   bought instead — [dbw.md §4.1](../design/dbw.md#41-part-substitution-cytron-mdds30-replaces-the-sabertooth-2x32-2026-09-29).*
> - **Do not expect the listing to tell you the contact rating.** See the box below: on the part
>   actually evaluated, neither the title nor the description was trustworthy. Design so it does
>   not matter.
> - **Coil current.** Four coils run off one MOSFET and off the logic battery. 150 mA each is
>   600 mA; 250 mA each is 1 A, which starts to matter on a 7 Ah rail that must outlast a session.
>
> **Also check:**
>
> - **Contact form.** `-1A` is SPST-NO — correct for the E-stop, where de-energized must mean
>   open. `-1C` is SPDT, which is what [#7](#7-8-11-12-14-what-to-actually-buy) wants instead.
> - **Whether the coil has a built-in diode or resistor across it.** Some variants in this family
>   ship with a 680 Ω parallel resistor; if yours has a **diode**, coil polarity on pins 85/86
>   matters and reversing it shorts the drive. A built-in diode also means the separate 1N4007
>   is redundant.
>
> [!CAUTION]
> **On the parts evaluated here, the contact rating could not be established from the listing — so stop needing it**
>
> `KKA-B4 / TYE-RL082` (디바이스마트, ₩12,100 incl. socket) is **titled 80 A** and **described as
> "NO : 40A 14V / NC : 30A 14V / 1a1b1c"**. Those disagree, and the description is not
> per-variant — the **4-pin** listing in the same family carries that line **verbatim**, including
> an NC rating and a `1c` form on a part that physically has **no NC contact**.
>
> Comparing three listings in the family says where it came from:
>
> | listing | title | shared description | agree? |
> |---|---|---|---|
> | 80 A, 5-pin | 80 A | NO 40 / NC 30 | no |
> | 80 A, 4-pin | 80 A | NO 40 / NC 30 | no |
> | **40 A, 4-pin** | **40 A** | NO 40 / NC 30 | **yes** |
>
> The boilerplate matches the **40 A** sibling exactly, so the likeliest reading is that it was
> written for that part and copied onto the 80 A listings — making the 80 A titles probably
> correct. The `FLS820` datasheet for the same form factor, from another brand, independently
> states `MAX Operating Current 80A` and `Rated Load 13.5VDC 80A`.
>
> **It still cannot be confirmed per-variant from any listing**, which is the point: design so it
> does not have to be.
>
> **ANSWERED 2026-10-26, by reading the relay instead of the listing.** The 5-pin body is marked
> **`COIL:12VDC · 70A/14VDC · 40A/28VDC`** (`KKA B8`, `0121Z23`). So **neither figure on the page
> was right**: the title said 80 A, the shared boilerplate said NO 40 A, and the part is **70 A at
> 14 V** — and it halves at 28 V, which is why a single number was never going to settle it.
>
> **The design still holds, which was the whole point of constraining it.** 70 A inductive-derated
> is **35–42 A against a 20 A limit — 1.75–2.1×.** The 4-pin is marked **`NO 40A 14VDC`**
> (`KKA V4`, `012-1H-12`), exactly as its listing said, and the resistive-break argument below is
> unaffected.
>
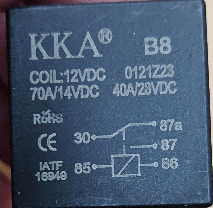
[picture p14: docs/images/photos/relay-5-pin-body.jpg]
The 5-pin relay's moulding, photographed close. It reads KKA B8, COIL:12VDC, 0121Z23, 70A/14VDC, 40A/28VDC, RoHS, CE, IATF 16949, above a moulded schematic whose common terminal 30 goes to a changeover pair 87a and 87, with the coil across 85 and 86
> 
>
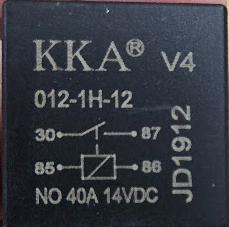
[picture p15: docs/images/photos/relay-4-pin-body.jpg]
The 4-pin relay's moulding. It reads KKA V4, 012-1H-12, JD1912 and NO 40A 14VDC, above a schematic with four terminals only: 30 to 87 through a normally-open contact, and the coil across 85 and 86 — there is no 87a
> 
>
> *Both vehicle #1's parts, 2026-10-26 ([provenance](../images/photos/MANIFEST.md)). These are the
> photographs this answer was read off. The 5-pin's **87a** is visible in its schematic and absent
> from the 4-pin's, which is the difference the authority MUX depends on.*
>
> *The lesson is small and repeatable: three listings could not answer this and one photograph of
> the moulding did. **Read the part, not the page.***
>
> Chasing it is the wrong move. **Constrain the system instead**, so any rating in this class is
> sufficient:
>
> | | |
> |---|---|
> | **Drive-channel current limit** | ~~**20 A**~~ — **not available.** The MDDS30 has no settable limit ([dbw.md §4.1](../design/dbw.md#41-part-substitution-cytron-mdds30-replaces-the-sabertooth-2x32-2026-09-29)); struck 2026-11-10. The fuse row below is the only constraint left in this table |
> | Main traction fuse | **25 A** |
> | Worst case the contacts break | even the pessimistic 40 A NO reading gives 20–24 A inductive |
>
> **20 A is already twice what the whole stock vehicle runs on** — its own inline device is 10 A,
> for the same motors doing the same job. And the current these contacts actually break in service
> is the **driving** current, 5–15 A at walking pace: a failsafe revert happens while moving, not
> while stalled.
>
> Where the limit is set depends on what the board exposes — a driver-side setting if it has one,
> otherwise firmware throttle shaping plus the fuse. **Check this when the boards arrive**; it is
> not yet known whether the selected driver offers an adjustable limit.
>
> With that in place the 80 A question never has to be answered.
>
> **Buy two part numbers, not one, and let the roles be physically distinct:**
>
> | position | part | why |
> |---|---|---|
> | 4× MUX poles | **5-pin SPDT** | The MUX needs a changeover: NC → stock ECU, NO → driver. A 4-pin SPST cannot make the NC path |
> | 1× E-stop contactor | **4-pin SPST-NO, 40 A** — `TYE-RL076` (12 V 40 A 4핀) | Only ever uses `30→87`, and **the inductive derate does not apply here** — see below |
>
> This reverses an earlier preference for a single part number, and there are two reasons, both
> better than price.
>
> **A 4-pin relay physically will not seat in a 5-pin MUX position**, so the one relay with a
> different job cannot be swapped into the wrong place by a student rebuilding a harness.
>
> **And the two positions break different kinds of current.** The MUX poles sit **in series with
> the motor leads**, so they break an inductive load and take the 50–60 % derate — which is why
> they need the 80 A part. The E-stop contactor sits in the **B+ supply to the driver**, upstream
> of the H-bridge: the motor's stored magnetic energy is on the *other* side of the bridge and
> never reaches this contact, while the driver's input capacitance works against the arc rather
> than feeding it. That break is essentially resistive, so a **40 A contact against a 20 A limit
> is a straight 2×**, not a marginal one.

> **If the seller ships "one of two models at random"** — which this listing does, at 26×26×38 or
> 28×28×42 mm — **mount to the socket, not to the relay body.** The pin pattern is the ISO
> automotive standard and is common to both; only the shell differs. Buying the matching socket
> makes the random dimension irrelevant, which matters when three vehicles must end up alike.
>
> **Feed the contactor coil from the traction pack, not the logic rail.** The designed safe state
> on a logic brownout is *the factory-controlled vehicle*, not a dead one
> ([failsafe row 4](../design/safety.md#2-failsafe-matrix) reverts to STOCK, with traction still
> available to the stock ECU). Coil from the pack gives exactly that, and keeps 500 mA off a 7 Ah
> logic battery that is already carrying four relay coils.

> [!IMPORTANT]
> **NC, never NO — and two of them**
>
> **Do not order the `1` contact option** (`1a1b`) — it carries only **one** NC, and this design
> needs two independent ones. In the `MRE` series that is the third character: `MRE-RR**2**R`.
>
> **And `MRF` is not `MRE`.** Same manufacturer, adjacent catalogue pages, one letter apart:
>
> | | series | latching option |
> |---|---|---|
> | **`MRE`** | **비상정지 스위치** — mushroom | **`R` 푸시 록 턴 리셋** |
> | `MRF` | 푸시버튼 스위치 — flush/extended cap | `A` 유지동작 (Alternate) |
>
> An `MRF` part can be ordered with the right `2a2b` contacts and still be unusable here, because
> the other two attributes are both safety-relevant:
>
> - **The actuator is not a mushroom.** An E-stop must be strikeable with a palm, without aiming,
>   by someone who is not looking at it. A flush cap needs a fingertip placed on it.
> - **`Alternate` is not `push-lock turn-reset`.** Alternate releases on a *second press* — the
>   same careless motion that triggered it. The contactor coil runs straight through this contact,
>   so a second bump **re-energizes traction with no deliberate act**. That is the same hazard
>   class as the vehicle's auto-resetting thermal breaker, which this design already refuses to
>   inherit. Turn-reset requires a different motion on purpose.
>
> [!CAUTION]
> **The actuator must be RED, on a YELLOW background. This is not cosmetic.**
>
> `ISO 13850` requires the emergency-stop actuator to be **red**, with the surface immediately
> around it **yellow**. Catalogue codes carry the colour as a trailing letter and the correct type
> is available in the wrong colour — e.g. `KGE-H4R2**G**` is a conforming Ø22 push-lock turn-reset
> with 2a2b contacts, and **green**.
>
> **Green means start.** Thirteen students will operate three vehicles, and under stress a person
> reaches for the colour, not the shape. A green mushroom is the one control that could be pressed
> *expecting* motion. Order the `…R` variant.
>
> The yellow half costs nothing here: **print the E-stop's mounting plate in yellow PETG** off
> [#14](#7-8-11-12-14-what-to-actually-buy), which is already in the BOM for the enclosures.

> **Do not trade this part's correctness for lead time.** The E-stop is not needed until
> [Stage 3](../design/safety.md#6-bring-up-protocol-staged-wheels-off-first), which is two stages
> after anything is first powered — so a two-week ship date costs nothing here.
>
> **Decided 2026-10-01 — `MRE-RR2R`, 한국미스미.** Three candidates were evaluated and the two
> faster ones each failed on a different attribute, which is why all three are recorded:
>
> | part | ships | verdict |
> |---|---|---|
> | **`MRE-RR2R`** 한영넉스 | 10/16 | **chosen** — Ø22, push-lock turn-reset, 2a2b, red, IP65, snap-action |
> | `MRF-AA2R` 한영넉스 | next day | rejected — **pushbutton, not E-stop**: flush Ø30 cap, and `Alternate` releases on a second press |
> | `KGE-H4R2G` KGE Auto | next day | rejected — correct device, **green**. Its red variant ships 10/23, later than the choice |
>
> The fastest option was wrong, and the correct-but-green option's red variant was slower than
> simply ordering the right part first.
>
> **Why NC (b접점).** An emergency stop must **open** a circuit that is closed in normal operation,
> so that a cut wire, a loose terminal, or a corroded contact **stops the vehicle** rather than
> silently disabling the stop. Wired through an **NO** contact, the E-stop does nothing at all
> until pressed — and nothing when its wiring fails, with no indication. This is why every
> industrial E-stop uses NC contacts, and it rules out the hobby "mushroom switch" parts sold with
> a single NO contact for signalling a microcontroller input.
>
> **An AC-only contact rating is acceptable on this button — and the reason is not "the current is
> small".** Blocks in this class are rated e.g. *6 A 250 V a.c.* with no DC figure at all, which
> elsewhere in this document is a red flag. Here it is not, for two specific reasons:
>
> - **A sustained DC arc needs roughly 12–14 V across silver contacts.** The AC/DC derating that
>   wrecks switches is driven by *voltage*, not current — it is why a 250 V AC block collapses to
>   a fraction of an amp at 30 V DC and to almost nothing at 110 V DC. At **12 V** the supply is
>   at or below the threshold that keeps an arc alive, so the arc self-extinguishes.
> - **Both loads are diode-clamped.** The contactor coil carries its own 1N4007 and each MUX relay
>   coil carries one, so neither circuit can push the contact voltage above the rail during break.
>
> Combined with ~150 mA and ~600 mA, this is a benign duty. **The derating that governs the
> contactor does not reach the button, because the button was kept out of the traction path** —
> which is the entire reason for the contactor pattern.
>
> **Why two.** The button has to do **two things**, and they sit on **two different power rails**,
> so no single contact can reach both.
>
> ```
>  traction pack ──[ NC #1 ]── contactor coil ───▶  traction power cut
>  logic rail ────[ NC #2 ]── MOSFET ── 4× MUX coil ──▶  authority reverts to STOCK
> ```
>
> **The first reason is that the E-stop does not cut the logic rail — deliberately.**
> [safety.md §4](../design/safety.md) pins it: *"E-stop cuts traction power **only**."* The Teensy
> stays alive so it keeps reporting state and the operator can still see what the vehicle thinks.
> But the MUX coils are fed from that same surviving rail, so **they stay energized through an
> E-stop** unless something breaks them separately. Cutting traction alone would stop the vehicle
> and leave it latched in DBW — and on reset it would come back in DBW rather than STOCK.
>
> **The second reason is a failure the first does not cover.** The coil driver's credible failure
> is a **MOSFET shorted on**: relays stuck energized, stuck in DBW. No firmware can fix that,
> because firmware is upstream of the short. Breaking the **coil supply** with its own contact
> overrides it in hardware.
>
> A `2a2b` block set gives the two **b접점** this needs; the two **a접점** are spare. One optional
> use for them: feed an E-stop-pressed signal to a Teensy input, so `DbwStatus` can report the
> button's state rather than the operator inferring it. That is a convenience, not a safety layer —
> the safety is entirely in the two NC contacts.
>
> Buy the button only after the contactor: the contactor's coil current sets the block rating.

#### #11 — Isolated logic rail (~₩47,000)

| Qty | Part | Note |
|---:|---|---|
| 1 | **SantaLi `SLB1206`, 12.8 V 6 Ah LiFePO₄** ([디바이스마트 16071444](https://www.devicemart.co.kr/goods/view?no=16071444)) | **Verified 2026-10-02.** 10.0–14.6 V range, **740 g** against the SLA's 2 500 g, IP54, F2 spades *and* a 5.5-2.1 barrel jack. BMS integral: **OCP 60 A, UVD 9.2 V, charge cut-off 15.0 V** |
| 1 | **SantaLi `SLC 1202`**, 14.6 V 2 A ([디바이스마트 16071454](https://www.devicemart.co.kr/goods/view?no=16071454)) | **Sold separately. Chosen 2026-10-02 over the 4 A `SLC 1204`** — the manufacturer's own matrix pairs `1202` with **SLB 12 V 6–12 Ah** and `1204` with **12–18 Ah**, so the 6 Ah pack sits below the `1204`'s range. Φ5.5-2.1 plugs straight into the pack's jack |
| 2 | **DC-DC buck, 12 V → 5 V, fixed output, 1–2 A** | One for Teensy + sensors, one for RC receiver + signal MUX. Separating them keeps servo-side transients off the rail holding the safety supervisor. **Fixed, not adjustable** — see below |
| 2 | **1000 µF electrolytic, 25 V**, 105 °C | Hold-up, per [safety.md §5](../design/safety.md#5-power-rail-isolation-and-brownout-protection). **25 V, not 16 V** — see below |
| 2 | Resistors for a divider into a Teensy analog pin | The logic-rail **undervoltage monitor** of failsafe row 4. **Required** — "two resistors, not a module" means skip the *module*, not the monitor |
| 1 | Blade fuse holder + **5 A** fuse | |

**A non-isolated buck is adequate.** The isolation that matters — traction from logic — is provided
by the separate battery. Galvanic isolation downstream of it buys nothing here.

**Current capability is not the spec to shop on.** Each 5 V rail carries roughly **120 mA**, so a
1 A module is already eight times the load. Two other properties matter far more.

> [!WARNING]
> **Buy a *buck*, fixed at 5 V. Not a buck-boost, and not adjustable.**
>
> Korean listings for these modules are usually **`승압/강하 … 가변`** — boost *and* buck, trimmer
> adjustable. A common example pairs an `LM2577` boost with an `LM2596` buck. **That is the wrong
> part twice over.**
>
> **Fixed, not adjustable (가변).** A trimmer can be knocked in a harness, drift, or be set wrong
> once. This rail feeds the Teensy's **3.6–5.5 V** input and the board holding the entire safety
> supervisor.
>
> **Buck only (강압), not buck-boost (승압/강하).** A buck's output is `Vin × duty`, so it is
> **physically incapable of exceeding its input** — a failed buck tops out at the rail, 12.8–14.6 V.
> A boost stage has no such bound and can produce 30 V+. Both figures kill a Teensy, but one is
> bounded by the battery and the other is not, and the bound is free.
>
> **A 5 V RC UBEC is the easiest part that satisfies both.** It is a fixed-output buck built to run
> receivers off a battery pack — which is literally one of the two loads here — 5 V out, 3 A. If it
> carries a 5 V / 6 V jumper, confirm it is on **5 V**: a jumper is far harder to disturb than a
> trimmer, but it is still a setting.
>
> **Check its INPUT rating against the charging voltage, not against the nominal 12.8 V.** This is
> the one place the LiFePO₄ pack bites: the rail sits at 12.8 V in use but reaches **14.6 V while
> charging**, and the BMS does not cut until **15.0 V**.
>
> | | input | % of a 16 V part | headroom |
> |---|---:|---:|---:|
> | pack nominal | 12.8 V | 80 % | 3.2 V |
> | **charging** | **14.6 V** | **91 %** | 1.4 V |
> | BMS cut-off | 15.0 V | 94 % | 1.0 V |
>
> **Chosen 2026-10-02: the 7–40 V UBEC** ([디바이스마트 1078321](https://www.devicemart.co.kr/goods/view?no=1078321), 5 V 3 A continuous), over
> Adafruit's `ada-1385`. Both are correct-topology fixed 5 V 3 A buck UBECs; they differ only in
> input rating, and that is where the pack bites:
>
> | | `ada-1385` (6–16 V) | 1078321 (7–40 V) |
> |---|---:|---:|
> | pack nominal 12.8 V | 80 % of rating | 32 % |
> | **charging 14.6 V** | **91 %** | 37 % |
> | BMS cut-off 15.0 V | 94 % | 38 % |
>
> The `ada-1385` is inside spec at every point and would work. The 7–40 V part simply deletes the
> question, costs no more, and needs no "disconnect while charging" caveat. Its 7 V lower bound is
> never approached either — the BMS cuts at 9.2 V and the firmware reverts at 11.5 V.
>
> It also survives a change of chassis class without being re-selected, which is the same reason
> [§1.2.4 keeps voltages out of the build pages](#7-8-11-12-14-what-to-actually-buy).
>
> **Confirm its 5 V output is fixed** — some UBECs carry a 5 V / 6 V jumper.
>
> **The same input-rating question applies to the hold-up capacitors, and this page got it wrong
> once.** It originally said *"1000 µF 16 V"*, which is the identical **91 % at 14.6 V** figure that
> disqualified the `ada-1385`.
>
> | | 16 V part | 25 V part |
> |---|---:|---:|
> | pack nominal 12.8 V | 80 % | 51 % |
> | charging 14.6 V | **91 %** | 58 % |
>
> **Put the hold-up on the 12 V rail, at the UBEC inputs, and use 25 V parts.** The 12 V side is
> where the capacitance does more: 1000 µF from 12.8 V down to the UBEC's 7 V floor is about
> **95 ms** of ride-through for the logic load, against roughly 3 ms if the same part sits on the
> 5 V output.
>
> A 16 V part is not *wrong* — at 105 °C rated and room-temperature ambient its life is long, and
> 14.6 V only appears while charging. But 25 V costs the same, and **16 V would be usable only on
> the 5 V side**, where it buys far less hold-up.
>
> If only an adjustable buck is available, set it, **seal the trimmer**, and record the measured
> voltage.

> [!CAUTION]
> **Cut the Teensy's `VUSB`–`VIN` pads before powering it from this rail**
>
> On a Teensy 4.1, `VUSB` and `VIN` are **joined by default**, so external power on `VIN` with a
> USB cable attached shorts two supplies together and **back-feeds the laptop's USB port**. PJRC
> provides a pair of pads on the underside to be cut apart for exactly this case.
>
> This is not optional on MRider: the Teensy sits on the logic rail *and* keeps a permanent USB
> link to the laptop, because that link carries both command and feedback
> ([failsafe row 2](../design/safety.md#2-failsafe-matrix)). **Every one of the three boards needs
> the cut**, and it has to happen before the first time external power and USB are present
> together — which is [Stage 0](../design/safety.md#6-bring-up-protocol-staged-wheels-off-first).
>
> The damage lands on a **student's own laptop**, which is the kind of mistake this project cannot
> make thirteen times.

> [!WARNING]
> **The 12 V 7 Ah SLA is the wrong part — oversized by 3× and heavy enough to matter**
>
> Measured against the actual load rather than a guess:
>
> | | |
> |---|---:|
> | 4× MUX relay coils (150 mA each) | **600 mA** |
> | Teensy, angle sensor, RC receiver, signal MUX — 240 mA at 5 V through an 85 % buck. *The 240 mA was budgeted with "driver logic" in it; the driver powers itself from `B+`, so this row is high, not low (2026-11-10)* | 118 mA |
> | **Total at 12 V** | **≈ 720 mA, 8.6 W** |
>
> The relay coils are **84 %** of it, and they are irreducible: a latching relay would cut the
> draw and is forbidden here, because de-energize-to-safe requires a relay that drops out when
> its coil loses power.
>
> | Pack | usable | runtime | mass |
> |---|---:|---:|---:|
> | 12 V 7 Ah SLA (50 % DoD) | 3.5 Ah | 4.9 h | **2500 g** |
> | 4S LiFePO₄ 2.5 Ah (80 %) | 2.0 Ah | 2.8 h | 300 g |
> | 3S Li-ion 2.6 Ah (80 %) | 2.1 Ah | 2.9 h | 180 g |
>
> **2–3 Ah covers a session.** The SLA buys runtime nobody needs and spends **2.5 kg** doing it —
> against a [C1 kit budget](../design/vehicle.md) of ~6 kg total, of which the control box,
> battery and wiring share 3–4 kg. The logic battery alone would take most of that bucket, and
> `vehicle.md` names **centre of mass** rather than mass as the real tip-over risk: a 2.5 kg brick
> on the deck is the worst single item to place.
>
> **The rail tolerates a wide window**, so chemistry is a free choice: the bucks accept a range and
> the relays pick up at **≤ 8 V**. Anything delivering roughly **9.5–14 V** works.
>
> **Prefer LiFePO₄ over LiPo, and the reason is the course, not the physics.** A 4S LiFePO₄ pack
> is **12.8 V nominal** — a near-exact 12 V replacement with a flat discharge curve, which is what
> you want under a rail feeding the safety supervisor — and its chemistry does not enter thermal
> runaway the way LiPo does. Thirteen students will charge, store, knock and eventually puncture
> these over a semester. A 3S Li-ion pack **with an integrated BMS** is the acceptable second
> choice. **Bare LiPo is not**, whatever the drone hobby does with it.
>
> **Changing chemistry moves one firmware constant**: the logic-rail undervoltage threshold of
> [failsafe row 4](../design/safety.md#2-failsafe-matrix).
>
> **Set it to 11.5 V for the `SLB1206`.** The reasoning, so it can be re-derived for another pack:
> a 4S LiFePO₄ sits flat near 13.0 V for most of its discharge and then falls quickly, and this
> pack's **BMS cuts at 9.2 V**. The firmware threshold has to sit *above* the BMS cut-off, so the
> Teensy sees the rail failing and reverts to STOCK **deliberately**, rather than having the BMS
> remove power from the safety supervisor without warning. 11.5 V is below the flat region — no
> false trips — and leaves enough energy above 9.2 V to execute the revert.
>
> **The protections are then ordered correctly**: the 5 A fuse blows first, the firmware monitor
> trips next, and the BMS's 60 A OCP / 9.2 V UVD is the last resort that should never be reached.
>
> **Why the 2 A charger and not the 4 A.** Both are inside the pack's recommended 2–4 A, so the
> decision is not about whether 4 A would work. The manufacturer assigns `1202` to this pack size
> and `1204` to the next one up, and deviating from a vendor's own pairing needs a reason better
> than *faster*. There isn't one here: **3 hours against 1.5 is invisible** when the packs charge
> between weekly sessions and run 6.7 hours on a charge. And **0.33 C is gentler than 0.67 C** on
> cells that three cohorts will share.
>
> **Do not operate the vehicle while charging.** At 14.6 V the rail is inside the relay coils'
> rating at room temperature (20.2 V) but close to their **15.7 V limit at 85 °C**.
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
