jrkwon/mrider/docs/design/bom.md

# Bill of Materials (BOM)

> Part of the MRider design set. Siblings: [architecture.md](architecture.md) ·
> [vehicle.md](vehicle.md) · [dbw.md](dbw.md) · [safety.md](safety.md) ·
> [sensors.md](sensors.md) · [software.md](software.md) ·
> [calibration.md](calibration.md) · [overview.md](overview.md)

**All prices are estimates as of August 2026** in USD and vary by retailer, coupon,
and stock. They are for budgeting, not quotes. Verify at purchase.

**Revised 2026-08-07** following [D3](adr-dbw-architecture-review.md#46-decision-adopted-2026-08-07)
(single Teensy replaces Pixhawk + Nano) and a re-scoping of the sensor package to
semester-1 needs. **Estimated total fell from ~$1,570 to ~$910** — see §Change record.
Totals were re-added and corrected on **2026-08-10**, and a USB gamepad (#15) added.

The **laptop is not a purchased line item** — it is lab-supplied/reused
([sensors.md §6](sensors.md)), and runs on its own battery in v1.

---

## Purchase tiers

Buy in **two tiers** so the perception spend happens only after the DBW gates pass. If the
steering spike fails at [bring-up Stage 1](safety.md#6-bring-up-protocol-staged-wheels-off-first),
Tier 2 has not been bought yet.

- **Tier 1 — Vehicle + DBW core.** Order in week 1, after the
  [steering-shaft travel measurement](dbw.md#6-adr-angle-sensor-technology-magnetic-encoder-vs-potentiometer).
- **Tier 2 — Perception.** Order by week 10.

---

## Tier 1 — Vehicle + DBW core

| # | Item | Spec / Model | Design ref | Reuse? (mrover) | Est. ($) | Source / note |
|---|---|---|---|---|---:|---|
| 1 | **Vehicle (chassis)** | **12 V single-seat** ride-on, dual motors, parent remote | [vehicle.md ADR D-R](vehicle.md#adr-d-r-reversal-to-the-12-v-single-seater-2026-08-08) | **No** — class changed | 165 | Land Rover Defender, 98×56×47 cm, 10 kg, ₩229,000. **ADR D was reversed**; see the note below |
| 2 | **Teensy 4.1** | 600 MHz Cortex-M7, 4× hardware QDC, 8× serial | [dbw.md §9](dbw.md#9-teensy-41-firmware-platform-and-version-pinning) | New | 32 | Replaces Pixhawk 6C + PM02 + Nano + USB-TTL |
| 3 | **Cytron MDDS30** | SmartDriveDuo-30, dual channel, **30 A continuous / 80 A peak** per channel, R/C servo-pulse input | [dbw.md §4](dbw.md#4-adr-motor-driver-control-mode-independent-rc-teensy-as-both-masters), part changed in [§4.1](dbw.md#41-part-substitution-cytron-mdds30-replaces-the-sabertooth-2x32-2026-09-29) | Yes | 105 | *Replaced the Sabertooth 2x32 ($125 estimated) on 2026-09-29.* **₩143,440 incl. VAT actually paid**, four units — [order log #3](../order-log.md#L3). **Do not substitute a bare H-bridge** — see the note below |
| 4 | **Steering gearmotor — spare of the STOCK part** | *Re-scoped 2026-10-20.* The vehicle arrives with a stock steering gearmotor; this line is now a **spare of that part**, not a different motor | [dbw.md §2.2.2](dbw.md#222-if-the-duty-test-fails-the-ladder-cheapest-first) | Contingent | 7 | **Buying a different gearmotor was never executable** — the stock gearbox is sealed and the wiper fallback is [withdrawn](dbw.md#24-wiper-motor-fallback). If the duty test fails, R1/R2 (firmware) come first |
| 5 | **Absolute steering angle sensor** | AS5600 breakout + diametric magnet; pot as fallback | [dbw.md §6](dbw.md#6-adr-angle-sensor-technology-magnetic-encoder-vs-potentiometer) | New | 20 | **Budget for either** — technology decided by the bench travel measurement |
| 6 | **Drive encoder + adapter + bracket** | **Quadrature A/B, 3.3 V logic** encoder · shaft adapter · **mounting bracket** · fasteners | [dbw.md §8](dbw.md#8-adr-c-drive-distance-encoding) | Yes | 18 | mrover shaft-adapter method. **Verify PPR on the part fitted** (F7). The Teensy is **not 5 V tolerant**, and the bracket was previously missing from this BOM — see [§1.2.3](../build/01-bom-sourcing.md#6-drive-encoder-what-to-actually-buy) |
| 7 | **Relay MUX hardware** | 2× DPDT automotive relays/contactors + sockets + flyback diodes + drive transistors | [safety.md §1.1](safety.md#11-relay-mux-stock-vs-dbw-selection) | New | 25 | Default de-energized = STOCK |
| 8 | **E-stop switch** | Latching mushroom, traction-rated | [safety.md §3](safety.md#3-e-stop-semantics) | New | 15 | Cuts traction power only |
| 9 | **Hardware RC signal MUX** | **Pololu 4-Channel RC Servo Multiplexer #2806** | [dbw.md §11.2](dbw.md#112-hardware-rc-signal-mux-the-d3-condition) | New | 18 | **Required — the condition of D3's adoption.** $17.95, 4 ch (2 used), `FAILMODE` jumper sets loss-of-select behaviour |
| 10 | **RC transmitter + receiver** | 6-ch 2.4 GHz with a **serial channel stream** — **i-BUS** (FlySky FS-i6 + FS-iA6B) or SBUS | [safety.md §1.2](safety.md#12-live-override-inside-dbw-mode-two-layers) | New | 55 | Was $120 for a PX4-bindable FrSky set. **Not SBUS specifically** — see the note below |
| 11 | **Isolated logic rail** | **LiFePO₄ 12.8 V 6 Ah** (`SLB1206`) + `SLC 1202` 14.6 V 2 A charger + 2× UBEC *(specified as 12 V 7 Ah SLA; LiFePO₄ bought instead — [order log #11a](../order-log.md))* | [safety.md §5](safety.md#5-power-rail-isolation-and-brownout-protection) | New | 45 | Replaces the PM02's isolation role. **Not a retrofit** — the Teensy holds the whole safety supervisor |
| 12 | **Wiring / connectors / fuses** | Silicone wire, spade/XT60, inline fuses, terminals, heatshrink | [safety.md](safety.md) | Partial | 40 | |
| 13 | **Steering shaft coupler / adapter** | Column coupler, set screws, bracket, magnet mount | [dbw.md](dbw.md) · [calibration.md](calibration.md) | New | 15 | Couples gearmotor + angle sensor. Magnet mount needs concentricity — see [dbw.md §6](dbw.md#6-adr-angle-sensor-technology-magnetic-encoder-vs-potentiometer) |
| 14 | **Mounts / 3D prints** | Sensor mast + camera/LiDAR mounts + enclosures | [sensors.md §5](sensors.md) | Partial | 30 | Print filament/hardware; mrover STLs need reworking for the new controller |
| 15 | **USB gamepad (teleop)** | Xbox-layout USB/2.4 GHz pad — Logitech F710 class | [build/07](../build/07-manual-drive.md) · `mitt_control/launch/teleop.launch.py` | New | 40 | **Not the same thing as the RC set (#10)** — see the note below |
| | | | | **Tier 1** | **$658** | |

> [!WARNING]
> **The gamepad (#15) and the RC transmitter (#10) are different parts, doing different jobs**
>
> Easy to conflate when ordering, and expensive to get wrong.
>
> **#15, the USB gamepad**, is a *software* input. It plugs into the laptop, `joy_node`
> reads it, and its Twist goes through `twist_mux` like any other software command source.
> It is how a person drives the twin and drives the vehicle under `ros2` — and it is
> **inside** the software path, so a firmware or laptop hang takes it with them.
>
> **#10, the RC transmitter**, is the *hardware* override. Its receiver feeds the
> [hardware RC signal MUX (#9)](safety.md#12-live-override-inside-dbw-mode-two-layers),
> which switches servo pulses to the motor driver **with no software in the path at all**.
> That is the whole point: it still works when the Teensy is hung.
>
> Buying only the gamepad leaves the vehicle with no firmware-independent override, which
> is the condition D3 was adopted under. Buy both.
>
> **Get an Xbox-layout pad.** `teleop.launch.py` pins deadman = button 4 (LB),
> turbo = button 5 (RB), throttle = axis 1, steering = axis 3. A different layout is not a
> blocker — the numbers are launch arguments — but you will spend an evening with
> `ros2 topic echo /joy` working out which is which.

> [!NOTE]
> **Vehicle class changed — ADR D reversed 2026-08-08**
>
> This line was a **24 V two-seater at $300**. The project moved to a **12 V single-seater
> at ~$165** ([ADR D-R](vehicle.md#adr-d-r-reversal-to-the-12-v-single-seater-2026-08-08)),
> saving ~$135 and giving a smaller, easier-to-store vehicle.
>
> What it costs is **not** in this table, which is the point of flagging it here: the mast
> comes down to ~0.65 m, the seat must be replaced with an equipment plate, and finding F1
> (B-MROVER validated on the 24 V two-seater class) no longer transfers.
>
> The driver below is still comfortably oversized for this drivetrain. **Keep it anyway** —
> its R/C signal-loss timeout is load-bearing in the failsafe matrix, and headroom is not a
> defect. *Note one word that changed with the part: the Sabertooth's **settable current
> limit** was also called load-bearing here, and the MDDS30 has no such setting — only
> unnumbered protection and thermal derating ([§4.1](dbw.md#41-part-substitution-cytron-mdds30-replaces-the-sabertooth-2x32-2026-09-29)). The timeout survives the swap;
> the current limit did not.*

> [!NOTE]
> **The RC link is i-BUS, not SBUS — corrected 2026-09-15**
>
> This line said **RC serial (i-BUS)** from the PX4 era, when the receiver had to bind to a Pixhawk. That
> requirement died with [D3](adr-dbw-architecture-review.md#46-decision-adopted-2026-08-07), but the
> word stayed, and it named a protocol the chosen part does not speak.
>
> The **FlySky FS-iA6B outputs PWM, PPM and i-BUS** — never SBUS. They are both serial RC streams
> and they are **not interchangeable**: SBUS is 100000 baud 8E2 *inverted*, i-BUS is 115200 8N1
> non-inverted.
>
> Sourcing it forced the question, and the answer favours i-BUS. The Teensy needs **no inverter**
> for it, and the [hardware signal MUX](dbw.md#112-hardware-rc-signal-mux-the-d3-condition) is
> unaffected either way — it multiplexes *servo pulses*, which the FS-iA6B also provides on its six
> PWM channels.
>
> **What the design actually requires** is a serial channel stream the Teensy can decode, plus a
> spare channel to drive the MUX. Either protocol satisfies it. The docs now say so.

> [!WARNING]
> **Do not substitute a cheap H-bridge for the MDDS30**
>
> A BTS7960-class module is ~$14 and looks like a $110 saving. It is the wrong part, and
> notably **not primarily because of current rating** — the drive-motor stall current is
> still [unmeasured](vehicle.md#31-drive-motor-stall-current-vs-the-drivers-rating-critical).
> Three reasons that hold regardless of how that measurement lands:
>
> 1. **Wrong input type, which is disqualifying on its own.** It takes PWM + DIR logic. The
>    [hardware RC signal MUX](dbw.md#112-hardware-rc-signal-mux-the-d3-condition)
>    multiplexes *servo pulses*, so a driver that cannot accept pulses cannot sit downstream
>    of it — and that MUX is the condition D3 was adopted under.
> 2. **No signal-loss timeout.** [Failsafe rows 6 and 8](safety.md#2-failsafe-matrix) and
>    [FMEA row 9](safety.md#7-fmea-lightweight) require traction to stop when the Teensy
>    stops emitting, with no software involved. The MDDS30 does this — `SW6=0`, stop after
>    **100 ms** — and a bare bridge does not. *`SW6=1` disables it, so it is a switch to set
>    rather than a property to assume.*
> 3. **No meaningful current limiting or thermal protection**, and its characteristic
>    failure is a shorted MOSFET — which on a vehicle means **uncontrolled full throttle**.
>    *The MDDS30's limiting is unnumbered and not user-settable, which is weaker than this
>    comparison once implied — but it has protection and a published thermal derating curve,
>    and the BTS7960 module has neither ([§4.1](dbw.md#41-part-substitution-cytron-mdds30-replaces-the-sabertooth-2x32-2026-09-29)).*
>
> Keep the MDDS30.

## Tier 2 — Perception

| # | Item | Spec / Model | Design ref | Reuse? | Est. ($) | Source / note |
|---|---|---|---|---|---:|---|
| 16 | **2D LiDAR** | RPLIDAR A1M8 (360°, 12 m) | [sensors.md §2](sensors.md) | No | 110 | Sufficient for indoor hallway SLAM. `ros-humble-rplidar-ros` is in apt. Upgrade path: RPLidar S3 / YDLidar G4 |
| 17 | **Front camera** | **UVC** USB, **MJPEG ≥30 fps @ 1280×720**, fixed focus, 70–120° H-FOV | [sensors.md §1](sensors.md) | No | 30 | **See the behavior-cloning note below** |
| 18 | **IMU** | BNO085-class 9-DoF with onboard fusion | [sensors.md §3](sensors.md) | New | 28 | Replaces the Pixhawk's internal IMU. Estimator is unchanged — it was always `robot_localization` (F11) |
| | | | | **Tier 2** | **$168** | |

> [!NOTE]
> **The global-shutter camera is deferred, not deleted**
>
> The previous BOM specified an **Arducam AR0234 global-shutter USB3 camera ($180)**,
> chosen deliberately because rolling-shutter distortion during motion degrades
> behavior-cloning training data. Behavior cloning is **phase 2**
> ([software.md §8](software.md#8-semester-1-scope-and-software-acceptance-gates)), so
> semester 1 uses a $30 rolling-shutter camera and the global-shutter part is a **phase-2
> repurchase, budgeted at +$150.** Do not train a behavior-cloning policy on rolling-shutter
> data and attribute the result to the platform.

---

## Totals

> [!NOTE]
> **Totals corrected 2026-11-09 — #3 is a different, cheaper board**
>
> The Sabertooth 2x32 was **never fitted**. A **Cytron MDDS30** was bought instead on
> 2026-09-29 at **₩143,440 incl. VAT**, which is **$105** at this document's stated rate of
> 1 USD = 1,362 KRW, against the Sabertooth's **$125** estimate. Every figure below is
> **$20 lower** than it was: Tier 1 $678 → **$658**, both tiers $846 → **$826**.
>
> *These remain pre-purchase estimates in USD.* Purchasing is complete and the authoritative
> money document is the [purchase request](../purchase-request-2026-fall.md), in KRW, reconciled
> against the [order log](../order-log.md) by `check_docs.sh`. Where the two disagree, the
> order log is what was spent.

| | Sum of line items | Contingency (~10%) | **Estimated total** |
|---|---:|---:|---:|
| **Tier 1 + Tier 2** | **$826** | ~$83 | **~$910** |
| *Tier 1 alone (weeks 1–9)* | *$658* | *~$66* | *~$725* |

> [!CAUTION]
> **Totals corrected 2026-08-10 — the previous figures were arithmetically stale**
>
> Tier 1 was published as **$773** while its line items summed to **$638**. The gap was
> exactly **$135**: the vehicle line had been updated from $300 to $165 when
> [ADR D was reversed](vehicle.md#adr-d-r-reversal-to-the-12-v-single-seater-2026-08-08),
> and the total was never re-added. Adding the gamepad (#15, $40) brings Tier 1 to **$678**.
>
> Worth stating plainly because this document is used to place orders: the old totals
> over-budgeted by ~$95, which is a harmless direction to be wrong in, but it means any
> quote reconciled against the old number will not balance.

Contingency covers shipping, taxes, connector/fastener miscellany, a blown H-bridge or
stripped steering gear, and the verification-driven risk that the **drive-motor stall
current** ([vehicle.md §3.1](vehicle.md)) forces a current-limit accessory.

---

## Change record — why the total fell from ~$1,570 to ~$1,035

| Change | Δ | Driver |
|---|---:|---|
| Pixhawk 6C + PM02 removed | −$220 | [D3](adr-dbw-architecture-review.md#46-decision-adopted-2026-08-07) |
| Arduino Nano + USB-TTL adapter removed | −$26 | D3 |
| Teensy 4.1 added | +$32 | D3 |
| IMU added (was inside the Pixhawk) | +$28 | D3 |
| **Hardware RC signal MUX added** | +$18 | D3's safety condition — [safety.md §1.2](safety.md#12-live-override-inside-dbw-mode-two-layers) |
| **Isolated logic rail added** (was the PM02's job) | +$45 | D3 — [safety.md §5](safety.md#5-power-rail-isolation-and-brownout-protection) |
| **D3 subtotal** | **−$123** | |
| RC set: PX4-bindable FrSky → FlySky FS-i6 + FS-iA6B | −$65 | No PX4 to bind to; requirement is now a serial channel stream + a MUX channel |
| LiDAR: YDLidar G4 → RPLIDAR A1M8 | −$150 | Semester-1 scope is indoor hallway SLAM |
| Camera: AR0234 global shutter → USB 1080p | −$150 | Behavior cloning deferred to phase 2 |
| GNSS excluded | $0 | Already excluded from the minimum tier |
| **Sensor re-scoping subtotal** | **−$365** | |
| **Total** | **−$488** | $1,429 → $941 before contingency |

> [!NOTE]
> **These figures are the 2026-08-07 revision, not the current total**
>
> The $941 below is Tier 1 + Tier 2 *as published on 2026-08-07*. Two things happened after:
> the vehicle line fell $300 → $165 with the
> [ADR D reversal](vehicle.md#adr-d-r-reversal-to-the-12-v-single-seater-2026-08-08), and a
> USB gamepad (#15, $40) was added. Current line-item total is **$846**; see §Totals. The
> heading and figures here are left intact so the D3 accounting still reads as a single
> coherent comparison.

**Honest attribution:** D3 itself accounts for **−$123**, not the bulk of the saving. Most of
the reduction comes from scoping the sensor package to what semester 1 actually needs. Both
are real, but they are different kinds of decision — one is architectural and permanent, the
other is a deferral with a known phase-2 cost (+$150 camera, +$200–350 GNSS/RTK,
+$150–200 LiDAR upgrade).

**Vehicle voltage — SUPERSEDED, and left here rather than deleted.** This revision argued the
vehicle should stay **24 V**: a 12 V single-seater saved ~$100–150 but was rejected on payload
and torque margin, and 24 V was the chassis class B-MROVER is validated on (finding F1).

**The next day that decision was reversed.** The project is now a **12 V single-seater** at
~$165 ([ADR D-R](vehicle.md#adr-d-r-reversal-to-the-12-v-single-seater-2026-08-08)), and the
Tier 1 table reflects that. The reversal is a genuine trade, not a free win — it costs the
mast height, the flat deck, and finding F1 — but it was taken deliberately.

The paragraph above is preserved because the reasoning that lost is worth reading next to the
decision that replaced it. **Do not order a 24 V two-seater from it.**

---

## Levers if the budget must go lower

| Lever | Saving | Cost |
|---|---:|---|
| Buy the vehicle used (marketplace) | −$100 to −$150 | Condition risk; inspect steering column before buying |
| Lab already has an mrover rig — reuse the motor driver (#3), drive encoder (#6), 3D prints (#14) | −$153 | None, if the parts exist. **Spent for #3**: three MDDS30s were bought on 2026-09-29 |
| 3D-print couplers and mounts instead of buying | −$30 | Print time |
| Defer Tier 2 entirely to next semester | −$168 | **Loses the SLAM map deliverable** — the semester's visible outcome |

**Realistic floor** with a used vehicle, a lab-reused driver and encoder, and printed
mounts: **~$600 all-in.** *This section is pre-purchase planning and is kept for anyone
replicating the build; MRider's own purchasing is complete — see the [order log](../order-log.md).*

---

## Reuse notes (lab already has an mrover build)

Typically already owned and subtractable: a **dual-channel R/C motor driver** (#3 — an
mrover rig has a Sabertooth 2x32, which also accepts servo pulses and would serve), **drive
encoder + shaft adapter** (#6), **3D-printed enclosures** (#14, `config/3D_design/v3/` —
though the Pixhawk and motor-driver cases need rework for the new controller, and the MDDS30's
102 × 97 × 42 mm footprint is not the Sabertooth's), and the laptop.

**No longer reusable under D3:** the Pixhawk 6C, PM02, Arduino Nano, and USB-TTL adapter from
an existing mrover rig are not used by MRider. If the lab has them, they remain useful for
other projects — this is a deliberate architectural departure, not a write-off of working
hardware.

**New to MRider** (not in the mrover BOM): the Teensy (#2), absolute angle sensor (#5), relay
MUX (#7), E-stop (#8), **hardware RC signal MUX (#9)**, RC set (#10), isolated logic rail
(#11), and IMU (#17). These implement the [DBW angle servo](dbw.md), the
[layered authority arbitration](safety.md), and the power isolation that distinguish MRider
from the base mrover recipe.

---

## Phase-2 growth path

Not in the totals; documented future upgrades.

| Item | Spec | Est. ($) | Enables |
|---|---|---:|---|
| Global-shutter camera | Arducam AR0234 USB3 class | 180 | Behavior cloning without rolling-shutter artifacts |
| RTK GNSS rover | u-blox ZED-F9P class | 220–300 | Outdoor waypoint following |
| RTK corrections | NTRIP subscription or local base | varies | — |
| LiDAR upgrade | RPLidar S3 (ToF, IP65) or YDLidar G4 | 150–200 | Outdoor / longer range |
| Drivetrain tuning, spare gearbox | — | 50 | Bring-up damage margin |

Without PX4, RTK integrates as an F9P + laptop NTRIP client feeding `navsat_transform`
directly — arguably simpler than MAVLink RTK injection.
