jrkwon/mrider/harness/traction-supply.bom.tsv

Id | Description | Qty | Unit | Designators
1 | Cable, 1 x 14 AWG | 2.2 | m | W_F, W_G, W_IN, W_K, W_NEG, W_X
2 | Cable, 2 x 14 AWG | 0.8 | m | W_DRV, W_ECU
3 | Connector, .250 blade MALE tab, uninsulated, 16-14 AWG, 2 pins | 1 |  | J_PACK
4 | Connector, .250 blade RECEPTACLE, uninsulated, 16-14 AWG, 2 pins | 1 |  | J_ECU
5 | Connector, Barrier block, JOTB 30-4P, 30 A, M4, 2 pins | 1 |  | TEE
6 | Connector, Blade fuse, ATO, 25 A, 2 pins | 1 |  | F1
7 | Connector, E-stop contactor, NO, 12 V coil, 2 pins | 1 |  | K0
8 | Connector, XT60, bare pair, 2 pins | 1 |  | XT60
