jrkwon/mrider/harness/authority-taps.bom.tsv

Id | Description | Qty | Unit | Designators
1 | Cable, 2 x 16 AWG | 1.2 | m | W_D_IN, W_D_OUT
2 | Cable, 2 x 20 AWG | 1.2 | m | W_S_IN, W_S_OUT
3 | Connector, .250 blade MALE tab, uninsulated, 16-14 AWG, 2 pins | 1 |  | D_OUT
4 | Connector, .250 blade RECEPTACLE, uninsulated, 16-14 AWG, 2 pins | 1 |  | D_IN
5 | Connector, Micro-Fit 43640-0200, + 43031-0001 male terminals, 2 pins | 1 |  | S_OUT
6 | Connector, Micro-Fit 43645-0200, + 43030-0001 female terminals, 2 pins | 1 |  | S_IN
