jrkwon/mrider/docs/purchase-request-2026-fall-ko.md

# 구매 요청서 — MRider 플랫폼 (2026년 2학기)

**요청자:** Jaerock Kwon (BIMI Lab) · **교과목:** 자율주행미들웨어응용 · **작성일:** 2026-09-21
· **예산 한도:** ₩4,000,000

> 영문본: [Purchase Request (English)](purchase-request-2026-fall.md)

---

## 요약

| | |
|---|---|
| **요청 수량** | **완성 세트 3식** |
| **요청 금액** | **₩3,921,480** |
| **예산 대비** | 98.0% — **잔액 ₩78,520** |
| **4세트 검토 결과** | **₩5,228,640 — 한도를 ₩1,228,640 초과. 요청하지 않음** |

1세트는 자율주행 연구 차량 1대입니다. 12V 전동차 섀시를 컴퓨터 제어가 가능하도록 개조하고,
자율주행에 필요한 센서를 장착합니다. 수강생은 4개 서브시스템 팀으로 나뉘어 작업한 뒤 학기
후반에 차량 위에서 통합합니다.

> [!IMPORTANT]
> **4세트가 아닌 3세트인 이유**
>
> 4세트는 예산에 들어오지 않으며, 근소한 차이도 아닙니다. **인지 센서(라이다·카메라·IMU)를
> 전부 제외하더라도** 4세트는 **₩4,275,720** 으로 여전히 한도를 ₩275,720 초과합니다.
>
> 즉 4번째 세트는 품목을 줄여서 도달할 수 있는 것이 아니라, 약 130만 원의 추가 예산이
> 필요합니다. 3세트는 잔액 ₩78,520 으로 구성 가능합니다.

---

## 세트당 소요 품목

금액은 **원화, 부가세 포함**이며 **2026-09-21** 기준 판매처 게시 가격입니다.
**근거** 열은 각 가격의 확인 수준을 나타냅니다.

| | |
|---|---|
| **V** | 확인 완료 — 판매처 상품 페이지에서 직접 확인 |
| **L** | 후보 — 판매처는 확인, 가격은 가격비교 사이트 기준으로 미확정 |
| **E** | 추정 — 설계 BOM의 달러 금액을 1 USD = 1,362 KRW 로 환산 |

### 1차 — 차량 및 제어(Drive-by-Wire) 핵심

| # | 품목 | 용도 | 구매처 / 웹주소 | 단가 (₩) | 근거 |
|---|---|---|---|---:|:----:|
| 1 | 차량 (12V 1인승 전동차) | 플랫폼 본체. 리모컨 완구를 컴퓨터 제어 연구 차량으로 개조 | 쿠팡<br>`https://www.coupang.com/vp/products/9597329401` | 229,000 | V |
| 2 | Teensy 4.1 마이크로컨트롤러 | 실시간 제어기. 조향 위치 루프를 200Hz 이상으로 폐루프 제어하고, 구동 출력을 성형하며, 엔코더를 읽고 안전 감시 로직을 수행 | 디바이스마트<br>`https://www.devicemart.co.kr/goods/view?no=14276922` | 74,250 | V |
| 3 | Sabertooth 2x32 모터 드라이버 | **2채널 드라이버. M1은 조향 감속모터, M2는 병렬 연결된 후륜 구동 모터 2개를 구동.** 한 보드로 차량 전체를 구동. 신호 상실 시 자동 정지와 전류 제한 기능이 안전 설계상 필수이므로 대체 불가 | 원스톱<br>`https://one-stop.co.kr/goods/view?no=11156` | 250,000 | V |
| 4 | 조향 감속모터 + 엔코더 | 조향 컬럼을 구동. Sabertooth **M1** 채널이 이 모터를 구동. 입고된 차량에서 측정한 토크를 기준으로 규격 결정 — 2차 발주 품목 | 디바이스마트 (2차 발주)<br>`https://www.devicemart.co.kr` | 48,000 | E |
| 5 | 절대 조향각 센서 | 실제 바퀴 조향각을 측정. 기어 백래시가 숨은 오차가 아니라 측정된 오차로 드러나게 함 | 디바이스마트 (2차 발주)<br>`https://www.devicemart.co.kr` | 27,000 | E |
| 6 | 구동 엔코더 + 샤프트 어댑터 | 후축 주행 거리 측정. 주행거리 추정(odometry)의 입력 | 디바이스마트<br>`https://www.devicemart.co.kr` | 25,000 | E |
| 7 | 릴레이 MUX 부품 (DPDT 2개 + 소켓, 다이오드, 트랜지스터) | 순정 리모컨 제어와 컴퓨터 제어를 하드웨어로 전환. 전원이 없으면 순정 제어로 복귀 | 디바이스마트<br>`https://www.devicemart.co.kr` | 34,000 | E |
| 8 | 비상정지 스위치 + DC 컨택터 | 구동 전원 비상 차단. 컨택터가 모터 전류를 담당하고, 버튼은 코일 전류만 개폐 | 한국미스미<br>`https://kr.misumi-ec.com` | 35,000 | E |
| 9 | Pololu 4채널 RC 서보 멀티플렉서 #2806 | 제어 소프트웨어가 완전히 정지해도 동작하는 하드웨어 조작권 전환. 아키텍처 검토에서 필수 조건으로 채택 | 디바이스마트<br>`https://www.devicemart.co.kr/goods/view?no=1179242` | 31,680 | V |
| 10 | RC 조종기 + 수신기 (FlySky FS-i6 + FS-iA6B) | 모든 시험 중 안전 담당자의 실시간 수동 개입 수단 | 팰콘샵<br>`https://www.falconshop.co.kr/shop/goods/goods_view.php?goodsno=100004832` | 75,000 | E |
| 11 | 절연 로직 전원 (12V 7Ah 배터리 + 충전기 + DC-DC 2개) | 제어기 전원과 모터 전원을 분리. 모터 돌입 전류로 안전 제어기가 리셋되지 않도록 함 | 11번가 / 디바이스마트<br>`https://www.11st.co.kr/products/1334182072` | 60,000 | E |
| 12 | 배선, 커넥터, 퓨즈 | 실리콘 전선, XT60/단자, 인라인 퓨즈, 수축튜브 | 디바이스마트<br>`https://www.devicemart.co.kr` | 55,000 | E |
| 13 | 조향축 커플러 / 어댑터 | 감속모터와 각도 센서를 조향 컬럼에 결합. 실측 컬럼 직경에 따라 결정 — 2차 발주 품목 | 로컬 가공 (2차 발주) | 20,000 | E |
| 14 | 마운트 / 3D 프린팅 재료 | 센서 마스트, 라이다·카메라 마운트, 제어기 하우징 | 로컬 | 41,000 | E |
| 15 | USB 게임패드 (로지텍 F710급) | 학생용 노트북 원격 조종. 10번(안전 개입용)과는 별개 품목 | 다나와 / 컴퓨존<br>`https://prod.danawa.com/info/?pcode=1880276` | 64,000 | L |
| | | | **1차 소계** | **1,068,930** | |

### 2차 — 인지 센서

| # | 품목 | 용도 | 구매처 / 웹주소 | 단가 (₩) | 근거 |
|---|---|---|---|---:|:----:|
| 16 | 2D 라이다, RPLIDAR A1M8-R6 | 360° 거리 측정. 지도 작성과 장애물 회피에 사용되는 주 항법 센서 | 아이씨뱅큐<br>`https://www.icbanq.com/P013130745` | 155,430 | V |
| 17 | USB 카메라, 1080p 광각 | 전방 영상. 원격 조종 및 추후 학습 기반 제어에 사용 | 디바이스마트<br>`https://www.devicemart.co.kr` | 41,000 | E |
| 18 | 관성측정장치(IMU), BNO085 9축 | 자세 측정. 휠 주행거리와 융합하여 누적 오차를 보정 | 아이씨뱅큐<br>`https://www.icbanq.com/P013465652` | 41,800 | L |
| | | | **2차 소계** | **238,230** | |

### 합계

| | 세트당 | 3세트 |
|---|---:|---:|
| 1차 — 차량 및 제어 | 1,068,930 | 3,206,790 |
| 2차 — 인지 센서 | 238,230 | 714,690 |
| **합계** | **1,307,160** | **₩3,921,480** |
| | | *잔액 ₩78,520* |

---

## 검토 참고 사항
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
