jrkwon/mrider/ros2_ws/src/mitt_description/meshes/mitt_body.obj

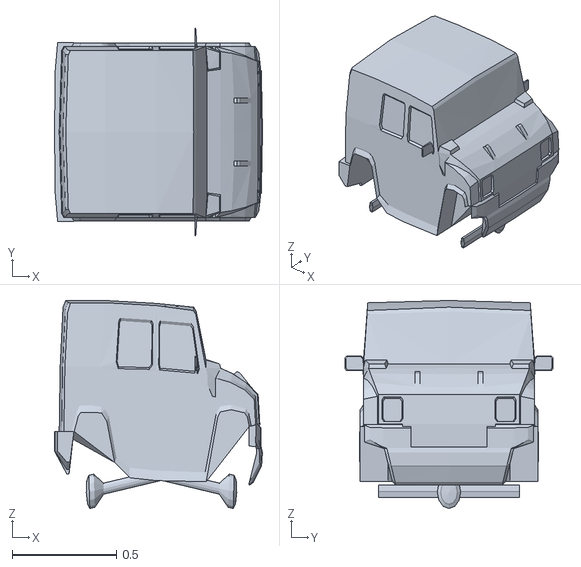
[picture p16: CAD file, 2026-08-09]
ros2_ws/src/mitt_description/meshes/mitt_body.obj
1.00 x 1.00 x 1.00
