jrkwon/mrider/cad/drive_encoder_carrier.scad

// MRider — drive encoder magnet carrier
// =====================================
// A one-piece ring that slides onto the gearbox output hub and presents a plain
// cylinder carrying the encoder magnets. Three recessed grub screws hold it.
//
// THE RULE THIS FILE EXISTS TO OBEY
//   The Hall sensors ride 1-3 mm off the ring's outer surface, so every feature
//   below is a SUBTRACTION from that cylinder. Anything ADDED outside it is
//   swept through the sensor and its bracket once per revolution. An earlier
//   two-piece revision put the clamp screws in ears standing 9 mm proud of the
//   track: they swept Ø91 against a sensor face at Ø78, and would have taken the
//   sensor off on the first turn of the wheel.
//
// WHY ONE PIECE
//   The wheel comes off, so the ring can simply be slid on. A split ring has to
//   put its fastener somewhere, and on a wall this thin there is nowhere that is
//   both reachable by a hex key and inside the sensing cylinder.
//
// WHY THE BORE IS CLEAR AND NOT A PRESS FIT
//   The hub measures 63-64 mm and FDM holds a Ø65 bore to perhaps +-0.3 mm. A
//   press fit needs both numbers to +-0.1, so it is two significant figures out
//   of reach — and there are three hubs, not one. The bore is therefore
//   deliberately LOOSE and carries no load. The three grub screws take up
//   whatever slack exists and their points SEAT ON THE LOBE CRESTS, which is
//   the seat SET_SCREW_L was derived for.
//
//   This block used to say the points settle into the GAPS between the lobes.
//   They cannot: HUB_D is measured across crests, so every span derived from
//   it reaches a crest, and a valley sits deeper by a lobe depth nobody has
//   measured. The sentence survived here for two weeks after SET_SCREW_L was
//   corrected, which is how one file ends up arguing with itself. A hub 0.5 mm off nominal changes nothing
//   except how far the screws go in, so one print fits all three vehicles.
//
//   Nothing here needs a hard grip either: the carrier transmits no torque.
//   It is NOT captured axially, though — an earlier revision said the slot
//   between the gearbox face and the wheel held it, and the 2026-10-08 side
//   view shows the lobed boss standing about 10 mm clear of the housing with a
//   6 mm ring on it. The screws hold it, and its axial POSITION is a choice
//   made at assembly. Make the same choice on all three vehicles — see
//   ASSEMBLY below — or the sensor bracket has three different reaches.
//
//   Build:       openscad -o carrier.stl drive_encoder_carrier.scad
//   Bore check:  set PART = "gauge"  — print this FIRST, see FITTING below
//
// Spec: docs/build/01-bom-sourcing.md  §1.2.3
// Figure: docs/images/drive-encoder-carrier.svg

/* [What to build] */
// "ring" = the carrier, ready to slice · "gauge" = thin bore-check ring
PART = "ring";              // [ring, gauge]
// Bore adjustment for the gauge ring only, mm. Print at -0.4, 0 and +0.4.
GAUGE_DELTA  = 0.0;

/* [Measured on the vehicle] */
// Crest diameter of the gearbox output hub, mm.
//
// MEASURED WITH A CALIPER, 2026-11-04: across two opposite lobe crests, with
// the GEARBOX OUT OF THE VEHICLE and the hub unobstructed. 62.82.
// A caliper read 62.7 on 2026-10-15 with the gearbox in place, and that
// superseded a 63.0 taken with a tape on 2026-10-08 — same method, finer
// instrument each time. Six lobes is an EVEN count — re-confirmed straight-on
// on the 2026-11-04 photograph, after an angled shot had made it look like
// ten. That mattered: an ODD count makes crest face valley and this whole
// measurement method invalid. So
// opposite crests face each other and a straight measurement reads the crest
// circle. Do this. Do not wrap.
//
// A wire round the crests had read 205 mm, and two corrections were argued over
// that number before anyone measured across it. Both were wrong:
//
//   * 205/pi = 65.25 ignores that THE WIRE HAS THICKNESS. Its centreline sits
//     half a wire-diameter off the surface, so what you measure is
//     pi*(D + d_wire), not pi*D. A 2 mm wire gives 65.25 - 2.0 = 63.25 against
//     the 63.0 measured across. That is the entire discrepancy.
//   * a polygon "chord" correction was then argued on top of it, pushing the
//     figure to 66.0 — in the WRONG DIRECTION, and for a crest form this hub
//     does not have.
//
// Net: HUB_D was carried 2.3 mm too large, the bore came out 4 mm oversize, and
// a 20 g ring was printed that could not be clamped. If a wrap is ever the only
// option, SUBTRACT THE WIRE OR STRIP THICKNESS.
//
// THREE MEASUREMENTS NOW DISAGREE, and the spread is about a millimetre:
//
//     wire wrap 205 mm, less 2 mm wire ....... 63.25
//     tape ACROSS opposite crests, x3 ........ 63.00
//     thin paper wrap 195 mm, less 0.1 ....... 61.97
//
// The wraps are the suspect ones, and they err in opposite directions: thickness
// pushes a wrap HIGH, chording across the six gaps pushes it LOW. Paper takes
// the shortest path between contact points however carefully it is held, and
// gaps of 35-40 degrees would account for the whole discrepancy on their own.
// The tape across two opposite crests has NO chord term at all, which is the
// reason to prefer it.
//
// This stays at 63.0 anyway, and not because the argument above is decisive.
// Erring high is the safe direction: a bore that comes out under the hub does
// not go on at all, while a bore over it only means the screws travel further.
// And the Ø64.2 bore has already been printed and fitted, which outranks all
// three numbers. Across the whole 62.0-63.6 band the screws close the gap with
// at least 3x margin, so the millimetre does not reach the part.
HUB_D        = 62.82;
// How uncertain that measurement is, mm. A tape resolves about half a
// millimetre and reads SHORT if it misses the centre, plus the spread across
// three vehicles.
//
// A caliper read 62.7 at three positions on the drive hub, 2026-10-15. This was
// 0.2 for a few hours on the strength of that one hub — until the STEERING
// gearbox on the same vehicle, which turns out to be the same assembly with the
// same six-lobe output, read 62.23. Two hubs, one vehicle, 0.47 mm apart.
//
// So 0.2 was measuring the instrument when the real variation is between PARTS.
// HUB_D stays at the larger figure, because the bore has to clear the largest
// hub it will meet, and the tolerance carries the spread downward.
//
// 2026-11-04: a third reading, 62.82, taken with the gearbox OUT of the vehicle
// and the hub unobstructed — the cleanest access anyone has had to it. It is
// 0.12 ABOVE the HUB_D that was supposed to BE the largest hub, so the rule
// this block states was being broken by its own data. HUB_D takes it, and the
// tolerance goes to 0.6 to keep covering 62.23 at the bottom.
//
//   readings so far:  62.23  ·  62.7  ·  62.82        spread 0.59 mm
//
// CONFIRMED 2026-11-04: 62.82 is the SAME DRIVE HUB as the 62.7, re-measured.
// So these are THREE READINGS OF TWO PARTS, not three parts, and that is the
// worse reading of the data:
//
//   same part, two reads   0.12 mm   <- the instrument and the operator
//   part to part           0.47 mm   <- drive vs steering
//
// HUB_TOL 0.6 is now absorbing BOTH, and the two remaining drive hubs are
// still unmeasured — both of them, not one. A new hub that truly sits at
// 62.23 could read 62.11 on a bad pass, which leaves ~0.09 mm against the
// 62.02 floor rather than the 0.21 the raw numbers suggest.
//
// Nothing reprints. The bore moves 63.90 -> 64.02 and the Ø64.2 ring already
// printed clears both. What it costs is screw margin, and that is now the
// number to watch — see SET_SCREW_L.
//
// The history is worth keeping. This was 1.0 while three indirect methods spread
// 62.0-63.25, then 0.5 once the low one was explained as a paper wrap chording
// the six gaps. Every wrap and every tape read HIGH of the caliper; the direct
// measurement was always the one to take and it took three tries to go and take
// it. The grub-screw assert now depends on this number.
//
// 2026-11-05: the STEERING hub measured again, 62.2. That is 0.03 from the
// 62.23 this file already carries for it, so the instrument repeats to 0.03 on
// a hub it can reach cleanly - and the 0.12 "same part, two reads" above was
// access, not the caliper.
//
//   steering   62.23  62.2      same part, 0.03 apart
//   drive      62.7   62.82     same part, 0.12 apart
//   part to part                0.62 mm   <- 62.2 against 62.82
//
// The gearboxes are the same assembly with the same six-lobe output, so this
// 0.62 is variation WITHIN one part number, which is exactly what HUB_TOL is
// for. And it is the number that moves: HUB_TOL 0.6 against HUB_D 62.82 covers
// down to 62.22, and 62.2 is 0.02 BELOW it. The tolerance was short by the
// width of the reading that found it.
//
// 0.6 -> 0.7, which covers 62.12.
//
// NOTHING REPRINTS, and that is not luck: BORE_D = HUB_D + BORE_CLEAR, so the
// bore does not depend on HUB_TOL at all. What it costs is screw margin.
// SPAN_MAX goes to WALL + (1.2 + 0.7)/2 = 7.95 against SET_SCREW_L 8.0, so the
// grub-screw assert passes with 0.05 mm. The ceiling stays 0.8 - a smallest hub
// of 62.02 - which leaves 0.08 mm of band and TWO UNMEASURED DRIVE HUBS to
// spend it on. Measure them before this number is asked to stretch again.
//
// BORE_CLEAR must stay larger than this or the bore can come out SMALLER than
// the hub, which is the one failure the screws cannot rescue.
HUB_TOL      = 0.7;
// Axial room on the protruding lobed boss, mm. The 2026-10-08 side view reads
// about 10 mm with the wheel off; this keeps the older, smaller "gearbox face
// to wheel" figure because the wheel is what finally closes on it, and the fit
// mule settles which one binds.
AXIAL_GAP    = 8.0;
// Smallest obstruction radius in that 8 mm slice, mm. NEGATIVE = NOT YET
// MEASURED. Set it and the assert below proves the ring and sensor fit.
RADIAL_ROOM  = -1;

/* [Carrier] */
WALL         = 7.0;         // radial wall thickness, mm
WIDTH        = 6.0;         // axial width, mm — leaves 1 mm each side in AXIAL_GAP
BORE_CLEAR   = 1.2;         // bore = HUB_D + this. CLEARANCE, not interference.

/* [Magnets] */
N_MAG        = 18;          // 9 pole pairs -> 36 counts/rev. Must divide by N_SET.
MAG_D        = 5.0;         // disc diameter, mm
MAG_T        = 2.0;         // disc thickness, mm
MAG_CLEAR    = -0.1;        // NEGATIVE = press fit. Magnets must not turn before the adhesive cures.

/* [Grub screws] */
N_SET        = 3;           // three points centre the ring; four can skew it
// The thread is TAPPED STRAIGHT INTO THE PETG. Drill-and-tap M3, which wants a
// 2.5 mm pilot, and the screw then engages the whole 7 mm wall.
//
// Heat-set inserts were the plan and do not fit. The ones bought are M3 x 4 x 5:
// 4 mm long, 5 mm OD, and the maker asks for a 4.5 mm hole. A 4.5 mm hole across
// a 6 mm wide ring leaves 0.75 mm of PETG on each side, and the insert swages
// out to 5.0 as it goes in — it would split the carrier's faces. A 2.5 mm tapped
// hole leaves 1.75 mm. The inserts are not wasted: #14 bought them for the
// enclosures, which is what that line always said they were for.
SET_TAP_D    = 2.5;         // M3 tap drill, through the whole wall
SET_SCREW_L  = 8.0;         // M3 x this, no head — THE SCREWS SEAT ON LOBE CRESTS
//
// HOW MUCH LONGER THIS SCREW CAN COPE WITH, stated as a number so the next
// reading can be checked against it rather than argued about:
//
//   SET_SCREW_L >= WALL + (BORE_CLEAR + HUB_TOL)/2   =>   HUB_TOL <= 0.8
//   with HUB_D 62.82 that is a SMALLEST HUB OF 62.02 mm
//
// The lowest reading so far is 62.23, so there is 0.21 mm of headroom left.
// A hub under 62.02 and the M3 x 8 no longer reaches it — and M3 x 10 is not
// the answer, because #6d already rejected it for standing 1.9-2.7 mm proud of
// the sensing surface. The fix then would be a thicker WALL or a smaller
// BORE_CLEAR, both of which are reprints. MEASURE THE REMAINING HUBS.
//
// CRESTS, NOT VALLEYS — and that is what sets this length.
//
// HUB_D is measured ACROSS OPPOSITE LOBE CRESTS (see "fitting" below), so every
// span figure derived from it is a distance to a CREST. SPAN_MAX = 7.95 is the
// wall plus the largest radial gap AT A CREST. A valley sits deeper by the lobe
// depth, which NOBODY HAS MEASURED, so an M3 x 8 cannot be assumed to reach one
// and must not be asked to.
//
//   seated on a crest   -> screw stands 0.05-0.75 mm PROUD of the OD (= PROUD)
//   winding in past that without going tight -> it is heading down a flank or
//   into a valley. BACK IT OUT, ROTATE THE RING, TRY AGAIN.
//
// The flank is the case that actually bites: a screw part-way down one DOES
// clamp, but at a smaller radius, so three screws sharing the lobe phase push
// the ring OFF CENTRE together. An eccentric ring is a varying air gap, which
// is how a Hall latch starts dropping out over part of a revolution.
//
// Point form: FLAT is acceptable here precisely because the seat is convex. A
// flat face on a crest makes a line contact running axially; a cone would make
// a single point on the apex and want to slide off it. Cup is better still --
// its rim straddles the ridge -- but it is an upgrade, not a prerequisite.

/* [Index mark] */
MARK_W       = 1.6;         // groove width, mm
MARK_DEPTH   = 0.8;         // groove depth into one face, mm

/* [Sensors — for the clearance assert only] */
SENSOR_GAP   = 3.0;         // largest air gap the bracket will be set to, mm
SENSOR_T     = 4.0;         // sensor + PCB radial thickness, mm

/* [Hidden] */
$fn = 160;
EPS = 0.01;

// ---- derived -------------------------------------------------------------
BORE_D   = HUB_D + BORE_CLEAR;
OD       = BORE_D + 2 * WALL;
CIRC     = PI * OD;
PITCH    = CIRC / N_MAG;             // magnet pitch along the track
OFFSET   = PITCH / 2;                // quadrature offset: HALF a pole pitch,
                                     // because one electrical cycle spans TWO magnets
COUNTS   = 2 * N_MAG;                // with 4x quadrature decoding
SET_A0   = 180 / N_MAG;              // first screw, half a pitch off magnet 0
SLACK    = BORE_CLEAR + HUB_TOL;     // worst-case gap a screw has to close
SPAN_MAX = WALL + (BORE_CLEAR + HUB_TOL)/2;   // wall + the LARGEST radial gap
SPAN_MIN = WALL + (BORE_CLEAR - HUB_TOL)/2;   // wall + the SMALLEST
PROUD    = SET_SCREW_L - SPAN_MIN;            // worst-case stand-off past the OD
NEED_R   = OD/2 + SENSOR_GAP + SENSOR_T;
MARK_R   = OD/2 - MAG_T - 1.0;       // index groove ends 1 mm short of the pocket
                                     // FLOOR, so it cannot reach the track by
                                     // construction — no assert can fail here

echo(str("bore Ø",        BORE_D, " mm  (hub + ", BORE_CLEAR, " CLEARANCE)"));
echo(str("SWEPT Ø",       OD,     " mm  <- nothing stands proud of this"));
echo(str("track circum.", CIRC,   " mm"));
echo(str("magnet pitch",  PITCH,  " mm"));
echo(str("SENSOR OFFSET", OFFSET, " mm  <- space the two Hall sensors by this"));
echo(str("counts / rev",  COUNTS));
echo(str("screw span needed ", SPAN_MIN, " to ", SPAN_MAX, " mm — M3 x ", SET_SCREW_L, " chosen"));
echo(str("WORST-CASE SCREW STAND-OFF ", PROUD, " mm past the OD  <- set the air gap ABOVE this"));
echo(str("bore clears the largest credible hub by ", BORE_CLEAR - HUB_TOL, " mm"));
echo(str("radial room needed ", NEED_R, " mm (ring + sensor)"));

assert(WIDTH < AXIAL_GAP,  "carrier is wider than the room on the boss");
assert(MAG_D < WIDTH,      "magnet will not fit inside the carrier width");
assert(MAG_T < WALL,       "magnet pocket would break through the back of the wall");
assert(PITCH > MAG_D + 2,  "magnets too close — reduce N_MAG or increase WALL");
assert(N_MAG % N_SET == 0, "N_MAG must divide by N_SET, or a screw lands on a magnet");
assert(PITCH/2 > (MAG_D + SET_TAP_D)/2 + 1,
       "screw hole would run into the magnets either side of it");
assert((WIDTH - SET_TAP_D)/2 >= 1.2,
       "not enough PETG beside the screw hole — it would split the carrier's faces");
// A grub screw is as deep as it is long: its tip stops on the hub and whatever
// is left sticks out past the OD. SPAN is what it has to cross, and SPAN moves
// with the hub, so no single length is flush across the whole band.
assert(SET_SCREW_L >= SPAN_MAX, "grub screw too short to touch the smallest credible hub");
assert(PROUD < 1.5, "grub screw would stand too far proud of the sensing surface");
assert(BORE_CLEAR > HUB_TOL,
       "bore can come out smaller than the hub — the ring would not go on at all");
assert(RADIAL_ROOM < 0 || RADIAL_ROOM >= NEED_R,
       "ring plus sensor will not clear the obstruction in the axial slice");
if (RADIAL_ROOM < 0)
    echo("NOTE: RADIAL_ROOM unmeasured — the clearance assert is not proving anything yet");

// ---- parts ---------------------------------------------------------------

// Pockets are cut radially from the outside, so the magnet face finishes flush
// with the track and the air gap is set by the bracket alone.
module magnet_pockets() {
    for (i = [0 : N_MAG - 1])
        rotate([0, 0, i * 360 / N_MAG])
            translate([OD/2 - MAG_T, 0, WIDTH/2])
                rotate([0, 90, 0])
                    cylinder(d = MAG_D + MAG_CLEAR, h = MAG_T + EPS);
}

// Each screw sits half a magnet pitch away from its neighbours, in the dead
// space between two magnets. A Hall LATCH holds its state until the opposite
// pole arrives, so a hole in that dead space is invisible to it.
//
// Insert is driven in from the OUTSIDE; the screw then passes through the pilot
// and lands in a lobe gap. Flush at the surface it reaches REACH mm past
// the bore, which is what makes the fit tolerant.
module set_screw_holes() {
    for (k = [0 : N_SET - 1])
        rotate([0, 0, SET_A0 + k * 360 / N_SET])
            translate([BORE_D/2 - EPS, 0, WIDTH/2]) rotate([0, 90, 0])
                cylinder(d = SET_TAP_D, h = WALL + 2*EPS);
}

// A witness mark at magnet 0, so the pattern has a named starting point.
// Eighteen identical discs give you no way to say WHICH one went in backwards —
// not while placing them, and not when the hand-turn check in §1.2.3 shows one
// long gap and one short pulse.
//
// It was a Ø2 through-hole until the arithmetic was checked: centred at
// OD/2 - 1.0 with a radius of 1.0, it sat exactly TANGENT to the outer surface,
// leaving zero wall at the tangent point — a feather edge on the one surface
// that has to stay clean, pointed straight at the sensor. A groove in the face
// cannot reach the track at all: it stops 1 mm short of the pocket floor.
module index_mark() {
    translate([BORE_D/2 - EPS, -MARK_W/2, WIDTH - MARK_DEPTH])
        cube([MARK_R - BORE_D/2 + EPS, MARK_W, MARK_DEPTH + EPS]);
}

module carrier() {
    difference() {
        cylinder(d = OD, h = WIDTH);
        translate([0, 0, -EPS]) cylinder(d = BORE_D, h = WIDTH + 2*EPS);
        magnet_pockets();
        set_screw_holes();
        index_mark();
    }
}

// A FIT MULE: the carrier's real bore, real outside diameter and real width,
// with none of the features. About 12 g, and it settles three things no drawing
// and no tape measure in a wheel arch can settle:
//
//   1. does the bore go onto the hub          -> is HUB_D right
//   2. does it SPIN without touching anything -> is RADIAL_ROOM >= OD/2
//   3. does it sit in the gap                 -> is WIDTH < AXIAL_GAP
//
// (2) is the one that matters most. Measuring the smallest obstruction radius
// inside a 6 mm slot behind a wheel is awkward and easy to get wrong; turning
// the wheel one revolution with this on the hub is neither.
module gauge() {
    difference() {
        cylinder(d = OD, h = WIDTH);
        translate([0, 0, -EPS]) cylinder(d = BORE_D + GAUGE_DELTA, h = WIDTH + 2*EPS);
    }
}

// ---- output --------------------------------------------------------------
if (PART == "gauge") gauge();
else                 carrier();

// ---- fitting -------------------------------------------------------------
// 1. Measure HUB_D ACROSS TWO OPPOSITE LOBE CRESTS. Six lobes is even, so
//    opposite crests face each other and a caliper — or even a tape — reads the
//    crest circle directly. Three positions round the hub, all three vehicles,
//    enter the LARGEST, and keep BORE_CLEAR above the spread. If you must wrap
//    instead, subtract the wire or strip thickness: getting that wrong once
//    already cost a print.
// 2. Print PART = "gauge" at GAUGE_DELTA = 0. If it will not go on, print
//    +0.4; if it is sloppy enough to sit visibly off centre, print -0.4.
// 3. The right one slides on by hand over the full 6 mm and rattles slightly.
//    It is SUPPOSED to rattle — the screws remove the rattle, not the bore.
//    If even +0.4 will not go on, HUB_D is wrong; re-measure before printing
//    20 g of carrier.
// 4. WITH THE MULE ON THE HUB, REFIT THE WHEEL AND TURN IT A FULL REVOLUTION.
//    Nothing may touch. This is the acceptance test for RADIAL_ROOM, and it is
//    also the last chance to find out that the carrier does not fit before
//    eighteen magnets are glued into one.
// 5. Add the winning delta to BORE_CLEAR, then print the carrier.
//
// ---- printing ------------------------------------------------------------
// PETG. 0.2 mm layers, 4 perimeters, 40 % infill. No supports. One ring per
// plate takes about 20 g.
//
// PRINT IT FLAT, ring axis vertical — straight out of PART = "ring". The only
// load this part ever sees is the three grub screws pushing inward, which is
// hoop tension in the ring, and printed flat that tension lies INSIDE the layer
// planes. On edge it would pull the layers apart and need supports as well.
//
// Lay it with the index groove FACING UP. A 0.8 mm recess in the top surface
// prints clean; on the bed it would come out as a bridge over nothing.
//
// The magnet pockets and the insert seats are horizontal holes in this
// orientation, so each bridges across its top and will come out slightly
// flattened. That suits a press fit, and the heat-set inserts melt their own
// seat regardless — but check the FIRST magnet pocket with a magnet before
// populating all eighteen.
//
// ---- assembly ------------------------------------------------------------
// Check the finished track with magnetic viewing film, or by walking a spare
// magnet round it and feeling the attract/repel alternate. Either shows a
// reversed disc directly; the hand-turn signal check only tells you that one
// exists, and then you count from the index groove to find it.
//
// MAGNETS. Degrease them and the pockets with IPA first — they ship oiled, and
// that is the usual reason a magnet bond fails. Pull them off the shipped stack
// one at a time and dot the face that pointed the same way each time; then fit
// dot-out, dot-in, dot-out, starting dot-out at the index groove. Polarity
// becomes something you can see instead of something you have to test.
//
// Press each fully home, flush with the track, then ONE drop of thin CA at the
// rim and wipe the excess BEFORE it cures — a cured bead proud of the track is
// the exact fault this part is shaped to avoid, and the sensor passes 1-3 mm
// away. No accelerator: it leaves the joint foamy and the residue stands proud.
//
// Nothing has to be clamped while it cures. An earlier revision of this file
// said the alternating pattern pushes each magnet toward the wrong orientation;
// it is the opposite. Side-by-side dipoles prefer to sit ANTIPARALLEL, which is
// what an alternating ring is, so the neighbour field summed at a magnet's seat
// (+2.57 mT) is ALIGNED with it — a correct magnet is held correct. A reversed
// one is being pushed to flip, but at 0.09 mN*m, about 4 gf at the rim, it will
// not climb out of an interference pocket. The hand-turn check in §1.2.3 is
// still what catches it. Run it before the carrier goes near the vehicle.
//
// Then: TAP the three holes M3 (2.5 mm pilot is already in the model) and slide
// the ring on. No inserts here — see the note by SET_TAP_D.
//
// PUSH IT UP AGAINST THE HOUSING END FACE before tightening, and do that on
// every vehicle. The boss is longer than the ring, so the ring does not find
// its own place — where it stops is where you stopped it, and the sensor
// bracket's reach is drawn to one number.
//
// DO NOT DRILL THE HUB to give the screws a dimple. It is the plastic part
// that carries full drive torque to the wheel, the vehicle has to stay
// returnable to factory condition (02-mechanical 2.8), and the load is 0.3 gf —
// a cup point forms its own seat in a few turns. A lobe gap stops rotation but
// not sliding, since it is an axial groove; axial position is held by friction
// and by having pushed the ring home. If one ever creeps, use a drop of
// adhesive, not a hole.
//
// BEFORE TIGHTENING, ROTATE THE RING ONE LOBE. Six lobes sit 60 degrees apart
// and the three screws 120, which is exactly two lobe pitches — so all three
// screws are always in the SAME place on the lobe pattern. Turn the ring until
// they drop into the GAPS: that is a positive form lock on all three at once.
// Land them on the crests instead and all you have is friction.
//
// Then run the grub screws down in rotation — a turn each, round and round,
// so the ring centres itself rather than being shoved against the hub. Blue
// threadlocker on the screws. Finally spin the wheel by hand and watch the air
// gap: it should not visibly change through a revolution.
//
// FASTENERS, per vehicle: 3 x M3 x 8 grub screw. FLAT POINT IS ACCEPTABLE and
// is what is in hand — the seat is a convex CREST, where a flat face makes a
// line contact and a cone would perch on the apex and slide off. (An earlier
// revision of this block asked for cup or cone 'because a cone finds a lobe
// gap on its own'. It is not looking for a gap. Third copy of that sentence
// in this file; see SET_SCREW_L for the one that was corrected first.)
// NOT M3 x 10: the screw has to cross the 7 mm wall plus the gap,
// 7.30-7.90 mm, and anything longer stands proud of the surface the sensor
// faces. No heat-set inserts: the thread is tapped into the
// PETG, and the inserts bought on #14 are for the enclosures.
//
// SET THE SENSOR AIR GAP FROM THE SCREW ENDS, NOT FROM THE TRACK. The screws
// can stand up to 0.65 mm proud depending where the hub lands in its band, and
// that is the highest point on a rotating assembly. Measure it once the ring is
// tightened and keep the sensor above it.
