jrkwon/mrider/docs/build/04-firmware.md

# 4. Firmware Bring-up: Teensy DBW Controller

**Goal:** flash and validate the single controller that closes every DBW loop, in stages, with
the motor disconnected until the software is trustworthy.

- **Prerequisites:** Section 3 complete; motor driver DIP switches set for independent R/C (PWM)
  mode, per the [Order Log](../order-log.md) entry for the board fitted; **the Teensy's
  `VUSB`–`VIN` pads cut** (below);
  isolated logic rail built and verified.
- **Specification:** [design/dbw.md](../design/dbw.md) · [design/safety.md](../design/safety.md)

> [!CAUTION]
> **Cut `VUSB`–`VIN` on every Teensy before it ever sees external power with USB attached**
>
> The two pads are **joined from the factory**, so powering `VIN` from the logic rail while the
> laptop USB is plugged in shorts two supplies together and **back-feeds the laptop's USB port**.
> PJRC puts a cut-apart pad pair on the underside for this.
>
> MRider needs the cut on all three boards: the Teensy is on the logic rail *and* holds a
> permanent USB link, because that link carries command **and** feedback
> ([failsafe row 2](../design/safety.md#2-failsafe-matrix)). Do it before Stage 0 — the first
> moment both supplies are present — and the laptop at risk is a student's own.
>
> **Where the pads are, and how to be sure you cut the right thing.** On the **underside**, near the
> USB end, **right beside the `5V` pin** — which is the top-left corner when the board is face down
> with the USB at the top, because the columns mirror. Two small pads bridged by a **short, thin
> trace**.
>
> **Expect to have trouble seeing it, and do not take that as a sign you are in the wrong place.**
> PJRC's own page still carries a `TODO` where the photograph of these pads should be, and the
> trace is fine enough that a loupe helps. **Identify it electrically instead** —
>
> | probe from | to | before the cut |
> |---|---|---|
> | `5V` pin | USB connector's 5 V | **beeps** — this is the path you are breaking |
> | `5V` pin | one pad of the pair | beeps → that is the **`VIN`** side |
> | USB 5 V | the other pad | beeps → that is the **`VUSB`** side |
> | pad | pad | beeps → the trace between them is the cut |
>
> **If a candidate pair does not satisfy all four, it is not the pair. Stop and look again.**
>
> Then —
>
> | | |
> |---|---|
> | **Cut** | A sharp craft knife, two or three light passes across the trace between the pads. Do not dig; the goal is to part a trace, not to carve the board. |
> | **After** | The same continuity check. **It must now be open.** Then check `VIN` to `GND` is not shorted. |
>
> **After the cut, USB alone will not power the board — and that is going to surprise someone.**
> PJRC's wording is that cutting "will isolate the USB power from the rest of the circuit board", so
> a Teensy on a bench with nothing but a laptop cable is **dead, not broken**. On this project the
> logic rail has to be up before the board does anything, including being programmed. **Label each
> board** once cut, because an unlabelled cut Teensy that does not enumerate looks exactly like a
> failed one, and there are thirteen students and no spare.
>
> **It is reversible** — PJRC: "the pads can be soldered together" — so a board that ends up on a
> bench permanently can be put back. Record it in the Order Log if you do.

- **Expected outcome:** the Teensy holds a commanded steering angle against a hand
  disturbance, publishes `DbwStatus` at ≥ 50 Hz with zero USB dropouts over 30 minutes, and
  both override layers are demonstrated.

> [!WARNING]
> **Draft — not yet validated on hardware**
>
> This procedure is derived from the design documents. No MRider build has been brought up
> yet, so timings, pin assignments, and library behavior are **unconfirmed**. Treat every
> number as a target to verify, not a measurement.

> [!NOTE]
> **Architecture change**
>
> This step previously covered two controllers — an Arduino Nano smart-servo *and* a Pixhawk
> running PX4. [Decision D3](../design/adr-dbw-architecture-review.md#46-decision-adopted-2026-08-07)
> replaced both with a single Teensy 4.1 running micro-ROS. If you are following an older
> printout, discard it: there is no PX4, no MAVLink, no servo-PWM capture, and no I²C
> register map in this build.

---

## 4.1 The datapath you are building

One command path, one feedback path, one transport, one clock.

```
laptop  /mitt/dbw/command  (DbwCommand: steering_angle rad, speed m/s)
              │
              │  micro-ROS over USB serial  (micro_ros_agent runs on the laptop)
              ▼
      Teensy 4.1  ── position loop >=200 Hz vs. absolute load-side angle sensor
              │  ── throttle ramp / cap / direction interlock
              │  ── RC serial decode, safety supervisor, watchdog
              ▼
      Teensy PWM ──▶ RC signal MUX ──▶ motor driver, R/C mode (RC1, RC2)
              ├── motor Left  → steering gearmotor
              └── motor Right → paralleled rear traction motors

      Teensy  ──▶ /mitt/dbw/status  (measured angle, setpoint, speed, ticks, mode, faults)
```

### The pin assignment — the one table that must be frozen before an iron is hot

**On a breadboard you move a wire; on perfboard you desolder.** So this table, not a figure, is
where the assignment lives, and **both** the bench layout
([§3.5.3](03-electrical.md#353-build-the-circuit-twice-and-not-for-the-reason-it-sounds-like)) and the soldered
signal board ([§3.5.4](03-electrical.md#354-transferring-to-perfboard-three-boards-become-one))
use the **same numbers**. *If they differed, the bench would prove nothing about the board.*

| Signal | Pin | Fixed or chosen | What has to be true |
|---|---|---|---|
| Drive encoder **A** (Hall latch A OUT) | **0** | chosen | A QDC channel. `QuadEncoder(ch, 0, 1, 0)` is the library's own example, so the pair is known good. **Crossbar: pin 0 excludes pins 5 and 37** |
| Drive encoder **B** (Hall latch B OUT) | **1** | chosen | Same channel. **Crossbar: pin 1 excludes pin 36** |
| Steering **SDA** (AS5600) | **18** | **fixed by hardware** | `Wire` on a Teensy 4.1. Not a choice |
| Steering **SCL** | **19** | **fixed by hardware** | Same |
| **E-stop sense** in | **20** | chosen | Plain digital in, fed by the relay board's divider. **Taking it forecloses Serial5, whose TX is pin 20** |
| **Relay gate** out | *not assigned* | — | Any digital out. Goes to a terminal, not a header |
| **i-BUS** RX | *not assigned* | — | **Must be a hardware serial RX, and it cannot be Serial1** — see below |
| **PWM** out to the signal MUX | *not assigned* | — | Must be a PWM-capable pin |

> [!WARNING]
> **Taking pins 0 and 1 for the encoder forecloses Serial1, and i-BUS needs a hardware serial port**
>
> Pin 0 is **Serial1 RX**. [§3.5](03-electrical.md#35-signal-wiring) puts the
> drive encoder's A channel there, and [dbw.md §10.2](../design/dbw.md#102-firmware-blocks)
> requires *"i-BUS on a hardware serial port."* **Both cannot have Serial1.**
>
> *This is a decision, not a fault — the Teensy 4.1 has eight hardware serial ports — but it has
> to be made and written down rather than discovered when the encoder stops counting the first
> time the receiver is plugged in.* **Serial3 (RX = pin 15) is clear of everything in this
> table; Serial5 is not, because its TX is the E-stop sense pin.**
>
> **Confirm at the bench before soldering**, with the i-BUS idle level metered first — the Teensy
> 4.1 is not 5 V tolerant ([§3.4](03-electrical.md#34-wire-the-e-stop-and-mux-first)).

---

**Why this matters for debugging.** Command and feedback share one link and one clock, so
`ros2 topic echo /mitt/dbw/status` shows both sides of the loop and `ros2 bag` captures a
complete record. The superseded design split them across four boards and two transports,
which is what made latency and dropout faults nearly impossible to localize.

---

## 4.2 Toolchain setup

```bash
# PlatformIO (firmware)
pip install --user platformio
pio --version

# micro-ROS agent — NOT available in the Humble apt repos, build from source
mkdir -p ~/uros_ws/src && cd ~/uros_ws
git clone -b humble https://github.com/micro-ROS/micro_ros_setup.git src/micro_ros_setup
rosdep install --from-paths src --ignore-src -y
colcon build && source install/local_setup.bash
ros2 run micro_ros_setup create_agent_ws.sh
ros2 run micro_ros_setup build_agent.sh && source install/local_setup.bash
```

> [!CAUTION]
> **Verify this before writing any firmware**
>
> - [ ] A **`micro_ros_arduino` release exists for Humble** with Teensy 4.1 support.
> - [ ] The transport is **USB serial** — the official package does not ship native
>       Ethernet. Accept that, or scope a custom transport deliberately.
>
> **If no Humble release exists**, fall back to a framed **binary** protocol with CRC and
> sequence numbers over the same USB link — never unframed ASCII
> ([dbw.md §9](../design/dbw.md#9-teensy-41-firmware-platform-and-version-pinning)). The
> architecture does not depend on micro-ROS; only the typed-message convenience does.

Record every version you flashed — this is now the platform's reproducibility claim, since
there is no upstream autopilot provenance to lean on
([software.md §6.3](../design/software.md#63-version-pinning)):

```bash
pio pkg list                     # platform + framework versions
# record micro_ros_arduino release tag, Teensyduino version, agent commit
```

---

## 4.3 Stage 0 — Teensy alone, no motor wired

Corresponds to [safety.md Stage 0](../design/safety.md#6-bring-up-protocol-staged-wheels-off-first).
**Nothing is connected to the motor driver yet.**

Wire only: absolute angle sensor (I²C), drive encoder, **E-stop sense**, USB to laptop.

> [!IMPORTANT]
> **The E-stop sense input, and what the firmware must do with it**
>
> [dbw.md §10.3](../design/dbw.md#103-safety-state-machine) has `E-stop` as a transition **into**
> `ESTOP` and `E-stop released + RC arm` as the only way **out**. Both need this input; it was
> specified in the state machine and missing from the harness until 2026-10-28.
>
> **Read it as a plain digital input — high means the authority chain is energised.** Wiring and the
> divider are in [§3.5](03-electrical.md#351-hardware-rc-signal-mux-wire-this-it-is-not-optional).
>
> **Three behaviours, and the second is the one that matters:**
>
> 1. **Low → enter `ESTOP`.** Zero throttle, centre steering, as the invariants already require.
> 2. **Low → freeze the steering integrator and zero it on entry.** The loop has been commanding a
>    wheel that cannot move; **without this the accumulated term slams the steering the moment the
>    contactor re-closes.**
> 3. **High again → stay in `ESTOP` until an RC arm.** Releasing the button must not be a *go*
>    command. The hardware has already restored traction and authority; **the question "should we
>    drive again?" is policy, and policy is firmware.**
>
> **Publish it in `/mitt/dbw/status`.** Thirteen students debugging three vehicles will otherwise
> spend twenty minutes on what a flag answers in five seconds — and a behaviour-cloning dataset
> captured through an E-stop event is garbage that nothing else marks.
>
> **It is never the thing that stops the vehicle.** The NC contacts and the coils do that, with the
> Teensy dead. *A sensed input that gets relied on is how a hardware interlock quietly becomes a
> software one.*

### Verify the angle sensor first, in isolation

```bash
# With a simple sketch printing raw counts, rotate the sensed shaft by hand
# through its FULL mechanical travel and watch for a wrap.
```

> [!CAUTION]
> **The wrap check is not optional**
>
> The AS5600 is **single-turn absolute**. Rotate the sensed shaft lock-to-lock and confirm
> the reading is **monotonic with no discontinuity**. A wrap here is FMEA row 2, severity 5:
> a garbage angle feeding a position loop that drives a motor.
>
> If it wraps, you mounted it on the wrong shaft. Move it load-side, or switch to the
> potentiometer fallback. Do not proceed.

Also check for magnetic interference: hold the steering motor near the sensor and confirm the
reading does not shift.

### Bring up micro-ROS

```bash
# Terminal 1 — agent
ros2 run micro_ros_agent micro_ros_agent serial --dev /dev/ttyACM0 -b 115200

# Terminal 2 — confirm the vehicle appears
ros2 topic list | grep mitt
ros2 topic echo /mitt/dbw/status --once
ros2 topic hz /mitt/dbw/status          # target: >= 50 Hz
```

### The 30-minute stability run

```bash
ros2 topic hz /mitt/dbw/status > /tmp/dbw_hz.log 2>&1 &
sleep 1800 && kill %1
```

> [!WARNING]
> **USB dropouts are a blocking defect, not a nuisance**
>
> Under this architecture the USB link carries the **steering setpoint** as well as
> feedback, so a dropout removes the setpoint and drops the vehicle to `ESTOP`
> ([failsafe row 2](../design/safety.md#2-failsafe-matrix)). That is the safe behavior, but
> a link that drops repeatedly is a vehicle that stops repeatedly.
>
> **Target: zero dropped sessions over 30 minutes.** If you see any, fix the cable, the
> port, or the transport before wiring a motor.

**Stage 0 gate**

- [ ] Angle sensor monotonic across full travel, no wrap, no motor interference
- [ ] `counts → radians` conversion verified against a digital angle gauge
- [ ] Range/plausibility check rejects an unplugged sensor (fault bit sets, mode → `ESTOP`)
- [ ] `/mitt/dbw/status` ≥ 50 Hz, zero dropouts over 30 min
- [ ] Encoder counts change in the correct sign for forward rotation

---

## 4.4 Stage 1 — steering motor on the bench, current-limited

Corresponds to [safety.md Stage 1](../design/safety.md#6-bring-up-protocol-staged-wheels-off-first).

**Use a bench supply with an adjustable current limit.** This is what turns a runaway position
loop into a harmless buzz. Set it low — just enough to move the motor unloaded.

Wire the motor driver: Teensy PWM → RC signal MUX → `RC1`, and motor Left → steering motor.

### Measure the actuation frame rate, and verify the signal-loss timeout

This is a required check, not an assumption. **The driver's signal-loss timeout is a DIP switch,
not a property of R/C mode** — `SW6 = 0` stops the motor after 100 ms of lost pulses and `SW6 = 1`
disables it entirely ([§3.4](03-electrical.md#34-wire-the-e-stop-and-mux-first)). *This page said
"inherent" until 2026-11-05.* And the frame rate you actually achieve is a separate question
again, which is what this check measures.

```bash
# With the motor commanded to a steady effort, press the Teensy's reset button
# and confirm the motor STOPS rather than latching at its last command.
```

*Until 2026-11-10 that comment read "unplug USB / press reset". On this build unplugging USB halts
nothing: the Teensy is powered from the logic rail, so it keeps running, sees its commands go
stale and emits **neutral** — which is a different mechanism from the one under test.*

**Then test the hang, which the reset does not.** A reset stops the pulses. A hang does not: the
pulse timer runs on without the loop, and the driver goes on receiving the last width
([safety.md §2](../design/safety.md#2-failsafe-matrix)). So:

```bash
# Build a variant that, on a serial command, enters `while (true) {}` inside the control loop.
# Command a steady effort, send it, and time the motor stopping.
#   - Stops within the watchdog period + 100 ms  -> the watchdog is armed and fed from the loop.
#   - Keeps running                               -> it is not armed, or an interrupt is feeding it.
```

Record the watchdog period you chose beside the result. **A hang test that was never run is the
same as no watchdog**, and this is the only automatic recovery the single-MCU design has.

> [!CAUTION]
> **If the timeout cannot be established, stop**
>
> Revert to independent R/C (PWM) mode and accept the ~50 Hz actuation ceiling
> ([dbw.md §4](../design/dbw.md#4-adr-motor-driver-control-mode-independent-rc-teensy-as-both-masters)).
> [Failsafe row 6](../design/safety.md#2-failsafe-matrix) and FMEA row 9 both depend on this
> behavior — it is one of the layers that makes a single-MCU architecture defensible.

### Tune and measure the position loop

Start with P only, add D, add I last and sparingly. Measure against the
[numeric contract](../design/dbw.md#12-numeric-interface-contract):

| Measurement | Target | How |
|---|---|---|
| Steady-state error | ≤ **1.0°** | Command a series of angles across ±20°, log measured vs. commanded |
| RMS error over sweep | ≤ **1.5°** | Slow triangle sweep, compute RMS |
| Step response (10°) | 90% in ≤ **400 ms**, overshoot ≤ **15%** | Log at ≥ 200 Hz, plot |
| Backlash / hysteresis band | *record the number* | Approach the same angle from both directions |
| Drift over 30 min | ≤ **0.5°** | Hold one angle, log; should be ≈ 0 by construction |
| Disturbance rejection | returns to setpoint | Push the output arm by hand, release |

> [!NOTE]
> **Pre-registered E4 decision point — this is the deadline**
>
> **If the loop cannot hold ≤ 1° steady-state with no sustained oscillation, adopt the E4
> fallback** — a dedicated closed-loop motion controller (Kangaroo x2 class) — rather than
> continuing to tune
> ([dbw.md §3](../design/dbw.md#3-adr-e-steering-control-loop-location-the-key-dbw-decision)).
>
> Firmware tuning is unbounded work. This bounds it. Take the decision on the numbers, not
> on how close it feels.

Also verify the interlocks:

- **Mechanical limit clamp** — drive toward a limit, confirm effort clamps *toward center
  only* and the at-limit fault bit sets.
- **Stall detection** — hold the output arm, confirm the stall bit sets and effort backs off.
- **Setpoint staleness** — kill the publisher, confirm `ESTOP` within 500 ms, steering
  centered then de-energized.
- **Freewheel on power cut** — [safety.md §4.4](../design/safety.md#44-test-procedure-freewheel-on-power-loss)
  steps 1–2.

**Stage 1 gate**

- [ ] All six measurements recorded in `docs/build/validation-report.md`
- [ ] Driver **R/C signal-loss timeout** verified to stop the motor — test it by stopping the
      **pulse train** (halt the Teensy), not by closing a serial port
- [ ] Limit clamp, stall detect, staleness watchdog, freewheel all demonstrated
- [ ] E4 decision taken explicitly — adopted or not needed, recorded either way

---

## 4.5 Stage 2 — both channels and both override layers

Corresponds to [safety.md Stage 2](../design/safety.md#6-bring-up-protocol-staged-wheels-off-first).
Add the drive motor on the bench, wheels off.

### Layer A — RC serial closed-loop override

Bind the RC set, wire the receiver's i-BUS output to a Teensy hardware serial port (115200 8N1, **not** inverted — SBUS would need inversion, i-BUS does not). Verify:

- Moving the mode switch puts the vehicle in `MANUAL_RC` (visible in `DbwStatus.mode`)
- The sticks command an **angle** — the position loop is still closed behind them
- Override engages within **≤ 200 ms** from any state
- RC frame loss → `ESTOP`

### Layer B — hardware RC signal MUX

> [!CAUTION]
> **This is the condition on which the whole architecture was adopted**
>
> D3 concentrates the steering loop, throttle, override, and arming on one MCU. The
> justification for accepting that is that override is a **wiring property**, not a firmware
> property. **That claim must be demonstrated here, not assumed.**

**Test it with the Teensy deliberately halted.** Hold the Teensy in reset (or unplug it
entirely), then:

- [ ] Flip the MUX channel and confirm the RC transmitter drives the MDDS30 **directly**
- [ ] Confirm steering responds to the sticks with the Teensy dead
- [ ] Confirm the traction channel behaves as designed in this state

Note what changes: through Layer B the override commands raw **effort**, open-loop — not an
angle. Feel the difference on the bench before you need it on the ground. It is acceptable
for an emergency mode, and it is exactly what B-MROVER does in normal operation — but it is a
different control feel and you should not discover that during an incident.

**Stage 2 gate**

- [ ] Both driver channels driven correctly from the single controller
- [ ] Layer A: angle-commanding override, ≤ 200 ms, mode visible in `DbwStatus`
- [ ] **Layer B: demonstrated with the Teensy halted**
- [ ] Behavior of Layer B recorded in the validation report, including the effort-vs-angle note

---

## 4.6 Gate to step 5

- [ ] Stage 0, 1, and 2 gates all passed and recorded
- [ ] Toolchain versions pinned and written down (§4.2)
- [ ] Measured steering numbers meet the [numeric contract](../design/dbw.md#12-numeric-interface-contract)
- [ ] No motor has yet been driven with the vehicle on the ground — that is step 7, after the
      relay MUX and E-stop are installed in step 5

---

**Next:** [5. Software & ROS 2 setup](05-software.md)
