jrkwon/mrider/docs/images/photos/battery-bay-measured.jpg

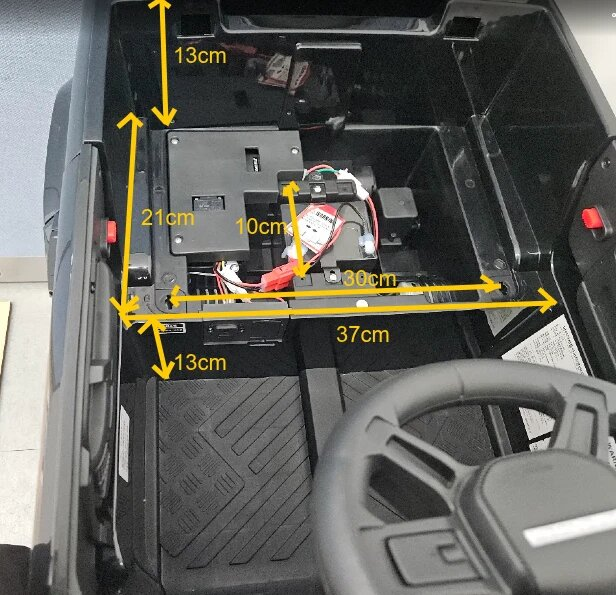
docs/images/photos/battery-bay-measured.jpg
