jrkwon/mrider/(commit log)

2026-07-22 Add MRider system design documents and Build/Learn doc skeletons
    Consensus-reviewed design (Architect + Critic approved) for converting a
    24V kids ride-on car to a drive-by-wire autonomous platform:
    - design/: architecture, vehicle, dbw, safety, sensors, calibration,
    software, bom — Pixhawk 6C/PX4 DBW with Arduino-local smart-servo
    steering, relay-MUX authority arbitration, two-tier BOM
    - docs/build, docs/learn: RoboRacer-style build guide and curriculum
    skeletons
    - design/overview.md: resolved design decisions + document index
2026-08-07 Add MkDocs + Material documentation site with GitHub Pages deploy
    Publish the design documents, build guide, and learn curriculum as a
    searchable site at https://jrkwon.github.io/mrider/ instead of loose
    markdown readable only through GitHub's file browser.
    Site:
    - mkdocs.yml (Material theme), requirements-docs.txt, /site/ ignored
    - .github/workflows/docs.yml -- PRs build with `mkdocs build --strict`,
    only main publishes via actions/deploy-pages
    - New landing page and Getting Started entry point
    Migration:
    - design/ -> docs/design/ and images/ -> docs/images/ (content unchanged)
    - build/learn README.md -> index.md; relative links rewritten accordingly
    - Fixed four pre-existing broken lin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
2026-08-07 Add 2026-08 DBW architecture review ADR
    Re-examine the two resolved DBW decisions -- Pixhawk-based topology and
    the Nano-local steering loop -- against the actual B-MROVER source at
    /mnt/data/projects/mrover rather than the design docs' description of it.
    Existing ADRs are left untouched; this records the review separately.
    Both decisions stand, but two of their stated rationales do not:
    - ADR E credits option E2 with "max reuse of mrover's
    carlikebot_system.cpp". That file is the upstream ros2_control demo,
    namespace ros2_control_demo_example_11, whose read() echoes the command
    back as state and whose write() only logs. E2 has no reuse advantage.
    - overview.md's "PX4 gives you the E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
2026-08-08 Adopt single-Teensy DBW architecture (close ADR decision D3)
    Close D3 as ADOPTED, before any hardware was ordered, as the review's
    section 7.4 required. A single Teensy 4.1 running micro-ROS replaces both
    the Pixhawk 6C and the Arduino Nano, conditional on the layered override
    the review made a precondition.
    The two questions the source tree could not answer are recorded with the
    lab's answers. The validated-autopilot claim was judged not decisive --
    findings F2, F3, F5 and F11 each remove one of its legs, leaving only RC
    override, which section 4.5 answers in wiring. The decisive local factor
    is that the previous three generations fell short on sensing/feedback
    quality and integration comp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
2026-08-08 Rewrite build steps 03, 05, 06 for the single-Teensy architecture
    Removes the "do not follow the steps below as written" notices from the
    three build steps that still described the Pixhawk + Nano topology.
    03 -- electrical:
    - Logic rail is now a separate 12 V battery + DC-DC, not a tap through the
    PM02. Called out as safety-critical rather than incidental: the Teensy
    holds the entire safety supervisor, so a brownout loses every
    firmware-layer protection at once and there is no second controller to
    survive it.
    - Signal wiring rewritten for packetized serial (single master, one wire)
    and Teensy hardware quadrature decoders, I2C angle sensor, SBUS.
    - New 3.5.1 wires the hardware RC s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
2026-08-08 Rewrite Learn M1-M3 for the single-Teensy architecture
    The three modules carried accurate notices but their lecture bodies still
    taught the superseded PX4 datapath, so a student reading past the banner
    learned the wrong architecture. Rewrites the bodies and removes the
    notices.
    M1 -- intro:
    - "Four computers" becomes two decision-makers plus a power stage.
    - Command and feedback paths rewritten around DbwCommand/DbwStatus.
    - The "command and feedback travel different roads" note is inverted:
    they now share one transport and one clock, which is what makes
    `ros2 topic echo` show both sides of the loop -- with the tradeoff that
    a USB dropout now also removes the setpoint.
    - Adds a box on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
2026-08-08 Close the last two D3 checklist items; revert Sabertooth to R/C PWM mode
    Verifies the two open pre-firmware items from the ADR, and reverts a
    decision that the second one turned out to invalidate.
    micro_ros_arduino (closed):
    - v2.0.8-humble, published 2025-09-30, is the current Humble release, and
    Teensy 4.1 is listed as Supported (min version v1.8.5). Pin that tag.
    - Upstream README states "Only USB serial transports are provided", with
    Known Issues noting transports still need refactoring for pluggability.
    An Ethernet example sketch exists but is not an official transport, so
    the earlier doc claim stands. USB serial accepted.
    - Corrects the Teensyduino version, which the ADR gave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
2026-08-08 Use pre-scaled logo images on the landing pages
    Adds mrider-small.png (257x40) and mitt-small.png (162x40) and points the
    README and docs landing page at them.
    Both pages were serving the full-size wordmarks -- 1776x276 and 1120x276 --
    and scaling them down in the browser with a height attribute. The new files
    are the same artwork at native display size, so the height attributes are no
    longer needed and the pages ship 32 KB instead of 43 KB for the same result.
    mkdocs.yml keeps the full-size mrider.png for the theme logo and favicon,
    where the extra resolution is still wanted.
2026-08-08 Add the MITT digital twin: URDF, depot world, controllers, SLAM
    Track A of the semester roadmap - the software development vehicle. The
    repository was documentation-only until now.
    Verified working end to end, headless: the vehicle spawns in the depot,
    drives under ackermann_steering_controller, and slam_toolbox builds and
    saves a map (602x312 cells at 5 cm, 70.6% explored, walls and shelving
    aisles clearly resolved).
    Structure:
    - mitt_description parameterized Ackermann URDF + mitt_dimensions.yaml
    - mitt_sim depot world wrapper + ros_gz sensor bridge
    - mitt_control ackermann_steering_controller, twist_mux, teleop
    - mitt_localization robot_localization EKF, indoor profile
    -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
    [depot.sdf, inertial_macros.xacro, mitt.urdf.xacro, mitt_base.xacro, mitt_controllers.yaml, mitt_ros2_control.xacro, mitt_sensors.xacro]
2026-08-08 Record the ADR D reversal and close the Gazebo pairing gate
    Two design decisions changed while building the twin. Both are recorded as
    amendments with their reasoning, not edited away.
    ADR D reversed -- 12 V single-seater adopted:
    The two candidate cars were read from their vendor detail sheets. Both are
    12 V single-seaters (99x55x41 cm, 10 kg, dual motor, 2.4 GHz remote), which
    is the D2 option ADR D explicitly rejected on payload and torque margin.
    The lab elected to adopt the class anyway for cost and footprint. Of the
    two, the Land Rover Defender is recommended: a boxy 47 cm roofline gives
    somewhere to mount a mast, where the GT-R's sloping sports shell does not.
    New ADR D-R records t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
2026-08-08 Make Nav2 actually drive the twin
    First end-to-end Nav2 run in the depot world. A 12.95 m goal now plans,
    drives, and reports success 0.43 m from the target. Three things were
    broken and none of them were Nav2.
    twist_mux lived in teleop.launch.py, but it owns the remap onto the
    controller's reference topic - so an autonomy-only session had no mux at
    all. Nav2 accepted goals, planned, and published commands to a topic
    with zero subscribers while the vehicle sat still, silently. Moved to
    its own launch file included by bringup. Its navigation input was also
    pointed at cmd_vel_nav, which on Humble is the INPUT to velocity_smoother,
    so it was bypassing acceleration limiting; corrected to cmd_ve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
2026-08-09 Declare the passive front wheels to ros2_control
    The front road wheels free-wheel, so nothing claimed them and they were
    left out of the ros2_control block. That was not cosmetic:
    joint_state_broadcaster only publishes joints it knows about, so
    robot_state_publisher could not compute front_{left,right}_wheel_link and
    those two frames were missing from TF entirely. RViz reported it on the
    RobotModel display, which is how it surfaced.
    Fixed by listing them with state_interface only, no command_interface.
    Verified: /joint_states now carries 6 joints instead of 4, and both frames
    resolve at [0.630, +/-0.230, 0.090], matching wheelbase and half-track.
    Declaring them <fixed> would also have sile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
    [mitt_ros2_control.xacro]
2026-08-09 Swap NavFn for SmacPlannerHybrid and enable reverse
    Closes the second half of ADR-SW2. The trap case in software.md 4.4 was
    the visible symptom; the real problem was broader. NavFn plans as though
    the robot were a free-turning point, so it routinely returned paths this
    car cannot drive, and RPP rejected them mid-follow with "detected
    collision ahead!" on geometry that was never feasible. No amount of
    controller tuning fixes a path that is undrivable by construction.
    SmacPlannerHybrid searches (x, y, heading) with Reeds-Shepp curves bounded
    by minimum_turning_radius, so a returned path is drivable by construction.
    allow_reversing is now true, and it is worth being precise about why it
    was n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
2026-08-09 Give the vehicle a body mesh, and draw the sensor mounts
    Two things.
    BODY MESH. Derived from the Fuel "SUV" model by Open Robotics (CC0 -
    public domain, chosen over better-looking alternatives carrying
    NonCommercial or NoDerivatives terms, same reasoning as the Depot world).
    It is a Hummer H2: boxy, upright, flat-roofed, which is the right
    silhouette for a Defender-style ride-on.
    Three preparation steps, each load-bearing. The source wheel groups are
    dropped, because the URDF has its own four wheels that steer and roll and
    baked-in ones would sit frozen alongside them. The upstream -90 deg Z
    rotation is baked into the vertices rather than left to the URDF origin:
    URDF applies <scale> in th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
    [mitt_base.xacro, mitt_body.obj]
2026-08-10 Document running the twin; fix BOM totals and add a gamepad
    RUN-THE-TWIN DOC. New docs/run-the-twin.md covering the four-terminal
    bring-up, driving to build a map, sending a goal, saving the map, and
    shutting down. Every command in it has been run end to end.
    It leads with the failure modes rather than hiding them, because each one
    cost real time in this session and none of them announce themselves:
    forgetting setup_env.sh in one terminal leaves that shell on a different
    RMW, so the simulator looks dead while running perfectly; `topic pub
    --once /goal_pose` is dropped silently by DDS discovery; SLAM starts with
    a blank map so goals cannot plan until you drive; and orphaned simulators
    interl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
2026-08-11 Add the order log, a fill-in record for procurement
    docs/order-log.md is a working document, meant to be edited as parts are
    ordered and arrive. bom.md is the specification and build/01 is the
    sourcing guide; this is the history of what was actually bought, from
    whom, for how much, and what got substituted.
    Three batches with fill-in columns: Batch A ($608) has no dependencies and
    can be ordered today; Batch B ($70) is the three parts that cannot be
    specified from a catalogue; Batch C ($168) is perception, deliberately
    last so it is unspent if the steering loop fails its bench gate.
    Batch B gets the most structure, because ordering those three early is the
    documented way to waste money her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
2026-08-11 Record why the Sabertooth is worth $125, and flag a contradiction it exposes
    Asked to justify the Sabertooth before ordering, and the answer turned out
    to depend on a number this repo asserts twice, differently, and has never
    measured.
    vehicle.md 3.1 says "RS-550-class 12 V motors ... 30-60 A each", which
    paralleled onto one channel is 60-120 A - at or beyond the 2x32's ~64 A
    peak, making the driver marginal and FMEA row 7 live. The ADR D-R
    consequences table in the same document says the 2x32 is "heavily
    oversized" for RS-390-class motors, which implies roughly a quarter of
    that. 3.1 was written for the 24 V two-seater and never re-scoped when ADR
    D was reversed; the RS-390 claim was asser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
2026-08-11 Stop guessing the drive-motor class; make measurement the authority
    vehicle.md asserted the motor class in two places with figures differing
    by roughly 4x: 3.1 said "RS-550-class ... 30-60 A each" (written for the
    24 V two-seater, never re-scoped when ADR D was reversed), while the D-R
    consequences row said "heavily oversized for RS-390-class motors" with no
    source. The number decides whether a $125 part is adequate, so a
    disagreement that size is not cosmetic.
    Resolved by asserting neither. Ride-on drive motors in this size range run
    from RS-380/390 to RS-550/775, their stall currents differ by close to an
    order of magnitude, and that range straddles the Sabertooth's 32 A/channel
    ceiling.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
2026-08-12 Record Korea sourcing for Batch A
    Checked Korean distributors directly rather than via search, which is
    US-indexed and surfaced nothing local.
    Verified at Eleparts: Teensy 4.1 (SparkFun 20359, "without ethernet",
    which is the standard part) at 52,182 KRW ex-VAT, and the Pololu #2806 RC
    servo multiplexer at 38,545 KRW ex-VAT, marked as an overseas-purchase
    line with ~6.5 business day lead. Korean distributor prices are quoted
    ex-VAT; the table says so, because a 10% surprise across a dozen line
    items is not nothing.
    The Sabertooth 2x32 is the only genuine import - not stocked at Eleparts.
    Dimension Engineering sells direct at $124.99 and ships internationally,
    and the datasheet confirms the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
2026-08-12 Price the Sabertooth options in Korea; correct a wrong saving claim
    Confirmed Devicemart 1179242 is "Pololu 4-Channel RC Servo Multiplexer
    (Assembled) #2806" - the correct part. The "(Assembled)" qualifier matters
    because Pololu also sells #2807, the unsoldered partial kit, and a listing
    that omits the item number could be either.
    Priced the Sabertooth line in the Korean channel by rendering the
    Devicemart pages, since their search is JS-built and plain fetches only
    return the shell. There is no 2x32 in Korea at all: Devicemart lists
    2x5/2x12/2x25 through the Digi-Key feed and all three read 품절, and only
    its own 2x12 is stocked, at 154,900 KRW ex-VAT / 170,390 inc-VAT.
    That makes the 2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
2026-08-20 Refresh the at-a-glance tables for the architecture that actually exists
    README.md and docs/index.md both carried the pre-D3 topology in their "System
    at a Glance" tables: Pixhawk 6C + PX4 + Arduino Nano, a 24 V two-seater
    chassis, and a 52 PPR encoder stated as fact. All three were superseded
    months ago - D3 on 2026-08-07, ADR D-R on 2026-08-08, and finding F7 forbids
    inheriting either PPR figure - but the summary tables were never re-read.
    These are the two pages a newcomer reads first, so they were describing a
    machine this project decided not to build.
    Corrected in both files, with links to the deciding ADRs rather than bare
    assertions. Three rows gained detail the originals lacked: th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
2026-08-20 Correct two learn modules before students are assigned to read them
    M1-M8 were written as a self-study kit and have not been re-read since two
    decisions closed underneath them. They are now weekly assigned reading for a
    24-student course, so the drift stops being a documentation debt and starts
    being something taught to people.
    m5-slam.md asserted "the drive encoder reports 52 pulses per revolution" as
    plain fact. Finding F7 explicitly forbids inheriting that number: the source
    project's firmware pins 52 PPR while its own BOM lists a 16 PPR motor, a
    factor-of-three disagreement nobody caught because in simulation nothing
    complains. Replaced with the instruction to measure, and the disagreem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
2026-08-20 Add the Fall 2026 course: syllabus, environment, tracks, and grading
    MRider is being taught as 자율주행미들웨어응용 - 24 graduate students, Mondays,
    first class 9/7, last 12/21. Students learn ROS 2 by finishing the vehicle
    rather than by doing exercises invented for a course, which works because the
    gaps in this repository are real and named: no firmware, no mitt_hardware
    plugin, no odometry node, no perception package, every dimension in
    mitt_dimensions.yaml still TODO measure, and 29 tests of which all 29 are
    linters. Those gaps are the four student tracks.
    The calendar is 16 weeks containing 15 meetings. 9/1 is a Tuesday so the first
    Monday is 9/7; 10/3 falls on a Saturday so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
2026-08-20 Add Weeks 4-8: through team formation and the mid-semester presentation
    Completes the run-up to the merge ladder. Week 4 carries the systems content
    displaced by the 10/5 holiday, Week 5 is the self-study packet that replaces
    the missing meeting, and Weeks 6-8 hand the vehicle over to the four tracks.
    Week 4 is the densest session of the foundation block by design: URDF through
    TF2 through Gazebo through ros2_control, in one sitting, because that pipeline
    is what people get stuck on unsupervised and next Monday there is no class.
    Week 5 gets the mathematics instead - the bicycle model and the R_min
    derivation read fine on paper, and Lab 5 measures against a simulator that
    already works.
    We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
2026-08-21 Add Weeks 9-12, and stop the Nav2 config contradicting itself
    Weeks 9-12 take the course from control theory to the second merge: PID and
    the steering loop, pure pursuit and RPP, perception and calibration, SLAM with
    Merge 1, and Nav2 with Merge 2. Weekly notes and four decks; W13-W15 stay
    unwritten until the hardware exists, since they turn on measured geometry and
    on which bench kit actually works.
    Writing W12 surfaced a config that argues with itself. nav2_params.yaml sets
    allow_reversing: true on line 149, and then says the opposite in four comments:
    line 58 "cannot spin in place and does not reverse"
    line 98 "allow_reversing is false"
    line 110 "probably reverse, which is a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
2026-08-21 Cap the Marp build so a hung Chromium fails instead of stalling
    Marp drives headless Chromium through puppeteer, and twice now it has hung at
    0% CPU without ever launching a browser - both times while a normal Chrome
    session was running. The second hang sat for 43 minutes before I looked at it,
    and produced nothing: no output file was written, no error was printed. A hang
    is indistinguishable from a slow render until you go and inspect the process
    table, which is exactly the failure shape this project keeps running into.
    build.sh now wraps each invocation in `timeout 180s` (~4x the slowest good
    run), reports TIMED OUT distinctly from FAILED, and names the likely cause,
    since "could not star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
2026-08-31 Make the Markdown source portable; render it for the site with a hook
    The docs used MkDocs Material admonitions, which read well on jrkwon.github.io
    and badly everywhere else. The failure was worse than losing a coloured box:
    admonition bodies are indented four spaces, which in plain CommonMark is a code
    block. In VS Code, GitHub's own .md view, or any generic viewer, a reader got a
    literal `!!! danger "..."` line followed by unwrapped monospace - across 1,656
    lines, 12% of all documentation.
    That syntax was deliberate but it was never a course decision: docs/design/ has
    used it since 2026-08-07 and the course simply matched the house style. What was
    NOT intended is github.io being the only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
2026-09-04 Texture the vehicle body, and retract a wrong claim about gz-sim
    The body rendered as a flat white shell. meshes/README.md and mitt_body.mtl
    both explained why, in these words:
    It was tried both beside the mesh and under materials/textures/ (the gz
    convention), and rendered in neither: gz-sim loads the mesh without any
    warning and simply draws it untextured.
    That was wrong, and it was recorded as a fact about the renderer. The
    counter-example was running the whole time: the Depot world - the warehouse the
    vehicle drives around every session - references ../materials/textures/
    WALLS_Albedo.png from Depot.dae by exactly the same relative-path convention,
    and draws fully textured.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
    [mitt_base.xacro, mitt_sensors.xacro]
2026-09-11 Isolate student machines with ROS_LOCALHOST_ONLY - and close the Gazebo hole
    The course isolated 24 students on one classroom network by assigning each a
    unique ROS_DOMAIN_ID. Jaerock asked whether ROS_LOCALHOST_ONLY=1 would not be
    the better tool, since students only run the simulator on their own laptop. It
    is, and measuring it turned up a second problem that neither mechanism solves.
    Measured on this machine, same node, only the variable changed:
    ROS_LOCALHOST_ONLY=0 -> binds 0.0.0.0:7400 AND 192.168.0.146:52573
    AND 172.16.77.105:36989
    ROS_LOCALHOST_ONLY=1 -> binds 127.0.0.1 only
    So traffic really does leave the machine today. A doma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
2026-09-11 Rewrite Lab 1 Part 5 around the mistake students will actually make
    Jaerock asked whether the ROS_DOMAIN_ID=42 exercise still meant anything after
    the switch to ROS_LOCALHOST_ONLY. It reproduced, but three things were wrong
    with it.
    The lab's own opening tip promised "Part 5 shows you what happens when you
    forget [to source setup_env.sh]" - and Part 5 began by sourcing it, then set an
    unrelated variable. The promise and the exercise had never matched.
    It also asked students to deliberately break a variable the course had just
    stopped using, which is an artificial exercise dressed as a realistic one.
    And measuring showed the realistic mistake produces the same silent failure.
    Part 5 is now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
2026-09-14 Catch the stale clone before it becomes a stale submission
    `submit` commits a student's lab on top of the course repository they
    already have. It does not pull, so their branch carries whatever they last
    pulled - lab instructions, check_env.sh, setup_env.sh, the tooling itself.
    That is not hypothetical this week. Week 0 (9/7) told students to clone, and
    the submission tooling did not land until 9/11. A student who followed the
    Week 0 checklist has a clone in which `scripts/lab.sh` does not exist, and
    nothing about that announces itself: the labs still open, the twin still
    runs, and the page they are reading on the website is the current one while
    the file in front of them is not.
    Three pla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
2026-09-14 Resolve the GitHub account before creating anything
    Two failures, and the second is the one that matters.
    A typo used to create the repository and only then fail to add anyone,
    leaving an orphan nobody could reach. That is untidy.
    The serious case is a typo that happens to name a REAL DIFFERENT PERSON.
    Nothing would have caught it: the API call succeeds, and a stranger is
    invited into a student's private repository. Students type these into a form
    from memory in the first week, and a GitHub username, a display name and the
    email they signed up with are not obviously different things to someone who
    made the account last Tuesday.
    So resolve `users/<name>` first, fail the row if it does not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
2026-09-14 Ask for the identifier this cohort actually has
    The sign-up form collects 학번 - ten-digit institution-assigned student IDs -
    and there is no umich uniqname anywhere in this cohort's data. `lab.sh init`
    was asking for "your uniqname (the part before @umich.edu)", which names
    something these students do not have.
    That is not cosmetic. Whatever they type derives their repository URL, so a
    student who improvises an answer gets a URL for a repository that does not
    exist, and nothing says so until the push at the very end of `submit`.
    So the prompt now asks for the student ID, naming the form they filled in,
    and the docs follow. The internal variable stays `uniqname`; only what a
    student read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
    [자율주행미들웨어응용 (Responses) - Form Responses 1.csv]
2026-09-14 Stop installing launch directories that do not exist
    A fresh clone could not build. mitt_sim, mitt_description and
    mitt_localization each declared a `launch` directory in install(DIRECTORY),
    and none of the three has ever contained a launch file:
    CMake Error at cmake_install.cmake:46 (file):
    file INSTALL cannot find ".../src/mitt_sim/launch": No such file or
    directory.
    Git does not track empty directories. The folders existed for whoever ran
    `ros2 pkg create`, and for nobody else - so the build worked on every machine
    that had already built it, and failed on every machine that had not. That is
    the worst shape a bug can have: invisible to the person who introduced it,
    and hi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
2026-09-14 Count down the invitation expiry, do not just report it pending
    GitHub expires a repository invitation seven days after it is created. This
    cohort was provisioned on the Monday Lab 1 was set, so an unaccepted
    invitation lapses on the Monday it is due - the same morning the student
    first tries to push, and the error says nothing about invitations.
    --status now prints the days remaining, reports EXPIRED separately from
    PENDING, and exits non-zero on a lapse. Re-running the script re-sends.
    Claude-Session: https://claude.ai/code/session_01DRtKXsmjmoJW7KizFXz9KH
2026-09-15 Record Korea sourcing, and reject the Sabertooth listing that reads like a bargain
    one-stop.co.kr #11156 is titled "DRI0004 Sabertooth Dual 25A" and describes
    "32A continuous / 64A peak" in its body. The part number is the truth -
    DFRobot's DRI0004 is the Dual 25A, 25 A / 50 A peak, 6-24 V.
    The confusion is inherited rather than invented: DFRobot publish it
    inconsistently themselves, with a wiki page titled "Sabertooth Dual 32A" at a
    URL ending Sabertooth_Dual_25A..._DRI0004. The reseller copied that page.
    What settles it is price, not specification. Dimension Engineering sell the
    2x25 V2 and the 2x32 at the SAME $124.99, so one-stop is asking roughly
    80,000 KRW more for less current and l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
2026-09-15 Say i-BUS, because that is what the receiver speaks
    The BOM specified "SBUS out (FlySky FS-i6 + FS-iA6B class)". The FS-iA6B
    outputs PWM, PPM and i-BUS, and never SBUS. The two are both serial RC
    streams and are not interchangeable: SBUS is 100000 8E2 inverted, i-BUS is
    115200 8N1 non-inverted.
    The word was left over from the PX4 era, when the receiver had to bind to a
    Pixhawk. That requirement died with D3; the word did not, and it went on to
    name a protocol the chosen part cannot produce. Nobody noticed until someone
    tried to buy it.
    The design never needed SBUS specifically. It needs a serial channel stream
    the Teensy can decode, plus a spare channel for the hardware MUX - and the
    MUX i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
2026-09-15 Record Korea sourcing leads, and two ways to buy the wrong part
    Continues the sourcing pass. Separates what was read off a vendor page from
    what came out of a search result, because the distinction earned itself
    immediately: search reported the RPLIDAR at 149,400 KRW and the vendor page
    says 155,430.
    DeviceMart and Eleparts render prices in JavaScript and cannot be read
    automatically, so anything only they stock stays a lead until someone opens
    the page.
    Two traps are written down because both are one character wide:
    FS-iA6 vs FS-iA6B. Korean RC shops bundle the FS-i6 with either. The plain
    iA6 is PWM only - no serial stream - so Layer A cannot be built on it at all.
    Only the iA6B has the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
2026-09-15 Correct the Sabertooth call: the listing is a 2x32, the title is stale
    The previous revision of this section said one-stop.co.kr #11156 was a 2x25
    sold as a 2x32 and told the reader not to buy it. That was wrong, and it was
    wrong because the SKU string was weighted over the page it appears on.
    The body is unambiguous. Every datasheet link goes to Sabertooth2x32.pdf,
    .doc and QuickStart on dimensionengineering.com; it states 6-30 V nominal
    with 33.6 V absolute maximum, which is the 2x32's range and not the 2x25's
    6-24 V; it states 32 A / 64 A and names revision v1.1. DRI0004 is DFRobot's
    legacy SKU string for the line, and DFRobot have not kept it straight either -
    their own wiki page for DR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
2026-09-15 Merge the recovered sourcing edits: real prices for four Tier 1 parts
    Recovered from an unsaved VS Code hot-exit buffer and merged onto the
    corrected Sabertooth section, so neither side was lost. Prices are now read
    off vendor pages rather than inferred:
    Sabertooth 2x32 Coupang 215,300 KRW (est. 10/8), one-stop 250,000 KRW
    Pololu MUX #2806 DeviceMart 31,680 KRW
    Teensy 4.1 DeviceMart 74,250 KRW
    Which retires the claim that any of this had to be imported. Everything in
    Tier 1 that was thought to need importing is available domestically; the
    earlier "no Korean source" reading was an artefact of DeviceMart and Eleparts
    rendering prices in JavaScript and returning nothing to an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
2026-09-21 Add the Fall 2026 purchase request: three sets, not four
    The lab has a 4,000,000 KRW ceiling and wanted four vehicle sets if the
    prices allowed. They do not, and not narrowly.
    3 full sets 3,817,380 95% of the ceiling
    4 full sets 5,089,840 over by 1,089,840
    4 sets, Tier 1 only, no LiDAR/camera/IMU
    4,136,920 STILL over by 136,920
    That last line is the one that settles it: a fourth set cannot be reached by
    cutting scope, because stripping every perception component from all four
    still does not fit. It needs roughly 1.1 M more, not a smaller basket.
    The document prices all 18 line items with a purpose for each - the approving
    office is not expected to know why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
2026-09-29 Turn the order log into a live tracker for the approved purchase
    The purchase is approved, so the order log stops being a template and starts
    being the record. It is restructured around what was actually approved - 3
    sets, two cards - rather than the single-set USD estimates it was drafted
    with.
    Batch 1 card A Tier 1, orderable now, 12 items 2,921,790
    Batch 1G card A Tier 1, gated on measurement 285,000
    Batch 2 card B Tier 2 perception, #17 #18 248,400
    #16 LiDAR already held, not purchased 0
    total 3,455,190
    #16 being in hand is not just a row: it frees 3 x 155,430 = 466,290 KRW that
    the a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
2026-09-29 Say that the Sabertooth drives the steering motor too
    The purchase request described item #3 as driving "both rear traction
    motors" - in both languages. Read literally, that leaves the steering
    gearmotor with no driver and the BOM missing a part.
    The BOM is not missing a part; the description was wrong. The Sabertooth is
    dual channel and both channels are used:
    S1 -> M1 steering gearmotor (#4)
    S2 -> M2 the two rear traction motors, paralleled
    The design record has this right everywhere - dbw.md section 11.3 tabulates
    it, architecture.md line 72 states it, 04-firmware.md draws it. Only the
    procurement document I wrote got it wrong, which is the document someone reads
    when deciding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
2026-09-29 Sabertooth cancelled for lack of stock; work the replacement
    The vendor cancelled the 2026-09-29 order - no stock, no ETA. The row is
    cleared, so nothing is committed and the projection no longer counts money
    that will not be spent.
    Recorded what a replacement must actually do, taken from the design rather
    than from preference, because the obvious substitutions fail on a requirement
    that is easy to miss: plenty of dual drivers accept RC pulses, far fewer STOP
    when the pulses stop. A driver that holds its last command when its controller
    dies is the stale-setpoint-with-live-actuator state safety.md calls more
    dangerous than a stop.
    Leading candidate is the Cytron SmartDriveDuo-30, verified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
2026-09-29 Substitute the Cytron MDDS30 for the unavailable Sabertooth
    Found at DeviceMart as a 해외구매 item, ~1 week lead time, 143,440 KRW VAT
    included. Confirmed the listing is the MDDS30 specifically and not a
    lower-capacity sibling - the capacity is the whole reason it qualifies.
    That is 106,560 KRW less per unit than the Sabertooth, 319,680 across three
    sets, on a driver with more peak current and wider voltage range.
    Recorded in the substitution log with what changes and what does not. Nothing
    above the driver changes: the Teensy firmware, the signal MUX wiring and the
    ros2_control stack are untouched, because the interface is servo pulses either
    way. That is a direct payoff of ADR sectio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
2026-09-29 Give #17 a camera specification instead of marketing copy
    "USB 1080p wide-FOV" is not a spec - it is the text on every camera in the
    category, and it does not exclude a single unsuitable one.
    What semester 1 actually needs, now written down: UVC class with no vendor
    driver, which sensors.md already required and the BOM never repeated; MJPEG at
    the working resolution; at least 30 fps at 1280x720; fixed focus; 70-120
    degrees horizontal.
    The MJPEG line is the trap in this category. USB 2.0 cannot carry 1080p raw at
    30 fps, so cameras advertise "1080p 30fps" and deliver it only in MJPEG - in
    YUYV the same hardware drops to 5 fps. A student sees 5 fps and concludes ROS
    is broken, which is a pla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
2026-09-29 Soften "fixed focus" to "focus that can be locked", and say how to test it
    The camera spec written yesterday demanded fixed focus outright. That is too
    strict, and it would reject cameras that are actually fine.
    What matters is that focus can be LOCKED, not how. An autofocus camera is
    perfectly usable if it exposes the UVC focus control - turn AF off once, set
    focus_absolute, and it behaves as a fixed-focus camera from then on. If the
    control is absent, the camera hunts forever and no software fixes it.
    So the distinction is testable, and the test is now written down alongside the
    format test:
    v4l2-ctl -d /dev/video0 --list-ctrls | grep -i focus
    focus_automatic_continuous present mea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
2026-09-29 Say what autofocus actually breaks, having got it wrong once
    I told the instructor that uncontrollable autofocus would be "more annoyance
    than defect". That is right for navigation and wrong for calibration, and the
    difference matters.
    The damage is not blur. Autofocus changes the focal length, and calibration.md
    section 3 produces a camera_matrix valid for exactly one focus position. A
    camera that refocuses has different intrinsics from moment to moment, so the
    stored camera_front.yaml describes a lens the camera no longer has. Section 4
    computes the camera-LiDAR extrinsics THROUGH those intrinsics, so it inherits
    the error.
    What is unaffected is worth stating as precisely as what is: nav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
2026-09-29 Fix the calibration §4 anchor
    Guessed the slug from the heading text instead of reading the built page.
    Fifth anchor this session, and the second I pushed without waiting for the
    guard's verdict.
    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
2026-09-29 Fix #10: the recorded link was a receiver, and most bundles ship the wrong one
    The instructor caught it - 팰콘샵 100004833 is the FS-iA6B receiver ALONE at
    31,000 KRW, not a transmitter+receiver set. It was cited as the vendor for a
    line item described as "RC transmitter + receiver", in the order log and in
    both languages of the approved purchase request.
    Checking the alternatives turned up the worse problem. Nearly every Korean
    FS-i6 bundle ships the plain iA6: 팰콘샵 100004832, 알씨뱅크 93882 and
    FirstBot all do. The iA6 is PWM only - no serial stream - so Layer A cannot be
    built on it at all. One letter separates a working closed-loop override from a
    part that cannot do the job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
2026-09-29 #10: the 팰콘샵 title is stale, the contents are the iA6B
    The instructor read the listing's own 구성품 table: Product Model FS-iA6B,
    Data port PWM / PPM / i.bus / s.bus. So 팰콘샵 100004832 ships the correct
    receiver despite a title saying "iA6 6채널 수신기 포함".
    That is the same failure as the Sabertooth listing - a stale string above an
    accurate description - and I made the same mistake reading it, twice in one
    week: trusting the title over the body. Both times the body was right.
    The note is rewritten around what actually distinguishes these listings, since
    "most bundles ship the wrong receiver" was too strong. 팰콘샵 100004832 is
    correct; 100004833 is the receiver a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
2026-09-29 #10: specify Mode 2, and say which stick the vehicle is driven from
    Mode 1 versus Mode 2 is an aircraft convention about which stick holds
    throttle. For this vehicle the real question is which stick self-centres, and
    that has a safety answer rather than a preference one.
    The FS-i6's throttle gimbal is physically ratcheted - it stays where it is
    left. Mode 2 puts that ratchet on the LEFT stick, leaving the right stick
    spring-centred on both axes. Mode 1 puts it on the right.
    So: Mode 2, with steering on CH1 (aileron) and throttle on CH2 (elevator),
    both on the right stick. Deliberately NOT CH3, the nominal throttle channel.
    Release the stick and the vehicle stops and straightens, which is w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
2026-09-29 Make #6 buyable: four parts, an electrical limit, and a decision tree
    "구동 엔코더 + 샤프트 어댑터" could not be handed to a vendor. Reading the
    design record end to end, the problem was larger than the name.
    The line hid FOUR parts and funded three. 02-mechanical section 2.6 requires
    "the encoder body bracketed to the motor mount", and no bracket exists in the
    BOM - #13 is the steering coupler, #14 is the sensor mast. Without it the
    encoder body turns with the shaft and reads zero, which looks exactly like a
    dead sensor. Split into 6a encoder, 6b adapter, 6c bracket, 6d fasteners, at
    the same 25,000 KRW per set; the projected total is unchanged at 3,348,570,
    because this is a re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
2026-09-29 Three orders placed, and a VAT trap that nearly understated them by 81,050
    Ordered from DeviceMart: Teensy 4.1 [이더넷] DEV-16771 x3, Pololu #2806 x3,
    and Cytron MDDS30 x4 - the fourth being the spare, since the driver is the
    single point of failure per vehicle on a part with a week's lead time.
    The order summary's 상품금액 column is EX-VAT, and taking it at face value
    would have recorded 810,500 against an actual charge of 891,550. The
    arithmetic gave it away: all three shown prices are exactly the logged
    VAT-inclusive unit divided by 1.1, to the won. Teensy 67,500 x 1.1 = 74,250;
    Pololu 28,800 x 1.1 = 31,680; MDDS30 130,400 x 1.1 = 143,440. Three
    independent exact matches is not co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
2026-09-30 Camera is fixed focus — and correct what an empty focus query means
    The camera arrived and `v4l2-ctl --list-ctrls` shows no focus controls at all.
    That resolves the contradiction flagged on 2026-09-29, where the listing text
    said 자동 초점(AF) while the product description said 고정초점.
    It is fixed focus, and the evidence is in the rest of the same output rather
    than in the absence. white_balance_temperature and exposure_time_absolute are
    both listed with flags=inactive - hardware that exists but is currently
    overridden by an auto mode. A driver that surfaces inactive controls is not
    hiding anything, so the absence of any focus entry means there is no focus
    unit to expose.
    Which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
2026-09-30 Camera passes, but v4l2_camera would have run it at a third of the rate
    --list-formats-ext on the test unit is the textbook shape the spec warned
    about: MJPG gives 30 fps at every resolution offered, while YUYV gives 5 fps
    at 1080p and 10 fps at 720p. The required line - MJPG 1280x720 @30 - is there,
    so the camera passes and the remaining three are clear to order.
    The part that would have bitten is the driver, not the camera. In Humble
    v4l2_camera supports YUYV, UYVY and GREY only, with pixel_format defaulting to
    YUYV - it cannot request MJPEG at all. Run it at its defaults on this camera
    and you get a live, correct, perfectly working image at 10 fps on 720p, with
    nothing in any log to say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
2026-09-30 Camera at 24,800 each after discount; the row now reconciles
    35,800 list less an 11,000 discount is 24,800 VAT-inclusive, well under the
    41,000 estimated. The recorded 74,400 is exactly three units at that price, so
    the row reconciles and the paid-vs-unit check clears.
    That reading makes the earlier test unit a fourth camera rather than one of
    the three - a spare, which for a part this cheap is worth having anyway. Worth
    confirming, since the alternative reading is that two were ordered for 49,600
    and the recorded figure is wrong; the arithmetic strongly favours three.
    Claude-Session: https://claude.ai/code/session_01DRtKXsmjmoJW7KizFXz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
2026-09-30 #17: one in hand, two outstanding — and make partial arrivals legible
    Three cameras total: the test unit plus two ordered 2026-09-30, at 24,800 each
    after an 11,000 discount off 35,800. The 74,400 recorded covers all three, so
    the row reconciles at 3 x 24,800.
    That correction exposed a gap in the log's own schema. `Arrived` is a single
    date, but arrivals are routinely partial - one camera here, three vehicles on
    three different days - so a row can be part-delivered and part-outstanding at
    the same time, and a bare "arrived" reads as though every unit is on the
    shelf.
    The Secured count already carried that state; the report just was not showing
    it. The outstanding list now prints "1/3 sec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
2026-09-30 Teardown resolves the drive encoder and the motor class
    The first vehicle arrived. Three questions the design record has been
    explicitly waiting on since August are now answered by inspection.
    The motor is a DING LI RS 390-12V RPM 18000, read off the can. vehicle.md has
    recorded the class as unknown since 2026-08-11 on the grounds that the
    plausible range straddles the driver's ceiling and no lookup resolves it. That
    posture was right and is now discharged by a label rather than a guess.
    It lands on the safe side - RS-390 is the small end of that range against a
    30 A channel - but the measurement requirement stays, and so do all six gates
    and FMEA row 7 that depend on it. A class label is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
2026-09-30 Correct four stale 24 V claims in the mechanical build page
    ADR D-R moved the platform to a 12 V single-seater on 2026-08-08, but
    02-mechanical.md was never updated. The worst of the four was a bring-up
    check reading "Battery is genuinely 24 V — the whole power tree assumes
    it": anyone running that checklist on the delivered Land Rover Defender
    would mark a correct 12 V pack as a failure.
    The other three — the teardown's pack-output tap, the encoder cable
    routing note, and the laptop isolation note — are all describing the
    same traction rail.
    Left at 24 V deliberately: vehicle.md (ADR D and its reversal, whose
    reasoning is preserved), bom.md's struck lines, the architecture review's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
2026-09-30 Name the role, not the part, on build pages; fix overview's reversed chassis
    ADR D-R moved MRider to a 12 V single-seater on 2026-08-08. Twelve files
    kept the old class. Repeating a hardware choice across a dozen pages is
    not precision - it is a dozen places to be wrong, and they all were.
    The convention instead: prose names the role, one document names the
    part. architecture.md already works this way - it contains no voltage at
    all, labelling its power tree "Traction battery pack". 03-electrical.md
    had diverged from it, not the reverse. order-log.md:270 likewise already
    specifies the motor driver by required properties rather than model,
    which is what let the Sabertooth -> Cytron substitut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
2026-09-30 Apply the same convention to the live design docs
    Second half of the ADR D-R cleanup. Role-only references to the motor
    driver become "the motor driver"; the part keeps its name where the
    product is the subject.
    vehicle.md - four LIVE sections were stale, outside the frozen ADRs:
    :18 decision drivers still listed "24 V electrical headroom" as a
    driver, with no note that D-R traded it away
    :32 criterion C2 was "24 V electrical system", a live must-criterion
    flatly contradicted by the decision below it
    :184 "Pack: confirm 24 V (nominal)" - a verification step that would
    have failed the vehicle actually bought
    §2 the July 2026 candidate evaluation is three 24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
2026-10-01 Fix the failsafe the docs described but the design does not have
    Fourteen lines named a "Sabertooth serial timeout" as a safety layer. The
    adopted mode is independent R/C (PWM), where no such mechanism exists: a
    serial timeout belongs to packetized serial, which dbw.md:119-130 records
    as adopted and then REVERTED, because an RC signal MUX multiplexes servo
    pulses and cannot select a serial stream.
    This was not a naming preference. dbw.md:138 says the R/C signal-loss
    timeout "backs failsafe matrix row 6" - and row 6, safety.md:65, is one
    of the lines that called it a serial timeout. The same document described
    one mechanism under two names, one of them from the rejected mode.
    Three ways tha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
2026-10-01 Vehicles and cameras secured; the stock steering motor re-scopes #4
    State: #1 vehicles arrived 2026-09-30, 3/3 secured. #17 cameras 3/3
    secured 2026-10-01. Projected total unchanged at 3,443,410.
    The substantive change is #4. All three vehicles steer under the parent
    remote, so the column already carries a DC gearmotor. dbw.md 11.5 adds
    one only "if the column had none", so the steering tap reuses the stock
    motor - NC to stock ECU, NO to driver M1. Nothing is added to the
    linkage and no second actuator can fight the first.
    #4 therefore becomes a contingency rather than a purchase, and #13 loses
    its motor-coupler half (the stock motor is already coupled; the
    angle-sensor magnet mount is sti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
2026-10-01 Close the steering torque question with the rated load; keep stall current
    Two corrections from the lab.
    The cameras need no re-check: units 2 and 3 are the same model from the
    same listing as the unit already validated for MJPG 1280x720@30 and the
    absence of focus controls.
    And the spring-scale load test on the steering column is unnecessary. The
    vehicle is rated for a 25 kg occupant and steers under the parent remote
    with that load aboard; MRider adds ~6 kg. That demonstrates the >= 2x
    margin at roughly 4x the added mass without measuring anything.
    The comparison is conservative on top of that, because steering torque
    tracks FRONT-axle load. A seated child sits between the axles with mo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
2026-10-01 Rename the measurement forms M1/M2/M3 to V1/V2/V3
    "M1" meant three different things in this project: the measurement forms
    in this file, the motor driver's output channels M1/M2 printed on the
    board, and Learn modules M1-M8.
    All three collided in order-log.md itself, in bold, forty lines apart:
    :328 "| S2 | **M2** | the two rear traction motors" is a driver channel,
    while :369 "**M2**: lock-to-lock travel" was a measurement. Tracing which
    M1 a sentence meant required filtering two unrelated namespaces out of a
    grep.
    The measurements are the cheapest of the three to move. Driver channels
    are printed on the hardware and cannot be renamed; Learn modules are
    referenced from seventeen files and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
2026-10-01 Record the stock ECU and the inline protector; pin the probe points
    Two labels from the delivered vehicle.
    JR1630RX-12V: a combined 2.4 GHz receiver and motor controller on a
    connector harness, DC 12 V, load current max 20 A. That answers
    vehicle.md 3.4's open check - the parent-remote receiver IS a separable
    module, and its motor outputs are what the three taps intercept. It also
    bounds the stock system's draw, though a controller rating is not a
    stall measurement and does not close FMEA row 7.
    A 10 A device sits in the battery + line to that ECU with no manual
    reset, so it is almost certainly an auto-resetting thermal breaker. That
    matters twice:
    It is not short-circuit protection. It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
2026-10-01 #10 arrived; the stock harness prints no conductor size
    Order state: #10 RC transmitter + receiver, 3 sets arrived 2026-10-01.
    NOT secured - the Verify check is still outstanding, and it is the one
    this line exists for: confirm the i-BUS port on the receiver BOARD, not
    on the box. The listing title says FS-iA6 and only the component table
    says FS-iA6B, which is how this went wrong once already.
    And a correction to the gauge guidance committed yesterday. It said to
    read the whole printed string and gave AWG16 and mm2 examples. The real
    harness reads:
    ZR-RVV-300/300V-XF3061-2007
    ZR flame-retardant, RVV flexible copper with PVC insulation and PVC
    sheath, 300/300 V class, against a spec and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
2026-10-01 #10 secured: all three receivers are iA6B, i-BUS port confirmed
    Checked on the board, which is what the Verify column asked for. 3/3
    secured.
    This closes the open item at order-log.md:185, which said "verify on
    arrival regardless of what any listing said". The component table was
    right and the 팰콘샵 listing title was wrong - it reads "iA6 6채널
    수신기 포함" while the specification table says FS-iA6B. The check was
    deliberately written against the physical board rather than against any
    listing, and that is why it answered cleanly.
    Consequence: Layer A is buildable as designed. The i-BUS stream into the
    Teensy is the normal manual override, and the plain iA6 is PWM-only -
    there wo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
2026-10-01 Scale the electrical spec to the vehicle that actually arrived
    Challenged on whether the wire and fuse requirements are stricter than
    this vehicle warrants, with the observation that mrover-class work mixed
    wire freely and never saw a current, voltage, or wiring problem. Checked
    it, and the challenge is largely right.
    The numbers: the stock ECU is rated 20 A max and sits behind a 10 A
    device, and the driver channel limits at 30 A. Over the ~1 m runs on this
    vehicle, 1.5 mm2 drops 0.23 V at 10 A and 0.70 V at 30 A - under 6 % at
    the worst case the hardware can produce.
    So the strand-count-and-compute procedure committed yesterday is gone. It
    existed because the harness marking (ZR-RVV-300/3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
2026-10-01 Contactor down to 50-60 A; course is 13 students, not 24
    Contactor: 01-bom-sourcing specified "100 A+ continuous, sold for winches
    and battery isolators" for a system whose stock ECU is rated 20 A and
    whose driver channel limits at 30 A. That is 3-5x over. 50-60 A is
    already ~2x margin.
    Over-sizing also cascades: a bigger contactor draws more coil current,
    and :181 already says coil current sets the mushroom button's rating. So
    the oversized contactor was quietly forcing an oversized button too.
    What does NOT change is DC-rated. That is not a margin question - an
    AC-rated switch breaking DC can weld its contacts closed, and the failure
    is silent until the moment someone presses the button.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
2026-10-01 Specify #7, #8, #11, #12, #14 to the level a vendor can fill
    Purchase specs for the five remaining Batch 1 items, sized against the
    vehicle actually delivered rather than the 24 V two-seater the BOM was
    written for: stock ECU 20 A, a 10 A device in its supply, driver channel
    limiting at 30 A. The list comes to roughly 200,000 against a 225,000
    budget.
    Four decisions in it are not transcription:
    #7 uses 4x SPDT automotive relays, not the 2x DPDT the design names. Both
    conductors of each motor circuit have to break - switching only the
    positive leaves the stock ECU's output tied to the driver's output
    through the motor winding - so it is four poles either way. A 30 A DPDT
    is hard to source i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
2026-10-01 #8: the part class is a continuous-duty solenoid, and 80 A is the market
    Searched for the contactor. Korean vendor pricing is not reachable from
    here - those pages are JS-rendered and the search tool is US-biased - so
    the price still needs a link. The technical half is settled, and the
    market does not quantize where this page asked.
    Continuous-duty solenoids are manufactured at 80 A and up, with little
    below. The 50-60 A requirement stands but is met by taking the 80 A part:
    the point of coming down from "100 A+" was the coil-current cascade, and
    reference parts in this class (White-Rodgers, Trombetta) draw ~500 mA,
    which already delivers it. Not a reason to pay for 200 A.
    Three things act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
2026-10-01 Verify FLS820 for #8, and fix the 40 A error it exposed in #7
    The Coupang listing (Foocle FLS820-012-1A, 12 V 80 A) checks out, and is
    a better part than the continuous-duty solenoid this page specified -
    on the one spec that cascades downstream.
    Coil 80 ohm -> 150 mA at 1.8 W, against ~500 mA for a solenoid of the
    same contact rating. That is what the E-stop's NC block must break and
    what the logic battery carries, so a third of it is a real win.
    1.8 W also settles the duty question the previous note worried about.
    Starter solenoids are intermittent-rated because their pull-in coils
    dissipate tens of watts; a 1.8 W coil holds indefinitely.
    Release <= 5 ms, and AgSnO2In cont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
2026-10-01 JD1914 verified for the steering poles; the coil resistor is not a clamp
    The 85-86 component on this relay family is a resistor, not a diode.
    That is the answer to the polarity question - there isn't one - but it
    makes the flyback diode MORE necessary, not less, and the page now says
    so with the arithmetic.
    When the MOSFET turns off, the coil's 150 mA has to keep flowing, and a
    680 ohm parallel resistor is the only path:
    resistor alone 0.150 A x 680 ohm = 102 V
    1N4007 flyback 12 + 0.7 = 12.7 V
    A logic-level MOSFET in this class is rated 55 V drain-source. 102 V is
    nearly twice that. The resistor damps ringing; it does not clamp. One
    diode per coil, and that is now written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
2026-10-01 Standardise on one 80 A SPDT relay for all five relay positions
    Proposed from the lab: use the same part for throttle and steering rather
    than splitting them. Right, and it goes one step further than proposed.
    The previous revision needed three part numbers - 80 A SPDT for the
    throttle poles, 40 A SPDT for the steering poles, and a separate SPST-NO
    for the E-stop contactor. Three sockets, three spares, three things to
    identify.
    A 5-pin SPDT wired 30->87 behaves exactly as SPST-NO, so ONE relay covers
    all five positions in the build: four MUX poles plus the E-stop. The
    steering poles are over-specified at 80 A, and that is the right trade in
    a three-vehicle course build - one socket type, o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
2026-10-01 Relay rating is unknowable from the listing; constrain the system instead
    The description on the evaluated part is family boilerplate, not a spec.
    KKA-B4 / TYE-RL082 is titled 80 A and described as "NO : 40A 14V / NC :
    30A 14V / 1a1b1c". Those disagree - and the 4-pin listing in the same
    family carries that line VERBATIM, including an NC rating and a 1c form
    on a part that physically has no NC contact. Neither number can be
    attributed to the part in the box.
    So stop needing the number. Set the drive-channel current limit to 20 A
    and fuse the main traction branch at 25 A, and every rating plausibly in
    this class is sufficient: even the pessimistic 40 A NO reading gives
    20-24 A on an inductiv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
2026-10-01 Correct the boilerplate reading; split E-stop and MUX onto two parts
    Two corrections from a third listing in the same family.
    First, I over-read the boilerplate. The previous commit concluded that
    neither the 80 A title nor the "NO : 40A / NC : 30A" description could be
    attributed to the part. Comparing three listings says more than two did:
    80 A 5-pin title 80 A shared text NO 40 / NC 30 disagree
    80 A 4-pin title 80 A shared text NO 40 / NC 30 disagree
    40 A 4-pin title 40 A shared text NO 40 / NC 30 AGREE
    The boilerplate matches the 40 A sibling exactly, so it was almost
    certainly written for that part and copied onto the 80 A listings - which
    makes the 80 A title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
2026-10-01 Three wrong parts caught at the counter: 24 V coil, IRF520, NO mushroom
    Reviewing candidate parts before the order. Three of five would not have
    worked, and the reasons are now written where the order is placed.
    24 V coil. The family ships 12 V and 24 V in the same shell and the title
    carries it - "KKA-B4 릴레이 24V 40A 4핀". The 24 V coil is 320 ohm with a
    16 V pick-up, so on this vehicle's rail it does not pull in at all. The
    12 V coil is 80 ohm, pick-up <= 8 V.
    IRF520 is not IRL520. The common Arduino "MOSFET module" uses an IRF520,
    Vgs(th) 2.0-4.0 V, with on-resistance specified at Vgs = 10 V. The Teensy
    drives at 3.3 V, where a high-threshold sample may not turn on at all and
    a lo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
2026-10-01 Pin TYE-RL076 and IRLZ44NPBF; the two relay roles break different loads
    TYE-RL076 (12 V 40 A 4-pin) and IRLZ44NPBF both check out, and verifying
    the first surfaced a better reason for the two-part split than the one
    recorded yesterday.
    The MUX poles sit IN SERIES WITH THE MOTOR LEADS, so they break an
    inductive load and take the 50-60 % derate. That is why they need the
    80 A part.
    The E-stop contactor sits in the B+ SUPPLY to the driver, upstream of the
    H-bridge. The motor's stored magnetic energy is on the other side of the
    bridge and never reaches that contact, and the driver's input capacitance
    works against the arc rather than feeding it. The break is essentially
    resistive, so 40 A aga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
2026-10-01 Explain why an AC-only contact rating is acceptable on the E-stop button
    Candidate button MRE-RR2R is rated "6 A 250 V a.c." with no DC figure.
    Everywhere else in this document that is a red flag - it is the trap that
    disqualified the vehicle's own 10 A device from E-stop duty - so the
    exception needs its reason written down rather than waved through as
    "the current is small".
    A sustained DC arc needs roughly 12-14 V across silver contacts. The
    AC/DC derating that wrecks switches is driven by VOLTAGE, not current:
    it is why a 250 V AC block collapses to a fraction of an amp at 30 V DC
    and to almost nothing at 110 V DC. At 12 V the supply sits at or below
    the threshold that keeps an arc aliv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
2026-10-01 #8 complete: MRE-RR2R is 2a2b, and the spec table was not ambiguous
    The MR-series model-code table resolves it. MRE-RR2R decodes as:
    R 조작부 protruding, mounting hole 22 mm, aluminium guard
    R 동작기능 push-lock turn-reset (latching)
    2 접점구성 2a2b
    R 캡 색상 red
    So it already carries two b접점 (NC), which is what this design needs,
    plus two a접점 that go unused. Snap-action, IP65, 22 mm.
    The "접점 구성 : 2a / 2b" line in the spec table was listing two a- and
    two b-contacts with a slash between them, not offering a choice between a
    2a variant and a 2b variant. I read the slash as alternation and asked
    for a confirmation that the table had already g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
2026-10-01 Note that 2a2b arrives as two stacked 1a1b blocks
    Visible in the product photo: the contact assembly is two separate clear
    blocks, not one block carrying four contacts. So the two NC contacts this
    design needs sit on DIFFERENT blocks, one each.
    Worth a line because of what the mistake looks like. Taking both circuits
    off one block gets you one NC and one NO, and the circuit that landed on
    the NO would do nothing until the button was pressed - and nothing at all
    if its wiring failed, with no indication. That is exactly the failure the
    NC requirement exists to prevent, reintroduced at wiring time by someone
    who bought the right part.
    Also confirms the guard question is moot: the mushroom sta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
2026-10-01 MRF is not MRE: an Alternate pushbutton cannot be the E-stop
    A faster-shipping candidate, MRF-AA2R, carries the correct 2a2b contacts
    and is still unusable. Same manufacturer, adjacent catalogue pages, one
    letter apart:
    MRE 비상정지 스위치 latching option R = push-lock turn-reset
    MRF 푸시버튼 스위치 latching option A = 유지동작 (Alternate)
    Two attributes beyond the contacts, and both are safety-relevant.
    The actuator is a flush Ø30 cap, not a mushroom. An E-stop has to be
    strikeable with a palm, without aiming, by someone who is not looking at
    it. A flush cap needs a fingertip placed on it.
    And Alternate is not turn-reset. Alternate releases on a SECOND PRESS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
2026-10-01 E-stop actuator must be red on yellow; a green one is available and wrong
    KGE-H4R2G (KGE Auto, navimro, ships next day) is the right device in the
    wrong colour. Ø22, push-lock turn-reset, 2a2b, IP65 - every functional
    attribute correct - and the trailing G is green.
    ISO 13850 requires the actuator to be red with the surface immediately
    around it yellow. That is not a formality in this build. Thirteen
    students will operate three vehicles, and under stress a person reaches
    for the colour rather than the shape. Green means start: a green mushroom
    is the one control on the vehicle that someone might press EXPECTING
    motion.
    Order the ...R variant of the same part. The lead time that motivated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
2026-10-01 Settle the E-stop on MRE-RR2R, with the two rejected candidates recorded
    Decided: 한국미스미 MRE-RR2R, shipping 10/16. The E-stop is not needed
    until Stage 3, two stages after anything is first powered, so the date
    costs nothing.
    All three candidates are recorded because each failed differently, and
    none of the failures is visible from a product title:
    MRE-RR2R 10/16 chosen. 22 mm, push-lock turn-reset, 2a2b, red,
    IP65, snap-action.
    MRF-AA2R next day rejected. Correct 2a2b contacts, but it is a
    PUSHBUTTON, not an emergency stop - flush 30 mm
    cap, and Alternate action releases on a second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
2026-10-01 Give the primary reason the E-stop needs two NC contacts
    The "Why two" note gave only the secondary reason - that a shorted coil
    driver leaves the MUX stuck in DBW - and omitted the one that actually
    forces the requirement. Asked to re-explain it, which is evidence the
    note would have confused anyone reading it cold.
    The primary reason is that the E-stop deliberately does NOT cut the logic
    rail. safety.md pins it: "E-stop cuts traction power only." The Teensy
    stays alive so it keeps reporting state. But the MUX coils are fed from
    that same surviving rail, so they stay energized through an E-stop unless
    something breaks them separately. Cutting traction alone would stop the
    vehicle and leave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
2026-10-01 Re-specify #11: the 7 Ah SLA is 3x oversized and 2.5 kg
    Challenged on whether a 2.5 kg lead-acid battery belongs on this vehicle.
    It does not, and measuring the load rather than guessing shows by how
    much.
    4x MUX relay coils at 150 mA 600 mA
    logic at 5 V through an 85% buck 118 mA
    total at 12 V ~720 mA, 8.6 W
    The relay coils are 84% of that and are irreducible - a latching relay
    would cut the draw and is forbidden, because de-energize-to-safe requires
    a relay that drops out when its coil loses power.
    2-3 Ah covers a session. The 7 Ah SLA buys runtime nobody needs and
    spends 2.5 kg doing it, against a C1 kit budget of ~6 kg total of which
    the control box, ba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
2026-10-01 Cut VUSB-VIN on every Teensy; fixed-output bucks; the passives are required
    Three things, one of which can damage a student's laptop.
    Teensy 4.1 ships with VUSB and VIN joined. Powering VIN from the logic
    rail with a USB cable attached shorts two supplies and back-feeds the
    laptop's USB port; PJRC provides a cut-apart pad pair on the underside
    for exactly this case. MRider cannot avoid the situation - the Teensy
    sits on the logic rail AND holds a permanent USB link, because that link
    carries command and feedback. So all three boards need the cut, before
    Stage 0, which is the first moment both supplies are present. Recorded in
    the sourcing spec and again as a Stage 0 prerequisite in 04-firmw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
2026-10-01 #7 ordered; split #8; reconcile the request with the log and guard it
    #7 ordered 2026-10-01. 12x 5-pin SPDT 80 A at 12,100 (socket included)
    from DeviceMart, plus bulk passives from Coupang shared across all three
    vehicles: IRLZ44N x5 9,100, a 30-value 600-piece resistor kit 9,900, and
    1N4007 x200 7,700. The kit covers both the 10k gate pulldown and the 100
    ohm series resistor.
    #8 split into 8a and 8b, following the pattern #6 already set. The 4-pin
    40 A contactor is ordered (3 at 11,000, bracket and socket included); the
    MRE-RR2R button is a 10/16 item. Keeping them as one row meant recording
    a partial payment, and order_status.py treats any row with a `paid` value
    as fully settled - so th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
2026-10-01 The ceiling is 4,000,000 and per-item variation needs no approval
    Clarified from the approving office: the university approved a TOTAL of
    4,000,000, not this request's line-item schedule. Individual prices may
    move, be substituted, split or dropped without further approval. Only the
    total binds.
    That makes the reporting wrong in emphasis. order_status.py already knew
    CEILING = 4,000,000, but printed it ONLY when exceeded, while showing the
    request's own 3,921,480 every run with an under/OVER verdict. The number
    that cannot be crossed was invisible and the number that is merely a plan
    looked like the bar.
    The totals block now leads with the ceiling and the headroom - 4,000,000
    and 486,690 -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
2026-10-01 #8b ordered: MRE-RR2R x3 at 11,924, well under the estimate
    한국미스미 MRE-RR2R, 11,924 each VAT incl, 35,772 for three, ordered
    2026-10-01. That completes #8 - both the contactor and the button are now
    placed.
    The split estimate put 8b at 24,000 a set to keep the pair summing to the
    approved 35,000. The actual is half that, so #8's amendment moves from
    Δ 0 to −36,228 and the whole line comes in at 22,924 a set against 35,000
    approved.
    Net −444,398, projected 3,477,082, headroom 522,918 against the ceiling.
    Check 13 confirms both languages and the order log agree on the
    projection.
    Also carried forward into #8b's Verify column the one thing that can
    still go wrong after the righ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
2026-10-02 #11 battery settled: SantaLi SLB1206, 12.8 V 6 Ah LiFePO4, 740 g
    Every requirement met, and the one that drove the re-spec is met by a
    wide margin: 740 g against the 7 Ah SLA's 2 500 g, on a vehicle whose
    control box, battery and wiring share a 3-4 kg budget.
    chemistry LiFePO4 4S, cylindrical LFP
    range 10.0-14.6 V, against a rail needing 9.5-14
    capacity 6 Ah -> 6.7 h at the measured 0.72 A load
    BMS integral: OCP 60 A, UVD 9.2 V, charge cut-off 15.0 V
    discharge 12 A continuous against a 0.72 A load
    terminals F2 spades and a 5.5-2.1 barrel jack
    enclosure IP54
    An earlier candidate - a 20 000 mAh LiFePO4 pack - was rejected because
    at four parallel string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
2026-10-02 Charger: SLC 1202 over SLC 1204; #11 ordered, #7 partially arrived
    Charger chosen on the manufacturer's own pairing matrix, which assigns
    SLC 1202 to SLB 12 V 6-12 Ah and SLC 1204 to 12-18 Ah. The 6 Ah pack sits
    below the 1204's range.
    Both are inside the pack's recommended 2-4 A, so the question was never
    whether 4 A would work. Deviating from a vendor's pairing of its own
    products needs a reason better than "faster", and there is not one: 3
    hours against 1.5 is invisible when packs charge between weekly sessions
    and run 6.7 hours on a charge, and 0.33 C is gentler than 0.67 C on cells
    three cohorts will share. Connector is 5.5-2.1 either way, straight into
    the pack's jack.
    #11 marked ord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
2026-10-02 #11 split and priced; record why the laptop cannot be the logic rail
    Battery and charger ordered 2026-10-02: SLB1206 at 50,160 and SLC 1202 at
    15,840, both VAT-added - the listing quoted 45,600 and 14,400 EX-VAT,
    which is the third time this vendor's figures have been ex-VAT and the
    third time it would have understated the spend.
    #11 split into 11a (battery + charger, bought) and 11b (DC-DC and
    passives, not yet), for the reason #8 was split: order_status.py treats
    any row carrying a Paid value as fully settled, so a composite row bought
    in stages silently drops its remainder from the projection.
    #11 now runs 81,000 a set against 60,000 approved, +63,000 across three.
    The LiFePO4 pack cost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
2026-10-02 Spell out buck vs buck-boost for #11b: the obvious listing is wrong twice
    A candidate DC-DC module turned out to be an LM2577 + LM2596 "승압/강하
    가변 컨버터" - boost and buck, trimmer adjustable. That is the wrong part
    on both axes, and it is the shape most Korean listings in this category
    take, so the page now says so explicitly rather than just asking for
    "fixed output".
    Fixed, not adjustable: a trimmer can be knocked in a harness, drift, or
    be set wrong once, and this rail feeds the Teensy's 3.6-5.5 V input and
    the board holding the entire safety supervisor.
    Buck only, not buck-boost: a buck's output is Vin x duty, so it is
    physically incapable of exceeding its input - a faile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
2026-10-02 Restore text a shell backtick expansion dropped from #11b
    The previous commit wrote the #11b note through python -c inside DOUBLE
    quotes, so the backticked `승압/강하 가변` was command-substituted away
    and the row read "Not a buck-boost" with the subject missing. The
    assertion still passed because it matched the surrounding text.
    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
2026-10-02 Check the UBEC input rating against the CHARGING voltage, not the nominal
    Evaluating two UBEC candidates for #11b surfaced the one place the
    LiFePO4 pack costs something. The rail is 12.8 V in use, but 14.6 V while
    charging, and the BMS does not cut until 15.0 V.
    Against a 16 V-class input capacitor that is 80 %, 91 % and 94 %
    respectively. All inside spec - and charging spends time past the 80 %
    derating electrolytics are usually given, on hardware three cohorts will
    share.
    Adafruit ada-1385 is confirmed as exactly the right topology - fixed 5 V,
    3 A, buck, UBEC - but its recommended input is 6-16 V. It will work. A
    generic RC UBEC rated 5-26 V removes the question instead, and those are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
2026-10-02 #11b UBEC: take the 7-40 V part over ada-1385
    Both candidates are correct-topology fixed 5 V 3 A buck UBECs. They
    differ only in input rating, and that is exactly where the LiFePO4 pack
    costs something:
    ada-1385 (6-16 V) 1078321 (7-40 V)
    pack nominal 12.8 80 % 32 %
    charging 14.6 91 % 37 %
    BMS cut-off 15.0 94 % 38 %
    The Adafruit part is inside spec at every point and would work. The
    7-40 V part deletes the question instead, costs no more, and needs no
    "disconnect the rail while charging" caveat attached to it. Its 7 V lower
    bound is never approached - the BMS cuts at 9.2 V and the firmware
    r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
2026-10-02 Track carriage as its own row; #11b ordered, #11c split out
    Shipping had nowhere to live. The request priced goods only and the order
    log's Paid column is per-row, while carriage is per-ORDER and can span
    rows.
    Folding it into Paid was the obvious move and is wrong: order_status.py
    checks paid == unit x qty, and that check has now caught two VAT
    omissions. Adding carriage would make it misfire on every shipped row,
    and a warning that always fires is a warning nobody reads. So carriage
    gets its own row - running total, qty 1, not per set.
    11,400 recorded: battery 3,500, charger 3,500, UBEC 4,400 flat regardless
    of quantity. OPEN, and flagged in the row: whether the earlier DeviceMart
    orders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
2026-10-02 Hold-up capacitors are 25 V, not 16 V — same derating I just applied
    This page specified "1000 µF 16 V" for the hold-up, and two sections
    later rejected the ada-1385 UBEC for sitting at 91 % of its input rating
    while the pack charges at 14.6 V. The capacitors are on the same rail and
    hit the same 91 %. I applied the rule to one part and not the other in
    the same specification.
    16 V part: 80 % nominal, 91 % charging
    25 V part: 51 % nominal, 58 % charging
    Also pinned where they go, which was never stated: the 12 V rail at the
    UBEC inputs. That is where the capacitance earns its place - 1000 µF from
    12.8 V down to the UBEC's 7 V floor is about 95 ms of ride-through for
    the logic loa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
2026-10-02 25 V capacitor confirmed; correct what the hold-up is actually for
    The 온벨류 1000 µF 25 V (10x17 mm, 10 for 10,600 VAT incl) is the right
    part. Ten covers three vehicles with four spare.
    Weighing 8,600 against the 16 V option turned up a stale rationale.
    safety.md says hold-up capacitance is how brownout isolation is achieved:
    "motor stalls sag the traction rail; the logic rail must not follow.
    Achieve with a dedicated logic supply with adequate hold-up capacitance."
    That was written when logic power came off the traction pack through the
    Pixhawk's PM02 module, where sag genuinely propagated. With a dedicated
    battery the traction rail cannot pull the logic rail down at all - the
    pack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
2026-10-02 Sync the requests after raising #11c; the previous push was broken
    I raised #11c's estimate from 3,000 to 5,000 a set when the 25 V
    capacitor price came in, did not carry it into the purchase requests, and
    then pushed anyway. Check 13 printed "purchase request does not reconcile
    with the order log" and I ran the commit regardless, because the check
    and the commit were separate commands rather than chained - so nothing
    stopped it.
    The previous commit is therefore a state where check_docs fails, and CI
    will have said so. This commit fixes it: net -329,444, projected
    3,592,036, headroom 407,964, both languages and the order log agreeing.
    The guard worked. I did not.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
2026-10-02 Fuse placement decides the holder style; put each fuse at its battery
    Asked which fuse holder style to buy - panel/spade or inline pigtail -
    and the answer follows from a placement rule the build pages never
    stated.
    A fuse protects everything downstream of it. The stub UPSTREAM, between
    the battery terminal and the fuse, is protected by nothing, so a chafe
    there shorts a pack capable of hundreds of amps straight to chassis. Keep
    that stub as short as the hardware allows: the 25 A at the traction pack,
    the 5 A at the logic pack.
    With placement fixed, the style follows. Panel/spade holders are fixed,
    findable and labelable, let you choose the wire gauge and crimp your own
    spades, and unplug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
2026-10-02 Add the board, wire and terminals #7 needs; warn off breadboard
    Asked how the coil driver gets assembled given the parts list is
    resistors, capacitors, diodes and a MOSFET. Fair - the list said
    "Perfboard + small enclosure" on one line and nothing else, which is not
    a circuit anyone can build.
    Added what is actually needed: soldered perfboard, 22-24 AWG hookup wire
    (the 1.5 mm2 silicone in #12 is power cable and will not route on a
    board), and 2-3 way screw terminal blocks for the off-board wires - the
    Teensy gate line, 12 V, GND and four coil pairs - so a harness can be
    unplugged without desoldering and wire movement does not load the solder
    joints.
    And a warning, because the obvious answ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
2026-10-02 Traction wire goes to 2.5 mm2: a 25 A fuse must not sit behind 16 AWG
    Asked whether a fuse holder's pigtail gauge matters and whether a 12 AWG
    ATC holder can take a 5 A fuse. Answering it exposed an error in #12.
    The holder question first: yes, a 12 AWG holder takes a 5 A fuse. The
    blade socket is identical for every ATC/ATO fuse, and the pigtail gauge
    limits the HOLDER, not which fuse fits. It is over-specified there, and
    the real problem is mechanical - a butt splice sized for 12 AWG will not
    grip 0.75 mm2 logic wire. Match roughly: 18-20 AWG for the 5 A, 12-14 AWG
    for the 25 A. And avoid holders with no stated gauge, because cheap ones
    use thin wire regardless of the fuse they are sold a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
2026-10-02 Two fuses per vehicle, not one per rail; branches are not fused
    Asked how many fuses and holders each vehicle needs. The §3.2 table could
    not answer it: it listed seven rails, asked for a fuse on each, and sized
    none of them, because it was written before anything was measured.
    With the gauges settled, most of those rows do not want one. A branch
    needs its own fuse only when its wire is thinner than what the upstream
    fuse protects, and the traction side is 2.5 mm2 end to end - so the 25 A
    fuse at the pack protects all of it and a second one downstream guards
    nothing.
    On the motor branches a fuse would be actively worse. The driver's
    current limit is already the mitigation FMEA row 6 relie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
2026-10-02 Give wire gauges in AWG as well as mm2, and warn about CCA
    The design records mm2; Korean listings sell silicone wire by AWG. Asking
    for 2.5 mm2 and 0.5-0.75 mm2 left the reader to convert at the point of
    purchase, so both units are now given everywhere, with the reminder that
    AWG counts DOWN as the wire gets thicker.
    traction AWG 14 (2.08 mm2, 25-32 A) behind the 25 A fuse
    logic AWG 18-20 (0.82-0.52 mm2) behind the 5 A fuse
    board AWG 22-24
    And a trap worth catching before the order rather than after: cheap
    silicone wire is frequently copper-clad aluminium sold at the same AWG
    number. CCA carries about 61 % of copper's conductivity, so AWG 14 CCA
    behaves roughly like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
2026-10-02 State the wire colour convention, and what it does not mean on motor leads
    Asked whether the logic wire also wants red and black. It does, and the
    project had no colour convention written down at all.
    Both packs get red = +, black = -. One polarity convention everywhere
    beats distinguishing the two rails by colour, because reversed polarity
    kills a board while a crossed rail merely loses isolation - and the rails
    are already told apart by gauge, AWG 14 against AWG 18-20.
    The exception is worth more than the rule. A driver output is a
    bidirectional H-bridge: its two conductors are not + and -, they are A
    and B, and swapping them reverses the motor. Red/black is a fine A/B
    label there but ca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
2026-10-02 Disambiguate the fuse-holder count: 2 per vehicle, 6 in total
    "2 per vehicle, 6 in total. 25 A -> 12-14 AWG - 5 A -> 18-20 AWG" read
    as three of each gauge PER VEHICLE, i.e. 18 for three teams. It is one of
    each gauge per vehicle: 3 + 3 = 6 across the whole build.
    Reworded in both places so the per-vehicle figure and the fleet figure
    cannot be read as the same unit.
    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
2026-10-02 ATO and ATC are the same fuse; the size family is what must match
    Asked whether a '대형 ATO 3~40A 10종 50개' set is the right thing and what
    ATC vs ATO means.
    ATO and ATC are dimensionally identical and interchangeable - ATO is the
    original with an open bottom, ATC has the element sealed, marginally
    better against moisture. Korean listings use the names loosely and this
    page had been saying ATC as if it were a requirement.
    What is NOT interchangeable is the size family: Maxi 29.0 mm, Regular
    (대형/표준) 19.1 mm, Mini (소형) 10.9 mm. Regular is what ordinary inline
    holders take, and is what 대형 means in these listings. That had to match
    the holders and was never stated.
    Ten va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
2026-10-02 Say what the XT60 is for, and where in the order it sits
    Asked where the XT60 is actually needed. The page listed it under
    "battery power tap, sized for peak drive current" and never said why, and
    the current rating is not the reason: it is 60 A against a 25 A fuse.
    Two jobs, both recorded now.
    Reversibility. dbw.md 11.5 promises that unplugging the three taps
    returns a factory-stock vehicle. The throttle and steering taps intercept
    stock wiring and need connectors by construction. The power tap is
    different in kind - a take-off, an added branch - and without a connector
    the only way to remove it is undoing a ring terminal on the battery post,
    with a tool, repeatedly, until the post is loo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
2026-10-02 XT60: bare halves, not pigtailed, and orient by which half stays live
    Asked whether the XT60 should be the AWG 12-14 pigtailed kind. No - bare
    halves, soldered to the AWG 14 run directly.
    A pigtail means splicing the vendor's wire to ours, which adds a joint on
    the highest-current connection in the vehicle and buys nothing. XT60
    solder cups take AWG 12-14 as they are. If only pigtailed stock exists,
    take the AWG 14 version so the gauges at least match; AWG 12 forces a
    step-down splice.
    And an orientation rule that was never stated: when the tap is unplugged
    the BATTERY half is still energised, so it must be the half whose
    contacts are recessed rather than exposed. Check the two halves in h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
2026-10-02 Count the tap connectors, and check for ones the vehicle already has
    Asked what the tap connectors are and whether "three families, three sets
    each" meant nine. It did not, and the phrasing was wrong twice over.
    There are three taps but the power tap is already settled as XT60, so
    only TWO more families are needed - throttle and steering.
    And a tap is four connector halves, not two, because the stock run gets
    cut and both cut ends need to mate with each other to restore factory
    stock, AND with the MRider harness to engage it. That is 2 pairs per tap,
    4 per vehicle, 12 across three: 6 of family A and 6 of family B.
    More importantly, that count may be zero. 02-mechanical step 2 already
    asks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
2026-10-02 Pin counts and current ratings for the tap connectors
    Asked how many pins. Steering is 2, definitively - one motor, two leads,
    about 5 A. Throttle depends on the vehicle: 2 pins if the stock ECU
    drives the two rear motors on a common pair, 4 if separately, which the
    ECU harness will show.
    The constraint nobody would guess from the pin count is the CURRENT.
    JST-class 2-pin connectors are 3-5 A, against a throttle branch the
    driver will push to 20 A. XT30 is rated 30 A and fits.
    And that choice makes the anti-cross-plug rule enforce itself. XT60 for
    power, XT30 for throttle and a small 2-pin for steering cannot mate with
    one another - different shells, different sizes - so using different
    fa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
2026-10-02 Traction pack ends in a keyed connector, not posts — the power tap changes
    Photographed 2026-10-02. The pack is sealed with a pigtail terminating in
    a red keyed 2-pin housing, with the stock 10 A protector just downstream.
    There is nothing to bolt a ring terminal to.
    That turns the power tap from a take-off into an interception, like the
    other two:
    stock pack -[conn]- protector - stock ECU
    MRider pack -[conn]-[MRider harness]-[conn]- protector - stock ECU
    + 25 A fuse -> XT60 -> contactor
    Which is better than what was planned. Get the mating halves of the stock
    connector and MRider inserts without cutting anything; unplug it, plug
    the stock pair bac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
2026-10-02 The stock connectors are the current ceiling, not the driver or the fuse
    The drive motors are connectorised too - a white 2-pin carrying the
    red/green pair, photographed 2026-10-02 - so the throttle tap is an
    unplug as well. Almost nothing on this vehicle has to be cut, which is
    better than the plan.
    And it turns a convenience into the binding constraint.
    stock design 10 A inline device, 20 A controller, connectors
    sized to match
    as planned here 25 A fuse, 20 A driver limit, AWG 14 wire
    Everything in the second row passes through the connectors in the first.
    The wire and fuse were specified larger than the connectors the current
    flows through - the same inve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
2026-10-02 Drop the dropped-spanner framing; the fuse argument stands on duller ground
    Pointed out that the battery terminals are insulated and connectorised,
    so there is nothing to short a tool across - and that I had leaned on
    that image repeatedly. Three places, and the scenario does not exist on
    this vehicle.
    The conclusion does not change but the stated reason was wrong, which is
    worse than it sounds: a justification nobody can check against the
    hardware is one nobody will keep.
    What actually justifies fuses at the batteries is duller. MRider adds
    several metres of wiring the stock vehicle does not have, routed by
    thirteen students through a chassis they are drilling, bolting and
    re-opening acro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
2026-10-02 How to rate an unmarked connector; tap list becomes mating halves
    Two things the hardware changed.
    The tap connector plan is superseded. The pack and the drive motors both
    terminate in keyed 2-pin connectors, so two of the three taps are
    unplugs. What to buy is the mating half of what the vehicle already has -
    identified by pin pitch and housing, or harvested from a spare lead - not
    a new XT30 and small-2-pin scheme. That scheme now applies only to a tap
    that turns out to be soldered, and the steering motor has not been
    photographed yet.
    And a method, because these connectors carry no marking at all and "check
    the rating" was not actionable advice:
    1. A floor for free. The manufacturer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
2026-10-02 #12 ordered: 190,020 goods + 3,000 carriage, and one fuse is the wrong size
    Coupang invoice 2026-10-02 reconciles exactly: items 205,820, less a
    15,800 discount, is 190,020 of goods, plus 3,000 carriage for 193,020
    charged. Goods go to #12 at 63,340 a set; carriage goes to the Shipping
    row, which is now 14,400.
    One problem in the basket. The "자동차 차량용 휴즈 퓨즈 MINI 오렌지 5A"
    x12 are MINI-size blades, and both holder sets bought in the same order
    are standard/대형. They will not fit. The cost is 480 so nothing is lost,
    provided the 10종 50개 set carries 5 A among its ten values - it should,
    and that is worth checking before the holders go on.
    Everything else lines up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
2026-10-02 MINI fuses cancelled: #12 drops to 189,540 and carries no carriage
    The 12x MINI 5 A fuses were a leftover in the basket, not a choice -
    cancelled 2026-10-02 with 3,480 refunded: 480 of goods and the 3,000
    carriage with them.
    So #12 is 189,540, all goods, and the Shipping row goes back to 11,400.
    Net -304,904, projected 3,616,576, headroom 383,424.
    One consequence worth keeping: with the MINI pack gone there is no 5 A
    fallback, so confirming the 10종 50개 set actually carries 5 A among its
    ten values moves from a sanity check to the thing that decides whether
    the logic rail can be fused at all.
    Claude-Session: https://claude.ai/code/s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
2026-10-02 Close #11c at zero: its parts were bought on the #12 order
    The capacitors and fuses #11c covers were bought on the Coupang #12
    order and are counted there. Closing it at 0 rather than splitting the
    invoice to populate it - a log that disagrees with a receipt is worse
    than a row that reads zero, and the row still carries what it was for and
    where the parts went. The divider resistors come from the #7 kit.
    Net -319,904, projected 3,601,576, headroom 398,424.
    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
2026-10-02 Make #6 concrete: one look decides the form, and three choices decide reliability
    Nothing in #6a-d is ordered, so the form is still open. Planning it
    properly first.
    ONE MEASUREMENT PICKS THE BUILD: is the rear axle end reachable on the
    rotation centreline, with somewhere to fix a magnet concentric to it?
    If yes, an AS5600 facing a diametric magnet replaces the whole ring
    assembly. One magnet and one chip instead of a ring, two sensors, a phase
    offset, an alternating-polarity assembly and two cables - and it is the
    same part #5 already uses, so students learn one sensor and one driver
    rather than two. It costs two things, both designed-in rather than
    discovered: the I2C address is fixed at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
2026-10-02 Withdraw the AS5600 proposal: it needs a shaft end this vehicle has none of
    Asked where the AS5600's sensor would actually bolt, and the answer does
    not exist. Added a figure showing both arrangements side by side, because
    the question is geometric and prose was hiding the problem.
    An AS5600 needs a rotating shaft END with clear space in front that
    nothing rotates through. This vehicle has no free shaft end: the motor
    side is a 2 mm shaft carrying a pinion into a sealed gearbox - the reason
    branches A and B failed - and the wheel side terminates at the OUTER FACE
    of the wheel, where a bracket has to arch around the outside of a turning
    wheel. Long, flexible, and the most exposed part of the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
2026-10-02 Record the 8 mm clearance — the measurement Branch C was decided on
    Corrected from the lab: Branch C was not chosen on a qualitative "there
    is clearance at the hub". I asked for the minimum gap between the
    gearbox's rotating part and the wheel, was told it is at least 8 mm, and
    chose C on that. The number was never written down.
    Worse, yesterday's plan listed that same clearance as a measurement still
    to be taken - re-asking for the answer that had already decided the
    branch. That is the failure this project keeps guarding against, arriving
    through my own hands: a decision whose evidence is not recorded looks
    unmade, and the next person re-derives it or, as here, the same person
    does.
    Re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
2026-10-04 A ring magnet's bore is round and the hub is splined — #6c may need a carrier
    Asked whether "hub outside diameter" means the rotating gearbox output
    that drives the wheel. It does - and answering it exposed something the
    switch to a ring magnet broke.
    A multipole ring has a PLAIN ROUND BORE. The hub was photographed at
    teardown as a splined plastic boss. A round bore cannot grip splines.
    So either there is a plain cylindrical section somewhere on the hub, and
    the ring sits on it directly, or the whole exposed surface is splined and
    #6c prints a CARRIER SLEEVE - splined inside to drive off the hub, plain
    cylinder outside for the ring to sit on.
    The carrier was dropped two days ago when l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
2026-10-04 Hub is 63.5 mm: real numbers, and two formulas on this page were wrong
    Hub measured 63.5 mm across the spline crests, all splined, so #6c prints
    a carrier: 3 mm wall, OD 69.5 mm, 218 mm magnet track.
    magnets pitch offset counts/rev mm/count
    12 18.2 mm 9.1 mm 24 23.8
    16 13.6 mm 6.8 mm 32 17.8
    24 9.1 mm 4.5 mm 48 11.9
    Take 16. 13.6 mm prints and populates easily, 6.8 mm is buildable with
    surface-mount parts, and 17.8 mm/count clears the 2 %-over-20 m gate by
    more than an order of magnitude - resolution was never the constraint.
    Two corrections, both mine.
    THE QUADRATURE OFFSET IS HALF A POLE PITCH, NOT A QU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
2026-10-05 Draw the carrier and magnet track
    Two views, because the geometry was not landing in prose. End view shows
    the printed sleeve gripping the splined 63.5 mm hub and presenting a
    plain 69.5 mm cylinder, sixteen magnets alternating around it, and the
    two sensors 6.8 mm apart - half a magnet pitch, which is the correction
    made yesterday and is far easier to see than to read.
    Axial section shows why the 8 mm is comfortable: the sensors sit RADIALLY
    OUTSIDE the magnets rather than beside them, so the gap holds the track
    width and the sensor thickness side by side rather than stacked. The
    earlier 1 mm figure came from picturing them stacked, and the drawing
    makes that obvious in a way the correctio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
2026-10-06 Carrier is printed as a two-piece clamp, not a spline-matched sleeve
    Asked whether the carrier is a 3D-printed part. It is, and printing is
    right rather than a compromise: it transmits no torque, it only rides
    along, so there is no strength case for machining - and three identical
    copies from one file is what printing is for.
    But "splined inside, plain outside", as this page had it, is the wrong
    way to make it. Matching the spline form means measuring tooth count,
    tooth form and undercut, modelling them, and printing to a tolerance FDM
    does not hold - for no gain, since nothing is transmitted through those
    teeth. An undersized press-fit bore is the other obvious route and risks
    splitting PE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
2026-10-06 Add the carrier model: parametric OpenSCAD, one measured number
    cad/drive_encoder_carrier.scad. HUB_D at the top is the single measured
    input; bore, outside diameter, track circumference, magnet pitch, sensor
    offset and counts per revolution all derive from it, and are echoed on
    build so the numbers that go into the bracket come out of the same file
    as the part.
    At HUB_D = 63.5 it gives bore 63.9, outside 71.9, track 225.9, pitch
    14.12, SENSOR OFFSET 7.06 and 32 counts/rev - 17.8 mm/count.
    It asserts the four ways the parameters can be made impossible: carrier
    wider than the gearbox-to-wheel gap, magnet wider than the carrier,
    pocket deeper than the wall, magnets too close to each other. C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
    [drive_encoder_carrier.scad]
2026-10-06 Fix the carrier's second ear, which pointed inward, and verify by bbox
    Flagged from the lab that the clamp could not fasten: the nut features
    did not pair up. Two bugs, and the first was worse than reported.
    ear(-1) PROJECTED INWARD. The module translated to y = sign * OD/2 and
    then grew a cube in +y, so the mirrored copy landed at y -35.9 to -26.9 -
    inside the ring, where it merged into the wall and cut its nut pocket
    into the bore. Only one usable ear existed. Rewritten to mirror the whole
    ear body, so both now grow outward.
    And the fastening itself was wrong. Both ears carried a nut pocket, so
    each assembled joint had a nut at BOTH ends and nowhere for a screw head.
    Now one ear takes th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
    [drive_encoder_carrier.scad]
2026-10-06 Fix the print layout overlap, and reverse the print orientation
    Both reported from the lab after opening the model, and both were mine.
    THE LAYOUT OVERLAPPED. "pair" separated the halves by OD/2 + 4 = 39.95,
    but each half is 89.9 mm across once the ears are counted, so the two
    collided over 10 mm. The offset was computed from the ring's radius and
    the ears were simply forgotten. Replaced with an explicit PRINT_GAP
    between two halves laid out in place, and renamed "pair" to "print" so it
    is obvious which target is the one you slice.
    AND THE ORIENTATION WAS BACKWARDS. The file said to stand each half on
    its split face, claiming the layers would then run across the clamping
    load. They run alo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
    [drive_encoder_carrier.scad]
2026-10-06 Make the encoder carrier one piece; its clamp ears swept the sensor
    The two-piece carrier put its M3 clamp screws in ears projecting 9 mm
    radially. The Hall sensors ride 1-3 mm off the magnet track, so the ears
    swept a Ø91 circle against a sensor face at Ø78: 6.5 to 8.5 mm of
    interference, taking the sensor and its bracket off on the first turn of
    the wheel. Nobody had asked whether Ø91 even clears the 8 mm slice.
    The wheel comes off, so the ring does not have to split at all. One
    piece, slid on, and every feature on it is now a recess.
    That raised the fit question the split was solving. It is not solvable
    by tolerance: the hub measures 63-64 mm and FDM holds a Ø65 bore to
    about ±0.3,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
    [drive_encoder_carrier.scad]
2026-10-06 Resize the carrier: the hub is 2 mm bigger than the model believed
    Measured by paper strip, the spline crests go 205 mm round. The model
    was carrying 63.5 mm, eyeballed rather than wrapped, which is about
    2 mm low — it would have put the bore at Ø64.7 against a hub of at least
    65.3, and the ring would not have gone on. A clearance bore does not
    save you from a wrong input.
    205/pi = 65.25 is itself a floor, not the answer. A strip pulled round
    splines rides the crests and chords the valleys, so what it measures is
    an inscribed polygon, P = N*D*sin(pi/N), always short of pi*D. The true
    crest diameter depends on the spline count:
    N 12 16 20 24 30
    D 66.00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
    [drive_encoder_carrier.scad]
2026-10-06 Take the hub at 65.3: the chord correction was for the wrong form
    The crest diameter was inflated to 66.0 by a polygon correction that
    assumes the crests are POINTS. The 2026-10-06 photographs show the hub
    is six broad lobes separated by narrow gaps, so a wire laid round it
    follows the crest arcs for most of the way and chords only six short
    gaps. The loss is 0.11 mm at a 20 degree gap and 0.37 mm at 30 — inside
    the +-1 mm of the measurement itself. The formula was right; the form it
    assumed was not this hub.
    So 205 mm is taken as it reads: HUB_D 65.3, and BORE_CLEAR rises to 1.7
    to keep the bore at the same Ø67.0. Every derived dimension is unchanged
    — OD Ø81.0, pitch 14.14 mm, offse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
    [drive_encoder_carrier.scad]
2026-10-06 Make the gauge a full fit mule, so one turn of the wheel settles three things
    The gauge ring was 3 mm wide and bore-only: it proved HUB_D and nothing
    else. Meanwhile two measurements stayed open that are genuinely nasty to
    take — the smallest obstruction radius inside a 6 mm slot behind a
    fitted wheel, and how much of the lobed boss stays exposed once the
    wheel is on. Both were being asked of a tape measure in a wheel arch.
    The mule is now the carrier's real bore, real OD and real width with
    none of the features: 12 g. Fit it, refit the wheel, turn one
    revolution. That answers whether the bore goes on, whether Ø81 clears
    everything it sweeps, and whether 6 mm fits the gap — and it answ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
    [drive_encoder_carrier.scad]
2026-10-06 Redraw the carrier figure: the hub is six lobes, not thirty-six splines
    The end view still showed a fine-spline hub, which is the form the
    withdrawn chord correction assumed and not the one in the teardown
    photographs. Redrawn with six broad lobes and narrow gaps, at the
    current bore Ø67.0 and OD Ø81.0, with the three grub screws shown
    seated in gaps rather than on crests.
    Added the lobe-phase note the drawing makes obvious once the lobes are
    there: six at 60 degrees against three screws at 120 is exactly two
    lobe pitches, so all three screws are always in the same place on the
    pattern and one lobe of rotation seats them together.
    Radial clearance caption now points at the fit mule rathe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
2026-10-06 Say why the encoder is magnetic at all, and make the latch a hard filter
    Three things, all in #6.
    WHY MAGNETIC. The record explained which branch was taken and never why
    the technology was. Written down now, because the BOM line still reads
    "드라이브 엔코더 + 샤프트 어댑터" and someone will try to buy one. A bought
    encoder and an AS5600 both need a shaft END, which is what closed
    branches A and B. What is left is a rotating SURFACE, and the question
    becomes which technology reads a surface. Optical does, and loses on
    where this surface lives: contamination sits directly in an optical
    signal path, a fork straddling Ø81 inside a 6 mm slot is not a printable
    part, and the cheap m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
    [drive_encoder_carrier.scad]
2026-10-07 Draw what "housing nose" means, because the words were not enough
    The bracket's two open measurements were written as prose — "diameter of
    the gearbox housing nose" and "axial length of that nose that stays
    reachable with the wheel fitted" — and that is not something you can act
    on standing at a vehicle. There are three cylindrical-looking things at
    that end of the gearbox and the prose did not say which.
    New figure: an axial section with the fixed housing, the fixed nose, the
    rotating lobed hub, the carrier in the gap outboard of it, the wheel,
    and the bracket clamped round the nose, with the two dimensions marked
    on the part they belong to. Alongside it an end view naming the same
    cir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
2026-10-08 The hub is not recessed: Branch C survives, and the ring does not float
    A side view with the wheel off (2026-10-08) settles the risk raised the
    day before. An end-on photograph had made the lobed hub look sunk inside
    the housing collar, and a Ø81 ring cannot reach a hub sitting inside a
    ~Ø72 bore — that would have invalidated the carrier outright. It is not
    sunk. The boss stands about 10 mm clear of the housing end, and the 6 mm
    ring goes on with room to spare.
    The same measurement breaks a smaller claim this page was making. It
    said the slot between the gearbox face and the wheel captured the ring
    axially without help. A 6 mm ring on a 10 mm boss is not captured by
    anything: the screws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
    [drive_encoder_carrier.scad]
2026-10-08 Magnets hold each other correct; I had the sign backwards
    This page said that at 14 mm spacing an alternating pattern pushes every
    magnet toward the orientation that is wrong, and told the builder to
    glue and cure each one before fitting the next. The physics is the
    opposite. Side-by-side dipoles prefer to sit ANTIPARALLEL, and
    alternating radial poles on a ring is that arrangement — it is the
    low-energy state, which is why a magnetised ring adopts it unaided.
    Summing the neighbour field over the ring at one magnet's seat gives
    +2.57 mT pointing outward, aligned with that magnet's own moment. A
    correctly fitted magnet is held correct by its neighbours.
    So nothing has to be clamped while a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
2026-10-08 Carry the magnet correction into the model as well
    The previous commit fixed the build page but its patch to the model
    silently missed — the string had drifted by one line — and I pushed
    without noticing, leaving the two disagreeing about the same physics.
    The model still told the builder to cure each magnet before fitting the
    next, on the strength of a sign error.
    Same content as the page now: degrease first, dot one face off the
    shipped stack and fit dot-out/dot-in from the index groove, press home
    flush, one drop of thin CA at the rim, wipe before cure, no
    accelerator. Nothing clamped while curing, because the alternating ring
    is the low-energy state and holds each magnet correct at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
    [drive_encoder_carrier.scad]
2026-10-08 The hub is 63.0: measure across, never wrap
    A ring printed to the recorded dimensions went on loose, and the hub
    measured across two opposite lobe crests — three positions, a tape, no
    caliper needed — reads 63.0, not the 65.3 the model was carrying.
    Six lobes is an EVEN count. Opposite crests face each other, so a
    straight measurement reads the crest circle and there was never a reason
    to wrap. I argued against a caliper earlier on the grounds that an odd
    count misreads; the count is not odd, and that argument should not have
    been applied here.
    The wire reading of 205 mm is explained, and it is not subtle. A wrap's
    centreline stands half a wire-diameter off the surface, so what you
    mea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
    [drive_encoder_carrier.scad]
2026-10-08 Record the 2026-10-02..08 arrivals, and un-record one that never happened
    Arrived and now logged: Teensy 4.1 (#2), Cytron SmartDriveDuo-30 (#3),
    Pololu 2806 (#9), BNO085 (#18) and the UBECs (#11b) on 2026-10-08; the
    logic battery (#11a) on 2026-10-07; #12 in two parts — fuse holders,
    AWG 14, AWG 22, XT60 pairs and the hold-up capacitors on 2026-10-03,
    AWG 20 and the ATO fuse set on 2026-10-07. Counts match the order on
    every line.
    #7 goes the other way. The row claimed an arrival on 2026-10-02 for the
    three Coupang bulk items — IRLZ44N, resistor kit, 1N4007. The parcel was
    marked delivered and the goods never appeared, so that arrival is now
    cleared: NOTHING from #7 is in hand, because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
    [drive_encoder_carrier.scad]
2026-10-08 Revert the #7 loss, and secure five lines against their checks
    #7 did arrive on 2026-10-02 as originally recorded. Yesterday's entry
    that it was marked delivered and never received was mine to make and
    mine to undo: the row is restored, nothing was re-ordered and no money
    moved. The 12 relays and sockets from 디바이스마트 remain outstanding, which
    is still why the row is not secured. The episode is left in the note so
    the next reader does not wonder why the arrival date moved twice.
    Secured against the Verify column:
    #3 Cytron — genuinely MDDS30, not a relabelled 2x25/2x32, and every
    switch OFF as shipped, so SW1:SW2=00 and SW6=0 are already right.
    SW3 and SW4 still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
2026-10-08 What arrived for #11b is an LM2596, and that is a substitution
    The part this page specified was a fixed-output 5 V RC UBEC, and the
    reason it was specified that way is in the text: "a jumper is far harder
    to disturb than a trimmer, but it is still a setting." A plain LM2596
    module is almost always adjustable, which is the setting the fixed part
    existed to remove.
    Electrically it is fine and the argument that chose a buck survives
    intact — a failed buck tops out at the rail and cannot exceed its input,
    which is why a boost stage was ruled out in the first place. Input range
    covers the 14.6 V the pack reaches while charging. The 3 A label is
    optimistic for these modules without a heatsink,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
2026-10-08 Say how to cut VUSB-VIN, not only why
    The page explained what the cut prevents and never explained how to do
    it or what it costs afterwards, which is the half a builder standing
    over a board actually needs.
    Added: the pads are on the underside near the USB end, two small pads
    bridged by a short trace; verify with a continuity check from the VIN
    pin to the USB 5 V BEFORE cutting — it must beep, and if it does not you
    are on the wrong pads — then cut and verify it is open.
    And the consequence nobody had written down. PJRC's wording is that
    cutting "will isolate the USB power from the rest of the circuit board",
    so after the cut a Teensy on a bench with only a laptop cable is dead,
    not br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
2026-10-08 Review the LM2596 against its own listing, and sharpen the VUSB cut
    LM2596S module, reviewed against the spec sheet rather than against what
    an LM2596 usually is:
    input 3.2-30 V fine. The pack's worst case is 14.6 V while
    charging, half the ceiling — against the 91 %
    an ada-1385 would have sat at.
    output 1.25-30 V, pot the problem, and exactly the property the
    fixed UBEC was chosen to remove.
    no current rating fine in practice. 3 A chip, 1.5-2 A
    unheatsinked, and each 5 V rail here carries
    under 0.5 A because the MUX coils run off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
2026-10-08 #11b: six modules, which is exactly enough and therefore not enough
    Two per vehicle across three vehicles, zero spares — the only line in
    Batch 1 carrying none. Everything else was bought with margin: four
    Cytrons for three, two hundred magnets for fifty-four.
    It is also the part most exposed to a wiring mistake. The module has no
    reverse-polarity protection and its own listing says so, and it is the
    one component a student sets by hand with a screwdriver before anything
    downstream of it survives. Two spares recorded as wanted.
2026-10-08 Withdraw the #11b substitution: the specified UBEC is what arrived
    Photographed and specified: 7-40 V in, 5 V 3 A continuous, 18 g — the
    디바이스마트 1078321 part the page chose, not a generic LM2596 module. The
    substitution recorded yesterday was my misreading of an answer, and it
    is withdrawn rather than deleted so the reversal is visible.
    What survives from that detour is worth keeping, and it is not a
    substitution note. The UBEC carries a small trimmer of its own, so the
    discipline the LM2596 seemed to demand applies here anyway: measure the
    output on the pack alone before any Teensy is connected, re-check at
    14.6 V with the charger on, lock the trimmer, write the volts on the
    m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
2026-10-12 Source the Hall latch domestically after all, and price the magnets
    Checked the three listings in a browser, which is what they needed —
    DeviceMart and ICbanq render their catalogues in JavaScript and Coupang
    returns 403, so every earlier attempt to read them from a plain fetch
    came back empty and the sourcing went to DigiKey by default.
    #6a no longer needs an international order. DeviceMart's own shelf
    carries neither DRV5013 nor US1881, but its realtime DigiKey/Mouser
    search carries the TO-92 (LPG) parts, which is the same 해외구매 route #3
    already used for the Cytron. Listed 2026-10-12: DRV5013BCQLPGQ1 ₩2,410
    at ±12 mT — the one to take — DRV5013AGQLPGQ1 ₩1,460 at ±6 mT,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
2026-10-12 Draw what "hub" and "bore" mean, since they kept getting swapped
    Two diameters within 1.2 mm of each other, one measured off the vehicle
    and one printed into a part, and this session has confused them more
    than once. The figure puts them side by side and says which is which:
    the hub rotates and you measure it across two opposite lobe crests, the
    bore is a hole and you print it, and the carrier's own outside diameter
    is a third number that faces the sensor rather than the hub.
    The clearance between them is drawn at 34x so it can be seen at all,
    with the point written next to it: it is supposed to rattle, and the
    screws reach five times further than they have to close. A bore that
    fitted woul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
2026-10-12 Three measurements of the hub, a millimetre apart, and it changes nothing
    A thin paper wrap held deliberately circular reads 195 mm — 62.0 after
    subtracting the paper — against 63.0 measured across two opposite lobe
    crests and 63.25 from the original wire wrap less its thickness.
    The wraps are the suspect pair and they err in opposite directions:
    thickness pushes a wrap high, chording across the six gaps pushes it
    low. Paper takes the shortest path between its contact points however
    carefully it is held, and gaps of 35-40 degrees would account for the
    entire spread on their own. The across-crests figure has no chord term,
    which is the whole reason to prefer it.
    HUB_D stays 63.0, and no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
2026-10-12 Fund the magnet adhesive, and say not to drill the hub
    Two gaps surfaced by one question.
    The assembly procedure has required thin cyanoacrylate to lock the
    magnets into their pockets and isopropyl alcohol to degrease them first
    — the single most common reason a magnet bond fails — and #6d funded
    neither. Line was "fasteners, threadlock, tie-downs" at ₩1,000, which
    covered the fasteners alone. Re-priced to ₩5,000; both consumables are
    shared across the three vehicles rather than per-vehicle. This is the
    same class of omission as #6c, which was a required part nobody had
    funded, caught this time before it reached a build. Amended in both
    purchase requests: net −307,904, projected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
2026-10-12 Magnets secured, the BC catalogue page is dead, and draw the sensor mount
    #6b secured. The magnets arrived and the axial magnetisation was
    confirmed by hand — faces attract and repel when one disc is flipped,
    so the poles are on the faces. That was the one specification the
    listing never stated and the only thing that could have made 200 discs
    useless. The amount paid is deliberately not recorded yet; the listing
    was ₩19,890 for 200 but the budget line should move on what was
    actually paid, not on what was quoted.
    #6a: the DRV5013BCQLPGQ1 catalogue page is 판매중지. It still shows 995
    in stock and four tiers of bulk pricing, which is why it reads as
    available right up until the buy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
2026-10-12 A handling charge reverses the sensor comparison; and the magnets are paid
    Element14 adds ₩20,000 handling, so the ₩970 part that looked cheapest
    becomes ₩29,700 for ten. Looking again with that in hand turned up a
    better answer than either of the originals: DRV5013BCELPEM, 디바이스마트
    13173732, ₩930 each and ₩780 at ten — ₩8,580 including VAT for ten
    against a ₩42,000 line. It is also the variant this section actually
    argued for, BC at ±12 mT, in the −40…150 °C grade, TO-92-3, 375 in
    stock, four to five days, buy button live.
    So the recommendation improved on every axis by being wrong once. Worth
    recording why both earlier candidates failed, because neither fai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
2026-10-12 #6a settled: twenty DRV5013BCELPEM, and no domestic latch exists
    Twenty of DRV5013BCELPEM from 디바이스마트 13173732. At the 10-25 tier
    that is ₩780 each, ₩17,160 including VAT, against a ₩42,000 line. Six
    get fitted, so fourteen spare, and the extra ten over a minimum buy cost
    ₩7,800 — deliberate rather than generous, because the part is 반품 불가,
    it is soldered by thirteen students, and reversed VCC/GND destroys it.
    Spares turn a wiring mistake into a lost part instead of a lost week.
    Recorded the check that closes the sourcing question rather than leaving
    it to the next person's guess: 디바이스마트's 마그네틱스위치 category with
    품절 and 해외구매 b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
2026-10-12 Carry the no-handling-charge finding into the sourcing section
    The previous commit put it in the order-log row and in both requests,
    but its patch to the build page missed — the paragraph had been reworded
    by an earlier edit in the same session — and I pushed without checking,
    leaving the page still telling a reader to check the cart for a fee that
    has since been established not to exist.
    Same content as the row now: twenty came to ₩17,160 incl. VAT plus
    ₩2,700 carriage, ₩19,860, with no 해외구매 수수료. A 디바이스마트 catalogue
    item sourced through DigiKey costs ex-VAT × 1.1 and domestic postage,
    and Element14's ₩20,000 is specific to Element14 rather than a prope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
2026-10-13 Carriage ₩6,000, and the second filament roll is a trigger, not a plan
    #14/#6d carriage confirmed at ₩6,000 and recorded in the Shipping row,
    which goes ₩14,100 to ₩20,100. Loctite confirmed as 4,000 x 3. Net
    −386,714, projected ₩3,534,766, headroom ₩465,234.
    Reworded the note about a second roll of filament, because as written it
    read as an instruction to buy one and it was not meant to. Nobody can
    say yet whether a kilogram is enough: three carriers are about 60 g, and
    the brackets, mounts and enclosures for three vehicles are the unknown —
    those parts are not designed. Pre-buying is guessing at a number nobody
    has.
    Replaced it with a trigger that produces one: print a fu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
2026-10-13 The insert spec sheet kills two assumptions: tap the PETG, and M3 x 8
    M3x4x5 turns out to be length 4.0, OD 5.0, recommended hole Ø4.5 — the
    model carried INSERT_L 5.0 and INSERT_D 4.6, both wrong, and the real
    numbers are worse than wrong. A Ø4.5 hole across a 6 mm wide ring leaves
    0.75 mm of PETG each side, and the insert swages out to 5.0 going in. It
    would split the carrier's faces.
    So the carrier's threads are tapped M3 straight into the PETG. A 2.5 mm
    pilot leaves 1.75 mm each side and the screw engages the full 7 mm wall
    rather than 4 mm of brass. The inserts are not wasted: #14 bought them
    for the enclosures, which is what that line always said they were for.
    The second one was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
2026-10-13 Record the maker's spec sheet, and re-answer #4: duty, not torque
    Spec sheet facts that were nowhere in the record: 12 V dual motor,
    traction pack 12 V 4.5 Ah, kerb weight 11 kg against the 25 kg load
    already known, runtime 1-2 h, three-step speed, 과전류 방지장치, and the
    98 x 56 x 47 cm envelope.
    The 4.5 Ah and the 1-2 h together put the toy's average draw at 2-4 A,
    which is what the stock 10 A fuse is sized for and leaves the driver's
    32 A/channel generous. It says nothing about stall, which is still the
    unmeasured number.
    On #4: the 25 kg rating against ~6 kg of kit does settle torque, and
    that is already why the line reads contingency rather than required. But
    torque is not wha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
2026-10-13 Swap the grub screws to M3 x 8 at no cost
    The M3 x 10 hundred-pack was cancelled — ₩6,000 plus ₩3,000 carriage
    refunded — and M3 x 8 re-ordered at exactly the same ₩6,000 plus ₩3,000.
    #6d stays at ₩31,840, the Shipping row stays at ₩20,100, and the
    projected total and headroom do not move. Only the arrival date slips,
    to the re-order.
    So the cost of sizing the screw against a catalogue rather than against
    the wall was one cancelled order and a few days, because it was caught
    before anything was printed or tightened. The length is not a preference
    and the row now says so: the screw must cross wall plus gap, 7.35 to
    7.85 mm, and anything longer stands proud of the surface the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
2026-10-15 Caliper says 62.7, and that ends four indirect attempts
    Three positions, no spread worth recording. HUB_D 63.0 -> 62.7, HUB_TOL
    0.5 -> 0.2 — carrying the instrument and the vehicle-to-vehicle spread
    and nothing else.
    The history is worth keeping as a table, because the pattern in it is
    the lesson. The wire wrap read 65.25 because its own 2 mm thickness was
    never subtracted. A polygon chord correction then pushed that to 66.0,
    in the wrong direction, for a crest form this hub does not have. A tape
    across opposite crests read 63.0 — right method, coarse instrument. A
    thin paper wrap read 62.0 by chording the six gaps. Every indirect
    method missed, and the direct one was available from the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
2026-10-15 Say which shaft V2 and V3 mean, because "column / kingpin" meant both
    V3 read "column / kingpin shaft diameter" and those are different
    shafts with different answers. ADR B mounts the sensor load-side,
    downstream of the steering gearbox, bonding the magnet to the rotating
    kingpin with the sensor on a chassis-fixed bracket — so both
    measurements belong to the road-wheel axis and neither belongs to the
    hand wheel.
    It matters for V2 more than it looks. The hand wheel on a ride-on may
    turn more than a full revolution while the kingpin turns 50 to 80
    degrees, so measuring the wrong one answers the AS5600 question
    backwards. Method written down: trace the road wheel's centreline on
    paper at ful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
2026-10-15 A second hub reads 62.23, so HUB_TOL was measuring the wrong thing
    The steering gearbox turns out to be the same assembly as the drive
    gearbox, same six-lobe output, and it reads 62.23 against the drive
    hub's 62.70. Two hubs, one vehicle, 0.47 mm apart.
    HUB_TOL 0.2 -> 0.5. The 0.2 was set a few hours earlier on a caliper
    reading three positions of ONE hub, which measures the instrument; the
    variation that matters is between parts and it is twice that. HUB_D
    stays at the larger figure because the bore has to clear the largest hub
    it will meet. The other two vehicles' drive hubs are still unmeasured
    and are what would settle this properly.
    The wide end of the band is the comfortable one: on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
2026-10-16 V2 half-answered: the gearbox hub swings 50-60 degrees, not 340
    Read off four photographs of a paper arrow on the hub against a fixed
    arrow on the housing, so ±10 degrees — which does not matter, because
    the threshold is 340 and the reading is a sixth of it. Range is not the
    constraint at this location. Marked provisional until a protractor says
    so: photo-derived numbers have been wrong three times on this build and
    every one of them read high.
    The held-versus-released pairs turn out to be the more interesting half.
    At one lock the arrow barely moves when the joystick is let go; at the
    other it springs back visibly. That is the first direct evidence of how
    much compliance sits between th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
2026-10-16 No AS5600 on the steering output either: the axis is occupied
    Photographed down the axis with the vehicle on its side. The crank rod
    emerges from the centre of the lobed hub, runs axially a short way and
    bends off to the link, so there is no free end and no clear space in
    front of one.
    That is the third time this gearbox family has refused an end-mounted
    magnet — no rear stub, no free drive output, and now no free steering
    output — and it is the same reason every time. Worth naming as a
    property of the vehicle rather than three separate surprises.
    The mechanism is understood now: gearbox hub drives a crank rod, the
    crank drives one long link bar, and the bar swings a bell-crank at each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
2026-10-16 #5 decided: AS5600 at the kingpin, because the screw head turns
    The mark test settled it. The screw on the kingpin axis turns with the
    road wheel and there is clear space above it — the first free, rotating,
    on-axis end this vehicle has offered after refusing one three times, at
    the motor's rear, at the drive output and at the steering output.
    So this is ADR B's preferred mounting rather than a compromise.
    Load-side at the kingpin means gearbox backlash and linkage slop both
    show up as measured error, which is the whole argument for mounting
    there and the thing a sensor on the steering gearbox output would have
    hidden. The potentiometer stays in the row as the fallback if the mount
    turns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
2026-10-16 Source the AS5600, and the diametric magnet comes with it
    Every AS5600 breakout ships with its own diametrically magnetised disc,
    because the module cannot work without one. So buying the pair together
    is the safest way to get a matched set, rather than picking a magnet off
    a listing and hoping — which is the failure mode #6b had to be warned
    about twice.
    Pick: 쿠팡 9158383428 at ₩2,500 each plus ₩3,000 carriage, five for
    ₩15,500 against an ₩81,000 line. Two reviews and a 97% seller, so bench
    one before building three. Fallback with more reviews: 쿠팡 8459176702,
    ₩34,000 for four, free carriage — same commodity board, the difference
    is margin.
    Three notes recorded against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
2026-10-19 Order the AS5600, and the Hall latches are in hand
    Two procurement events on one day, and one of them closes the longest-running
    open question in the #6 group.
    #5 — ordered. Five PP-A818 AS5600 breakouts, 2,500 each, 12,500 against an
    81,000 line. The estimate funded a sensor plus a separate diametric magnet;
    every breakout ships with one, because the module cannot work without it, so
    that line was paying twice for the same part. Five rather than three buys a
    bench unit before any vehicle is built - the listing has two reviews.
    #6a - arrived 2026-10-17, twenty DRV5013BCELPEM, five days door to door.
    Secured: identity was the failure mode this row carried (AG instead of BC, or
    a DBZ SOT-2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
2026-10-19 Decide the mast, the plate, and the enclosures - and fund the plate
    The four parts of #14 - sensor mast, LiDAR mount, camera mount, controller
    housing - were the last undesigned mechanical subsystem, and all four bolt to
    something that does not exist: the equipment plate that replaces the seat.
    vehicle.md 3 has required that plate since August. No document specified it
    and no budget line funded it. That is the real finding here.
    Decisions, with the reasoning recorded where it will be read:
    Mast 2020 aluminium extrusion, not print. A 0.65 m printed tube
    delaminates under bending and that flex lands in the camera-LiDAR
    extrinsics that 02-mechanical 2.7 already calls loa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
2026-10-19 The cockpit has two surfaces, not one flat deck
    Photographs of the cockpit corrected an assumption 2.7 started with: that
    removing the seat leaves one flat area to bolt everything to. It does not.
    The seat plinth is raised and moulded - the seat is a bucket sitting in
    contour - so a flat plate laid on it would rock on the high spots, and a plate
    that rocks under a 500 mm mast is a plate that works loose. Zone A therefore
    carries the mast on four printed standoffs, each cut to its own height.
    The footwell is the surface nobody had counted. It is flat, it is the lowest
    such surface in the vehicle, and it is load-bearing by design because a child
    stands on it. Every heavy item moves there - t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
2026-10-19 The seat is a lid over the battery bay - so build a better lid
    Jaerock's suggestion, and it beats what I had proposed on both counts.
    Two corrections in one teardown photograph, the second superseding the first.
    2.7 guessed that removing the seat leaves one flat deck, then that it leaves a
    moulded pad needing four individually-measured printed standoffs. Neither.
    Lift the seat and the traction battery and the stock controller are sitting in
    an open bay whose walls finish in a continuous flat rim. The contour belonged
    to the seat pan, not to the vehicle.
    Simpler is obvious - one rectangle, one cut, one measurement, and the
    standoffs disappear because the rim is already one flat plane. The s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
2026-10-19 The mast base is a cross - one rail was floppy sideways
    Jaerock caught this in review, before anything was ordered.
    A single fore-aft rail ties the post to the lid at two points 250 mm apart
    front-to-back. Sideways it ties it to nothing: the post is held only by the
    ~20 mm arms of its corner brackets, which against a 500 mm post is a 25:1
    lever. The mast would have been stiff in one plane and floppy in the other.
    Fix: two 115 mm lateral stubs butted against the rail's sides at mid-length,
    all three coplanar at 20 mm. The post still stands on the rail, and the two
    extra corner brackets land on the stubs' top slots exactly as the fore-aft
    pair land on the rail's. Base becomes 250 x 250, four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
2026-10-19 Two corrections: the cheap profile was an angle, and there are no supports
    Both caught by Jaerock in review, before anything was ordered.
    1. The cheap lengths quoted were the wrong product. One Coupang seller runs
    two listings that both carry DF2020-xxxmm part numbers and both surface in the
    same search: "DF2020 ... 프로파일", the T-slot extrusion, and "앵글 DAB 2020",
    an L-angle. The angle has no T-slot, so no T-nuts, no sliding brackets, no way
    to clamp the boom - unusable. The 1000 mm at 6,460 and the 200 mm at 1,690
    were both angle, and so are 400 and 500.
    Worth recording why this slipped: I did not just misread a row, I built an
    argument on it - the "non-linear price ladder" tha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
2026-10-19 Say why the cut list reads 250 + 115 + 115, not two 250s
    A second review question, and it splits into one thing the figure got wrong
    and one thing it got right but never explained.
    Wrong: the centre panel drew the two lateral stubs as one unbroken bar passing
    the post, so it read as two crossing rails - which, as asked, is physically
    impossible. Redrawn with the butt joints visible and each piece numbered.
    Right but unexplained: 250 + 115 + 115 is the correct list. Two continuous
    20x20 bars cannot occupy the same 20 mm layer where they cross; stacking them
    lifts the post 20 mm and strands the lower pair of brackets below its foot.
    Exactly one direction has to be split. 115 = (250 - 20) / 2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
2026-10-20 Fit check: 250 does not go into 210, and the pillars were oversold
    Measurements came in: bay 370 x 210 x 130 deep, rim to body top 130, seat
    screws 300 apart laterally, spare battery holes 100 apart. Jaerock asked
    whether the lid was too big. The lid is not. The rail is.
    A 250 mm fore-aft rail on a 210 mm bay hangs 20 mm off each edge and its end
    bolts land on nothing. Corrected to rail 210, stubs 140 - a 210 x 300 base.
    The rotation pays twice. The lateral span goes UP from 250 to 300, and at 140
    the stubs put their tie-down bolts exactly on the existing seat screws, so
    that direction needs no new holes at all. The rail's ends then land on the bay
    rim where the lid is supported anyway. Th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
2026-10-20 Design the lid: traced from the opening, not cut to a dimension
    The last two numbers closed it. Seat screws are 300 x 190, four plastic screws
    at the corners. The rim is 10-20 mm and curved - not a rectangle.
    That second fact decides the method. A plywood rectangle cut to 390 x 230
    would bear on the wide parts of a curved rim and bridge the narrow ones, so it
    would rock - which is the one defect this design has been chasing since the
    seat came out. So the outline is traced: tape two A4s into an A3, press the
    rim edge to crease it, trim to about 2 mm clearance, and mark the four screw
    holes with a bradawl while the template is still in place. Never transfer
    those four by measuring; they are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
2026-10-20 Check the cart, and source the plywood as a board rather than a cut
    Cart verified: DF2020-600 x3, DF2020-700 x3, the 200 pc T-nut set, and 24
    brackets. Goods 50,750 and carriage 6,000, which is exactly what this row
    carries. Both profile lines are the "DF2020 ... 프로파일" listing rather than
    the 앵글 DAB one, so yesterday's trap was avoided.
    Plywood: buy a 600 x 1200 x 12 mm board of 무절 birch at 23,060 and cut it.
    Three 400 x 240 blanks use 400 x 720 of it, and the remainder is not waste on
    a sixteen-week course - it is test cuts, enclosure backing, and the lid
    someone ruins. A cut-to-size service was considered and dropped: the outline
    is traced from a template, so a factory rec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
2026-10-20 Finalise the lid at 320 x 215, and find it has only two fixings
    The 370 x 210 included the body's curved raised ends. Excluding those, a plain
    320 x 215 rectangle drops in and covers the opening - so the traced-template
    instruction is withdrawn. This is a rectangle and a saw cut, which is simpler.
    But the simpler shape exposed something the template method would have hidden:
    the vehicle gives only TWO fixings, both on one edge, at (10,25) and (310,25).
    That is half a hold-down. A lid on a rim needs compression on one side and
    tension on the other; the rim supplies compression everywhere, but tension
    needs a fastener and there are two, both at one end. Lean the mast away from
    them and the sc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
2026-10-20 Specify the #4 duty test, and move its gate out of Stage 1
    Asked for #4's torque-measurement method, and the honest answer is that this
    vehicle closed the torque question on 2026-10-01. What still holds #4's
    144,000 is duty cycle, and that gate turned out to have two defects.
    "Released at Stage 1 if it holds a sustained position loop without
    overheating" is not a criterion, and Stage 1 cannot answer the question at
    all. Stage 1 is explicitly bench, motor off the vehicle, where there is no
    tyre scrub - and scrub is nearly all of the steering load on this chassis. A
    motor that passes a thermal test on a bench will still cook in service. The
    same goes for Stage 4 on stands.
    Gate moves to Stag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
2026-10-20 Re-scope #4: the money was buying an option nobody could exercise
    Jaerock asked the right question - on a vehicle rated for 25 kg, is this
    really needed - and added the two facts that settle it: a wiper swap is not
    easy, and neither is opening the steering gearbox.
    Both exits are blocked on this chassis. A different gearmotor means opening a
    sealed gearbox of the family that refused an end-mounted magnet three times,
    and matching a pinion to a 2 mm shaft. The wiper fallback avoids the gearbox
    only by driving the linkage, which means disconnecting the stock gearmotor
    first - breaking 2.1's "no second actuator can fight the first" and 2.8
    reversibility - and its non-back-drivable worm locks t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
2026-10-20 #15 gamepads arrived - twenty-one days, the longest-outstanding line
    Arrived, not secured. The check is in two parts and the second one bites.
    Count three and confirm each pairs: an F710-class pad is wireless on a 2.4 GHz
    dongle, so every unit has a dongle that must stay with it. Bag and label them
    as pairs now - three loose pads and three loose dongles on a bench in week
    three is an afternoon lost.
    Then record the actual button and axis map per unit with ros2 topic echo /joy,
    and check the X/D slider. The F710 class changes its mapping wholesale between
    XInput and DirectInput on a hardware switch, so a pad flipped to the wrong
    mode presents a different axis order and reads as a broken tel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
2026-10-20 #8b E-stop buttons arrived - and the blocks came loose, which changes the check
    Three MRE-RR2R, nineteen days. The body marking is the part ordered, and the
    2 is the whole point: MRE-RR1R is 1a1b and carries only one NC.
    The contact blocks arrived as loose stacked units rather than pre-assembled,
    which turns the verification into an assembly decision. You choose which
    contact sits on which block.
    Put the two NC on different blocks, one each, never both on the same one. The
    two NC contacts are what break the two motor conductors; with both on one
    block a single loose terminal screw or one cracked block takes out both breaks
    at once - a common-cause failure in the one device whose entire job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
2026-10-20 #8a identified, and it is not a separate late shipment
    The DeviceMart dispatch detail answers the question and corrects yesterday's
    reading. KKA-B4 방수 릴레이 12V 40A 4핀 [TYE-RL076], 3 of 3 dispatched, is
    #8a. It is on the same Lotte waybill 317139414550 as the 80A 5-pin x12, which
    is #7's relays. One parcel carries both lines.
    So calling #8a "the oldest outstanding line" was reading two rows where there
    is one shipment. #7's DeviceMart half has been missing for exactly as long and
    for exactly the same reason, and both arrive the moment that waybill lands.
    Worth recording why the mistake was available: a line item is not a parcel,
    and the log's per-line structure hid the shared ship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
2026-10-20 Secure #11b, #8b and #15; the unverified list drops from four to one
    UBEC: 5.11 V from the 12 V LiFePO4 pack, inside the 5.0 +/- 0.15 band and
    inside every load on the rail - Teensy 4.1 VIN takes 3.6-5.5 V. No unit found
    set to 6 V, which was the destructive case this check existed for. A buck
    converter sits slightly high unloaded, so 5.11 no-load is the expected shape.
    Noting honestly that the log carries one figure for six units.
    E-stop: continuity and latching both confirmed. The block-split rule moved to
    03-electrical 3.4, where it will be read. The blocks arrive loose, so which NC
    sits on which block is decided at wiring time, weeks after this check - an
    arrival check cannot verify an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
2026-10-20 Mark #4 as a contingency rather than three unverified units
    It was reading 0/3 and surfacing in the tooling as three units sitting
    unverified on a shelf. That is wrong in both directions: nothing is on order
    and nothing is expected to be.
    Secured becomes "—", the same marker the shipping row already uses for "not a
    per-set item", and the three states are documented as not applying to rows of
    that kind. The tooling skips it instead of nagging.
    The 30,000 estimate stays, deliberately. order_status.py treats an unpriced
    row as a risk because counting a live contingency as zero would quietly
    under-report the projection, and a spare of the stock motor is still the one
    repair this chassis can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
2026-10-20 #6d arrived 10/14-15, all four items
    CA on the 14th; the M3x8 grub screws, the Loctite and the IPA on the 15th,
    which closes the line. Dated to delivery rather than to the day it was written
    down - five days of parts sitting unlogged is how a line gets double-ordered.
    Not secured. Four label checks, and three share one failure shape: the wrong
    item looks identical in the bag.
    Loctite must read 243, blue. 271 is red and permanent, and you do not find out
    until a grub screw will not come out months later. That is the one to check
    first.
    The CA must read 031GC, not 231C. 231C is gel - it will not wick into the
    clearance and sits proud of the sensing track, which is the single fault the
    carri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
2026-10-20 Secure #6d, and explain the grub-screw point form properly
    All four label checks passed: 243 blue, 031GC thin, M3x8, IPA 99.9 percent.
    The point form was the one item on that list that is a design requirement
    rather than a shipping one, and it was carried in a six-word parenthesis. Now
    it has a figure and a reason.
    A set screw is all thread with the socket at one end and the point at the
    other, and the point does the holding. Flat presses only; cup has a sharp rim
    that bites and is the usual default; cone drops into a valley and locates
    itself; dog has a nose that wants a matching hole and is wrong here.
    On a plain round shaft the choice barely matters. This hub is six-lobed, so
    there is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
2026-10-20 Withdraw #6d's secured: the grub screws are flat point, and that is my error
    Three of the four checks stand - 243 blue, 031GC thin, IPA 99.9 percent. The
    fourth does not, and the fault is in the sourcing rather than the delivery.
    This log wrote "cup or cone point" into the spec on 10-12 and then chose a
    listing on the 13th without checking it. The listing says M3 and 8 mm and says
    nothing at all about the point, so a three-part specification got two-thirds
    verified and recorded as done. The screw had three requirements and sourcing
    checked two.
    Why flat is not good enough, from the design rather than from preference: the
    hub is six-lobed, so a flat face either perches on a crest with a sliv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
2026-10-20 Source the cup-point grub screws from MISUMI, sold singly
    The DIN914 set has no M3x8 - caught before ordering. Coupang was the wrong
    shelf for this part, and that is the finding rather than the particular
    listing: every M3x8 set-screw result there is silent on the point form, so
    each one is the same coin-flip that produced flat screws, and the one listing
    that did state DIN914 turned out not to carry the size.
    Taken: MISUMI E-GMSSU3-8, 경제형 무두볼트 오목선단, SUS304/A2-70. Sold 낱개
    from one piece, which ends the quantity problem outright - buy 20 against the
    nine fitted. Same vendor as #8b, so the route is already open.
    Cup rather than cone, because MISUMI's economy line ca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
2026-10-23 Withdraw the valley advice: the screws seat on crests, and flat is fine there
    Jaerock asked whether an M3x8 can actually reach the valley, and said he had
    assumed the screws tighten on the high part. He was right, and the question
    exposed an error I had carried for ten days.
    HUB_D = 62.7 is measured across opposite lobe crests - the SCAD's own fitting
    note says so - so every span figure derived from it is a distance to a CREST.
    SPAN_MAX = 7.85 is wall plus the largest radial gap at a crest. A valley sits
    deeper by the lobe depth, which nobody has measured, so an M3x8 cannot be
    assumed to reach one. I wrote "seat the screws in the lobe valleys" while
    discussing point form, and never checked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
2026-10-23 #5 and #14b arrived; re-derive the base for the 320x215 lid before anything is cut
    AS5600 on 10/22, three days from order - the fastest line on the build.
    Profile, brackets and T-nuts on 10/21, a day early; plywood on 10/23, a day
    late and the one that closes #14b.
    Two checks worth naming. Try a T-nut in the profile's slot before cutting
    anything: the nuts and the profile came from different sellers, and "2020"
    fixes the outside but not the slot width - a nut that does not drop in makes
    every bolt in the mast design homeless, and nothing downstream is recoverable
    once the 600 is cut into three. And confirm the magnet that came with the
    AS5600 is diametric by finding the poles on the rim rat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
2026-10-23 Re-draw the logic side, and fix seven things 3.5 had drifted on
    Consolidated wiring map for the Teensy, receiver, signal MUX, relay MUX and
    E-stop, plus the corrections it exposed.
    Stale or missing:
    The Hall latches are open-drain and need 3.3 V pull-ups. 3.5 never said so,
    and without them the quadrature decoder sees a line that never rises - which
    looks exactly like a dead sensor.
    3.5 still listed "steering motor encoder A/B -> second QDC channel". There is
    no such encoder; the stock gearmotor has none and dbw 2.1 says so.
    3.1 said the angle sensor takes "3.3 V from the logic rail". The logic rail is
    5 V. The 3.3 V comes from the Teensy's own regulator, which is also a budget -
    AS5600,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
2026-10-26 Read the relays off the moulding, and find the pigtail is the real limit
    #7 secured, and the body settles a question three listings could not. Marked
    KKA B8, COIL:12VDC, 70A/14VDC, 40A/28VDC. So it is 70 A - not the 80 A in the
    title, not the 40 A in the shared boilerplate. Neither number on the page was
    right, and it halves at 28 V, which is why one figure was never going to
    settle it. 1.2.4 had parked this as unanswerable from any listing; one
    photograph of the moulding answered it. Read the part, not the page.
    The design is unaffected: 70 A inductive-derated is 35-42 A against the 20 A
    drive-channel limit. Row title, derate table and the purchase request all
    corrected to 70 A.
    #8a secur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
2026-10-26 Magnet measured at 4.04 x 1.63; the T-nuts do not fit the profile
    Magnet: both numbers now in the cap model, which comes out 21.7 x 11.83 with
    the magnet face 3.83 mm above the bolt. The fit changed with the thickness.
    The carrier presses its magnets in at -0.1; this one must not. 1.63 mm of
    neodymium is brittle, and pressing it into an interference pocket is how you
    chip the single magnet the kit supplied. MAG_CLEAR becomes +0.1, a slip fit
    bonded with the same thin CA, which leaves 0.05 mm of radial float against the
    AS5600's +/-0.25 budget - five times the margin, so nothing is given up.
    The thinness sharpens the AGC check rather than softening it. 4 x 1.63 is well
    under AMS's 6 x 2.5 re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
2026-10-26 The end-on photo does not settle the slot, so test by sliding instead
    Saying plainly that I cannot read the geometry reliably from the photograph.
    The "two fore-aft supports" that turned out not to exist came from reading a
    photograph confidently, and the price of repeating that here is a second wrong
    box of nuts.
    The decisive test needs no measurement. Slide a T-nut into the slot from the
    cut end of a piece. A nut that will not rotate in may still slide in and be
    captured by the lips - and this mast never needs a drop-in nut. It is a fixed
    assembly rather than an adjustable rig, so every nut can be loaded from an end
    before its piece is bolted up.
    If it slides, the problem dissolves and t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
2026-10-26 Slot is a standard 6 mm; the nuts are the wrong family, so stop measuring
    The 7.5 was the outer channel between the corner bosses, not the lips. The
    lip-to-lip gap is about 6 mm - an ordinary EU 20-series slot. Taking the
    owner's reading over mine, since I had already said I could not read this
    section reliably from a photograph and saying that and then overriding it
    would be worse than not saying it.
    So the profile is ordinary and the nuts are simply the wrong family. A generic
    set can carry an M5 nut that is a 30- or 40-series M5: same thread, bigger
    body, and any of width, length or thickness can be the dimension that blocks
    it. Working out which costs more than the parts do - 40 won a n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
2026-10-26 Secure #5; and "buy the nuts" was too narrow
    Both of #5's arrival checks are done - the magnet is diametric, poles on the
    rim, and measured at 4.04 x 1.63 with the cap model updated. The AGC tuning is
    not an arrival check and does not belong in that column: it is a bench step
    needing the cap printed and the bracket made. Same distinction already drawn
    for #8b's contact-block arrangement and #15's /joy map. An arrival check asks
    whether the right thing turned up, not whether the system built from it works.
    On the fasteners: an M5 bolt is an M5 bolt in any profile series, so the bolts
    and washers in the failed set are still good and the 13,850 is not all wasted.
    Only the nuts are the wrong fa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
2026-10-26 Drop the spring nuts: slide-in nuts, loaded generously, already do the job
    Checking whether the carriage could be merged exposed that my own
    recommendation was over-built. The two listings are different sellers with
    different couriers, so splitting the order would cost 6,000 of carriage on
    8,000 of goods. That prompted the right question, which was not "can the
    carriage be merged" but "is the spring nut needed at all".
    It is not. A slide-in nut, once in the slot, slides freely along it. The
    adjustability this build bought extrusion for - moving the camera or LiDAR up
    and down - is loosen, slide the bracket with its already-captive nuts,
    re-tighten. No new nut is introduced. A spring nut is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
2026-10-26 Everything is M5x20; the x40 was a geometry error, not a fastener one
    The set tops out at 12 mm and that will not even cross the lid. Length counted
    rather than guessed: penny washer 1.5 + plywood 12 + slot lip 2 + nut
    engagement 2 = 17.5, so x20, with 2.5 mm into a cavity 10 mm deep that cannot
    bottom out.
    The x40 disappeared once the pillar geometry was worked through. The battery's
    spare holes are three per side, so the pillars stand beside the rail rather
    than under it, and the pillar bolt drops from above through the lid into a nut
    captive in the pillar's printed top - 12 + 4 = 16 mm. The 100 mm run I worried
    about only existed because I had drawn the pillars under the rail, where no
    b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
2026-10-26 Write out the fastener schedule; the brackets never touch the plywood
    The question kept coming back in pieces - nuts, then bolts, then bracket
    bolts - because the two joints were never separated on paper. They are
    different joints with different fasteners.
    The AL brackets join profile to profile. The profile bolts to the lid
    directly, through a T-nut in its own bottom slot. Nothing brackets the
    profile to the plywood.
    Per vehicle: 16 x M5x10 for the eight brackets at two bolts each, 6 x M5x20
    for the four lid tie-downs from below and the two pillar bolts from above, and
    20 T-nuts in slots.
    The x10s come out of the set already bought - its M5 bolts were never the
    problem, only its nuts - s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
2026-10-26 Record the two declines as accepted risks; source the washers; fix my own count
    UBEC spares and the 5 A fuse top-up both declined. Kept at 0 rather than
    deleted, because a line that vanishes is a line nobody can learn from. What is
    being accepted is written out: six UBECs with zero spares on the one component
    a student sets by hand, and two spare fuses for three vehicles and thirteen
    students across a semester. If either bites, those rows are where to say so,
    and the next cohort reads the outcome rather than the intention.
    Nuts and bolts ordered. The charge is not in the Paid figure yet - it goes in
    from the receipt rather than from what was quoted, which is how the VAT trap
    was caught twic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
2026-10-26 Record the 15,860 from the receipt; the #14 line is now spent
    Bolts 8,860 free-shipped, square nuts 4,000 plus 3,000 carriage, total 15,860
    at the till and it reconciles. Goods 12,860 into #141, carriage into the
    shipping row. paid = unit x qty lands exactly.
    Worth saying out loud: 35,600 on #14 plus 86,670 on #14b is 122,270 against
    123,000 approved - 730 left. The penny washers at about 7,100 take it 6,370
    over, which needs no approval because only the total binds, but it does mean
    this line stops absorbing surprises. Anything further on mounts now comes out
    of the headroom visibly rather than out of a line that looked like it still
    had room.
    Also fixed a date I had just broken: setting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
2026-10-26 Penny washers ordered - and the #14 line goes over, where it said it would
    Four packs of ten M5 x 18 x 1T stainless, 3,600. Forty against the twenty the
    fleet needs. Carriage not in the row yet: the listing shows 3,500 as
    conditional free shipping and 3,600 of goods probably does not clear the
    threshold, so confirm the till figure rather than assume either way.
    This is the purchase that tips the #14 line over, exactly as the previous
    entry predicted. 35,600 plus 90,270 is 125,870 against 123,000 approved -
    2,870 over before carriage.
    Recorded plainly, because the useful thing is not that it went over - only the
    total binds - but that it went over where and when the entry before said it
    wou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
2026-10-26 Source #12b as a single DeviceMart order
    The structural recommendation matters more than any one part number: six
    Coupang sellers would be six carriages on 50,000 of goods, while DeviceMart
    carries every line and #6a already proved the route at 2,700 with no fees.
    Confirmed on their shelf: 거상인 [GA2] 80x80 double-sided at 4,300 for the
    signal board - a Teensy 4.1 is 61 mm long, so 50x80 is tight once terminals
    are on - and [GA6] 50x80 at 3,500 for the relay driver, which carries one
    MOSFET, two resistors and four diodes. Four of each, because a perfboard is
    the part a student ruins.
    Terminal blocks: EM Tech 2EDGK+2EDGRC-5.08, 2-pin 600 and 3-pin 900, sold in
    tens. These are pluggable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
2026-10-27 Answer the three #12b questions; review the quote; UBEC spares reversed
    Quote reviewed at 111,080 incl VAT. Boards, terminals and breadboards all
    correct; the three missing lines are exactly the three open questions.
    Teensy sockets: CONNFLY 핀헤더소켓 Single 1x40 Straight 2.54mm at 530. A
    Teensy 4.1 is 24 pins a side, so one strip cuts a row with 16 to spare - two
    per Teensy, eight for the fleet. Not the 적층형 at 1,000: its 9.1 mm legs are
    for stacking shields and only raise the board in the box.
    Heatshrink: the sizing question was right and it decides the SKU. The #8a
    splice joins 0.75 mm2 at about 2.5 mm OD to AWG 14 silicone at about 4 mm, so
    the tube must shrink from 6 mm or m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
2026-10-27 Recount the terminal blocks, and get the breadboard framing right
    My "~8 per vehicle" for terminal blocks was a guess and it was low, and the
    mix was wrong as well. Counting ways rather than blocks: signal board 5 x
    2-pin - two 4-wire sensor cables at two blocks each, plus 5 V in - and relay
    board 6 x 2-pin for gate, 12 V and a pair to each of four coils. Eleven
    2-pin per vehicle, 33 for the fleet.
    And the 3-pin is the less useful of the two, which is the opposite of what the
    first estimate assumed. Both sensor cables carry four conductors and four does
    not fit a 3-way, so they take two 2-pins each. The runs that genuinely carry
    three wires - PWM out and i-BUS - are servo connectors and bel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
2026-10-27 Check quote v2, and draw the bench breadboard layout
    Quote reconciles exactly: goods 130,471 plus 4,000 carriage ex-VAT gives
    134,471, VAT 13,447, total 147,919, with a won of rounding on the UBEC line.
    Every requested change is in. 핀헤더소켓 at 18 is more than twice the eight
    the Teensys need; left alone, since the surplus socket the AS5600 breakouts
    and the Pololu MUX so a dead module swaps without an iron.
    One possible gap: male pin headers. The quote has female sockets only, and a
    Teensy 4.1 normally ships with its pins not soldered - without male pins it
    cannot go into a breadboard or into the perfboard sockets this order is
    buying, and the sockets would have nothing to receive.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
2026-10-27 Fix the breadboard figure: the rail bridges were missing
    Jaerock caught a real error. A breadboard's upper and lower rail pairs are
    separate strips. The Teensy's 3V3 and GND pins are on its lower edge and feed
    only the lower rails, but the 10k pull-ups sit in the upper half and reach for
    the upper + rail - which had no source at all. As drawn, the pull-ups did
    nothing, and a floating open-drain output reads exactly like a dead sensor:
    the very failure they exist to prevent. Two bridge jumpers fix it, and they
    now have their own callout.
    Three other fixes from the same review. Text blocks moved out of the wire
    paths, with crossings drawn as gaps so "passes over" and "lands in" are
    distinguis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
2026-10-27 Redraw the breadboard figure to a real 400-point board, and fix four overlaps
    Hole count checked against what was ordered: SZH-BBAD-005 is 30 columns by
    10 rows plus four 25-hole rails = 400 tie points. The figure was drawn with 33
    columns and 8 rows, so it is regenerated at the real geometry. Rows A-E go
    unused, which is normal - a half-size board has far more holes than this needs.
    Four overlap fixes, all from review. The figure is now built in strict layers -
    boards, then chips, then components, then wires, then labels - so nothing hides
    a wire. The "2 x 1 nF" label moved clear of the green jumper. Jumpers carry
    their own identity labels at both ends, so "pin 0 to Hall A OUT" is readable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
2026-10-27 Restore the explanation panels, fix the leg numbers, keep the generator
    Two fair corrections.
    The DRV leg numbers were low-contrast slate against the figure. They are now
    white discs with a dark outline and dark digits, with VCC/GND/OUT spelled out
    beneath - the one thing on this board that destroys a part if read wrong
    should not be the hardest thing to read.
    And I dropped the four explanation panels in the regeneration without saying
    so and without a reason - it was scope drift, not a decision. Restored:
    board/AS5600 counts, what the VUSB cut does to USB, the five-step bring-up
    order, and the pre-wiring cautions.
    Also keeping the generator as scripts/gen_breadboard_figure.py rather than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
2026-10-27 Source the 100 nF, and say which basket wins
    DeviceMart's search stopped returning results this session, so these are
    Coupang. Pick: 모아프라자 0.1uF 50V, 20 for 1,000 plus 3,500 carriage, seller
    97 percent. Six are fitted, one per Hall latch; take 20 and the rest become
    lab stock, since 100 nF is the most-used value in any build.
    Alternative if nothing else is being ordered: 아즈토, 10 for 6,700 free
    shipped. Six times the unit price but it ships free, which against a 3,500
    carriage makes it the cheaper basket when it is the only line. Which wins is
    decided by whether anything else is in the cart, not by per-piece price.
    Specify 0.1uF / 50V / 104 and nothing further. Tolerance, di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
2026-10-27 Explain the three capacitor roles - only one is about the signal
    Asked whether these capacitors are for signal stability. Partly, and the
    distinction is worth drawing because it decides where they are soldered.
    A capacitor is always the same thing, a low-impedance path for fast changes.
    What it does is decided by what you put it across, and this build uses three.
    1000 uF across the whole logic rail, as a reservoir for the box. 100 nF across
    one sensor's own supply, because a metre of wire cannot deliver a switching
    surge fast enough and the latch's own rail dips. 1 nF across one signal line,
    because a motor-edge spike on a 10k node is counted as an edge by the decoder.
    Only the 1 nF touche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
2026-10-27 Draw the power wiring and the RC/MUX path - and correct the E-stop premise
    Two figures. Power: traction pack through a 25 A fuse, the E-stop contactor
    and the four-pole relay MUX to either stock ECU or driver; logic pack through
    a 5 A fuse to two UBECs and a coil tap; and the single star ground where the
    rails meet, with the test that proves it - traction+ to logic+ open, traction-
    to logic- short.
    RC path: the receiver does three jobs at once, which is the thing people miss.
    i-BUS to the Teensy for the closed-loop override, CH1/CH2 to the signal MUX
    slave inputs for the raw-effort emergency path, and CH5 to SEL to choose
    between them in hardware. The Teensy's PWM pair drives the master inp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
2026-10-28 Adopt the E-stop sense wire - and replace yesterday's scheme with a better one
    Asked why the firmware needs to know. Checking rather than defending my own
    proposal turned up that the design has required it since dbw.md 10.3 was
    written: E-stop is a transition into ESTOP and "E-stop released + RC arm" is
    the only way out. Both need the firmware to know, and no wire was ever
    specified. Two arcs of a published state machine were unimplementable and
    nobody had noticed. So it was never a nice-to-have diagnostic.
    The concrete failure: both coils run through the button's NC contacts, so
    turning it to reset re-energises both at once. The Teensy never noticed - it
    has been closing a loop against a s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
2026-10-28 Draw the relay-driver board; fix the E-stop divider that was never drawn
    The 10k was not hard to see - it was never there. My patch to the generator
    silently failed its assert and I shipped the labels and the callout without
    the components, so the figure described a divider it did not draw. Checking
    the generated output rather than the exit code would have caught it.
    Rebuilt: both resistors now sit entirely in the free bottom rows, so nothing
    is drawn over the dark Teensy body. 10k horizontal into pin 14's column, 2.7k
    from that column down to the GND rail, pin 14 labelled at the junction, and
    the explanation moved to its own panel below the rail-bridge note rather than
    on top of it.
    Relay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
2026-10-28 Move the sense divider clear of the jumpers; sense pin becomes 20
    Three fixes, and the middle question was the useful one.
    The divider wiring was not right. The 10k sat at row I in columns 16-19, and
    the pin-19 green jumper runs along that same row from column 12 all the way to
    x=795 - so the resistor and the jumper were drawn on top of each other, which
    reads as a connection that is not there. Moved the whole divider to columns
    6-9, left of where the jumpers originate, so nothing crosses it at all.
    That also let the pin numbering become physically honest. A real Teensy 4.1
    reads Vin, GND, 3V3, 23, 22, 21, 20, 19, 18 down that edge, so the sense input
    is pin 20 and it sits left of 19 and 1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
2026-10-28 Assign the four MUX relays; close a cross-reference that pointed at nothing
    K1-K4 appeared in exactly one SVG and nowhere in prose. Nothing said which
    relay carried which motor lead, so twelve relays across three vehicles had a
    count and no assignment.
    order-log.md justified two arrival checks with "§3.4 wires by those numbers",
    referring to the moulded 30/87/87a/85/86. §3.4 contained none of them. The
    check was real; the page it fed could not consume the result.
    §3.4 now has the contact table: K1/K2 = steering tap leads A/B, K3/K4 =
    throttle tap leads A/B, keyed to the moulded pin numbers, with the coil
    convention (86 = feed, 85 = drain) fixed across all twelve so no 1N4007 ends
    up rev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
2026-10-28 Put the relay MUX back in the motor leads, where four poles make sense
    power-wiring.svg drew the traction pack through the contactor, through the
    MUX, and out to either the stock ECU or MDDS30 B+ — while carrying a box of
    its own reading "the MUX breaks both motor conductors, which is why four
    poles and not two." The figure contradicted itself. §3.1's rail diagram,
    §3.2's gauge table and §3.2's branch sketch all stated the same wrong chain.
    The pole count settles it. Switching a supply needs one pole; switching two
    motor circuits at both ends needs four, which is what #7 bought and what
    dbw.md §11.5 specifies: the throttle and steering taps intercept motor leads,
    and the power tap sep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
2026-10-28 Add the two missing sheet rows; stop three citations pointing at nothing
    D2 and D3 were on every pending list and on no sheet. D3 is worse than an
    omission: 02-mechanical's cut table gates the plywood cut on "V4 D3", and the
    lid's 320x215 is derived from a 370x210 pass that included the body's curved
    raised ends. The one dimension that cannot be recovered by sanding was gated
    on a row that did not exist.
    Three more citations named IDs the sheet does not use. "V4 S" for the LiDAR
    and camera mounts points at the STEERING rows - the sensor bodies are L1-L3
    and C1-C3. Fixed to the IDs actually printed, and the checklist now says so,
    because S1/S2 vs L/C is exactly the collision that produced th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
2026-11-04 Third hub reading, 62.82, is above the figure that was meant to be the largest
    Measured with the gearbox out of the vehicle, which is the cleanest access
    anyone has had to the hub. The model's own rule is "HUB_D stays at the larger
    figure, because the bore has to clear the largest hub it will meet" - and the
    rule was being broken by its own data, by 0.12 mm.
    HUB_D 62.7 -> 62.82, HUB_TOL 0.5 -> 0.6 so 62.23 stays covered. Three readings
    now: 62.23, 62.7, 62.82, spread 0.59.
    Nothing reprints. Bore 63.90 -> 64.02 and the O64.2 ring already printed clears
    both; every assert still passes. What it costs is screw margin, and that is now
    the number worth naming: SET_SCREW_L >= WALL + (BORE_CLEAR +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
2026-11-04 Six receipts: #12b and #11b-spares arrive, and the plywood was never 착불
    #141's four receipts reconcile to exactly ₩90,270 goods — mast 52,290 less
    1,540 discount, plywood 23,060, penny washers 3,600, bolts and T-nuts 12,860.
    Four orders, two sellers, three weeks apart, nothing drifted. The devicemart
    invoice splits 124,399 / 23,519 / 4,400 to the won as projected.
    The plywood receipt shows ₩0 carriage. The Shipping row has said "the plywood
    is 착불 and is NOT in this figure yet" since 2026-10-20, against an order that
    had no freight on it. Kept the limit of that proof in the row: 착불 is
    collected at the door and never reaches a Coupang receipt, so this shows the
    order was fre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
2026-11-05 Thirty pieces, not thirty packs — and the table beside the figure said 11
    The terminal-block count has been an open question since the quote: the
    invoice read 2-pin 수량 30 and 3-pin 수량 10, and the listing sells 10개 단위,
    so 30 was either thirty pieces (40 ways against 36 needed) or thirty packs
    (300). Counted in the bag: pieces. The fleet is not short.
    The margin has a shape the fleet number hides. All 30 of the 2-pin are
    consumed by the 36 ways, so the last six take 3-pin blocks with one way
    unused -- which leaves four spares and every one of them is a 3-pin. A 2-pin
    cracked at assembly is replaced by something 5.08 mm wider in a footprint
    drawn for a 2-pin, on a 50 x 80 board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
2026-11-05 Two pages disagreed about whether the pulldown may sit in a spring clip
    01-bom-sourcing section 1.2.4 said a breadboard was "genuinely useful at Stage
    0, on the bench, to prove the driver switches from a 3.3 V pin before anything
    is soldered." Before anything is soldered puts the 10k gate pulldown in a
    spring clip. That contradicted the two bullets directly above it in the same
    warning box, and contradicted 03-electrical section 3.5.3, which says the coil
    current and the gate pulldown must "never carry, even on the bench."
    So the two build pages disagreed about the one component the whole failsafe
    analysis rests on, and a student following 1.2.4 would have breadboarded it.
    Section 3.5.3 is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
2026-11-05 Draw where the relay-driver board's parts sit, and fix the two wires it exposed
    Yes to both questions. The MOSFET is a low-side switch, so its source IS the
    board ground, and the pulldown only holds the gate low relative to that source
    -- which means the Teensy's 3.3 V is meaningless unless it shares the node.
    And yes, the whole board is soldered perfboard; it is the one board the project
    forbids breadboarding, so the first physical build is also the final one.
    But the ground must not be a second WIRE. The relay board's ground already
    returns to the star on its 12 V terminal carrying the whole 600 mA of coil
    current, so a second ground conductor up to the Teensy is a parallel path -- a
    loop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
2026-11-05 The hole count was right and said nothing about where a lead can go
    Counted on the square GA2 80 x 80 from the same order: 31 x 31 holes, of
    which a one-hole border on each edge is not usable - 29 x 29 remain. So
    80 / 2.54 -> 31 was right about the HOLES and silent about the WORKING
    area, which is the number a layout actually needs. The GA6 shares the
    80 mm side, so the relay board is 31 x 19 holes and 29 x 17 usable.
    The layout was already inside that ring, so nothing moved. What moved is
    the check: inside() now tests the usable ring rather than the board, and
    a lead one hole into the border fails the generator instead of failing on
    the bench, where the bus that has to reach it runs off th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
2026-11-05 The 50 mm side is 18 holes, and the row budget is now exactly spent
    Counted on a GA6 rather than derived: 50 / 2.54 = 19.7 rounded to 19 and
    the board has 18. The 80 mm side was right at 31, so the error is not in
    the arithmetic but in the assumption behind it - that one margin applies
    to both axes. It does not:
    width (80 - 30 x 2.54) / 2 = 1.9 mm
    height (50 - 17 x 2.54) / 2 = 3.4 mm
    Grid 31 x 18, usable 29 x 16 after the border ring. The layout fits with
    nothing moved - but rows 2..17 is now sixteen rows into sixteen, so the
    GND bus sits on the LAST usable row. Nothing goes below it, and a later
    edit wanting a row takes one back from the spacing above. Columns are not
    tight: 28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
2026-11-05 The corner holes were already drilled, and I derived them instead of looking
    A photograph of the boards in hand shows four plated corner mounting holes
    in the blank margin outside the pad array, on both the GA2 and the GA6.
    Nothing is drilled and no pad is spent.
    The previous revision reasoned from a 1.9 mm margin that a corner M3 could
    not fit and that a screw would cost a usable hole. Both are wrong. It was
    deriving the geometry of a part sitting on the bench, with the same
    arithmetic that had just been caught out by one on the row count.
    Figure now draws the four corner holes. The panel says where they are
    instead of what cannot be done with them.
    Still open, and the photograph does no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
2026-11-05 The grid is 29 x 18 counted, and the pads never reached the edge
    Counted end to end, edge holes included. Divide-by-pitch was over by two
    on the long side and by one on the short, for one reason: it assumes the
    pads run to the board edge. They do not. The array sits inside a blank
    margin the arithmetic had no way to know about.
    width (80 - 28 x 2.54) / 2 = 4.4 mm
    Those margins are also why the four plated corner holes fit where they
    do - a 3.2 mm hole needs about that much blank FR-4, and the board I had
    derived, with pads to within 1.9 mm of the edge, could not have carried
    one. The photograph and the hole count agree. Every derived version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
2026-11-05 The pulldown was on the wrong side of the 100 ohm in the schematic
    The two figures disagreed. relay-driver-board.svg tapped the 10k on the
    Teensy side of the gate resistor; the placement figure has always had it
    on the MOSFET side. The schematic was wrong, and it contradicted its own
    build order: step 1 says "pulldown, gate to GND, first, alone" and step 2
    meters gate-to-GND before the 100 ohm is fitted at all. Neither describes
    a resistor hanging off the terminal.
    It is not cosmetic. On the Teensy side the pulldown stops holding the
    gate the moment anything between it and the gate opens - a cracked 100
    ohm joint, a lifted pad - and it does so silently, because the resistor
    is still fitted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
2026-11-05 The same sentence was in three figures; I had fixed one
    Sweeping for it found the stale justification in the perfboard placement
    figure's build-order panel and in perfboard-transfer.svg, as well as the
    schematic I corrected. Three figures and two pages carried one claim,
    which is the defect this project keeps meeting from the other side.
    All now say what the measurement is for: the two joints and the two
    holes, not the resistor, since a meter could check the part in your hand.
    The perfboard panel also names the pads to probe - R1's upper pad to the
    GND bus - because at step 2 the gate hole is still empty and "gate-to-GND"
    is not yet a thing you can touch.
    Panels and boxes grew to fit; both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
2026-11-05 Two panel entries overlapped by four pixels, and my renderer hid it
    Growing step 2 to three lines pushed its last line to y=828 against step
    3 at y=832. The user saw it immediately; I had rendered the figure three
    times and not seen it, because ImageMagick draws a <text> containing
    <tspan> by resetting x, so every bold line piles onto the start of itself
    and the whole box is mush either way.
    Switched to headless Chrome for text layout and the problems came out at
    once:
    - step 2 overran into step 3 (fixed, now two continuation lines)
    - its second line ran past the box's right edge (rewrapped)
    - the "Solder this one FIRST" callout, which I had moved and grown two
    commits ago, was sitting a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
2026-11-05 The bench figure had the Teensy mirrored: a bottom view drawn as a top view
    breadboard-layout.svg put GND/0/1 on the upper row and VIN/GND/3V3/20/19/18
    on the lower, with USB at the left. That combination cannot happen. With
    USB to the left the pinout card rotates counter-clockwise, which puts the
    Vin edge on top - which is what the board in hand does and what the new
    signal-board figure shows.
    Anyone wiring board A from it would have put every component on the wrong
    side of the Teensy, and the first symptom would have been two dead
    quadrature channels: exactly what a dead sensor looks like, the failure
    that section already warns about twice.
    It survived because it was internally consisten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
2026-11-05 The servo headers' middle pad is open on purpose, and now the figure says so
    Three questions about one box, and the third turned up a gap.
    The middle pad is the servo connector's +5. It is left unconnected
    because this board is on UBEC A and the receiver, MUX and driver logic
    are on UBEC B. Joining them would undo the authority split that is the
    entire reason there are two UBECs - the one that lets a UBEC A failure
    leave the override path alive. Signal and ground land; +5 does not. Drawn
    hollow and marked n/c.
    Pins 2 and 3 do go to the MUX, but to its two MASTER inputs, and the
    MUX's outputs drive S1 and S2. The Teensy never reaches the driver
    directly, which is what makes the RC override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
2026-11-05 R5 was drawn in the ground colour and labelled with a question mark
    Two ways the same part lied about itself.
    The stubs - the short bare-wire runs soldered onto a pin's pad - were all
    drawn in the GND slate, the same stroke as the ground bus and the ground
    spine. So the i-BUS divider node under R5 read as grounded, which is the
    exact opposite of what a stub is: it IS the pin's own net. Each stub now
    takes the colour of the net it carries, blue for the drive pair, teal for
    I2C, crimson for the i-BUS node.
    And "link?" said "I do not know what this is" when the intended meaning
    was "this one is decided by a measurement". R5 is now "series", R6 is "to
    GND", and the condition moved to a callout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
2026-11-05 The ground leg was the first branch out of the node, so the eye took it
    R5's node had the signal leaving at the bottom of the stub and R6
    branching to the ground spine above it. Coming down out of R5 you met
    R6's bold run to a thick dark spine before you met the faint dashed line
    to pin 15, so the node still read as grounded even after the stub stopped
    being drawn in the ground colour.
    Swapped: the signal leaves at the first junction under R5 and the ground
    leg sits below it. The reverse-side wiring also went from 0.5 to 0.62
    opacity - faint enough to read as "behind the board" was also faint
    enough to lose a signal path - and the wire now carries its destination,
    "-> pin 15", because a das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
2026-11-05 The pack label closed one switch and opened a bigger question
    Aroma 6-FM-4.5, 4.5 Ah sealed lead-acid, NON-SPILLABLE, Pb. No document
    in this repo had recorded the traction pack's chemistry or its capacity.
    SW7:SW8 = 10 (SLA), so the DIP map is five off, three on with nothing
    left to decide.
    But the monitor only warns. The manual is explicit: on under-voltage the
    error LED blinks three times and "the power to the motor will be
    maintained and will not be cut out". Nothing on this vehicle protects the
    traction pack from being flattened, and deep discharge is what kills a
    lead-acid pack. That is a person's job and it is now written down instead
    of assumed.
    The same reading found a claim the c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
2026-11-05 "E-stop contactor" was one name for two parts, and 3.4 merged them
    Asked which part the phrase meant, the answer is #8a, a KKA-B4 40 A
    4-pin waterproof relay. But 3.4 opened with "a latching mushroom-head
    contactor, hardwired in the traction power path", which describes one
    object and puts the BUTTON where the relay goes.
    The button is #8b, a MISUMI MRE-RR2R, and it carries coil current only.
    Its two NC contacts break the contactor coil and the relay MUX coils; the
    relay's contact is what interrupts the pack. The order log already warned
    that a signal-rated mushroom asked to switch traction will weld shut, and
    fails in exactly the moment it exists for - so the build page and the log
    disagre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
2026-11-05 One relay drawn in two sections, and nothing said they were the same part
    The power figure has #8a's contact in the traction row and #8a's coil in
    the logic section. That is correct and it is the whole point - the
    contact lives on one rail and the coil on the other - but neither box
    said which half it was, so the two read as two devices. Both now say so,
    and 3.4 carries the six connections explicitly, since "where do the wires
    actually go" was the question behind it:
    pack + -> 25 A fuse -> 30 ; 87 -> tee -> stock ECU + and driver B+
    pack - -> star ground, never switched
    12 V DIRECT -> button NC 1 -> 85 ; 86 -> logic GND, the same star
    With a note to check 85/86 on the body before a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
2026-11-05 Nothing in the log buys the joint that carries the whole 25 A
    Asked how the tee after #8a's 87 is actually made, the answer needed a
    part no line procures: a small brass bus bar or power distribution block,
    one stud in and two studs out. Same shape as the terminal blocks and the
    Hall bypass caps before it - a part specified by the wiring and procured
    by nothing.
    A three-wire butt crimp works and can never be inspected again, which is
    the wrong trade for the one joint every amp passes through. Piggyback
    spades stacked on the socket's 87 are worse: the stack is the weak point
    and it is carrying everything.
    Method written into 3.4, with two constraints that are not obvious. The
    tee goes at th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
2026-11-05 Sourced the tee, and the obvious search result was the wrong class
    Every search for "power distribution block" returns car-audio splitters:
    0-gauge input, 60 to 150 A. Forcing AWG 14 into one of those makes a
    worse joint than the bare crimp it was meant to replace, so the result
    that looks right is the one to reject.
    The right class is a fixed barrier terminal block, 30 A, M4 - it takes an
    AWG 14 ring terminal and clears the 25 A fuse by 20%. Two on the shelf
    at the route this project has already proved:
    JOTB 30-4P, devicemart 12504697 - 600 V / 30 A / M4 / 12.8 mm / 4-pin,
    2,200 won. Four poles gives the tee plus spares.
    Terminal block 30A 3P, 12501177 - 600 V / 30 A / M4 / AWG 10-1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
2026-11-06 Which row of the steering socket is fitted, and which wire is on minus
    Vehicle #1 populates the M3 row: brown on M3-, blue on M3+. The M2 row is empty.
    That is the whole of the previous entry's open question, and it also fixes the
    reference frame - the mapping only means something read against the silkscreen
    with the four-way housing on the left and M1, P1 to its right, which is not the
    orientation the module sits in on the car.
    The "mark the cavities" instruction stays, and now says to do it on every vehicle.
    A factory that populated M3 on this chassis had no reason to do the same on the
    next two, and the plug carries no mark either way.
    The record sheet gains the row explicitly, and the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
2026-11-06 The steering plug is a plain 2-position, and I called it 2x2 twice
    Measured on vehicle #1: steering 2 positions, 8.35 mm across; drive 4 positions,
    16.19 mm. The difference is 7.84 mm, exactly two positions at 3.96 mm pitch, so
    both are one family - the 2-way and 4-way of a VH-style series. JST's own VHR-2N
    and VHR-4N are 7.86 and 15.78, a consistent 0.4 mm under, so this is a clone or
    the calipers are over the side ribs. The pitch identifies it; the width does not.
    So the previous two entries were wrong about the steering housing. It is not a
    2x2 four-way with two cavities empty - that was a blurry photograph read as two
    rows. What survives is the board-side half of it: the footprint there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
2026-11-06 Flat blades, two of them, keyed ninety degrees - not a four-way pin housing
    Opened on vehicle #1: the drive connector has TWO contacts, not four, and they
    are flat blades rather than crimp pins - folded sheet metal wiping onto a tab
    moulded into the module's shroud, with the two tabs turned ninety degrees from
    each other. 16.19 mm is the width of a two-position blade housing, not four
    positions at 3.96 mm. The pitch arithmetic in the last entry was arithmetic on
    an assumption.
    That restores what the entry before it said and the last one undid: four wires
    on two contacts means two crimped onto each blade, so the paralleling is inside
    the plug, not bridged on the board. The correction matters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
2026-11-06 The power figure drew four relays in the motor leads and never drew a connector
    So it could not answer what a builder in front of the vehicle actually asks:
    which half do I buy, and which end does it go on. The answer is backwards from
    the name. The stock module presents male tabs, so MRider's half facing it is a
    female receptacle; the vehicle's own plug is female, so MRider's half facing
    THAT is a male tab. Both halves of every tap are the opposite gender to the
    thing they are named after, and ordering off a sentence gets twelve wrong parts.
    New generated figure, one row per motor conductor, with the counts on it: four
    female and four male a vehicle, twelve and twelve for three.
    The gener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
2026-11-06 "Tab width x thickness" names two numbers and defines neither
    The record sheet asks for both and the sourcing note turns on them, and neither
    says which dimension is which - so thirteen students reach the same question at
    the same row. A tab is one flat piece of metal and its cross-section is the
    whole specification: width is the long side of that cross-section, thickness is
    the sheet's own thickness, and the protruding length is not part of the
    designation at all. The inch names - .110, .187, .250 - give the width only,
    which is why a part is quoted as 6.3 x 0.8.
    Where to measure is its own problem, since the module's tabs sit inside a
    moulded shroud that calipers cannot reach. The female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
2026-11-06 The two taps are not the same kind of connector, and asking a pin for its thickness gets no answer
    The steering contacts are pins, not blades. So the page was asking for a
    dimension that does not exist on that half: width x thickness specifies a flat
    tab, while a pin-and-socket family is specified by pitch. Both taps had been
    written up as blades since the drive one was opened, and the steering spec row
    inherited the wrong two numbers.
    Pitch measured about 2.8 mm, which is not a standard value, so the row now asks
    for it to be resolved to 2.50, 2.54 or 3.00 - and says to take it across the
    module's header pins rather than the plug's cavities, because solid metal
    measures and moulded walls d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
2026-11-06 3.0 mm pitch, and the steering tap's rating now gates a bench row that had no criterion
    Measured off the socket's cavity centres, since the header pins sit too deep for
    calipers to reach. 3.0 mm single row is Molex Micro-Fit 3.0 - 43645 housing,
    43030 terminals, 43650 header - and the clones of it.
    That number carries a warning with it. Micro-Fit 3.0 is rated around 5 A a
    circuit, and the steering motor stalls at its end-stops as a matter of course,
    with the position loop holding it there. 06-bench-test already asks for the
    steering stall current and, unlike the drive row beside it, gave no number to
    pass. It has one now: whatever the tap can carry. The factory's own connector is
    evidence t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
2026-11-06 Searching the right words for the tee lands on the wrong class twice
    The last entry recorded one of these: "power distribution block" returns
    car-audio splitters built for 0-gauge, and the page already says not to buy a
    grounding busbar. The Korean search lands somewhere else and just as wrong -
    category "T형" is entirely 무탈피 분기 커넥터, insulation-displacement T-taps.
    They are the shape of the job and the wrong class of joint. They are sold by
    wire size with no current rating stated anywhere on the listing, the contact is
    a thin blade on a pierced strand under vehicle vibration, and the pierce itself
    is a water path into the copper. That ranks below the piggyback spades this s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
2026-11-06 The steering tap's male half is not a PCB header, and one test settles both
    Following the cross-reference printed on the terminal's own listing, rather
    than reasoning about what a pin family must look like, found all four parts in
    devicemart's Micro-Fit 3.0 category and dissolved the problem these pages had
    been carrying:
    43645-0200 + 43030-0001 towards the module (87a)
    43640-0200 + 43031-0001 towards the vehicle (30)
    `43640` is a crimp housing for male terminals. Both halves crimp and plug;
    nothing is soldered to a fragment of #12b perfboard. 01 and 02 both claimed
    otherwise and now say so in place.
    The listings' own cross-references also re-confirm the identification: 4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
2026-11-07 A part number nobody can find is not sourced, it is just written down
    Found by being asked "which section?" and having to answer "line 2076, inside
    a blockquote under #### #12, in a 2,200-line file." That is the same defect
    this session has been fixing all day: a claim that cannot be found is not
    checkable. The goods numbers were in the build guide's rationale prose.
    The project already had a convention and I did not follow it. #113 puts the
    SKU in the Vendor column; #12b records the exact shelf part it bought. Vendor
    SKUs live on the ORDER LINE that buys them. So:
    - order-log #12c, Micro-Fit 3.0 tap connectors, all four parts with prices and
    devicemart links, W11,350 for three vehicles.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
2026-11-07 A warning that asks you to measure the wrong wire, and a search that failed on vocabulary
    Two corrections, both found by a cart screenshot.
    1. The AWG 20-24 note told the builder to measure the steering conductor before
    ordering, in case 0.75 mm^2 would not fit the barrel. The premise is wrong,
    and the figure this repo already draws says so: the module-facing half is
    crimped onto the wire running to 87a, the vehicle-facing half onto the wire
    from 30. Both bought terminals carry MRider's OWN wire. Nothing stock is
    cut, so no stock conductor ever enters a bought barrel and the stock gauge
    cannot make the order wrong. What AWG 20-24 actually fixes is MRider's tap
    wire, whi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
2026-11-07 A map that lists P1 beside the two taps, and says nothing, is an invitation
    Asked where to measure the power tap, and found the connector map answers
    "P1" by implication. It must not.
    The power tap goes at the battery pack in the trunk, UPSTREAM of the stock
    10 A auto-resetting thermal breaker. P1 is downstream of it. Tapping at P1
    puts a device that re-closes by itself inside the DBW traction path: traction
    returns unannounced, minutes after a thermal trip, with no operator action.
    3.3 already forbids this and the failsafe matrix has no row for it -- but
    2.2's table lists P1 beside M1 and M2M3 with an em-dash and no comment, so
    the two pages each held half of the warning and a builder read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
2026-11-07 The power tap is .250 as well, which is good news and one hole
    Reported on vehicle #1 2026-11-07: the pack's pigtail ends in a flat-blade
    receptacle, the same .250 used at M1. Three consequences, and they do not all
    point the same way.
    Good: one terminal family now covers two of the three taps, the power tap
    needs no separate search, and 1.5's "still to source" row becomes a quantity
    change rather than a hunt. .250 goes from 6+6 to 12+12 across the fleet.
    Also good: the millivolt-drop rating procedure 2.2 pointed at one commit ago
    is no longer needed for this tap. 1.5 wanted it because nothing was printed on
    the connector and no family was known. .250 is a family the trade runs at
    20-30 A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
2026-11-07 The .250 terminals are a coupang part, and the gauge is the filter
    Checked 2026-11-07. The electronics distributors sell this part by the reel:
    eleparts lists 332 FASTON 250 lines and most carry M.O.Q. 6,000-10,000, which
    is the wrong shape for twenty-four terminals. Devicemart does not stock it at
    all (recorded two commits ago). Coupang carries mixed 2.8/4.8/6.3 male-and-
    female kits for W5,000-15,000, next-day.
    The useful finding is not the shop, it is which spec actually filters. Every
    listing states 6.3; almost none states AWG, and AWG is what rules kits out:
    the drive tap's wire matches the stock harness at 1.5 mm^2 while the power tap
    is on the traction branch at AWG 14. The common ki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
2026-11-07 The pack's connector is M1 exactly, so the question closes the unhelpful way
    Confirmed on vehicle #1 2026-11-07: same terminal, same housing, same 90-degree
    key. The open question recorded yesterday is answered, and answered badly --
    the M1 key no longer separates anything, it only separates a plug from itself
    reversed. The power and drive taps CAN be cross-plugged and no property of the
    parts prevents it.
    The useful work was not "therefore be careful". It was working out that the
    four wrong matings are not equally bad and only one is severe:
    relay 30 male -> the PACK's receptacle
    relay at rest, so 30-87a is closed: the pack lands on the stock ECU's
    motor-output transistors.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
2026-11-07 The carrier figure drew a full magnet pitch and labelled it half
    Two errors in drive-encoder-carrier.svg, both reported from reading the
    picture rather than the numbers.
    1. END VIEW. Sensor B sat on a magnet, which is what gave it away: at half a
    pitch B must land on a BOUNDARY. Recovering the geometry from the file --
    ring centre (262,346), magnet radius 106.7 px, magnets every 20 degrees --
    showed A at rotate(-100) and B at rotate(-80), both multiples of 20 and so
    both on magnet centres, a FULL pitch apart. The 6.80 mm label was right and
    the drawing contradicted it: 18 x 13.60 mm is 244.8 mm of circumference,
    Ø77.92, which is the Ø78.02 carrier. B moves to rotate(-90)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
2026-11-07 A figure nobody links to still gets maintained, which is the worse failure
    Asked to clear out stale figures, and the audit found the opposite problem
    more interesting than the one it went looking for.
    measurement-sheet.svg -- a printable page of every outstanding measurement on
    the build -- was edited three times, most recently 2026-11-04, while NO
    document mentioned it at all. Not outdated: orphaned. It is now linked from
    build/index.md, where someone about to pick up a caliper will find it,
    because it is grouped by where the measurement is taken rather than by which
    step needs it.
    Genuinely superseded, and archived rather than deleted: mitt.png and
    mrider.png, the 2026-08-07 full-size wo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
2026-11-07 The bench procedure named tools that did not exist anywhere
    03-electrical.md 3.5.3 told the builder to run "a scan sketch" and to "bring
    up the decoder". There was no firmware/ directory in this repository. A
    procedure that names a tool nobody has written is a procedure nobody can
    follow, and it had read as complete since it was written.
    firmware/bench/ is one PlatformIO project with one environment per step, each
    building exactly one source file so no sketch can mask another's fault -- the
    same reason the five steps are five steps.
    i2c_scan step 3 0x36 answers AND NOTHING ELSE does. Two addresses is
    a failure too: a second breakout left on the rail, or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
2026-11-07 The carrier figure now reads its geometry out of the part that was printed
    The .scad is confirmed correct on the bench, so it is the authority and the
    figure should not be restating it from memory. scripts/gen_carrier_figure.py
    parses the parameters out of cad/drive_encoder_carrier.scad, recomputes the
    derived values, and then holds its own arithmetic against OPENSCAD'S OWN ECHO
    output before it will write anything:
    magnet pitch 13.6171 mm
    SENSOR OFFSET 6.8085 mm
    counts / rev 36
    SWEPT diameter 78.02 mm
    Three independent statements of the same geometry have to agree. The old
    figure was a hand-written SVG whose label said "6.80 mm = HALF a magnet pitch"
    while the draw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
2026-11-07 Five figures described one printed part and each typed its own dimensions
    scripts/carrier_params.py is now the only place a drive-encoder figure gets a
    number. It reads the inputs out of cad/drive_encoder_carrier.scad, derives the
    rest, and holds that arithmetic against OpenSCAD's own echo output before it
    returns anything. If Python and the model ever disagree, nothing is drawn.
    gen_carrier_figure.py moved onto it and emits a byte-identical SVG, which is
    what a correct refactor looks like.
    Then gen_grub_screw_figure.py, and that figure was worth doing next because it
    quoted three numbers and had all three wrong:
    drawn the model computes
    0.10-0.70 mm 0.05-0.75 mm stan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
2026-11-07 The hub-and-bore figure said 5x of margin where the model asserts 1.05x
    Third migrated figure, third set of wrong numbers, and this one is wrong in
    the reassuring direction, which is the dangerous one. It said the grub screws
    "reach 3 mm past [the bore], five times what they must close":
    reach past the bore SET_SCREW_L 8.0 - WALL 7.0 = 1.00 mm
    worst case to close (BORE_CLEAR 1.2 + HUB_TOL 0.7) / 2 = 0.95 mm
    margin SET_SCREW_L - SPAN_MAX 7.95 = 0.05 mm
    1.05x, not 5x. The 3 mm is a fossil of the M3 x 10 that #6d rejected for
    standing 1.9-2.7 mm proud of the sensing surface: 10 - 7 = 3. A builder read
    that panel and came away believing there wa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
2026-11-07 Generating a figure does nothing for a sentence
    Two findings, and the second one reverses something I had just done.
    FIRST: the prose carried the same three errors as the figures. 01-bom-sourcing
    said SPAN_MAX = 7.90 where the model computes 7.95, "0.10-0.70 mm proud" where
    it computes 0.05-0.75, and "the grub screws reach 3 mm past the bore" where an
    M3 x 8 reaches 1.00. The pages and the figures had been copying each other
    rather than the part. Fixing only the figures would have left a repo that
    contradicts itself, which is worse than one that is uniformly wrong, because
    the reader cannot tell which to believe. The page now also states the 1.05x
    margin and where the "five times" came from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
2026-11-07 Five copies of esc and two of rich, and a check that proved the merge was exact
    Last of the Codex review's style findings, and the one that was safe to do
    only because check 17 landed first: it re-runs every generator and compares
    byte for byte, so "the refactor changed nothing" stops being a claim and
    becomes a result.
    scripts/svg_common.py takes escaping and the bold markup. Nine generators had
    five private copies of esc and two of rich. gen_authority_tap_figure's esc was
    html.escape(s, quote=False), which escapes exactly &, < and > - the same three,
    in the same order, as the replace chain the other four used; `import html` went
    with it, having no other caller.
    What it deliberately does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
2026-11-07 A failed spawn was followed by a spawner firing at a manager that did not exist
    OnProcessExit fires on ANY exit, success or not. sim.launch.py chained model
    spawn -> joint_state_broadcaster -> ackermann controller on it and never
    looked at a return code, so a failed spawn was followed by a controller
    spawner talking to a controller_manager that was never created. The operator
    then read the LAST error instead of the first one, and the first one is the
    real one: everything after it is noise the launch generated by continuing.
    _only_if_it_worked() wraps each hand-off. The handler returns actions, so
    refusing to continue is just returning a different list - a LogInfo naming
    what failed, what it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
2026-11-09 The drive tap's open question was the one thing that cannot be wired wrong
    "Which two colours share the horizontal tab at M1" sat open in three places:
    the 02-mechanical record sheet, the 03-electrical tap table, and the authority
    tap figure, which printed "RECORD colours" as a standing question. Chasing it
    found that nothing consumes it, and that the question next to it - the one that
    can actually be built wrong - was on no checklist at all.
    WHY THE PAIRING CANNOT BE WIRED WRONG
    M1 has two contacts and four wires, two per blade, and the pairing lives in the
    VEHICLE's plug. This tap reuses that plug intact: the relay's 30 leaves on a
    male tab MRider supplies and enters the vehicle's own fe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
2026-11-09 15 V is not a problem, 7 V might be - and absence claims now carry a date
    TWO THINGS, AND THE QUESTION THAT PROMPTED BOTH
    The label says the traction rail reaches 15.0 V on a cycle charge, not the
    12 V every page calls it. Traced what that touches.
    NOTHING MINDS THE HIGH END, AND NOT BY LUCK
    Exactly two things hang off the traction rail: the stock ECU - the vehicle's
    own, which normally sits across its own pack while it charges - and the
    driver's B+. The MDDS30 takes 7-35 V, recorded in order log #3's side-by-side
    against the Sabertooth's 6-30 V, so 15 V is mid-range.
    Three structural decisions keep everything else away from it: the relay MUX
    switches MOTOR LEADS rather than either contr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
2026-11-09 A sharper frame of the stock ECU, in which the plugs are legible
    Replaces stock-ecu-wire-colours.jpg with a better frame of the same scene,
    sent by the instructor today. It is not in the 123 images recovered from the
    build log - it is new.
    The old frame (600x553) showed the colours but blurred the connector bodies,
    so a reader could see six conductors and not where any of them went. This one
    (636x562) shows brown and blue entering the small 2-position housing and
    red/green/yellow/blue entering the wider one.
    That last part is worth the swap on its own. M1 carrying FOUR conductors on
    TWO blades is why the drive tap is a single tap and not two, which this page
    asserts in the table and could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
2026-11-10 A hung firmware keeps emitting pulses, and a Light variant is now on record
    Two things, both found by reviewing the project from the top.
    THE CORRECTION. Failsafe row 8 gave a firmware hang's detection as "driver R/C
    signal-loss timeout" and its behaviour as "Motors stop", and FMEA row 9 listed
    that timeout first among its layers. It does not cover a hang. A servo pulse
    train is produced by a hardware timer, so a stopped loop leaves the timer
    running and the driver keeps receiving the last commanded width - a valid
    signal. The timeout fires when pulses actually stop: a reset, a power loss.
    What turns a hang into a reset is the hardware watchdog and nothing else, so
    it is no longer a traili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
2026-11-10 An outside review found a short in the harness figure and a driver that boots mid-turn
    Seven findings from a second model's read of the wiring and bring-up pages,
    all confirmed against the repository and the MDDS30 manual, plus what a
    review of the fixes turned up.
    - harness/traction-supply.yml ran a red/black pair through the fuse and the
    contactor. Only + passes through them now; - goes pack -> XT60 -> block.
    - Releasing the E-stop powers the driver up, and with SW6 = 0 it calibrates
    its centre on the pulse present. The firmware spec kept the steering loop's
    proportional term alive while the button was down. It now emits exactly
    1.5 ms while sense is low and for a hold-off after.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
