jrkwon/mrider/(notices)

Notices in the files:
ros2_ws/src/mitt_description/meshes/mitt_body.obj:
Derived from the Gazebo Fuel "SUV" model by Open Robotics (CC0 1.0,
public domain). Wheels removed, -90deg Z rotation baked in so +X is
